Not1Fun/mini-gantry/mechanical/v3/drawings/camera_mount.png

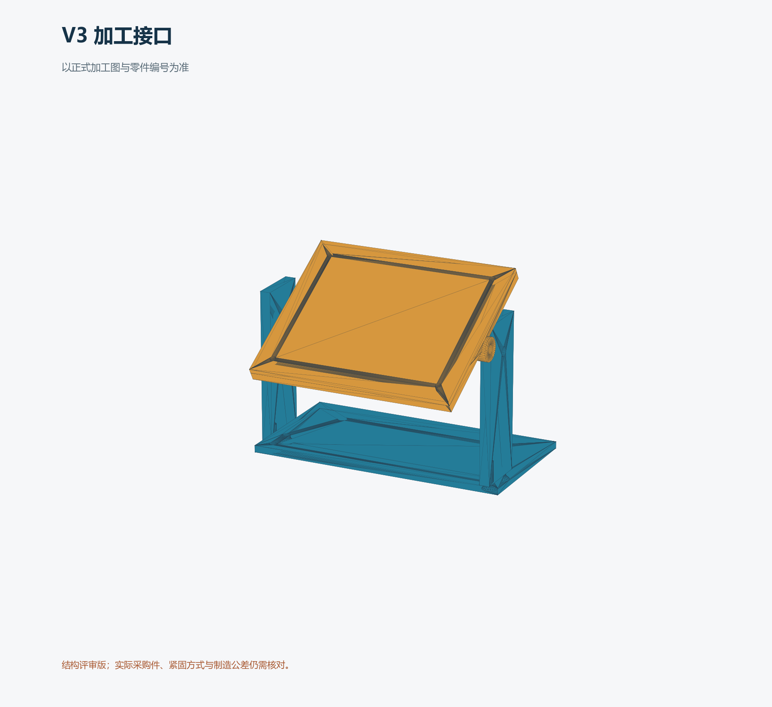
mechanical/v3/drawings/camera_mount.png
