Not1Fun/mini-gantry/mechanical/v3/drawings/xy_reduction.png

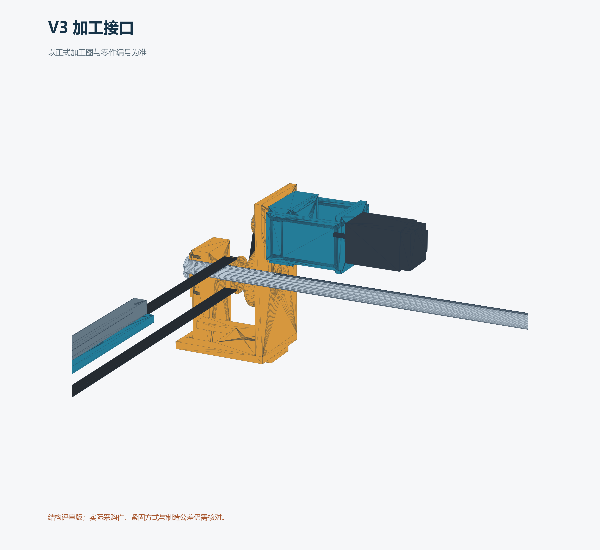
mechanical/v3/drawings/xy_reduction.png
