Not1Fun/mini-gantry/mechanical/v3/drawings/z_drive_stack.png

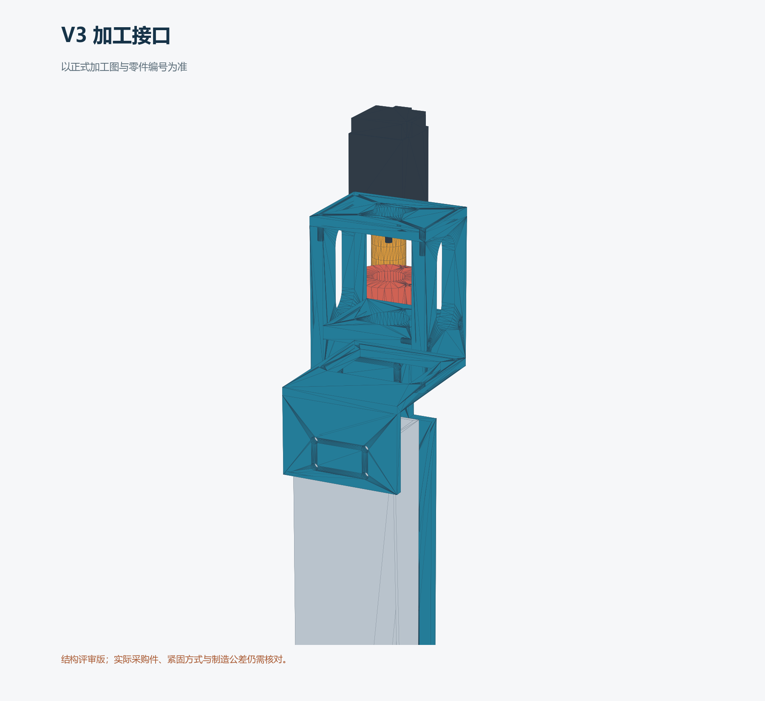
mechanical/v3/drawings/z_drive_stack.png
