Not1Fun/mini-gantry/mechanical/v3/cad/camera_adapter_blank.stl

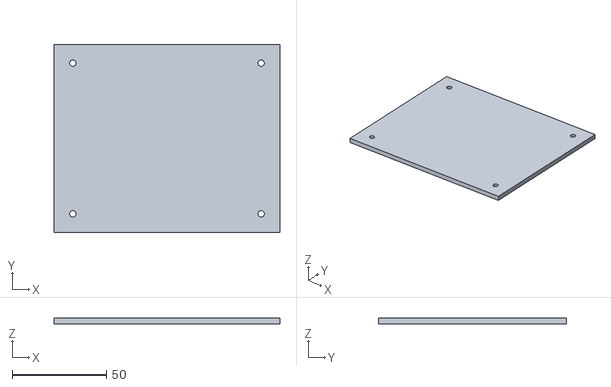
[picture p4: CAD file, 2026-10-16]
mechanical/v3/cad/camera_adapter_blank.stl
120.0 x 100.0 x 3.00
