Not1Fun/mini-gantry/mechanical/v3/cad/dxf/MG3-020.dxf

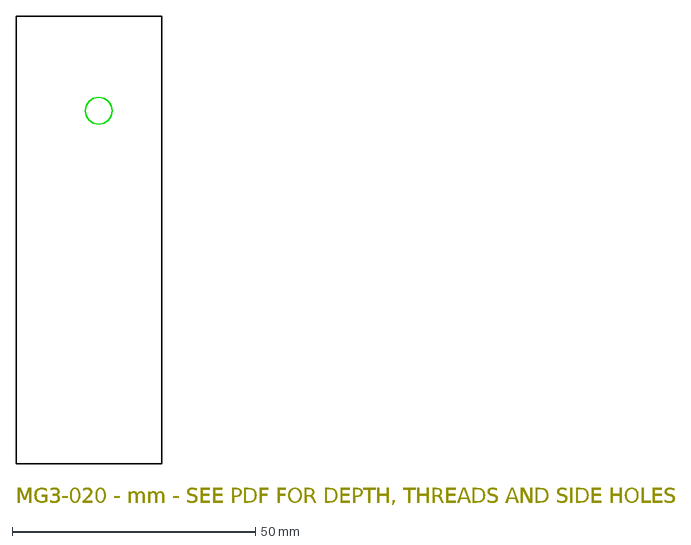
[picture p5: CAD file, 2026-10-16]
mechanical/v3/cad/dxf/MG3-020.dxf
MG3-020 - mm - SEE PDF FOR DEPTH, THREADS AND SIDE HOLES
