Not1Fun/mini-gantry/mechanical/v3/SolidWorksV3/v3_Z_target_0.SLDPRT

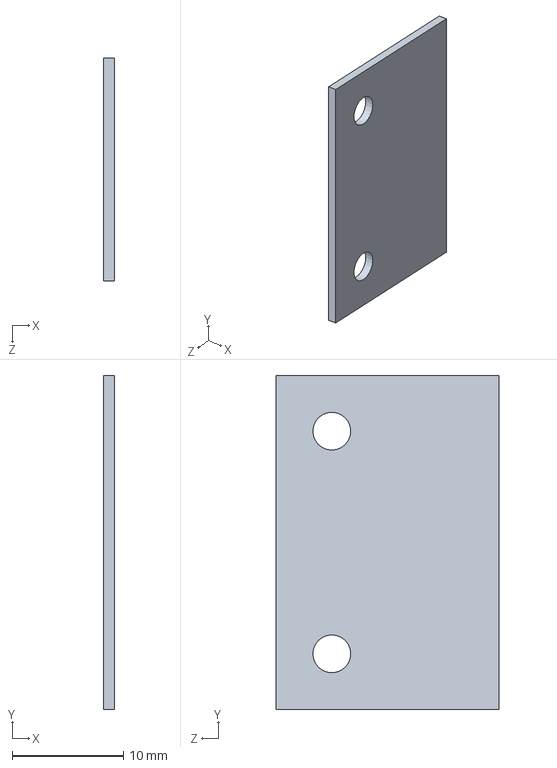
[picture p6: CAD file, 2026-10-16]
mechanical/v3/SolidWorksV3/v3_Z_target_0.SLDPRT
1.00 x 30.0 x 20.0 mm
