Not1Fun/mini-gantry/mechanical/v3/cad/dxf/MG3-053.dxf

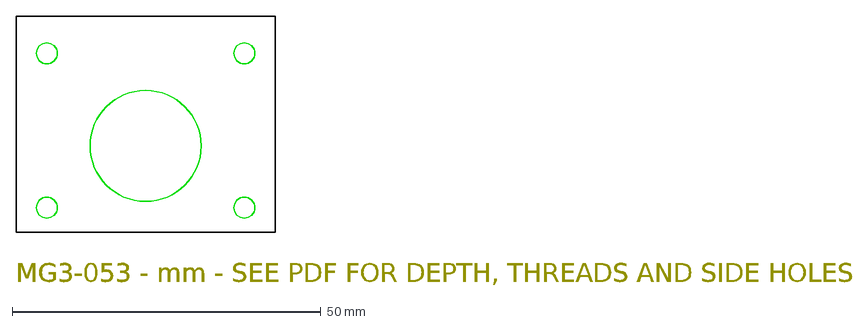
[picture p7: CAD file, 2026-10-16]
mechanical/v3/cad/dxf/MG3-053.dxf
MG3-053 - mm - SEE PDF FOR DEPTH, THREADS AND SIDE HOLES
