Not1Fun/mini-gantry/mechanical/v3/cad/parts/MG3-097_y_tension_0_spacer_1.step

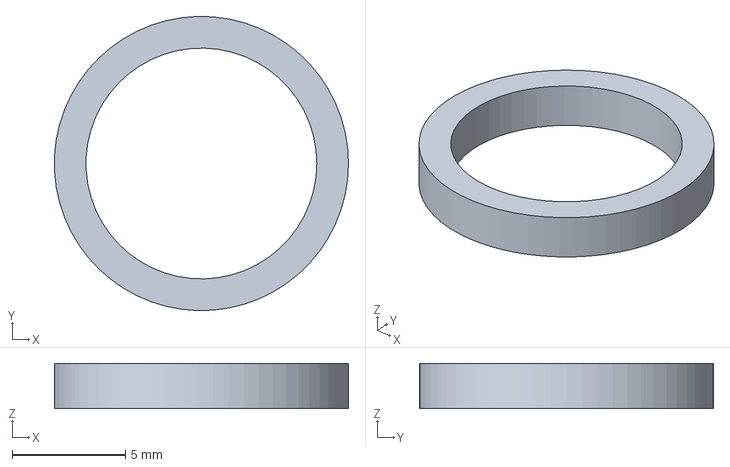
[picture p8: CAD file, 2026-10-16]
mechanical/v3/cad/parts/MG3-097_y_tension_0_spacer_1.step
13.0 x 13.0 x 2.00 mm
