Not1Fun/mini-gantry/mechanical/v3/SolidWorksV3/v3_y_tension_0_fork.SLDPRT

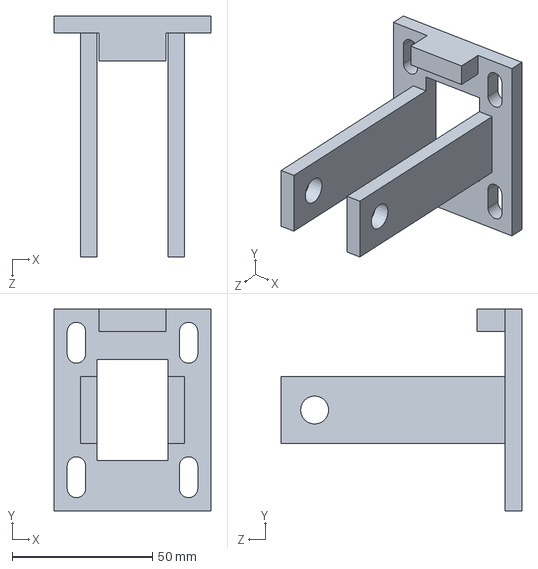
[picture p9: CAD file, 2026-10-16]
mechanical/v3/SolidWorksV3/v3_y_tension_0_fork.SLDPRT
56.0 x 72.0 x 86.0 mm
