Not1Fun/mini-gantry/mechanical/v3/cad/dxf/MG3-064.dxf

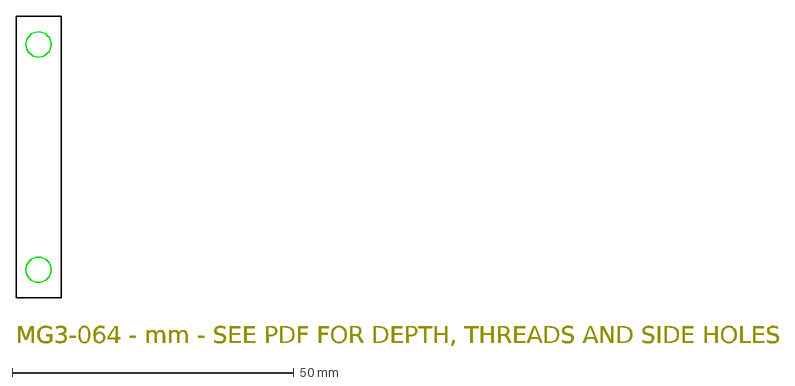
[picture p10: CAD file, 2026-10-16]
mechanical/v3/cad/dxf/MG3-064.dxf
MG3-064 - mm - SEE PDF FOR DEPTH, THREADS AND SIDE HOLES
