Not1Fun/mini-gantry/mechanical/v3/cad/parts/MG3-079_y_rail_base_0.step

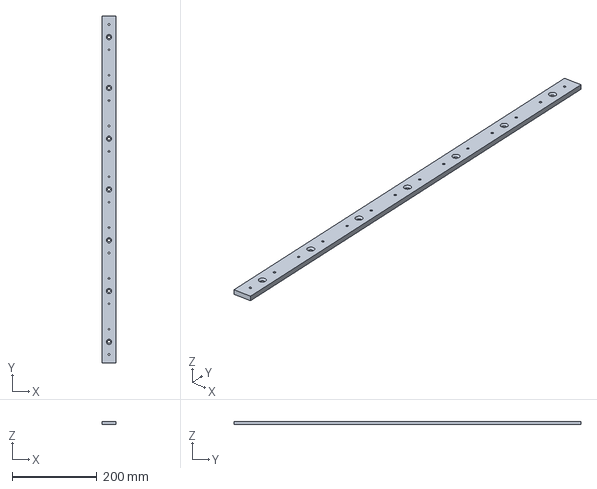
[picture p11: CAD file, 2026-10-16]
mechanical/v3/cad/parts/MG3-079_y_rail_base_0.step
32.0 x 820.0 x 8.00 mm
