Not1Fun/mini-gantry/mechanical/v3/SolidWorksV3/v3_y_pulley_1_1.SLDPRT

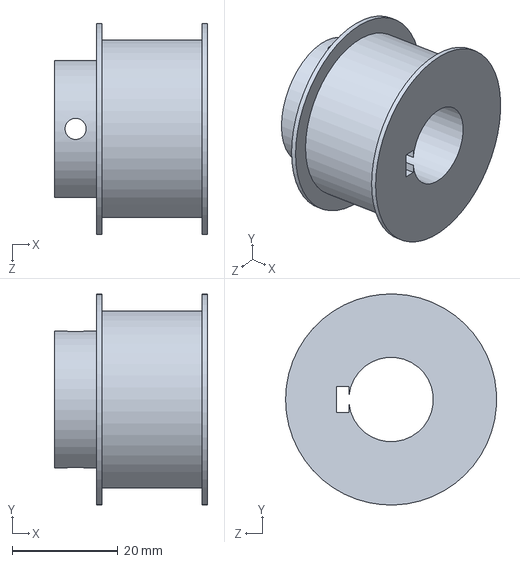
[picture p12: CAD file, 2026-10-16]
mechanical/v3/SolidWorksV3/v3_y_pulley_1_1.SLDPRT
29.0 x 40.0 x 40.0 mm
