Not1Fun/mini-gantry/mechanical/v3/cad/parts/MG3-058_x_output_spacer_2.step

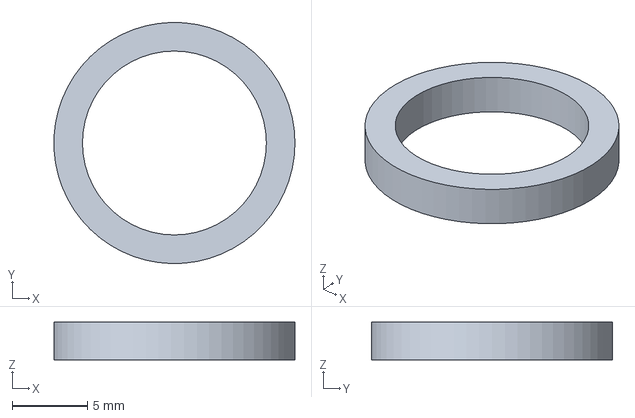
[picture p13: CAD file, 2026-10-16]
mechanical/v3/cad/parts/MG3-058_x_output_spacer_2.step
16.0 x 16.0 x 2.50 mm
