Not1Fun/mini-gantry/mechanical/v3/SolidWorksV3/v3_bridge_riser_1.SLDPRT

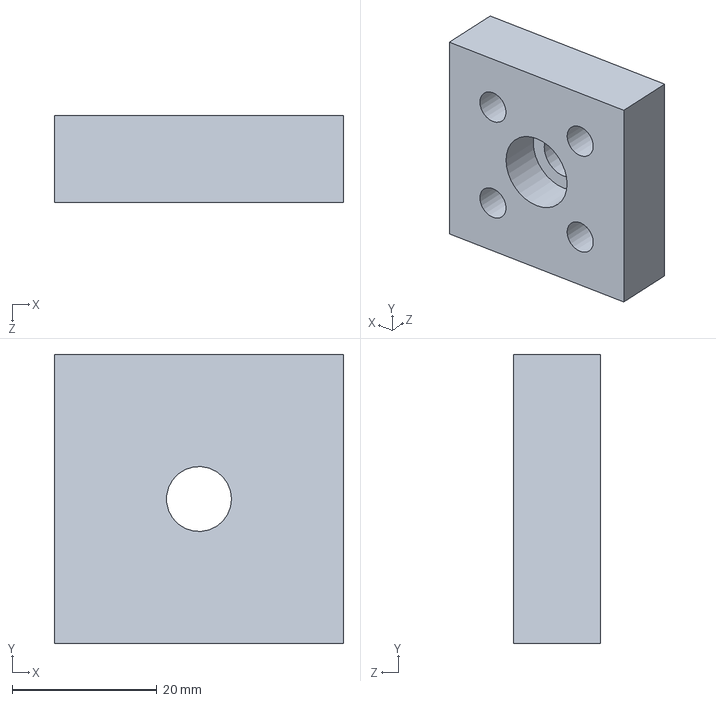
[picture p14: CAD file, 2026-10-16]
mechanical/v3/SolidWorksV3/v3_bridge_riser_1.SLDPRT
40.0 x 40.0 x 12.0 mm
