Not1Fun/mini-gantry/mechanical/v3/cad/parts/MG3-067_x_tension_0_fork.step

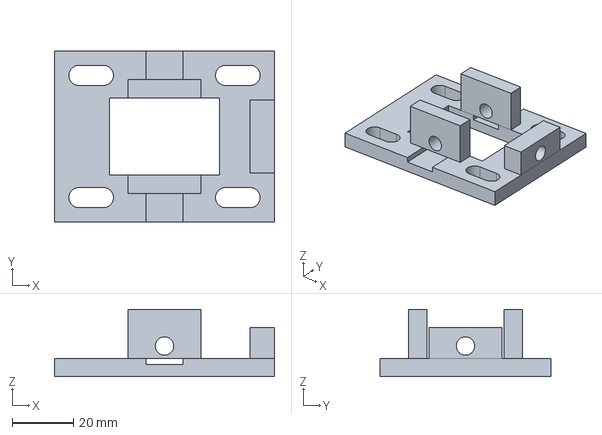
[picture p15: CAD file, 2026-10-16]
mechanical/v3/cad/parts/MG3-067_x_tension_0_fork.step
72.0 x 56.0 x 22.0 mm
