Not1Fun/mini-gantry/mechanical/v3/cad/dxf/MG3-094.dxf

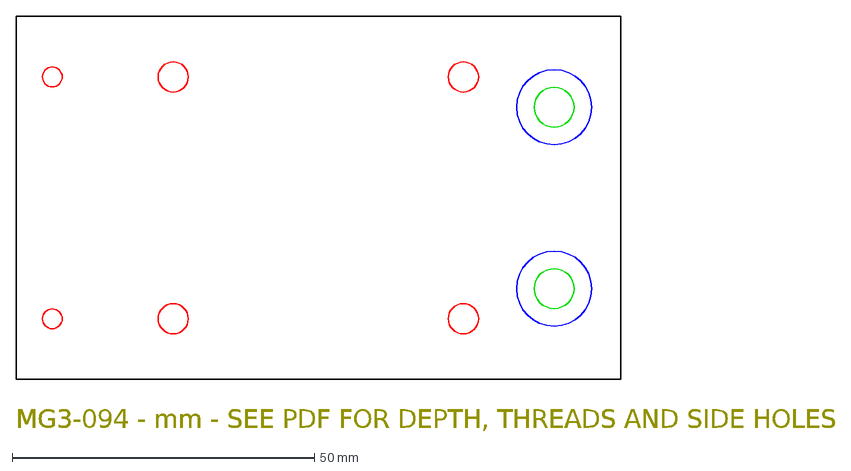
[picture p16: CAD file, 2026-10-16]
mechanical/v3/cad/dxf/MG3-094.dxf
MG3-094 - mm - SEE PDF FOR DEPTH, THREADS AND SIDE HOLES
