Not1Fun/mini-gantry/mechanical/v3/cad/parts/MG3-071_y_clamp_0_-1_cap.step

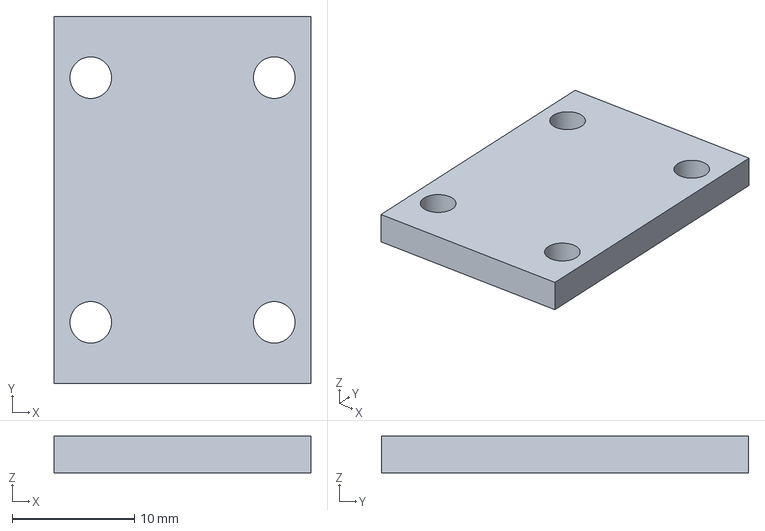
[picture p17: CAD file, 2026-10-16]
mechanical/v3/cad/parts/MG3-071_y_clamp_0_-1_cap.step
21.0 x 30.0 x 3.00 mm
