Not1Fun/mini-gantry/mechanical/v3/SolidWorksV3/v3_z_motor_standoff_0.SLDPRT

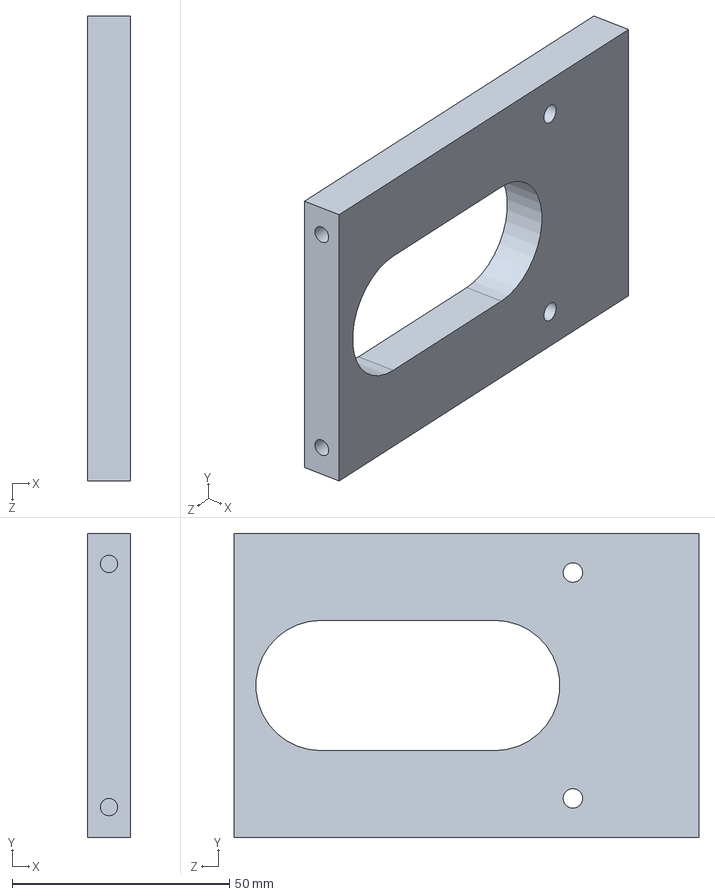
[picture p18: CAD file, 2026-10-16]
mechanical/v3/SolidWorksV3/v3_z_motor_standoff_0.SLDPRT
10.0 x 70.0 x 107.0 mm
