Not1Fun/mini-gantry/mechanical/v3/cad/parts/MG3-084_y_rear_spacer_1_0.step

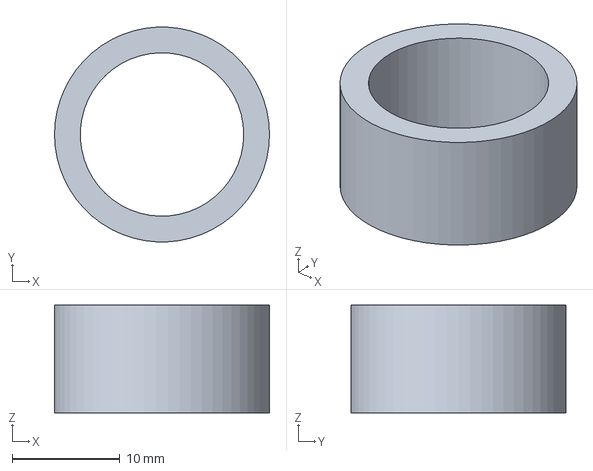
[picture p19: CAD file, 2026-10-16]
mechanical/v3/cad/parts/MG3-084_y_rear_spacer_1_0.step
20.0 x 20.0 x 10.0 mm
