Not1Fun/mini-gantry/mechanical/v3/SolidWorksV3/v3_camera_pivot_spacer_0.SLDPRT

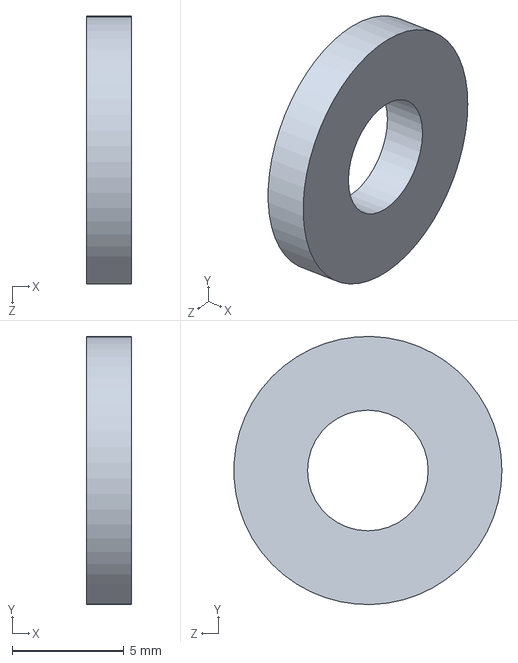
[picture p20: CAD file, 2026-10-16]
mechanical/v3/SolidWorksV3/v3_camera_pivot_spacer_0.SLDPRT
2.00 x 12.0 x 12.0 mm
