Not1Fun/mini-gantry/mechanical/v3/cad/dxf/MG3-106.dxf

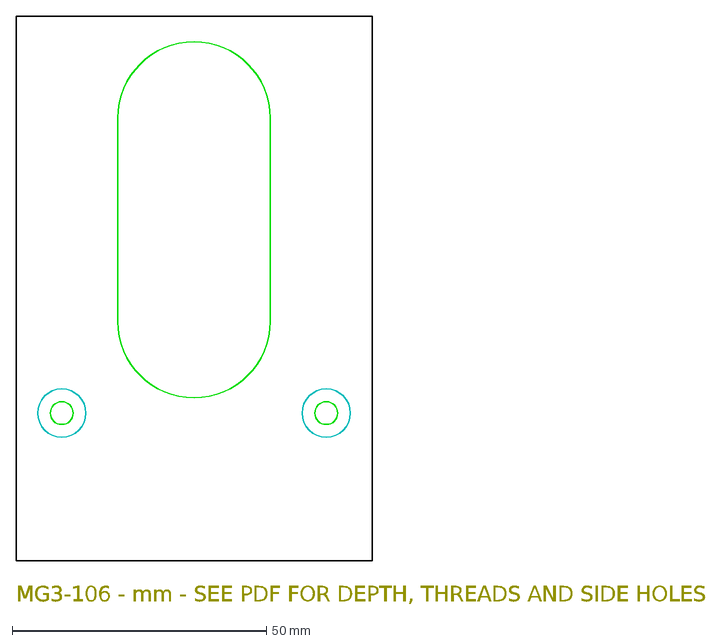
[picture p21: CAD file, 2026-10-16]
mechanical/v3/cad/dxf/MG3-106.dxf
MG3-106 - mm - SEE PDF FOR DEPTH, THREADS AND SIDE HOLES
