Not1Fun/mini-gantry/mechanical/v3/cad/parts/MG3-029_gripper_adapter.step

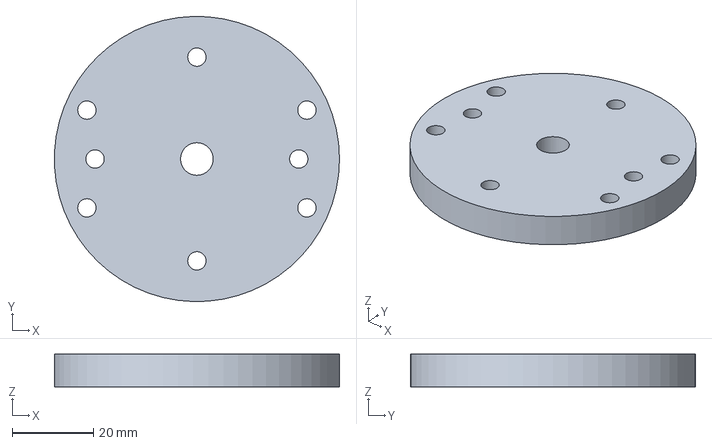
[picture p22: CAD file, 2026-10-16]
mechanical/v3/cad/parts/MG3-029_gripper_adapter.step
70.0 x 70.0 x 8.00 mm
