Not1Fun/mini-gantry/mechanical/v3/SolidWorksV3/v3_y_rear_spacer_0_1.SLDPRT

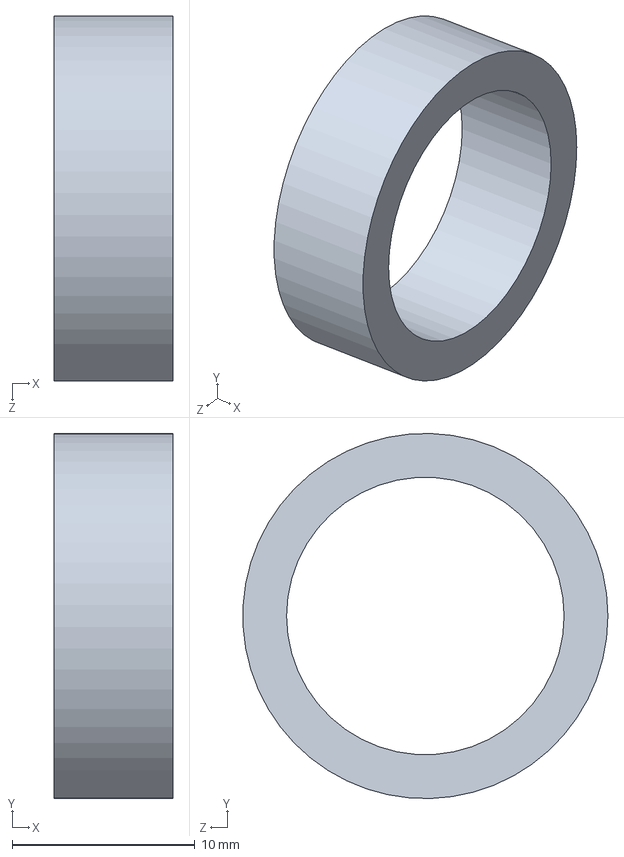
[picture p23: CAD file, 2026-10-16]
mechanical/v3/SolidWorksV3/v3_y_rear_spacer_0_1.SLDPRT
6.50 x 20.0 x 20.0 mm
