Not1Fun/mini-gantry/mechanical/v3/cad/dxf/MG3-016.dxf

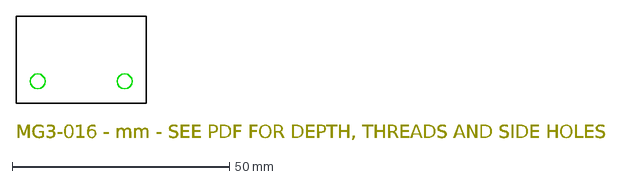
[picture p24: CAD file, 2026-10-16]
mechanical/v3/cad/dxf/MG3-016.dxf
MG3-016 - mm - SEE PDF FOR DEPTH, THREADS AND SIDE HOLES
