Not1Fun/mini-gantry/mechanical/v3/cad/parts/MG3-062_x_reduction_driven_pulley.step

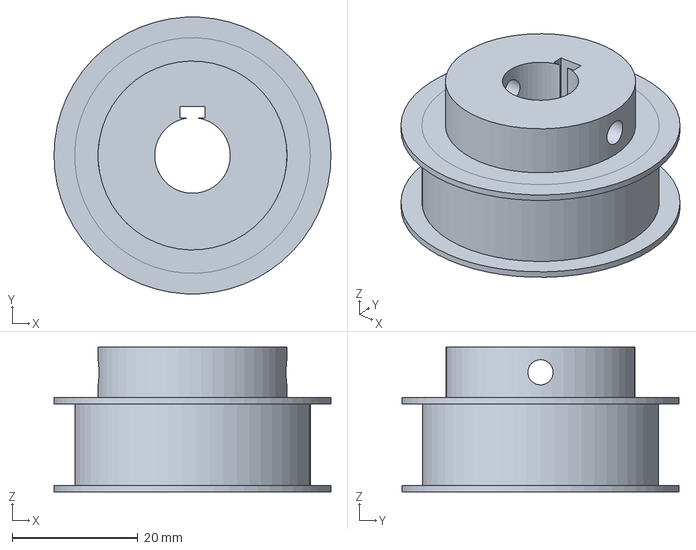
[picture p25: CAD file, 2026-10-16]
mechanical/v3/cad/parts/MG3-062_x_reduction_driven_pulley.step
44.0 x 43.9 x 23.0 mm
