Not1Fun/mini-gantry/mechanical/v3/SolidWorksV3/v3_rear_brace_0.SLDPRT

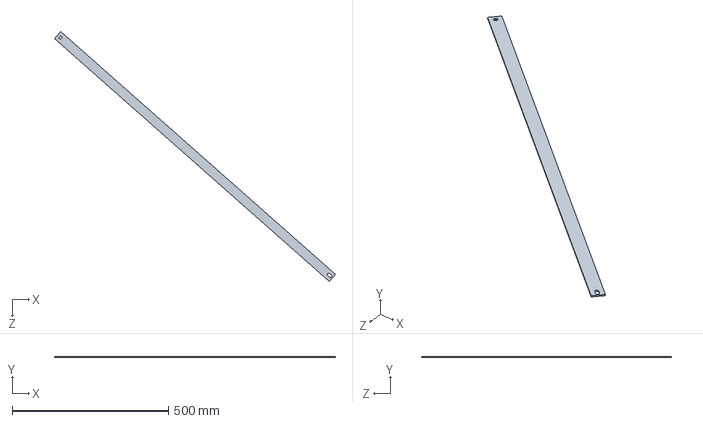
[picture p26: CAD file, 2026-10-16]
mechanical/v3/SolidWorksV3/v3_rear_brace_0.SLDPRT
897.8 x 3.00 x 798.4 mm
