Not1Fun/mini-gantry/mechanical/v3/cad/dxf/MG3-070.dxf

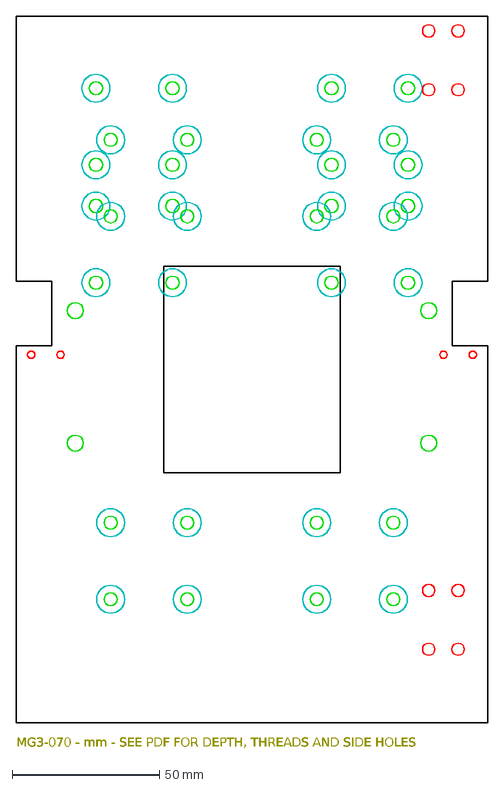
[picture p27: CAD file, 2026-10-16]
mechanical/v3/cad/dxf/MG3-070.dxf
MG3-070 - mm - SEE PDF FOR DEPTH, THREADS AND SIDE HOLES
