Not1Fun/mini-gantry/mechanical/v3/cad/parts/MG3-051_x_motor_bracket.step

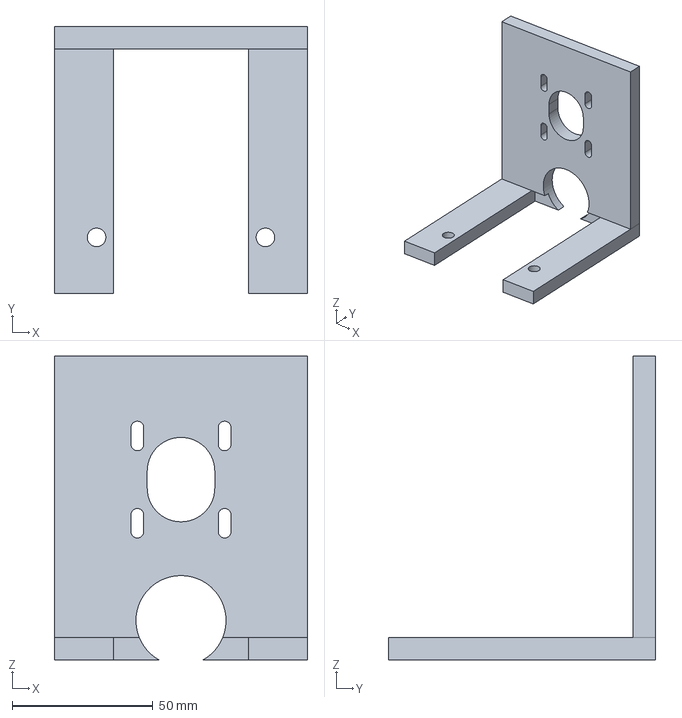
[picture p28: CAD file, 2026-10-16]
mechanical/v3/cad/parts/MG3-051_x_motor_bracket.step
90.0 x 95.0 x 108.0 mm
