Not1Fun/mini-gantry/mechanical/v3/SolidWorksV3/v3_Y_target_1.SLDPRT

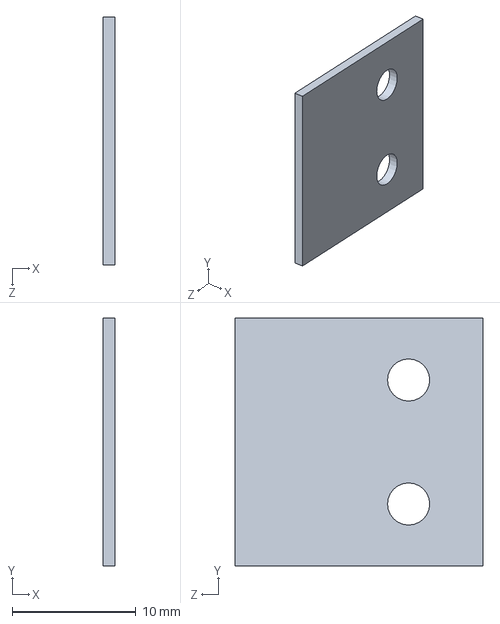
[picture p29: CAD file, 2026-10-16]
mechanical/v3/SolidWorksV3/v3_Y_target_1.SLDPRT
1.00 x 20.0 x 20.0 mm
