Not1Fun/mini-gantry/mechanical/v3/cad/dxf/MG3-098.dxf

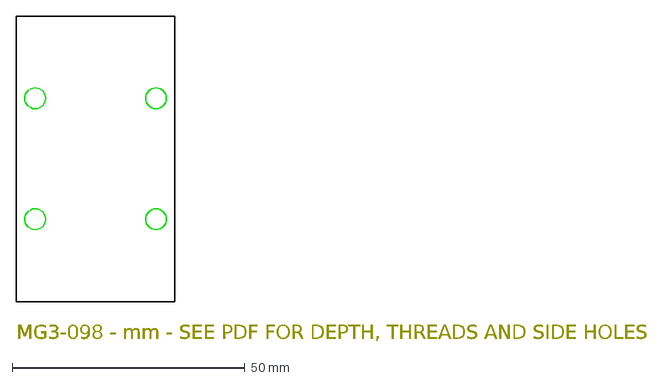
[picture p30: CAD file, 2026-10-16]
mechanical/v3/cad/dxf/MG3-098.dxf
MG3-098 - mm - SEE PDF FOR DEPTH, THREADS AND SIDE HOLES
