Not1Fun/mini-gantry/mechanical/v3/SolidWorksV3/v3_y_end_plate_1.SLDPRT

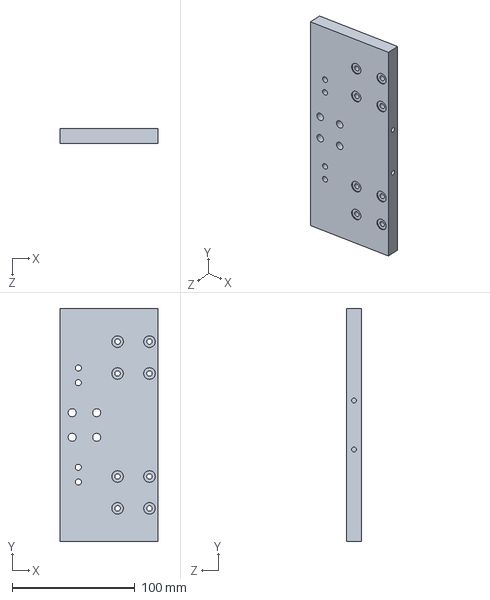
[picture p31: CAD file, 2026-10-16]
mechanical/v3/SolidWorksV3/v3_y_end_plate_1.SLDPRT
80.0 x 190.0 x 12.0 mm
