Not1Fun/mini-gantry/mechanical/v3/cad/dxf/MG3-050.dxf

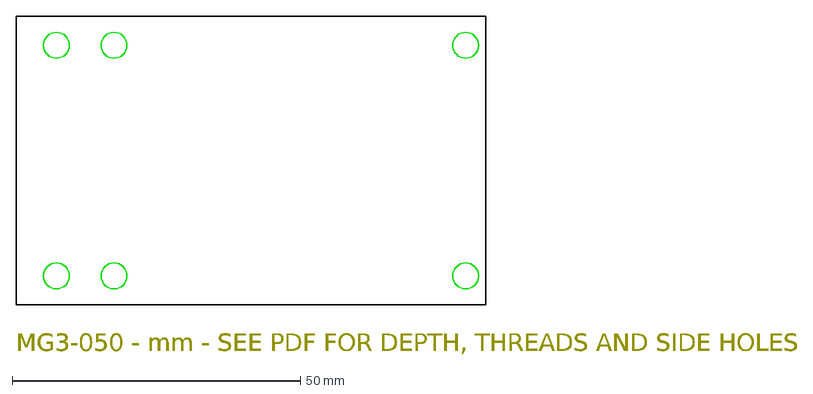
[picture p32: CAD file, 2026-10-16]
mechanical/v3/cad/dxf/MG3-050.dxf
MG3-050 - mm - SEE PDF FOR DEPTH, THREADS AND SIDE HOLES
