Not1Fun/mini-gantry/mechanical/v3/cad/parts/MG3-065_x_tension_0_axle.step

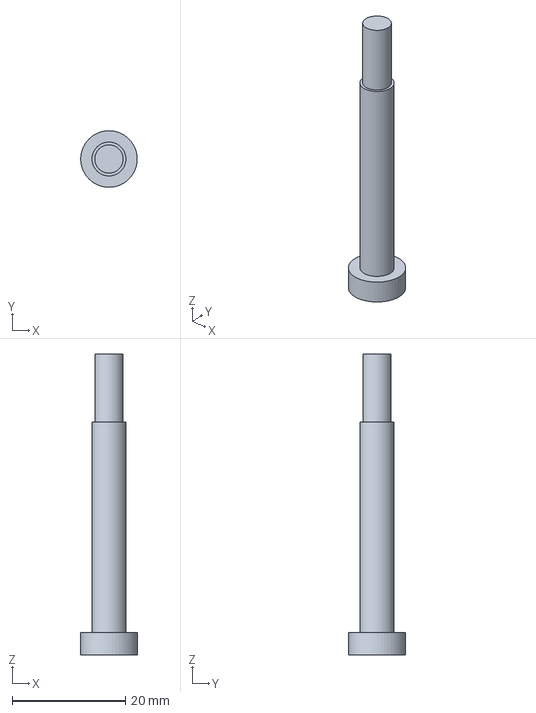
[picture p33: CAD file, 2026-10-16]
mechanical/v3/cad/parts/MG3-065_x_tension_0_axle.step
9.99 x 10.00 x 53.2 mm
