Not1Fun/mini-gantry/mechanical/v3/cad/dxf/MG3-004.dxf

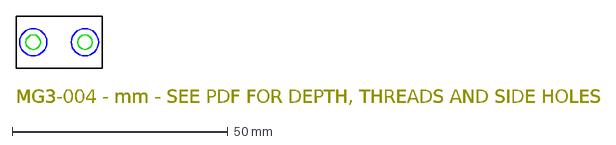
[picture p34: CAD file, 2026-10-16]
mechanical/v3/cad/dxf/MG3-004.dxf
MG3-004 - mm - SEE PDF FOR DEPTH, THREADS AND SIDE HOLES
