Not1Fun/mini-gantry/mechanical/v3/cad/parts/MG3-048_x_input_rear_cover.step

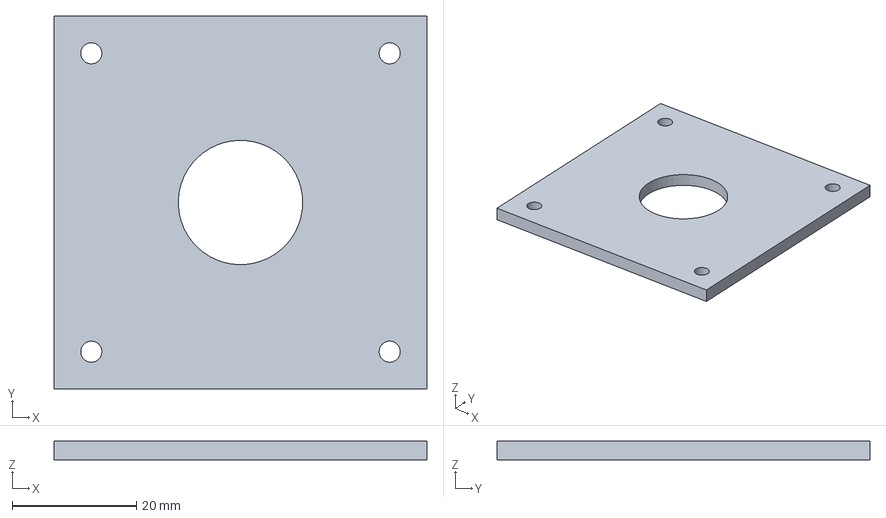
[picture p35: CAD file, 2026-10-16]
mechanical/v3/cad/parts/MG3-048_x_input_rear_cover.step
60.0 x 60.0 x 3.00 mm
