Not1Fun/mini-gantry/mechanical/v3/SolidWorksV3/v3_side_brace_0_1_spacer_1.SLDPRT

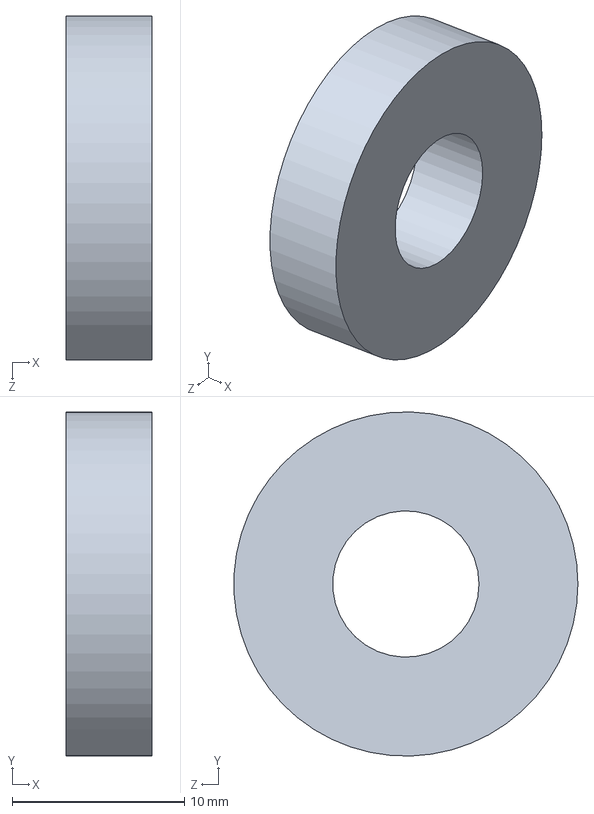
[picture p36: CAD file, 2026-10-16]
mechanical/v3/SolidWorksV3/v3_side_brace_0_1_spacer_1.SLDPRT
5.00 x 20.0 x 20.0 mm
