Not1Fun/mini-gantry/mechanical/v3/cad/dxf/MG3-061.dxf

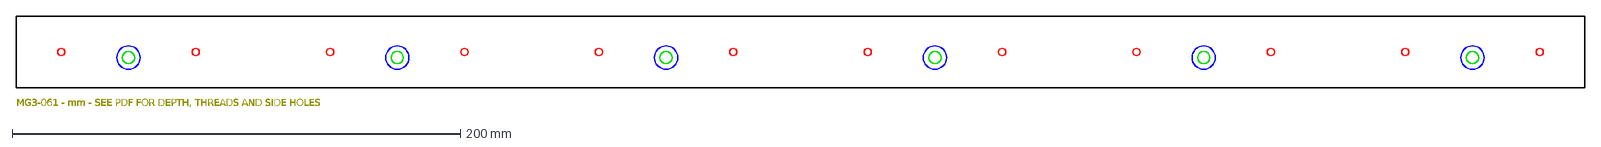
[picture p37: CAD file, 2026-10-16]
mechanical/v3/cad/dxf/MG3-061.dxf
MG3-061 - mm - SEE PDF FOR DEPTH, THREADS AND SIDE HOLES
