Not1Fun/mini-gantry/mechanical/v3/cad/parts/MG3-050_x_input_side_0.step

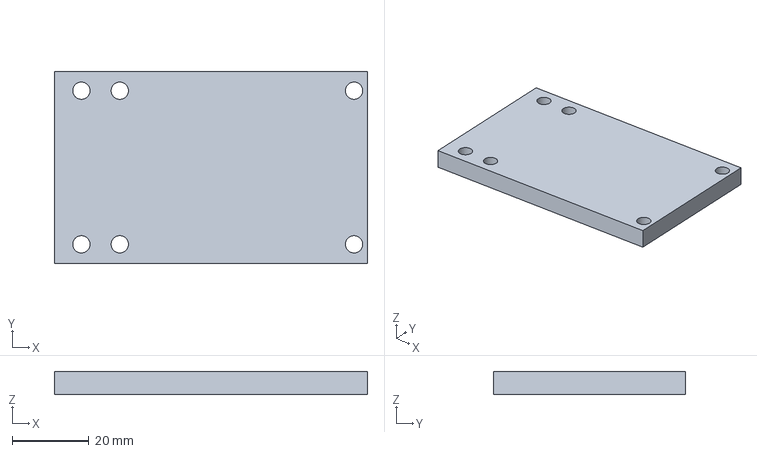
[picture p38: CAD file, 2026-10-16]
mechanical/v3/cad/parts/MG3-050_x_input_side_0.step
81.5 x 50.0 x 6.00 mm
