Not1Fun/mini-gantry/mechanical/v3/SolidWorksV3/v3_side_brace_0_0_spacer_0.SLDPRT

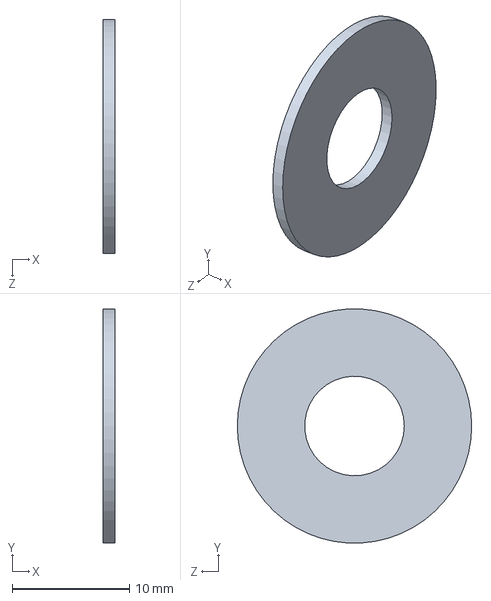
[picture p39: CAD file, 2026-10-16]
mechanical/v3/SolidWorksV3/v3_side_brace_0_0_spacer_0.SLDPRT
1.00 x 20.0 x 20.0 mm
