Not1Fun/mini-gantry/mechanical/v3/cad/dxf/MG3-044.dxf

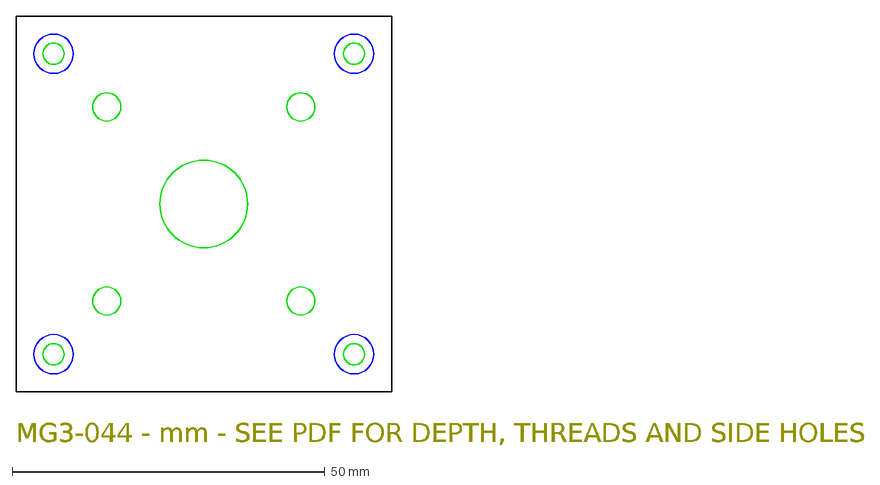
[picture p40: CAD file, 2026-10-16]
mechanical/v3/cad/dxf/MG3-044.dxf
MG3-044 - mm - SEE PDF FOR DEPTH, THREADS AND SIDE HOLES
