Not1Fun/mini-gantry/mechanical/v3/cad/parts/MG3-027_fixed_head_top.step

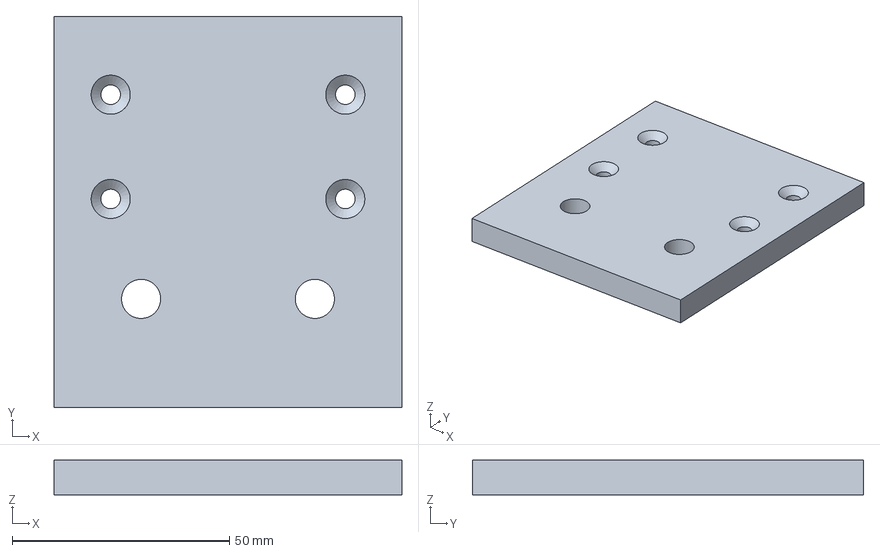
[picture p41: CAD file, 2026-10-16]
mechanical/v3/cad/parts/MG3-027_fixed_head_top.step
80.0 x 90.0 x 8.00 mm
