Not1Fun/mini-gantry/mechanical/v3/SolidWorksV3/v3_controller_tray.SLDPRT

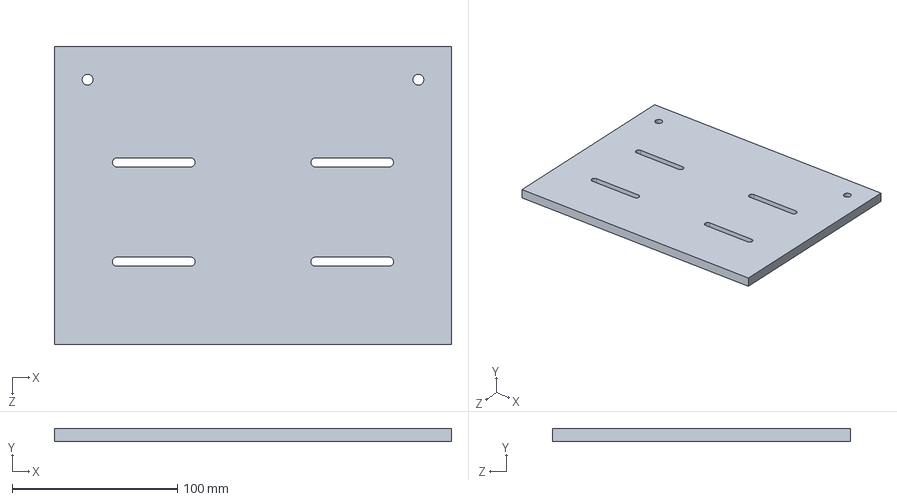
[picture p42: CAD file, 2026-10-16]
mechanical/v3/SolidWorksV3/v3_controller_tray.SLDPRT
240.0 x 8.00 x 180.0 mm
