Not1Fun/mini-gantry/mechanical/v3/cad/dxf/MG3-074.dxf

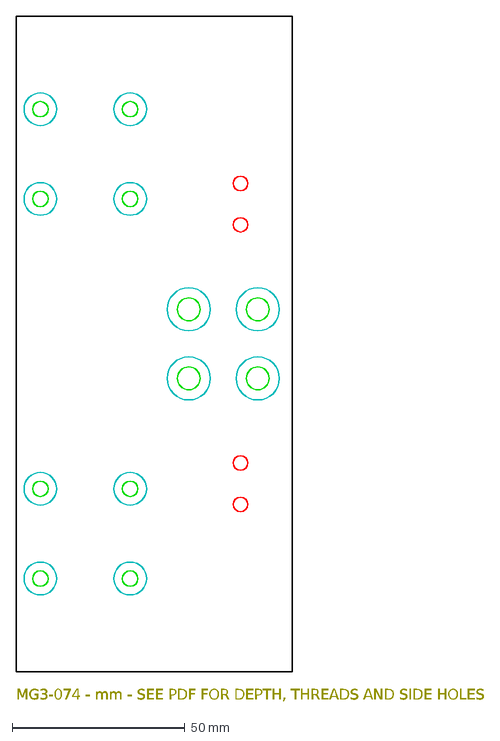
[picture p43: CAD file, 2026-10-16]
mechanical/v3/cad/dxf/MG3-074.dxf
MG3-074 - mm - SEE PDF FOR DEPTH, THREADS AND SIDE HOLES
