Not1Fun/mini-gantry/mechanical/v3/cad/parts/MG3-098_z_block_spacer_0_0.step

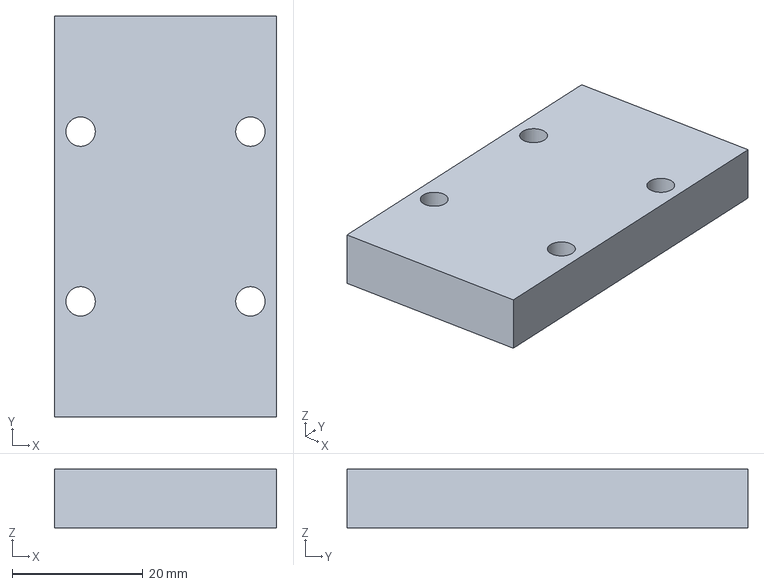
[picture p44: CAD file, 2026-10-16]
mechanical/v3/cad/parts/MG3-098_z_block_spacer_0_0.step
34.0 x 61.4 x 9.00 mm
