Not1Fun/mini-gantry/mechanical/v3/SolidWorksV3/v3_frame_corner_front_0_0.SLDPRT

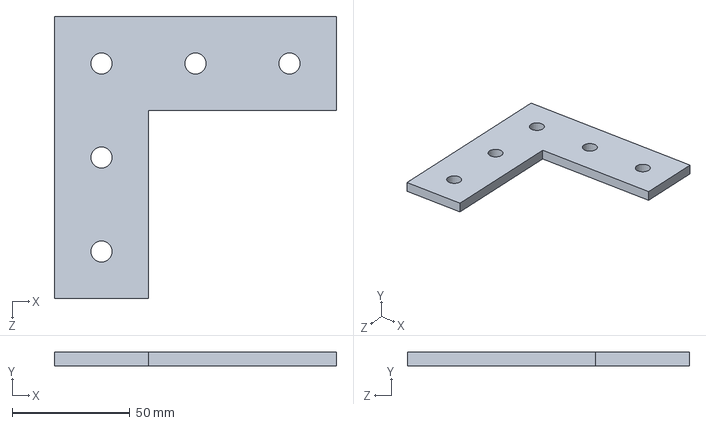
[picture p45: CAD file, 2026-10-16]
mechanical/v3/SolidWorksV3/v3_frame_corner_front_0_0.SLDPRT
120.0 x 6.00 x 120.0 mm
