Not1Fun/mini-gantry/mechanical/v3/cad/dxf/MG3-018.dxf

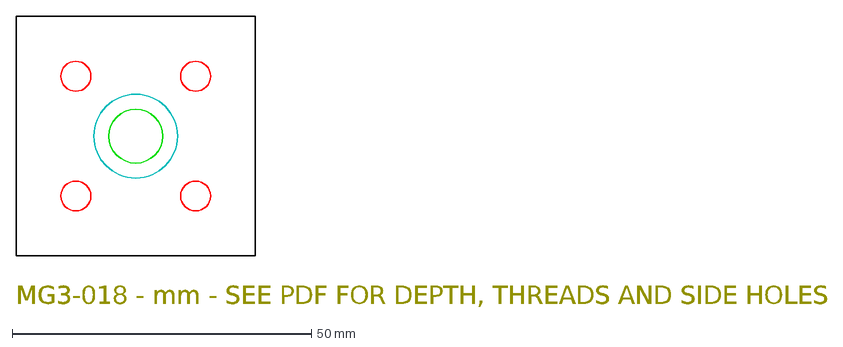
[picture p46: CAD file, 2026-10-16]
mechanical/v3/cad/dxf/MG3-018.dxf
MG3-018 - mm - SEE PDF FOR DEPTH, THREADS AND SIDE HOLES
