Not1Fun/mini-gantry/mechanical/v3/cad/parts/MG3-099_z_brake_carrier.step

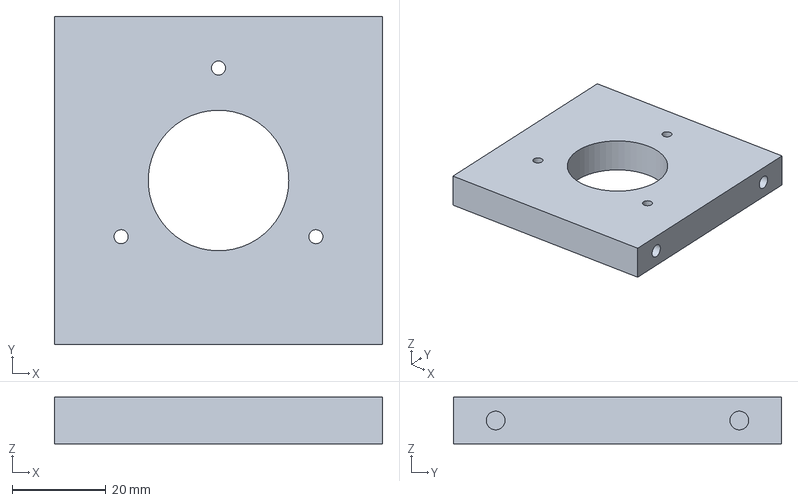
[picture p47: CAD file, 2026-10-16]
mechanical/v3/cad/parts/MG3-099_z_brake_carrier.step
70.0 x 70.0 x 10.0 mm
