Not1Fun/mini-gantry/mechanical/v3/SolidWorksV3/v3_X_bumper_0.SLDPRT

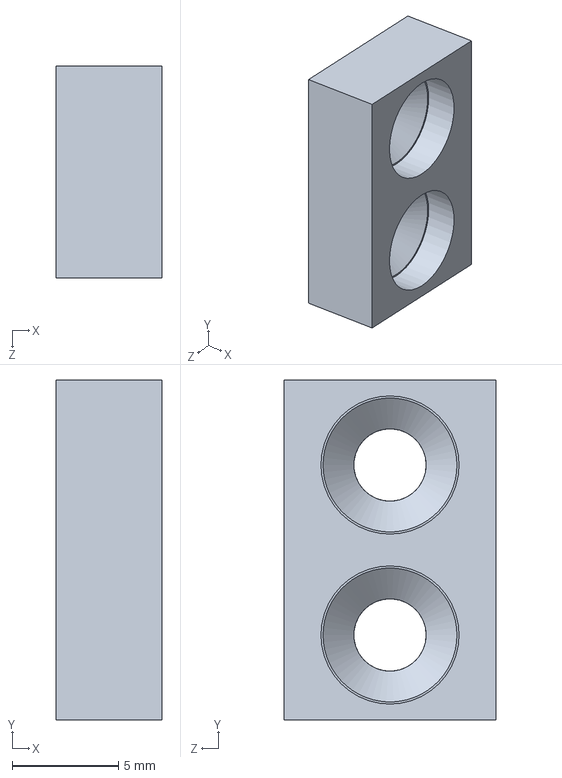
[picture p48: CAD file, 2026-10-16]
mechanical/v3/SolidWorksV3/v3_X_bumper_0.SLDPRT
5.00 x 16.0 x 10.0 mm
