Not1Fun/mini-gantry/mechanical/v3/cad/dxf/MG3-019.dxf

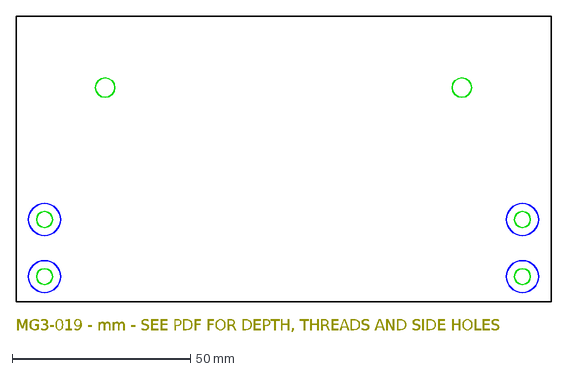
[picture p49: CAD file, 2026-10-16]
mechanical/v3/cad/dxf/MG3-019.dxf
MG3-019 - mm - SEE PDF FOR DEPTH, THREADS AND SIDE HOLES
