Not1Fun/mini-gantry/mechanical/v3/cad/parts/MG3-068_x_tension_0_spacer_0.step

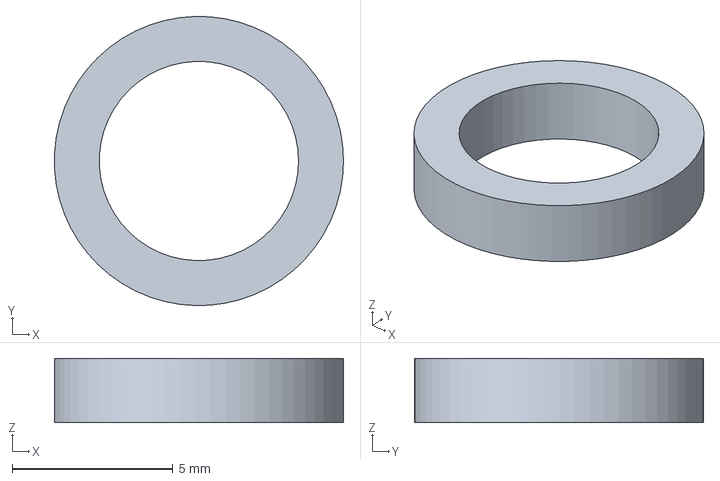
[picture p50: CAD file, 2026-10-16]
mechanical/v3/cad/parts/MG3-068_x_tension_0_spacer_0.step
8.99 x 9.00 x 2.00 mm
