Not1Fun/mini-gantry/mechanical/v3/cad/dxf/MG3-073.dxf

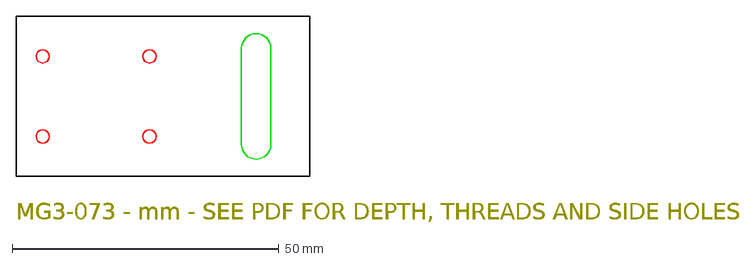
[picture p51: CAD file, 2026-10-16]
mechanical/v3/cad/dxf/MG3-073.dxf
MG3-073 - mm - SEE PDF FOR DEPTH, THREADS AND SIDE HOLES
