Not1Fun/mini-gantry/mechanical/v3/cad/parts/MG3-012_Z_stop_0.step

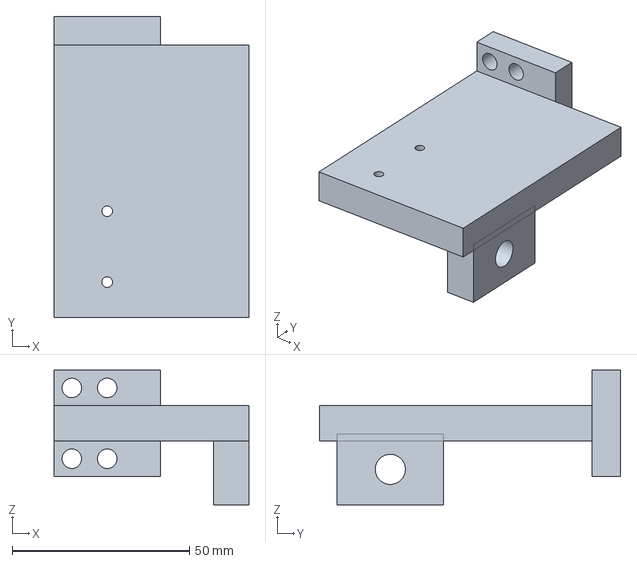
[picture p52: CAD file, 2026-10-16]
mechanical/v3/cad/parts/MG3-012_Z_stop_0.step
55.0 x 85.0 x 38.0 mm
