Not1Fun/mini-gantry/mechanical/v3/SolidWorksV3/v3_y_tension_0_axle.SLDPRT

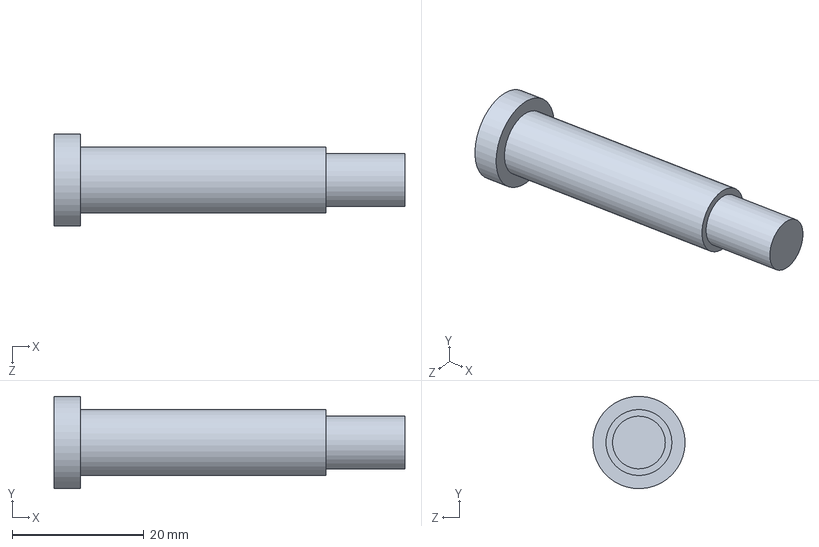
[picture p53: CAD file, 2026-10-16]
mechanical/v3/SolidWorksV3/v3_y_tension_0_axle.SLDPRT
53.2 x 14.0 x 14.0 mm
