Not1Fun/mini-gantry/mechanical/v3/cad/dxf/MG3-100.dxf

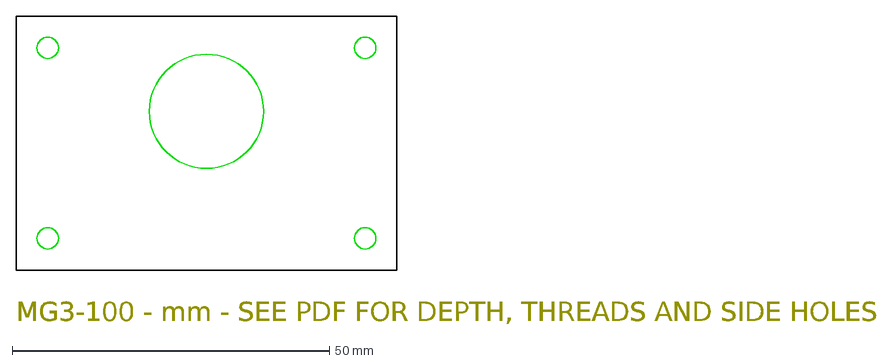
[picture p54: CAD file, 2026-10-16]
mechanical/v3/cad/dxf/MG3-100.dxf
MG3-100 - mm - SEE PDF FOR DEPTH, THREADS AND SIDE HOLES
