Not1Fun/mini-gantry/mechanical/v3/SolidWorksV3/v3_x_input_end_retainer.SLDPRT

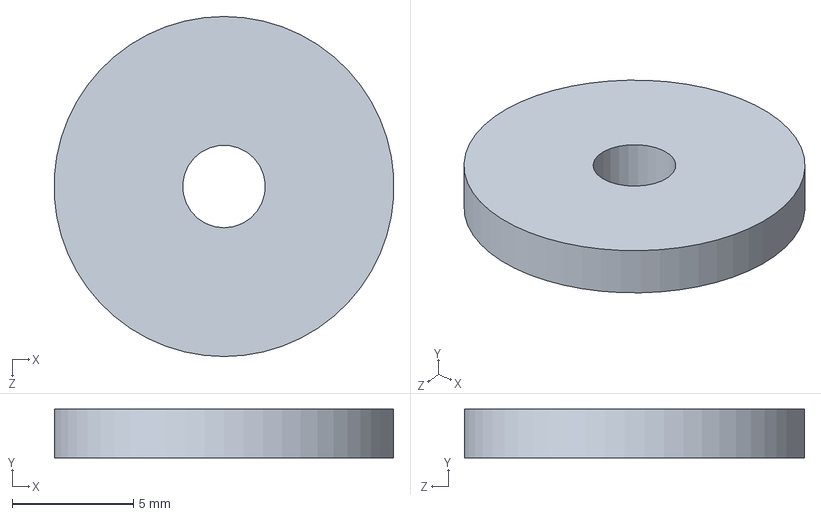
[picture p55: CAD file, 2026-10-16]
mechanical/v3/SolidWorksV3/v3_x_input_end_retainer.SLDPRT
14.0 x 2.00 x 14.0 mm
