Not1Fun/mini-gantry/mechanical/v3/cad/dxf/MG3-026.dxf

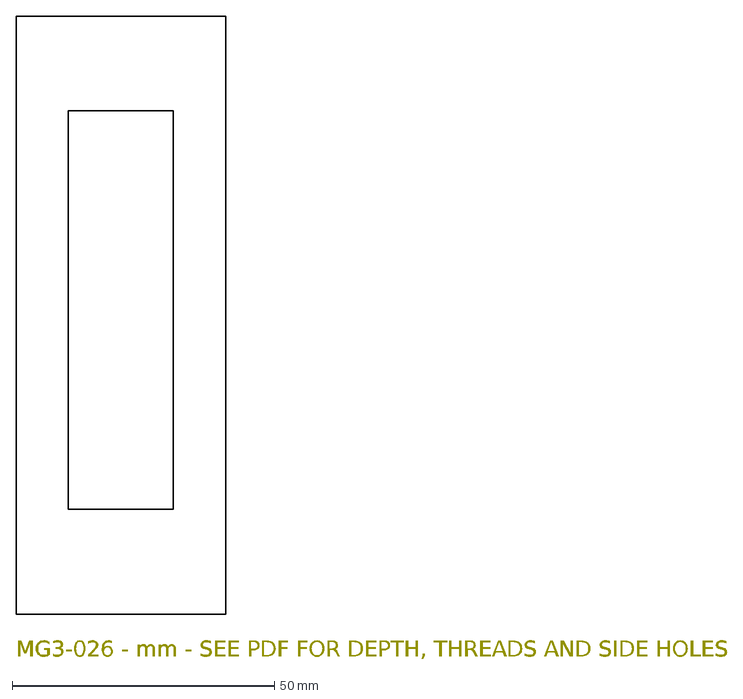
[picture p56: CAD file, 2026-10-16]
mechanical/v3/cad/dxf/MG3-026.dxf
MG3-026 - mm - SEE PDF FOR DEPTH, THREADS AND SIDE HOLES
