Not1Fun/mini-gantry/mechanical/v3/cad/parts/MG3-046_x_input_inner_spacer.step

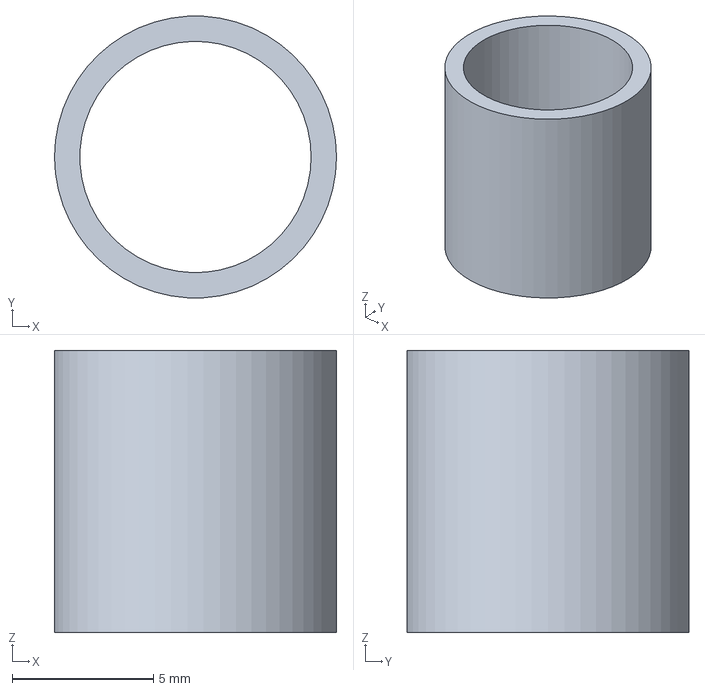
[picture p57: CAD file, 2026-10-16]
mechanical/v3/cad/parts/MG3-046_x_input_inner_spacer.step
10.0 x 9.98 x 10.0 mm
