Not1Fun/mini-gantry/mechanical/v3/cad/dxf/MG3-024.dxf

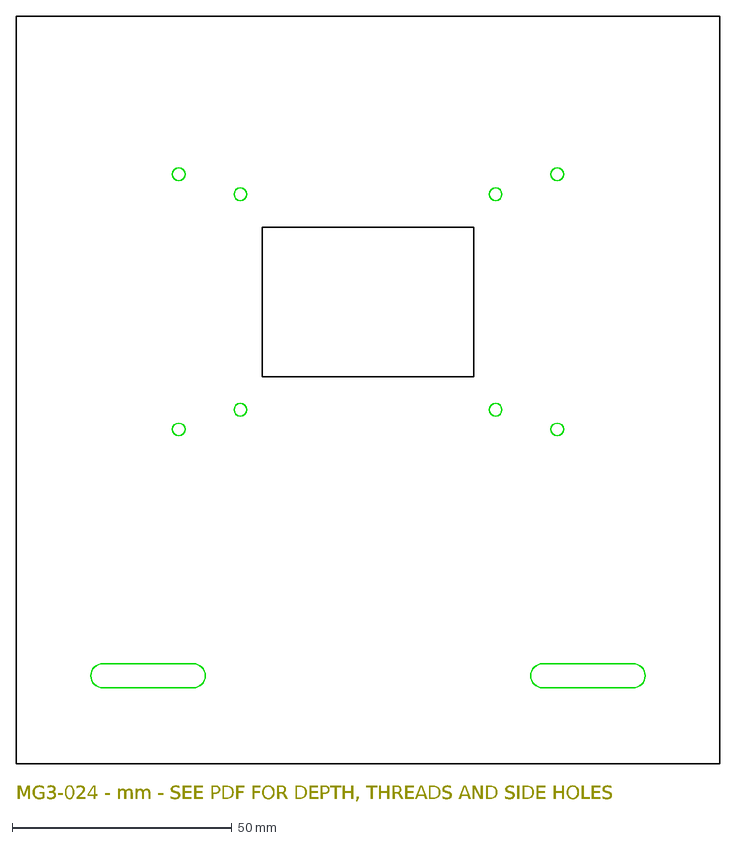
[picture p58: CAD file, 2026-10-16]
mechanical/v3/cad/dxf/MG3-024.dxf
MG3-024 - mm - SEE PDF FOR DEPTH, THREADS AND SIDE HOLES
