Not1Fun/mini-gantry/mechanical/v3/cad/dxf/MG3-009.dxf

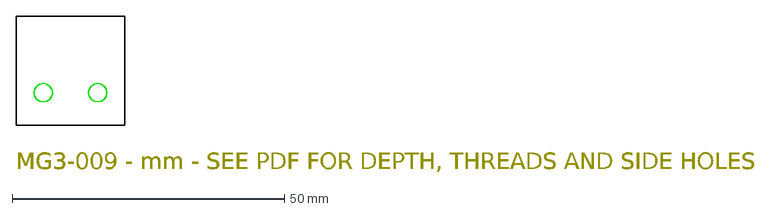
[picture p59: CAD file, 2026-10-16]
mechanical/v3/cad/dxf/MG3-009.dxf
MG3-009 - mm - SEE PDF FOR DEPTH, THREADS AND SIDE HOLES
