Not1Fun/mini-gantry/mechanical/v3/SolidWorksV3/v3_Y_bumper_0_0.SLDPRT

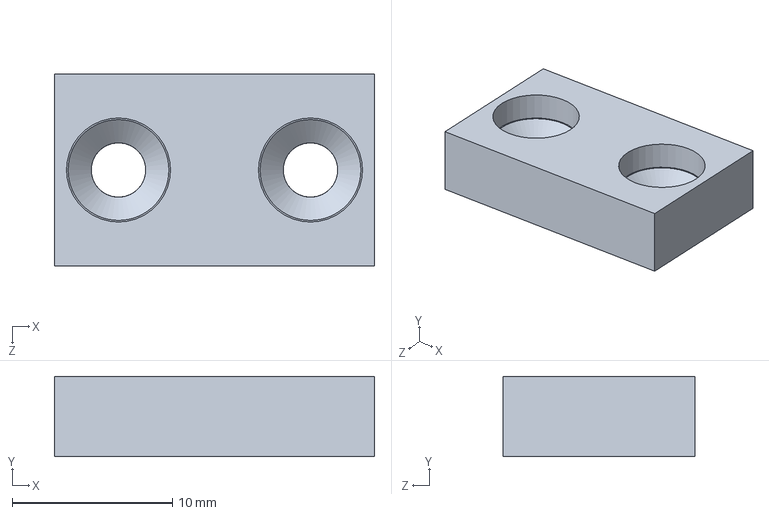
[picture p60: CAD file, 2026-10-16]
mechanical/v3/SolidWorksV3/v3_Y_bumper_0_0.SLDPRT
20.0 x 5.00 x 12.0 mm
