Not1Fun/mini-gantry/mechanical/v3/cad/dxf/MG3-005.dxf

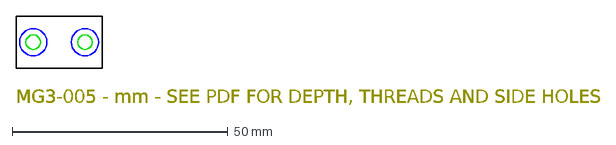
[picture p61: CAD file, 2026-10-16]
mechanical/v3/cad/dxf/MG3-005.dxf
MG3-005 - mm - SEE PDF FOR DEPTH, THREADS AND SIDE HOLES
