Not1Fun/mini-gantry/mechanical/v3/SolidWorksV3/v3_X_stop_1.SLDPRT

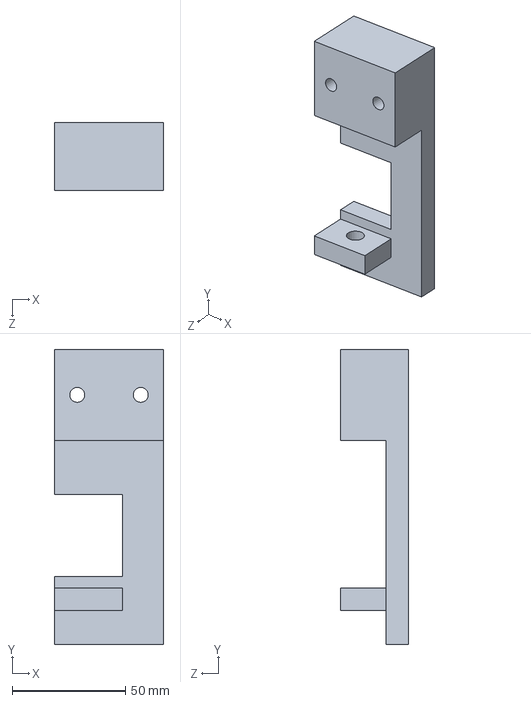
[picture p62: CAD file, 2026-10-16]
mechanical/v3/SolidWorksV3/v3_X_stop_1.SLDPRT
48.0 x 130.0 x 30.0 mm
