Not1Fun/mini-gantry/mechanical/v3/cad/dxf/MG3-075.dxf

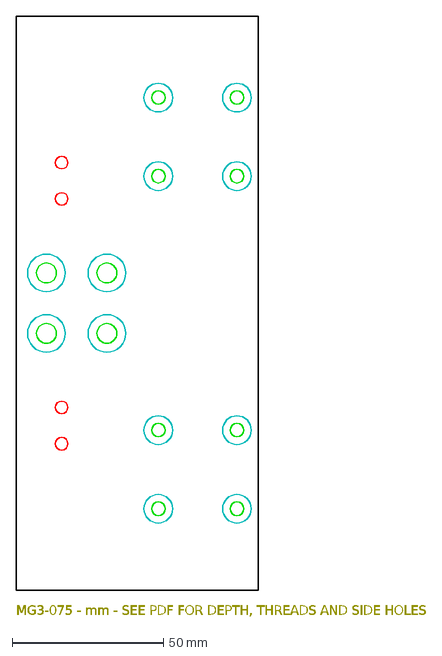
[picture p63: CAD file, 2026-10-16]
mechanical/v3/cad/dxf/MG3-075.dxf
MG3-075 - mm - SEE PDF FOR DEPTH, THREADS AND SIDE HOLES
