Not1Fun/mini-gantry/mechanical/v3/cad/parts/MG3-044_x_input_front_cover.step

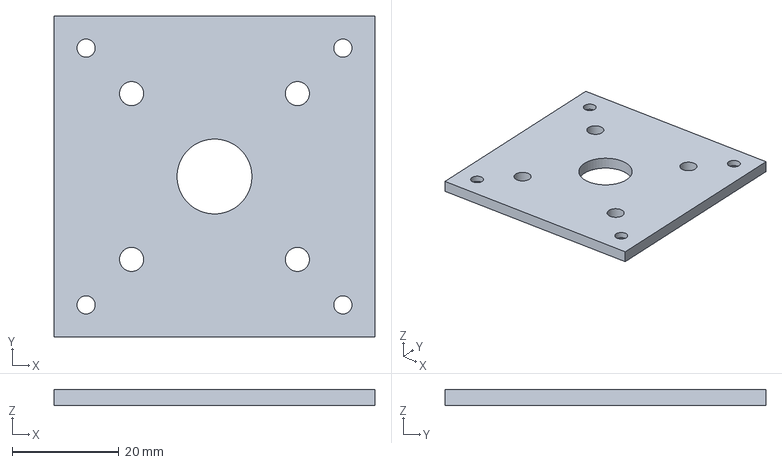
[picture p64: CAD file, 2026-10-16]
mechanical/v3/cad/parts/MG3-044_x_input_front_cover.step
60.0 x 60.0 x 3.00 mm
