Not1Fun/mini-gantry/mechanical/v3/SolidWorksV3/v3_z_float_cover.SLDPRT

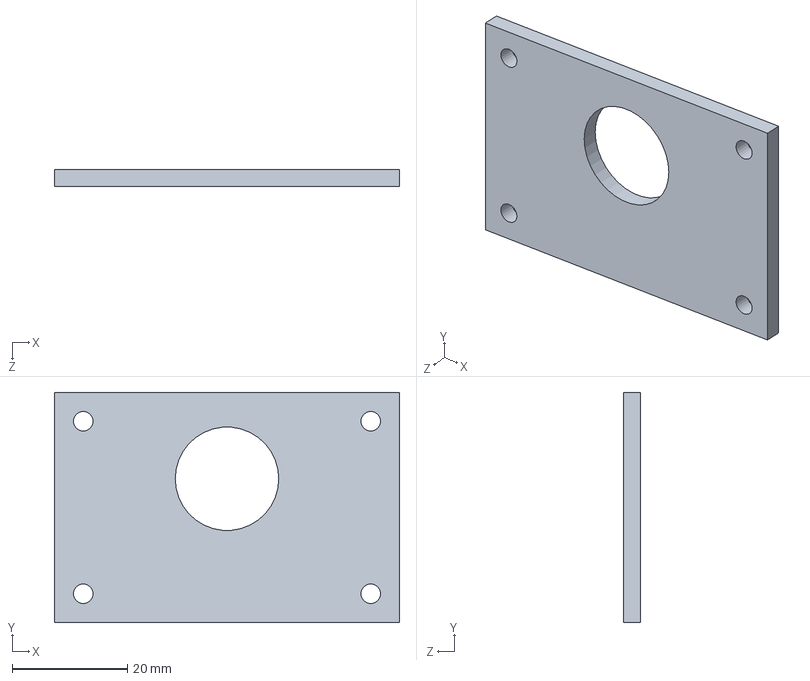
[picture p65: CAD file, 2026-10-16]
mechanical/v3/SolidWorksV3/v3_z_float_cover.SLDPRT
60.0 x 40.0 x 3.00 mm
