Not1Fun/mini-gantry/mechanical/v3/cad/dxf/MG3-010.dxf

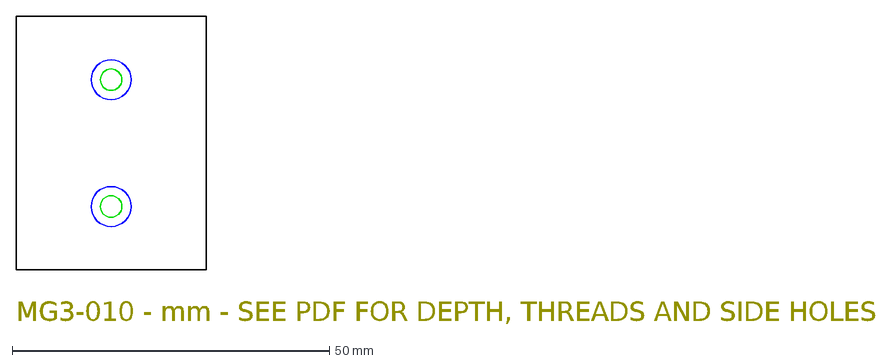
[picture p66: CAD file, 2026-10-16]
mechanical/v3/cad/dxf/MG3-010.dxf
MG3-010 - mm - SEE PDF FOR DEPTH, THREADS AND SIDE HOLES
