Not1Fun/mini-gantry/mechanical/v3/cad/parts/MG3-052_x_output_cover_0.step

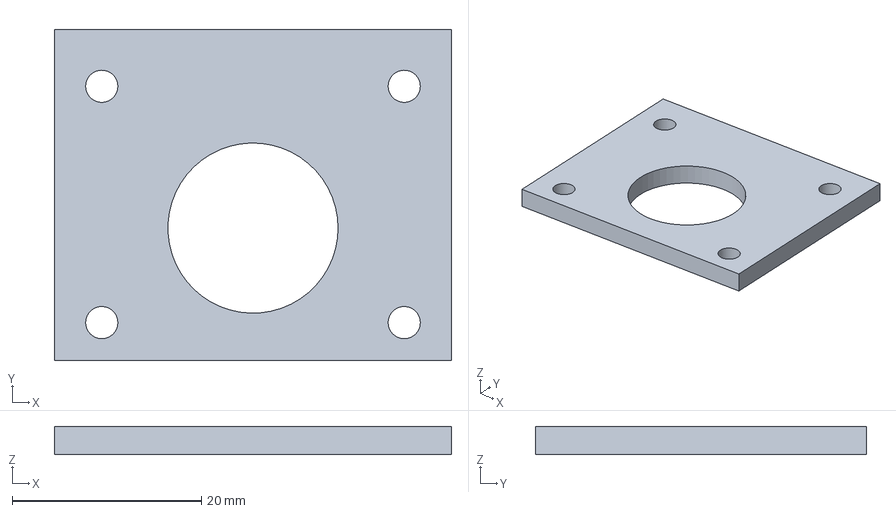
[picture p67: CAD file, 2026-10-16]
mechanical/v3/cad/parts/MG3-052_x_output_cover_0.step
42.0 x 35.0 x 3.00 mm
