Not1Fun/mini-gantry/mechanical/v3/SolidWorksV3/v3_camera_removable_panel.SLDPRT

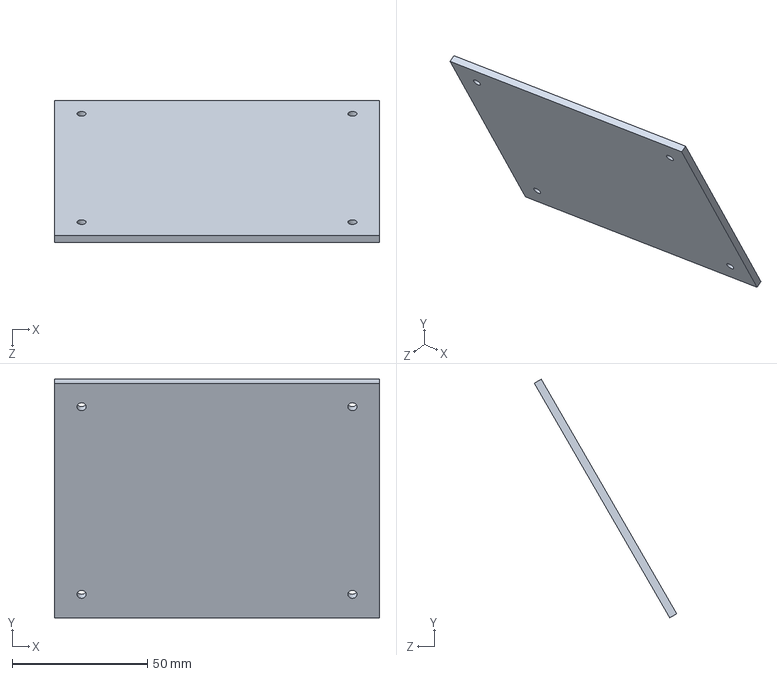
[picture p68: CAD file, 2026-10-16]
mechanical/v3/SolidWorksV3/v3_camera_removable_panel.SLDPRT
120.0 x 88.1 x 52.6 mm
