Not1Fun/mini-gantry/mechanical/v3/cad/dxf/MG3-041.dxf

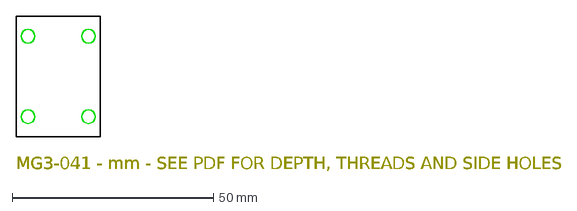
[picture p69: CAD file, 2026-10-16]
mechanical/v3/cad/dxf/MG3-041.dxf
MG3-041 - mm - SEE PDF FOR DEPTH, THREADS AND SIDE HOLES
