Not1Fun/mini-gantry/mechanical/v3/cad/parts/MG3-091_y_sync_shaft.step

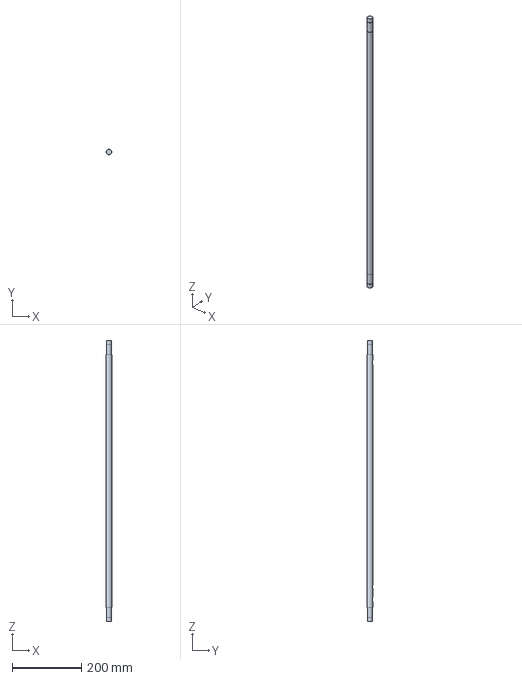
[picture p70: CAD file, 2026-10-16]
mechanical/v3/cad/parts/MG3-091_y_sync_shaft.step
16.0 x 16.0 x 812.0 mm
