Not1Fun/mini-gantry/mechanical/v3/SolidWorksV3/v3_compute_combo_plate.SLDPRT

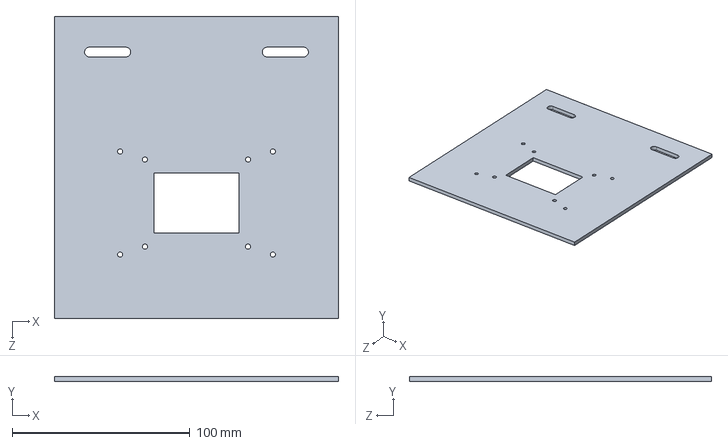
[picture p71: CAD file, 2026-10-16]
mechanical/v3/SolidWorksV3/v3_compute_combo_plate.SLDPRT
160.0 x 3.00 x 170.0 mm
