Not1Fun/mini-gantry/mechanical/v3/cad/dxf/MG3-072.dxf

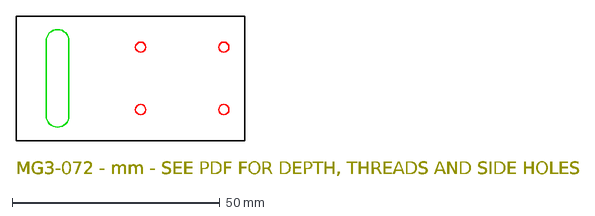
[picture p72: CAD file, 2026-10-16]
mechanical/v3/cad/dxf/MG3-072.dxf
MG3-072 - mm - SEE PDF FOR DEPTH, THREADS AND SIDE HOLES
