Not1Fun/mini-gantry/mechanical/v3/cad/parts/MG3-040_x_belt_bridge.step

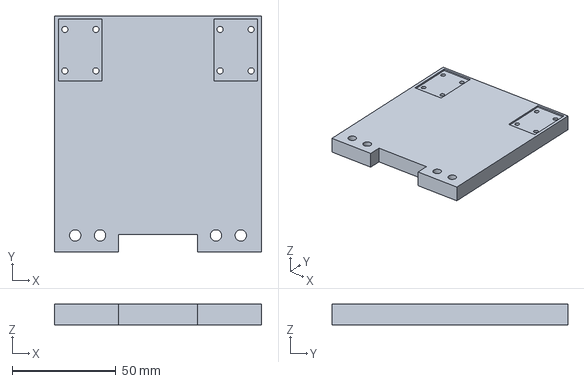
[picture p73: CAD file, 2026-10-16]
mechanical/v3/cad/parts/MG3-040_x_belt_bridge.step
100.0 x 114.0 x 10.0 mm
