Not1Fun/mini-gantry/mechanical/v3/SolidWorksV3/v3_y_reduction_input_pulley.SLDPRT

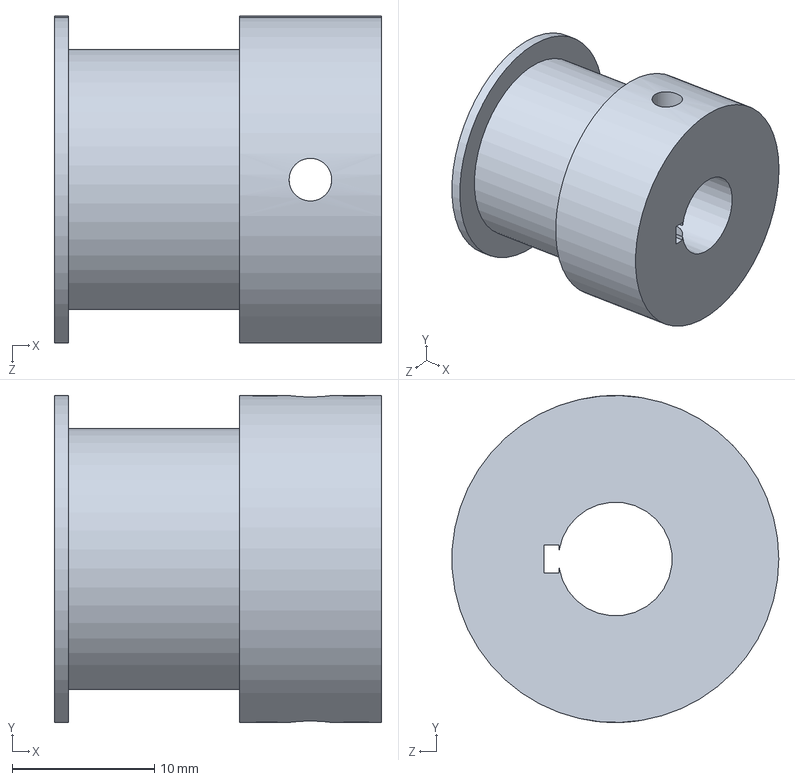
[picture p74: CAD file, 2026-10-16]
mechanical/v3/SolidWorksV3/v3_y_reduction_input_pulley.SLDPRT
23.0 x 23.0 x 23.0 mm
