Not1Fun/mini-gantry/mechanical/v3/cad/dxf/MG3-015.dxf

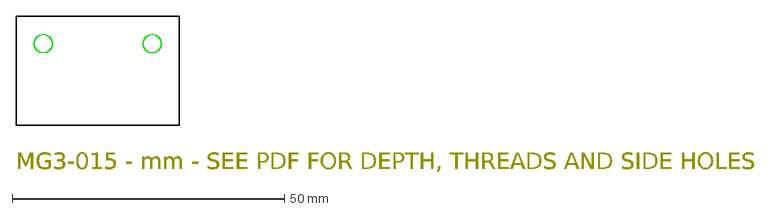
[picture p75: CAD file, 2026-10-16]
mechanical/v3/cad/dxf/MG3-015.dxf
MG3-015 - mm - SEE PDF FOR DEPTH, THREADS AND SIDE HOLES
