Not1Fun/mini-gantry/mechanical/v3/SolidWorksV3/v3_x_input_motor_plate.SLDPRT

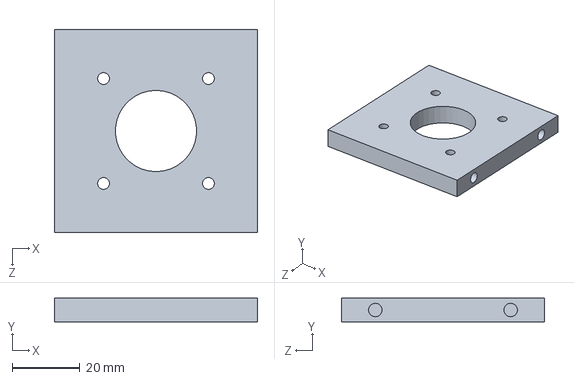
[picture p76: CAD file, 2026-10-16]
mechanical/v3/SolidWorksV3/v3_x_input_motor_plate.SLDPRT
60.0 x 7.00 x 60.0 mm
