Not1Fun/mini-gantry/mechanical/v3/cad/dxf/MG3-029.dxf

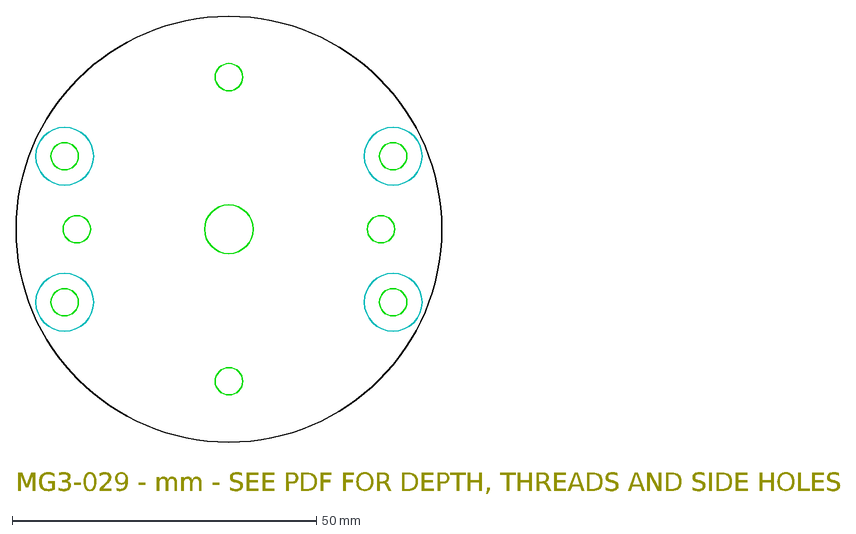
[picture p77: CAD file, 2026-10-16]
mechanical/v3/cad/dxf/MG3-029.dxf
MG3-029 - mm - SEE PDF FOR DEPTH, THREADS AND SIDE HOLES
