Not1Fun/mini-gantry/mechanical/v3/SolidWorksV3/v3_y_rear_cover_0.SLDPRT

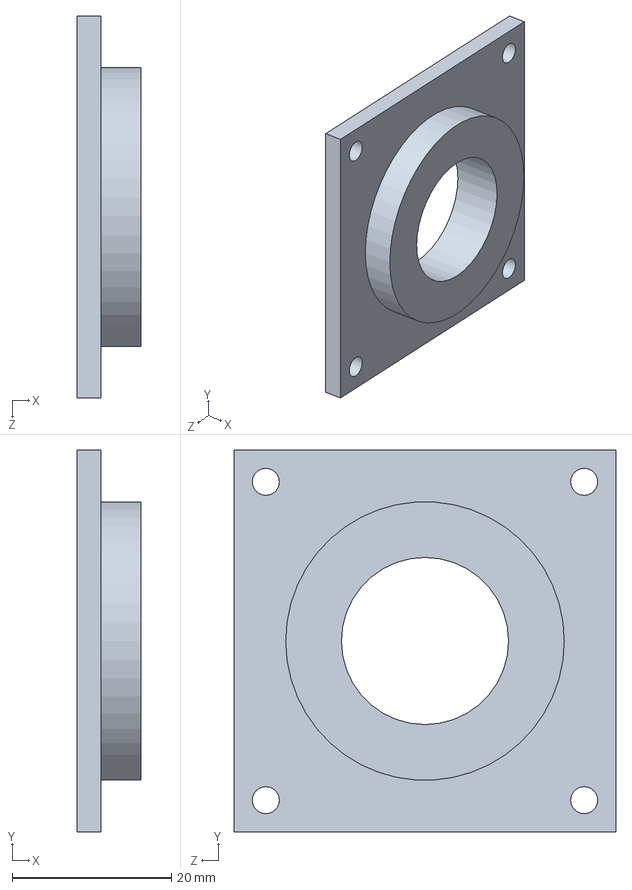
[picture p78: CAD file, 2026-10-16]
mechanical/v3/SolidWorksV3/v3_y_rear_cover_0.SLDPRT
8.00 x 48.0 x 48.0 mm
