Not1Fun/mini-gantry/mechanical/v3/cad/dxf/MG3-104.dxf

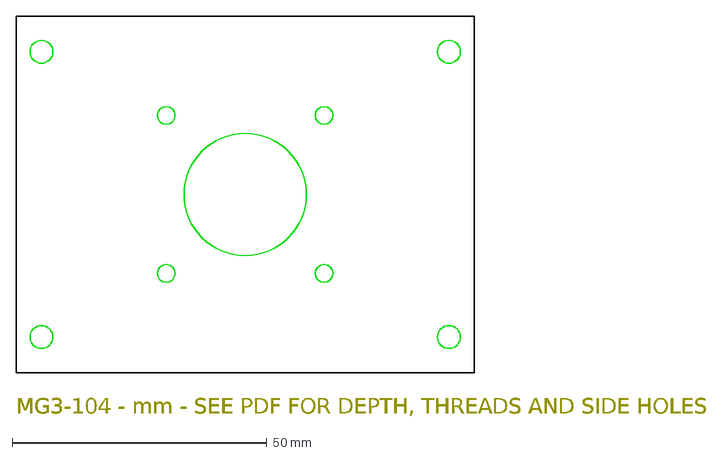
[picture p79: CAD file, 2026-10-16]
mechanical/v3/cad/dxf/MG3-104.dxf
MG3-104 - mm - SEE PDF FOR DEPTH, THREADS AND SIDE HOLES
