Not1Fun/mini-gantry/mechanical/v3/cad/parts/MG3-020_camera_pivot_ear_0.step

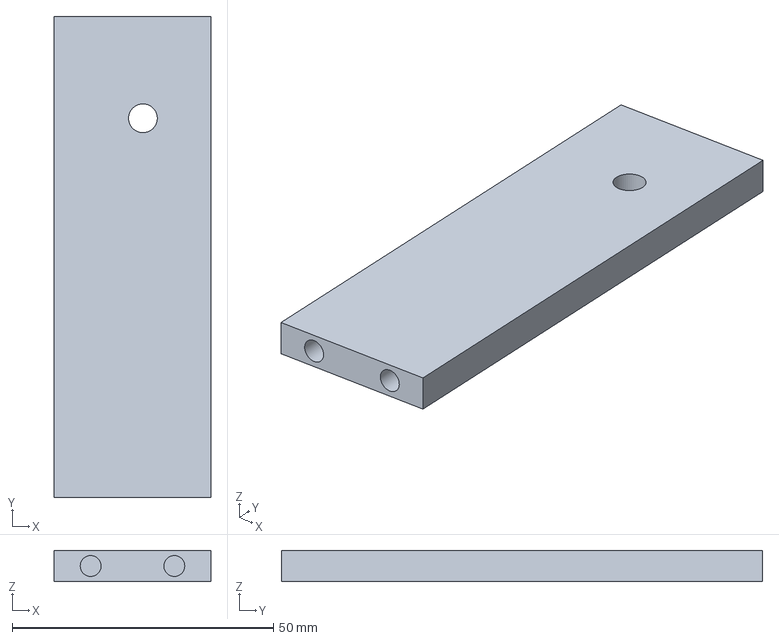
[picture p80: CAD file, 2026-10-16]
mechanical/v3/cad/parts/MG3-020_camera_pivot_ear_0.step
30.0 x 92.0 x 6.00 mm
