Not1Fun/mini-gantry/mechanical/v3/cad/dxf/MG3-003.dxf

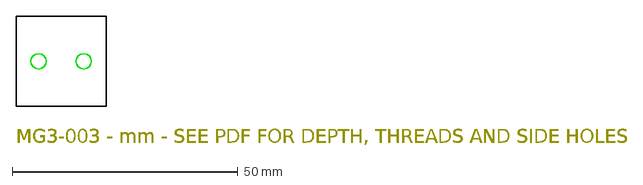
[picture p81: CAD file, 2026-10-16]
mechanical/v3/cad/dxf/MG3-003.dxf
MG3-003 - mm - SEE PDF FOR DEPTH, THREADS AND SIDE HOLES
