Not1Fun/mini-gantry/mechanical/v3/SolidWorksV3/v3_Z_striker_0.SLDPRT

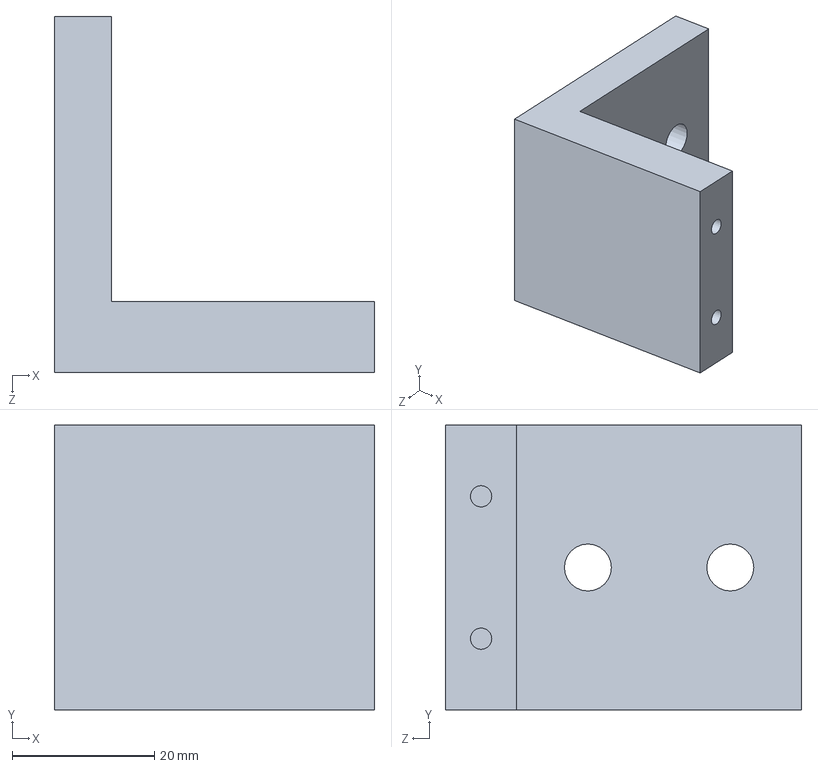
[picture p82: CAD file, 2026-10-16]
mechanical/v3/SolidWorksV3/v3_Z_striker_0.SLDPRT
45.0 x 40.0 x 50.0 mm
