Not1Fun/mini-gantry/mechanical/v3/cad/dxf/MG3-045.dxf

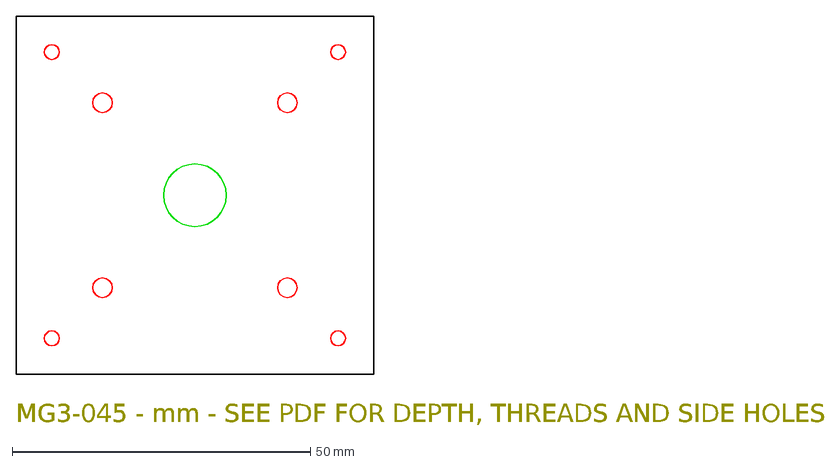
[picture p83: CAD file, 2026-10-16]
mechanical/v3/cad/dxf/MG3-045.dxf
MG3-045 - mm - SEE PDF FOR DEPTH, THREADS AND SIDE HOLES
