Not1Fun/mini-gantry/mechanical/v3/cad/parts/MG3-026_fixed_head_side_0.step

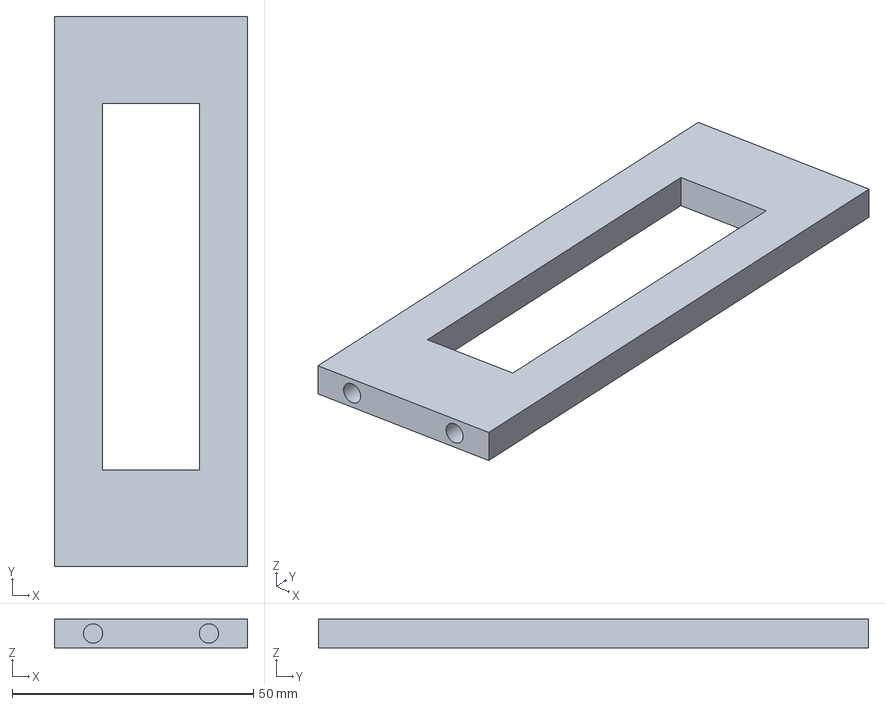
[picture p84: CAD file, 2026-10-16]
mechanical/v3/cad/parts/MG3-026_fixed_head_side_0.step
40.0 x 114.0 x 6.00 mm
