Not1Fun/mini-gantry/mechanical/v3/SolidWorksV3/v3_y_tension_0_base.SLDPRT

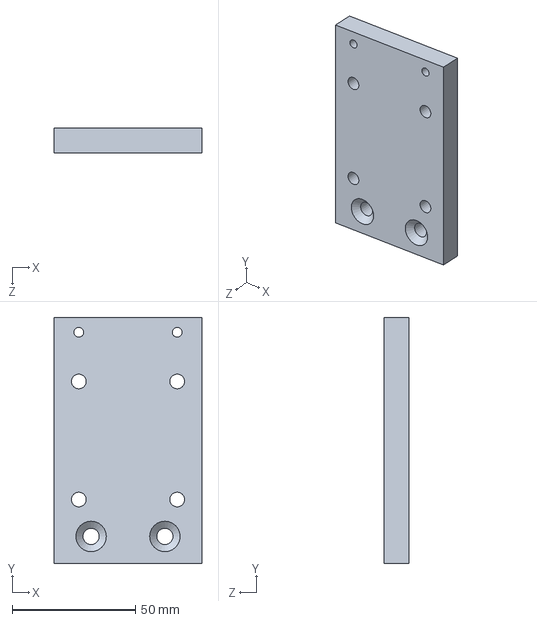
[picture p85: CAD file, 2026-10-16]
mechanical/v3/SolidWorksV3/v3_y_tension_0_base.SLDPRT
60.0 x 100.0 x 10.0 mm
