Not1Fun/mini-gantry/mechanical/v3/cad/dxf/MG3-017.dxf

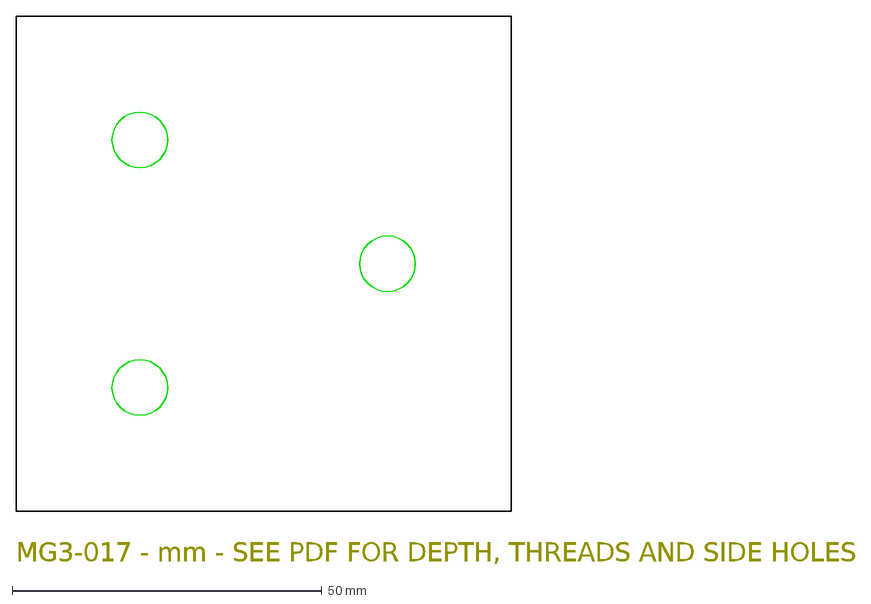
[picture p86: CAD file, 2026-10-16]
mechanical/v3/cad/dxf/MG3-017.dxf
MG3-017 - mm - SEE PDF FOR DEPTH, THREADS AND SIDE HOLES
