Not1Fun/mini-gantry/mechanical/v3/SolidWorksV3/v3_Y_sensor_mount_1.SLDPRT

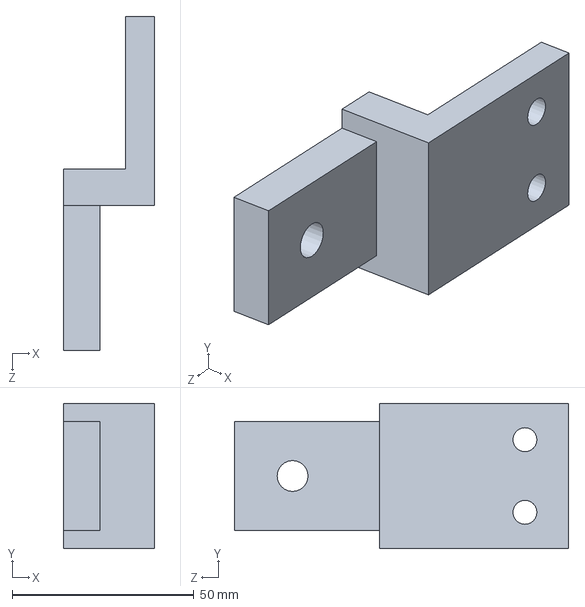
[picture p87: CAD file, 2026-10-16]
mechanical/v3/SolidWorksV3/v3_Y_sensor_mount_1.SLDPRT
25.0 x 40.0 x 92.0 mm
