Not1Fun/mini-gantry/mechanical/v3/cad/dxf/MG3-028.dxf

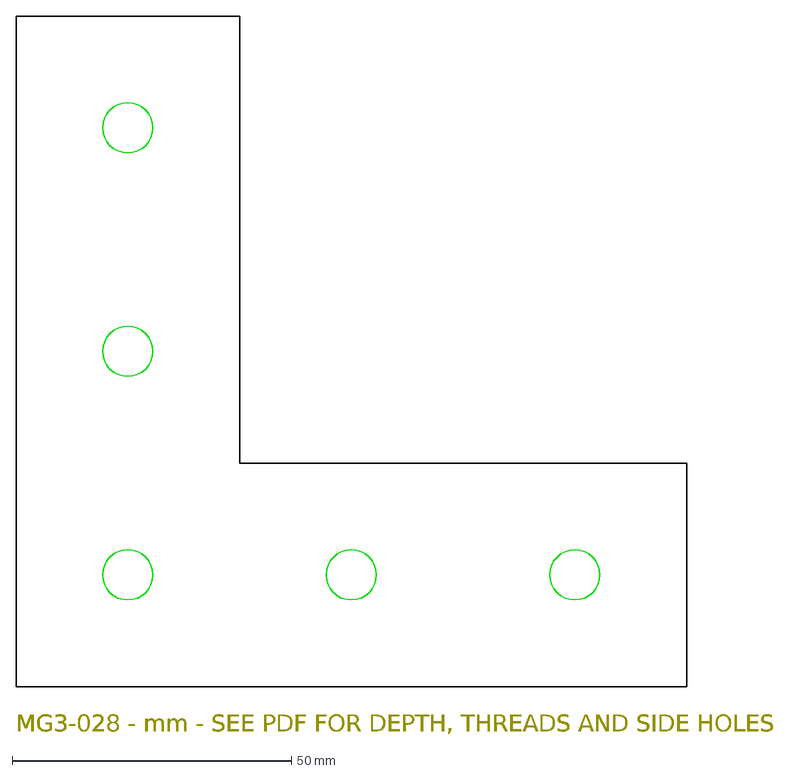
[picture p88: CAD file, 2026-10-16]
mechanical/v3/cad/dxf/MG3-028.dxf
MG3-028 - mm - SEE PDF FOR DEPTH, THREADS AND SIDE HOLES
