Not1Fun/mini-gantry/mechanical/v3/cad/dxf/MG3-047.dxf

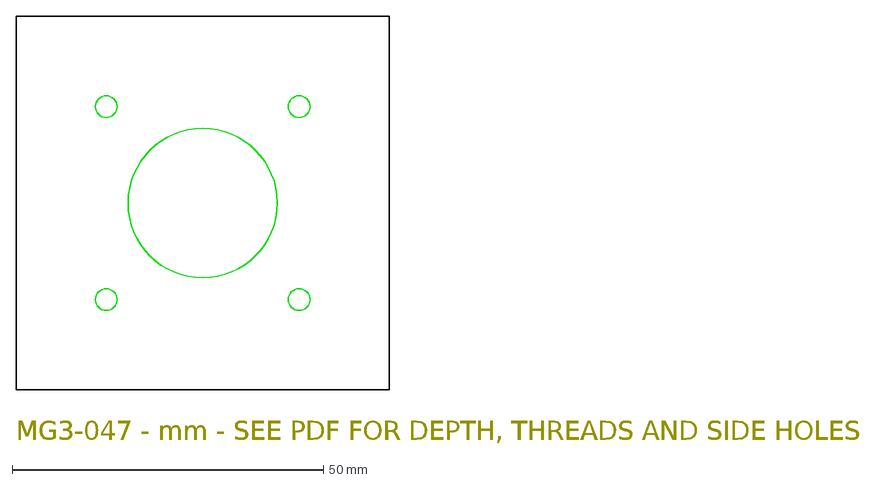
[picture p89: CAD file, 2026-10-16]
mechanical/v3/cad/dxf/MG3-047.dxf
MG3-047 - mm - SEE PDF FOR DEPTH, THREADS AND SIDE HOLES
