Not1Fun/mini-gantry/mechanical/v3/cad/parts/MG3-076_y_motor_bracket.step

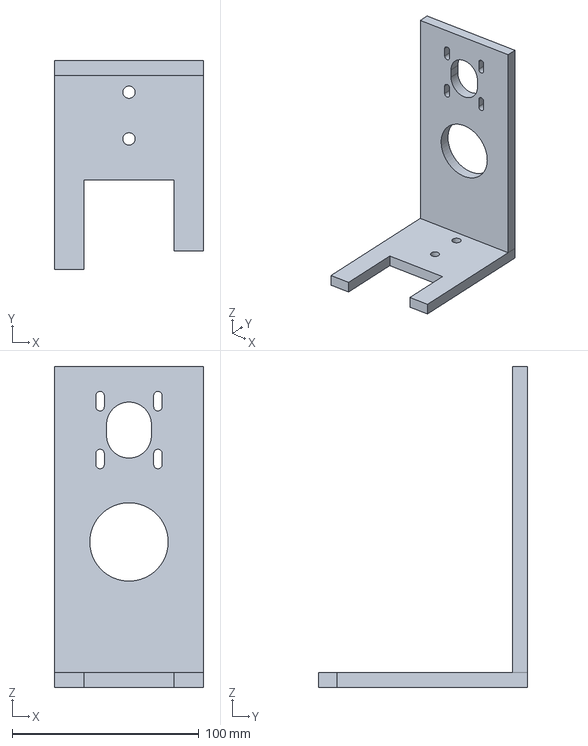
[picture p90: CAD file, 2026-10-16]
mechanical/v3/cad/parts/MG3-076_y_motor_bracket.step
80.0 x 112.0 x 172.0 mm
