Not1Fun/mini-gantry/mechanical/v3/cad/dxf/MG3-001.dxf

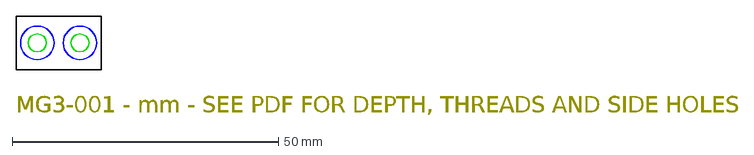
[picture p91: CAD file, 2026-10-16]
mechanical/v3/cad/dxf/MG3-001.dxf
MG3-001 - mm - SEE PDF FOR DEPTH, THREADS AND SIDE HOLES
