Not1Fun/mini-gantry/mechanical/v3/cad/dxf/MG3-099.dxf

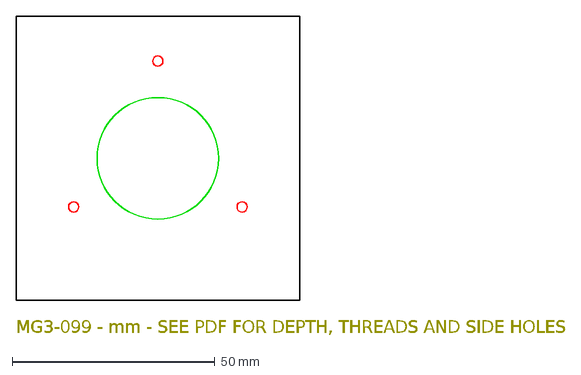
[picture p92: CAD file, 2026-10-16]
mechanical/v3/cad/dxf/MG3-099.dxf
MG3-099 - mm - SEE PDF FOR DEPTH, THREADS AND SIDE HOLES
