Not1Fun/mini-gantry/mechanical/v3/cad/parts/MG3-013_Z_stop_1.step

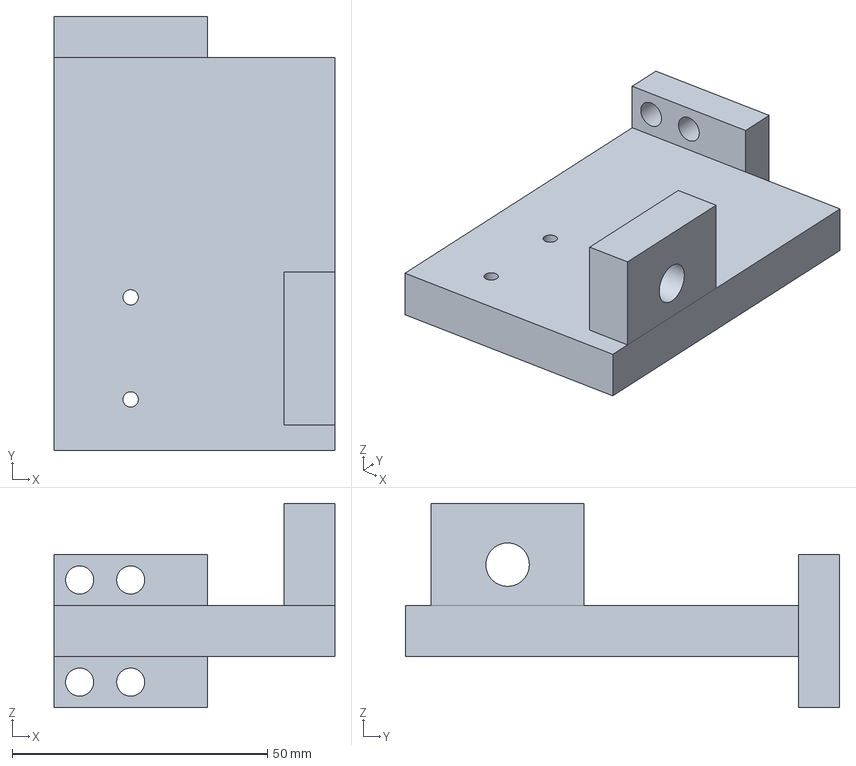
[picture p93: CAD file, 2026-10-16]
mechanical/v3/cad/parts/MG3-013_Z_stop_1.step
55.0 x 85.0 x 40.0 mm
