Not1Fun/mini-gantry/mechanical/v3/cad/dxf/MG3-092.dxf

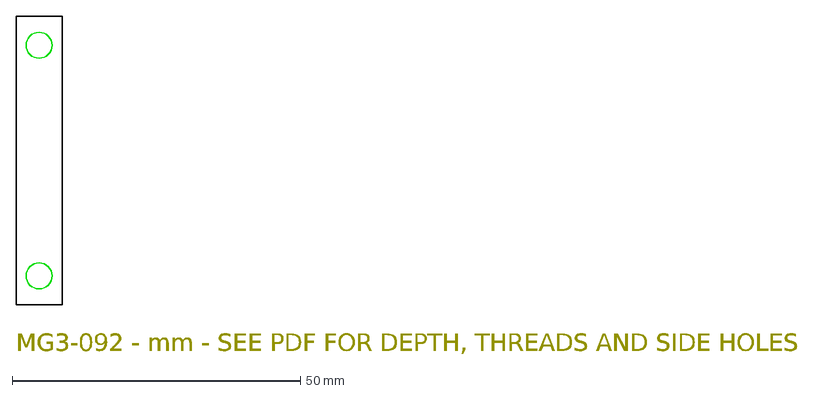
[picture p94: CAD file, 2026-10-16]
mechanical/v3/cad/dxf/MG3-092.dxf
MG3-092 - mm - SEE PDF FOR DEPTH, THREADS AND SIDE HOLES
