Not1Fun/mini-gantry/mechanical/v3/cad/parts/MG3-073_y_clamp_1_-1_carrier.step

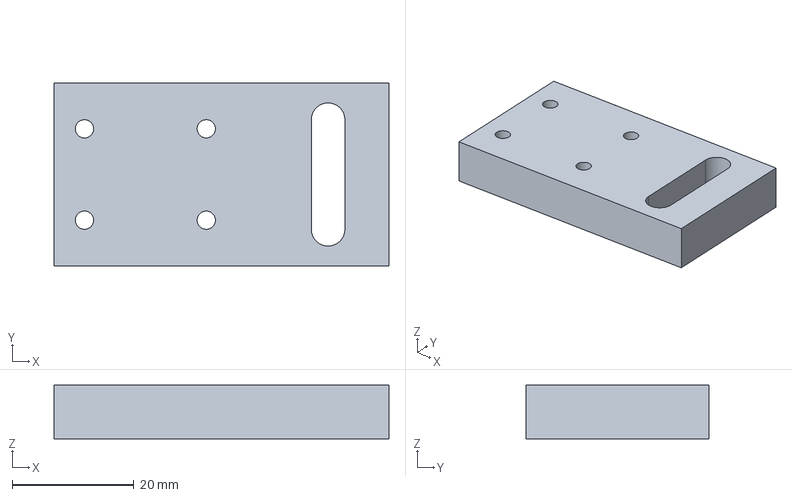
[picture p95: CAD file, 2026-10-16]
mechanical/v3/cad/parts/MG3-073_y_clamp_1_-1_carrier.step
55.0 x 30.0 x 8.81 mm
