Not1Fun/mini-gantry/mechanical/v3/SolidWorksV3/v3_side_brace_1_0.SLDPRT

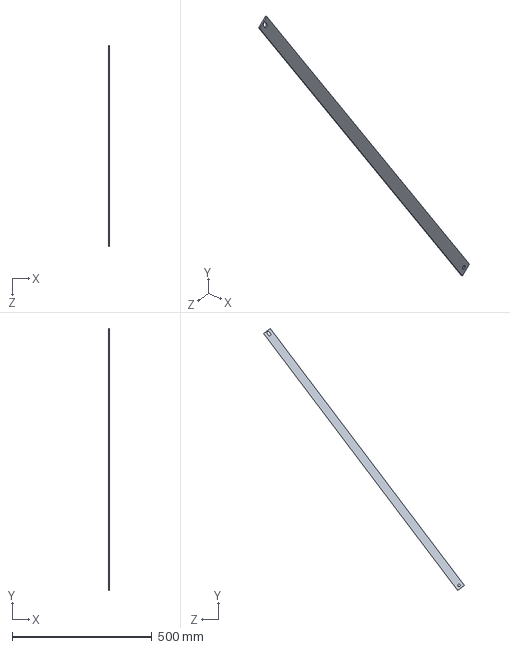
[picture p96: CAD file, 2026-10-16]
mechanical/v3/SolidWorksV3/v3_side_brace_1_0.SLDPRT
3.00 x 937.2 x 718.4 mm
