Not1Fun/mini-gantry/mechanical/v3/cad/dxf/MG3-027.dxf

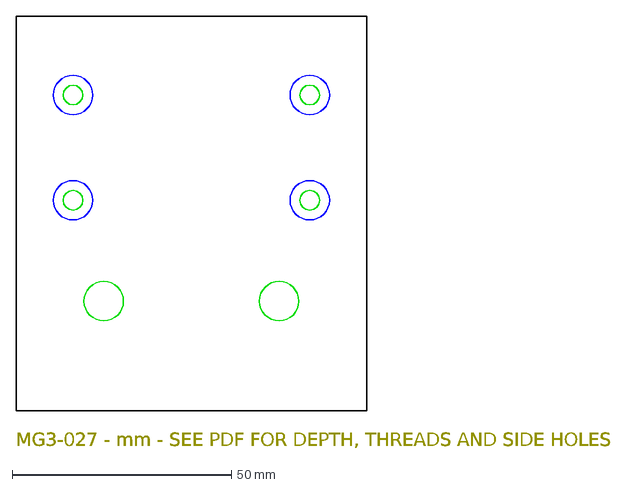
[picture p97: CAD file, 2026-10-16]
mechanical/v3/cad/dxf/MG3-027.dxf
MG3-027 - mm - SEE PDF FOR DEPTH, THREADS AND SIDE HOLES
