Not1Fun/mini-gantry/mechanical/v3/cad/parts/MG3-036_side_brace_0_1.step

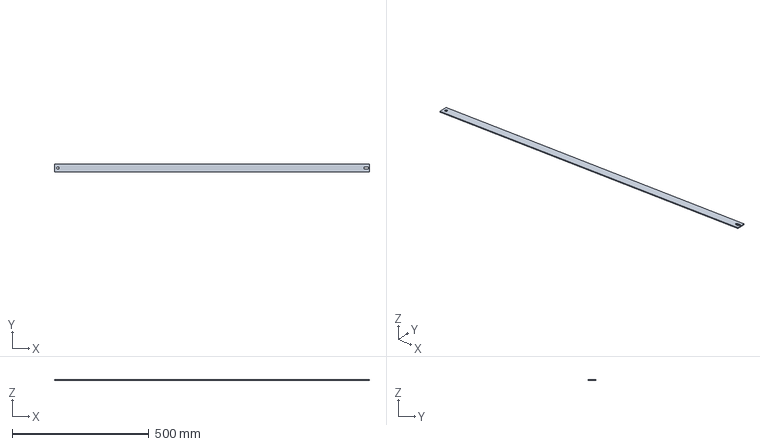
[picture p98: CAD file, 2026-10-16]
mechanical/v3/cad/parts/MG3-036_side_brace_0_1.step
1152.0 x 30.0 x 3.00 mm
