Not1Fun/mini-gantry/mechanical/v3/cad/dxf/MG3-040.dxf

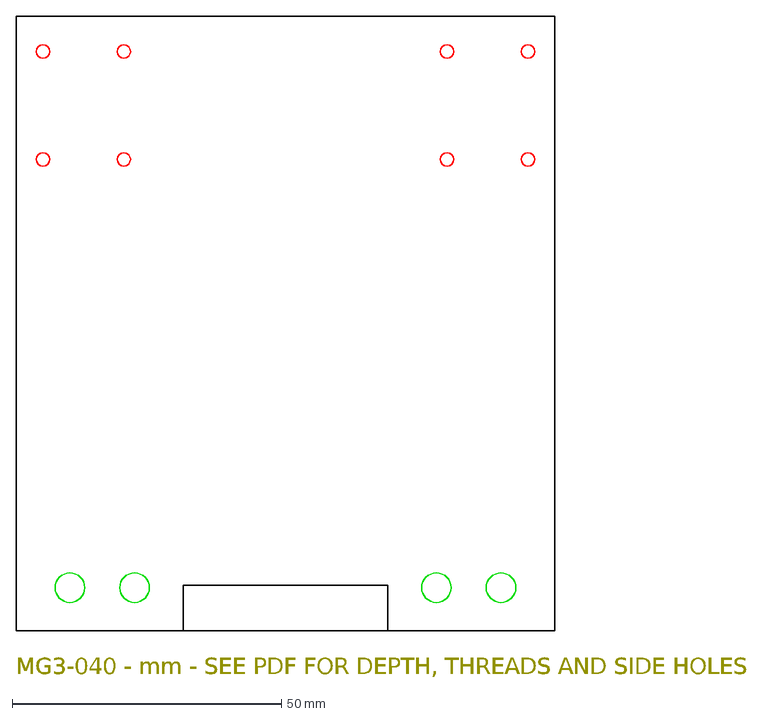
[picture p99: CAD file, 2026-10-16]
mechanical/v3/cad/dxf/MG3-040.dxf
MG3-040 - mm - SEE PDF FOR DEPTH, THREADS AND SIDE HOLES
