Not1Fun/mini-gantry/mechanical/v3/cad/parts/MG3-033_rear_brace_1_spacer_0.step

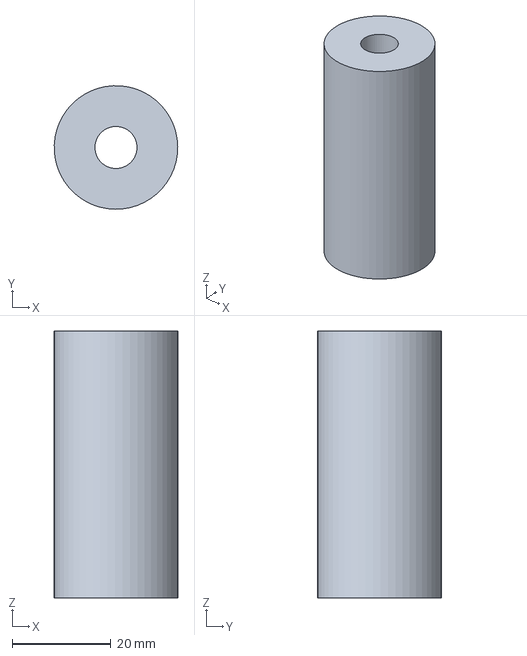
[picture p100: CAD file, 2026-10-16]
mechanical/v3/cad/parts/MG3-033_rear_brace_1_spacer_0.step
25.0 x 25.0 x 54.0 mm
