Not1Fun/mini-gantry/mechanical/v3/SolidWorksV3/v3_module_fixed.SLDPRT

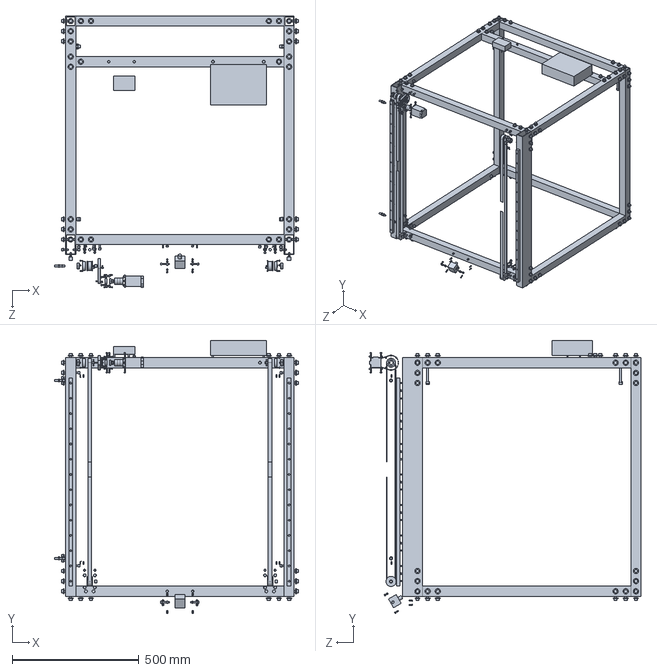
[picture p101: CAD file, 2026-10-16]
mechanical/v3/SolidWorksV3/v3_module_fixed.SLDPRT
961.0 x 1075.8 x 1070.9 mm
