Not1Fun/mini-gantry/mechanical/v3/cad/dxf/MG3-022.dxf

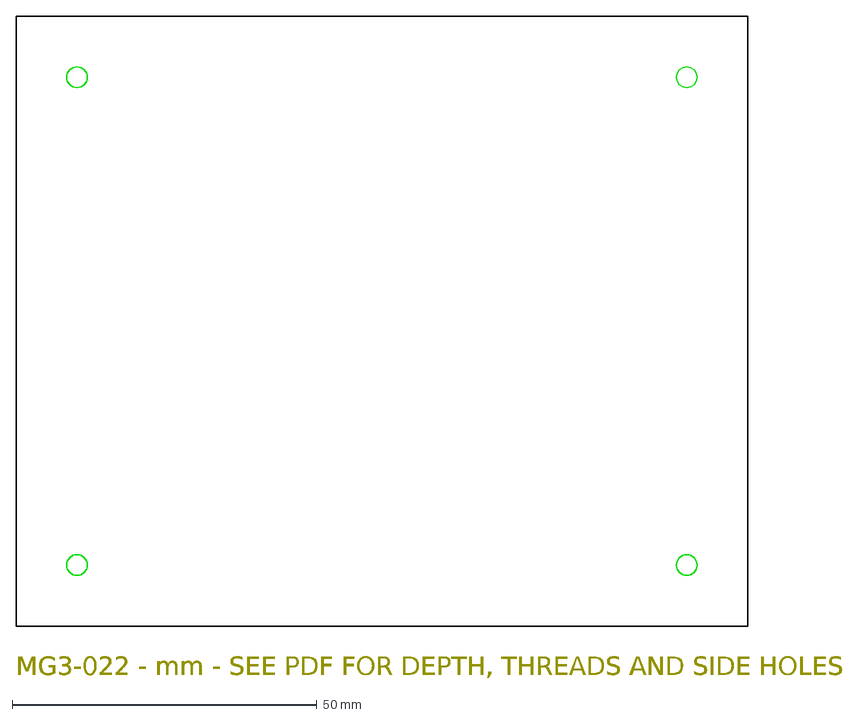
[picture p102: CAD file, 2026-10-16]
mechanical/v3/cad/dxf/MG3-022.dxf
MG3-022 - mm - SEE PDF FOR DEPTH, THREADS AND SIDE HOLES
