Not1Fun/mini-gantry/mechanical/v3/cad/parts/MG3-101_z_float_housing.step

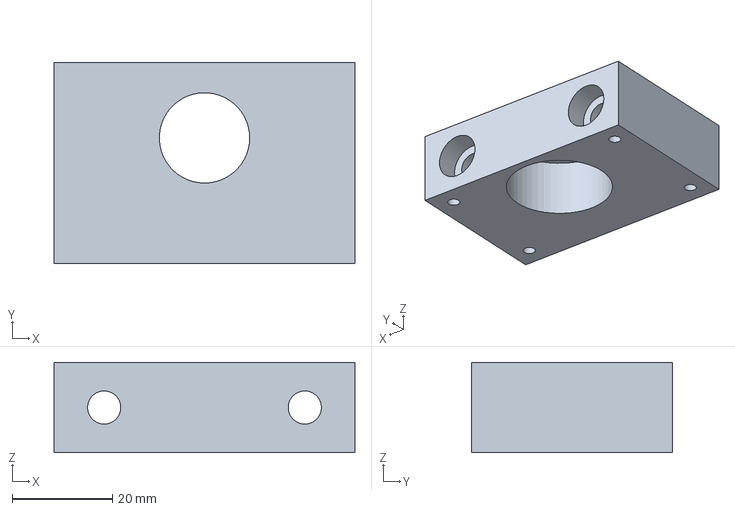
[picture p103: CAD file, 2026-10-16]
mechanical/v3/cad/parts/MG3-101_z_float_housing.step
60.0 x 40.0 x 18.0 mm
