Not1Fun/mini-gantry/mechanical/v3/cad/dxf/MG3-011.dxf

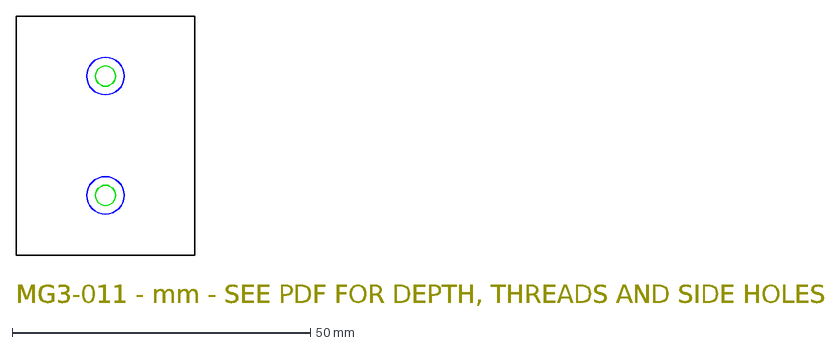
[picture p104: CAD file, 2026-10-16]
mechanical/v3/cad/dxf/MG3-011.dxf
MG3-011 - mm - SEE PDF FOR DEPTH, THREADS AND SIDE HOLES
