Not1Fun/mini-gantry/mechanical/v3/cad/dxf/MG3-071.dxf

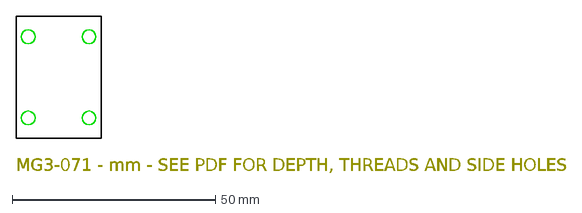
[picture p105: CAD file, 2026-10-16]
mechanical/v3/cad/dxf/MG3-071.dxf
MG3-071 - mm - SEE PDF FOR DEPTH, THREADS AND SIDE HOLES
