Not1Fun/mini-gantry/mechanical/v3/SolidWorksV3/v3_Z_bumper_0.SLDPRT

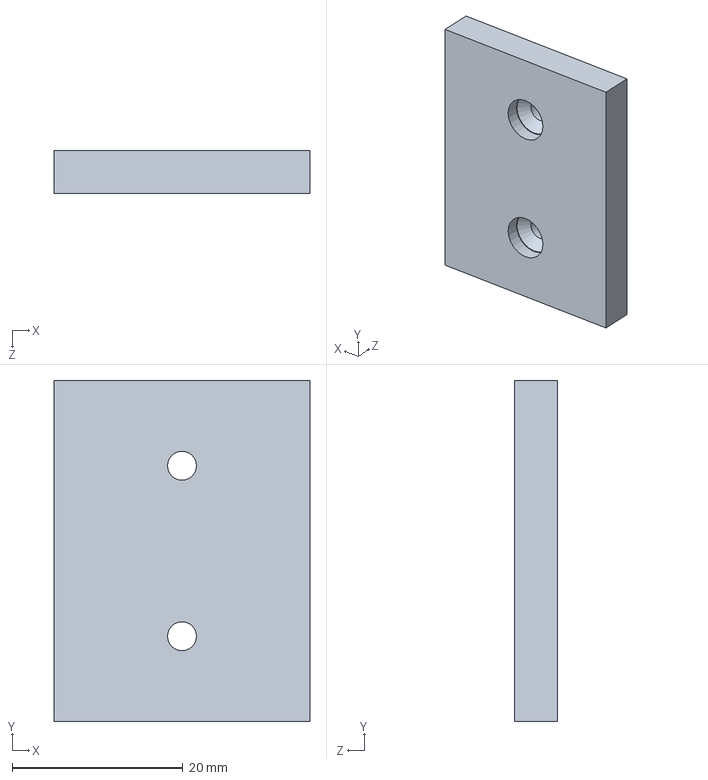
[picture p106: CAD file, 2026-10-16]
mechanical/v3/SolidWorksV3/v3_Z_bumper_0.SLDPRT
30.0 x 40.0 x 5.00 mm
