Not1Fun/mini-gantry/mechanical/v3/cad/dxf/MG3-052.dxf

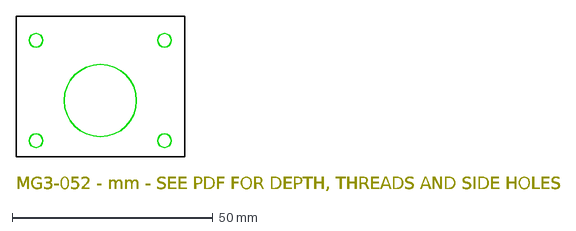
[picture p107: CAD file, 2026-10-16]
mechanical/v3/cad/dxf/MG3-052.dxf
MG3-052 - mm - SEE PDF FOR DEPTH, THREADS AND SIDE HOLES
