Not1Fun/mini-gantry/mechanical/v3/cad/parts/MG3-049_x_input_shaft.step

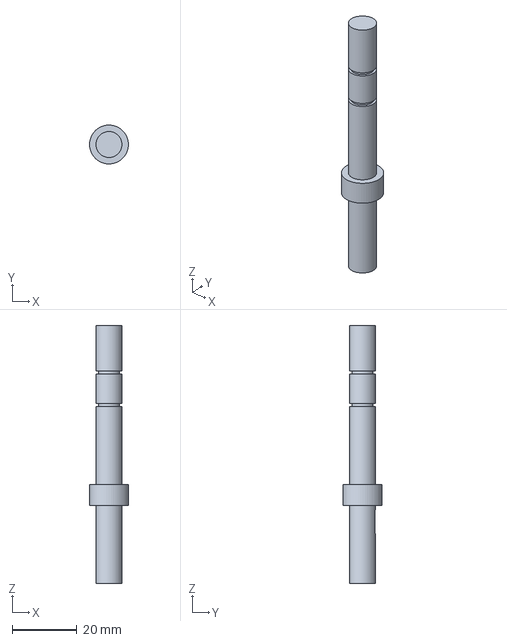
[picture p108: CAD file, 2026-10-16]
mechanical/v3/cad/parts/MG3-049_x_input_shaft.step
12.0 x 12.0 x 79.5 mm
