Not1Fun/mini-gantry/mechanical/v3/cad/dxf/MG3-105.dxf

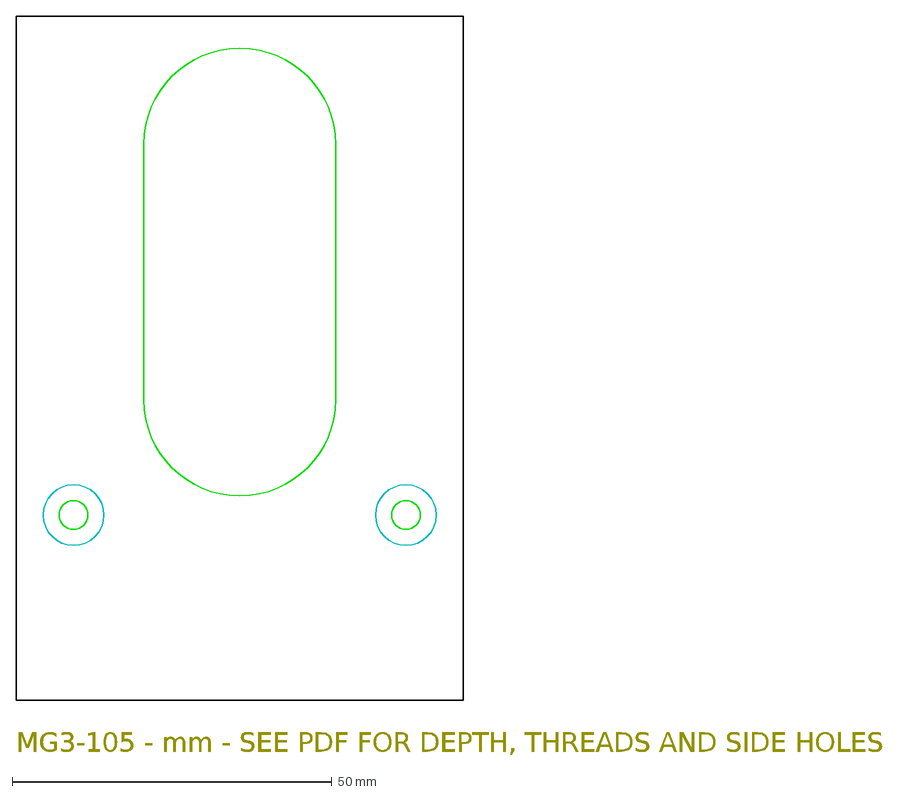
[picture p109: CAD file, 2026-10-16]
mechanical/v3/cad/dxf/MG3-105.dxf
MG3-105 - mm - SEE PDF FOR DEPTH, THREADS AND SIDE HOLES
