Not1Fun/mini-gantry/mechanical/v3/cad/parts/MG3-057_x_output_spacer_1.step

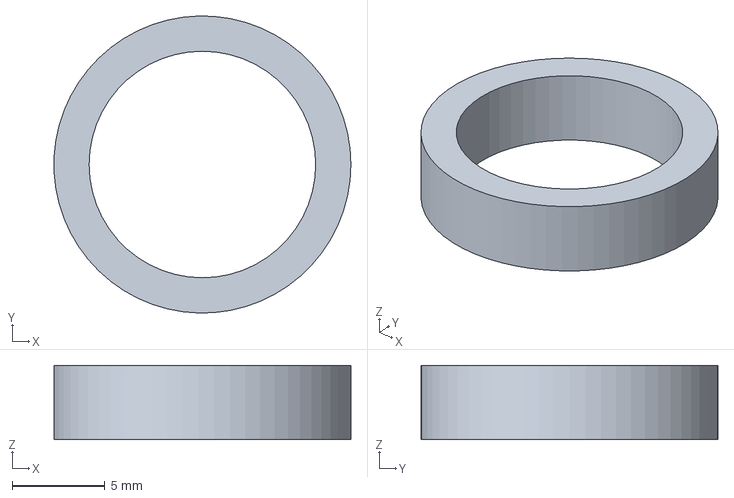
[picture p110: CAD file, 2026-10-16]
mechanical/v3/cad/parts/MG3-057_x_output_spacer_1.step
16.0 x 16.0 x 4.00 mm
