Not1Fun/mini-gantry/mechanical/v3/cad/dxf/MG3-101.dxf

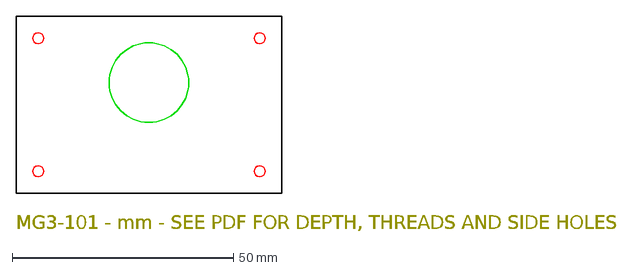
[picture p111: CAD file, 2026-10-16]
mechanical/v3/cad/dxf/MG3-101.dxf
MG3-101 - mm - SEE PDF FOR DEPTH, THREADS AND SIDE HOLES
