Not1Fun/mini-gantry/mechanical/v3/cad/dxf/MG3-025.dxf

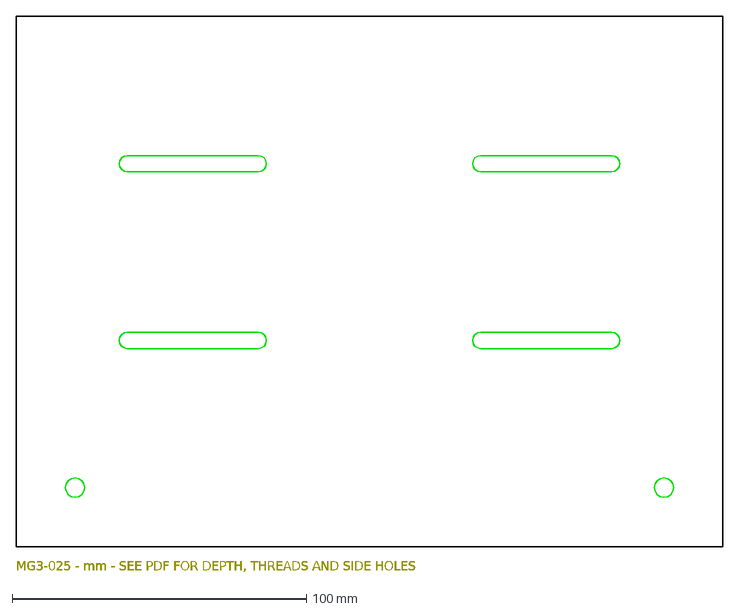
[picture p112: CAD file, 2026-10-16]
mechanical/v3/cad/dxf/MG3-025.dxf
MG3-025 - mm - SEE PDF FOR DEPTH, THREADS AND SIDE HOLES
