Not1Fun/mini-gantry/mechanical/v3/SolidWorksV3/mini_gantry_v3.SLDASM

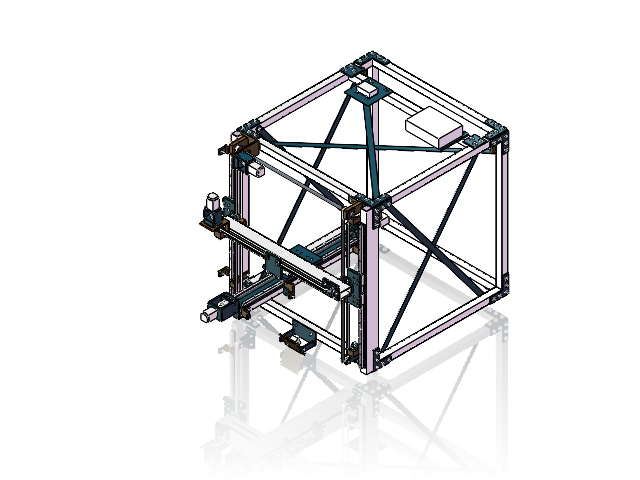
[picture p113: CAD file, 2026-10-16]
mechanical/v3/SolidWorksV3/mini_gantry_v3.SLDASM
v3_y_rail_base_0
v3_y_rail_base_1
v3_x_rail_base_0
v3_x_rail_base_1
v3_z_rail_backplate
v3_y_end_plate_0
v3_bridge_riser_0
v3_y_end_plate_1
v3_bridge_riser_1
v3_x_z_carrier
v3_z_block_spacer_0_0
v3_z_block_spacer_0_1
v3_z_block_spacer_1_0
v3_z_block_spacer_1_1
v3_z_nut_cradle
v3_fixed_head_top
v3_fixed_head_side_0
v3_fixed_head_side_1
v3_gripper_adapter
v3_z_motor_mount
v3_z_motor_standoff_0
v3_z_motor_standoff_1
v3_z_brake_carrier
v3_z_motor_lower_saddle
v3_z_screw_1605
v3_x_input_housing
v3_x_input_front_cover
v3_x_input_rear_cover
v3_x_input_inner_spacer
v3_x_input_shaft
v3_x_input_end_spacer
v3_x_input_end_retainer
v3_x_input_motor_plate
v3_x_input_side_0
v3_x_input_side_1
v3_y_input_housing
v3_y_input_front_cover
v3_y_input_rear_cover
v3_y_input_inner_spacer
v3_y_input_shaft
v3_y_input_end_spacer
v3_y_input_end_retainer
v3_y_input_motor_plate
v3_y_input_side_0
v3_y_input_side_1
v3_z_float_housing
v3_z_float_cover
v3_z_float_outer_spacer
v3_x_reduction_input_pulley
v3_x_reduction_driven_pulley
v3_y_reduction_input_pulley
v3_y_reduction_driven_pulley
v3_x_pulley_0
v3_y_pulley_0_1
v3_y_pulley_1_1
v3_x_output_housing
v3_x_output_cover_0
v3_x_output_cover_1
v3_x_output_shaft
v3_x_output_spacer_0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
