Not1Fun/mini-gantry/(list of files, cad)

Other CAD files:
mechanical/v3/cad/dxf/MG3-079.dxf
mechanical/v3/cad/dxf/MG3-030.dxf
mechanical/v3/SolidWorksV3/v3_Z_target_1.SLDPRT
mechanical/v3/cad/dxf/MG3-032.dxf
mechanical/v3/cad/parts/MG3-105_z_motor_standoff_0.step
mechanical/v3/SolidWorksV3/v3_x_tension_0_axle.SLDPRT
mechanical/v3/SolidWorksV3/v3_z_block_spacer_1_0.SLDPRT
mechanical/v3/cad/parts/MG3-041_x_clamp_0_-1_cap.step
mechanical/v3/SolidWorksV3/v3_y_input_rear_cover.SLDPRT
mechanical/v3/cad/parts/MG3-082_y_rear_spacer_0_0.step
mechanical/v3/cad/parts/MG3-095_y_tension_0_fork.step
mechanical/v3/cad/dxf/MG3-036.dxf
mechanical/v3/cad/parts/MG3-028_frame_corner_front_0_0.step
mechanical/v3/SolidWorksV3/v3_x_clamp_0_-1_cap.SLDPRT
mechanical/v3/cad/parts/MG3-037_side_brace_0_1_spacer_0.step
mechanical/v3/cad/parts/MG3-024_compute_combo_plate.step
mechanical/v3/SolidWorksV3/v3_side_brace_0_1_spacer_0.SLDPRT
mechanical/v3/cad/parts/MG3-015_Z_target_0.step
mechanical/v3/SolidWorksV3/v3_side_brace_1_0_spacer_1.SLDPRT
mechanical/v3/cad/dxf/MG3-034.dxf
mechanical/v3/cad/parts/MG3-018_bridge_riser_0.step
mechanical/v3/cad/parts/MG3-005_Y_bumper_0_1.step
mechanical/v3/SolidWorksV3/v3_side_brace_1_1_spacer_0.SLDPRT
mechanical/v3/SolidWorksV3/v3_camera_pivot_ear_1.SLDPRT
mechanical/v3/cad/parts/MG3-100_z_float_cover.step
mechanical/v3/SolidWorksV3/v3_y_input_side_0.SLDPRT
mechanical/v3/SolidWorksV3/v3_y_clamp_1_-1_cap.SLDPRT
mechanical/v3/SolidWorksV3/v3_camera_pivot_spacer_1.SLDPRT
mechanical/v3/cad/parts/MG3-035_side_brace_0_0_spacer_0.step
mechanical/v3/SolidWorksV3/v3_y_clamp_0_-1_cap.SLDPRT
mechanical/v3/cad/dxf/MG3-108.dxf
mechanical/v3/cad/parts/MG3-074_y_end_plate_0.step
mechanical/v3/SolidWorksV3/v3_frame_corner_rear_0_1.SLDPRT
mechanical/v3/cad/parts/MG3-085_y_rear_spacer_1_1.step
mechanical/v3/SolidWorksV3/v3_rear_brace_1_spacer_1.SLDPRT
mechanical/v3/SolidWorksV3/v3_x_output_cover_1.SLDPRT
mechanical/v3/cad/parts/MG3-021_camera_pivot_spacer_0.step
mechanical/v3/SolidWorksV3/v3_x_output_cover_0.SLDPRT
mechanical/v3/cad/parts/MG3-002_X_stop_0.step
mechanical/v3/SolidWorksV3/v3_Z_stop_0.SLDPRT
mechanical/v1/cad/custom_parts/bridge_riser_0.step
mechanical/v1/cad/custom_parts/bridge_riser_1.step
mechanical/v1/cad/custom_parts/controller_tray.step
mechanical/v1/cad/custom_parts/gripper_adapter.dxf
mechanical/v1/cad/custom_parts/gripper_adapter.step
mechanical/v1/cad/custom_parts/wrist_bearing_housing.step
mechanical/v1/cad/custom_parts/wrist_lower_plate.step
mechanical/v1/cad/custom_parts/wrist_side_0.step
mechanical/v1/cad/custom_parts/wrist_side_1.step
mechanical/v1/cad/custom_parts/wrist_top_plate.step
mechanical/v1/cad/custom_parts/x_z_carrier.step
mechanical/v1/cad/custom_parts/y_end_plate_0.step
mechanical/v1/cad/custom_parts/y_end_plate_1.step
mechanical/v1/cad/custom_parts/z_block_spacer_0_0.step
mechanical/v1/cad/custom_parts/z_block_spacer_0_1.step
mechanical/v1/cad/custom_parts/z_block_spacer_1_0.step
mechanical/v1/cad/custom_parts/z_block_spacer_1_1.step
mechanical/v1/cad/custom_parts/z_motor_mount.dxf
mechanical/v1/cad/custom_parts/z_motor_mount.step
mechanical/v1/cad/custom_parts/z_motor_standoff_0.step
mechanical/v1/cad/custom_parts/z_motor_standoff_1.step
mechanical/v1/cad/custom_parts/z_nut_rear_flange.step
mechanical/v1/cad/mini_gantry_v1.step
mechanical/v1/cad/mini_gantry_v1.stl
mechanical/v2/SolidWorks/camera_removable_panel.SLDPRT
mechanical/v2/SolidWorks/compute_combo_plate.SLDPRT
mechanical/v2/SolidWorks/gripper_adapter.SLDPRT
mechanical/v2/SolidWorks/mini_gantry_v2.SLDASM
mechanical/v2/SolidWorks/module_XY.SLDPRT
mechanical/v2/SolidWorks/module_XYZ.SLDPRT
mechanical/v2/SolidWorks/module_Y.SLDPRT
mechanical/v2/SolidWorks/module_fixed.SLDPRT
mechanical/v2/SolidWorks/z_motor_mount.SLDPRT
mechanical/v2/SolidWorksV21/mini_gantry_v2_1.SLDASM
mechanical/v2/SolidWorksV21/v21_camera_removable_panel.SLDPRT
mechanical/v2/SolidWorksV21/v21_compute_combo_plate.SLDPRT
mechanical/v2/SolidWorksV21/v21_gripper_adapter.SLDPRT
mechanical/v2/SolidWorksV21/v21_module_XY.SLDPRT
mechanical/v2/SolidWorksV21/v21_module_XYZ.SLDPRT
mechanical/v2/SolidWorksV21/v21_module_Y.SLDPRT
mechanical/v2/SolidWorksV21/v21_module_fixed.SLDPRT
mechanical/v2/SolidWorksV21/v21_x_motor_bracket.SLDPRT
mechanical/v2/SolidWorksV21/v21_y_motor_bracket.SLDPRT
mechanical/v2/SolidWorksV21/v21_z_motor_lower_saddle.SLDPRT
mechanical/v2/SolidWorksV21/v21_z_motor_mount.SLDPRT
mechanical/v2/SolidWorksV21/v21_z_motor_standoff_0.SLDPRT
mechanical/v2/SolidWorksV21/v21_z_motor_standoff_1.SLDPRT
mechanical/v2/SolidWorksV22/mini_gantry_v2_2.SLDASM
mechanical/v2/SolidWorksV22/v22_camera_removable_panel.SLDPRT
mechanical/v2/SolidWorksV22/v22_compute_combo_plate.SLDPRT
mechanical/v2/SolidWorksV22/v22_gripper_adapter.SLDPRT
mechanical/v2/SolidWorksV22/v22_module_XY.SLDPRT
mechanical/v2/SolidWorksV22/v22_module_XYZ.SLDPRT
mechanical/v2/SolidWorksV22/v22_module_Y.SLDPRT
mechanical/v2/SolidWorksV22/v22_module_fixed.SLDPRT
mechanical/v2/SolidWorksV22/v22_x_motor_bracket.SLDPRT
mechanical/v2/SolidWorksV22/v22_y_motor_bracket.SLDPRT
mechanical/v2/SolidWorksV22/v22_z_brake_reserve.SLDPRT
mechanical/v2/SolidWorksV22/v22_z_coupling_center_ENVELOPE.SLDPRT
mechanical/v2/SolidWorksV22/v22_z_coupling_motor_hub.SLDPRT
mechanical/v2/SolidWorksV22/v22_z_coupling_screw_hub.SLDPRT
mechanical/v2/SolidWorksV22/v22_z_motor_lower_saddle.SLDPRT
mechanical/v2/SolidWorksV22/v22_z_motor_mount.SLDPRT
mechanical/v2/SolidWorksV22/v22_z_motor_standoff_0.SLDPRT
mechanical/v2/SolidWorksV22/v22_z_motor_standoff_1.SLDPRT
mechanical/v2/SolidWorksV22/v22_z_screw_1605.SLDPRT
mechanical/v2/SolidWorksV22/v22_z_screw_locknut.SLDPRT
mechanical/v2/SolidWorksV22/v22_z_screw_support_0.SLDPRT
mechanical/v2/SolidWorksV22/v22_z_screw_support_1.SLDPRT
mechanical/v2/SolidWorksV23/mini_gantry_v2_3.SLDASM
mechanical/v2/SolidWorksV23/v23_camera_removable_panel.SLDPRT
mechanical/v2/SolidWorksV23/v23_compute_combo_plate.SLDPRT
mechanical/v2/SolidWorksV23/v23_gripper_adapter.SLDPRT
mechanical/v2/SolidWorksV23/v23_module_XY.SLDPRT
mechanical/v2/SolidWorksV23/v23_module_XYZ.SLDPRT
mechanical/v2/SolidWorksV23/v23_module_Y.SLDPRT
mechanical/v2/SolidWorksV23/v23_module_fixed.SLDPRT
mechanical/v2/SolidWorksV23/v23_x_main_pulley_set_screw.SLDPRT
mechanical/v2/SolidWorksV23/v23_x_motor_bracket.SLDPRT
mechanical/v2/SolidWorksV23/v23_x_output_bearing_0.SLDPRT
mechanical/v2/SolidWorksV23/v23_x_output_bearing_1.SLDPRT
mechanical/v2/SolidWorksV23/v23_x_output_collar_0.SLDPRT
mechanical/v2/SolidWorksV23/v23_x_output_collar_1.SLDPRT
mechanical/v2/SolidWorksV23/v23_x_output_cover_0.SLDPRT
mechanical/v2/SolidWorksV23/v23_x_output_cover_1.SLDPRT
mechanical/v2/SolidWorksV23/v23_x_output_spacer_0.SLDPRT
mechanical/v2/SolidWorksV23/v23_x_output_spacer_1.SLDPRT
mechanical/v2/SolidWorksV23/v23_x_output_spacer_2.SLDPRT
mechanical/v2/SolidWorksV23/v23_x_output_spacer_3.SLDPRT
mechanical/v2/SolidWorksV23/v23_x_output_spacer_4.SLDPRT
mechanical/v2/SolidWorksV23/v23_x_pulley_axle_0.SLDPRT
mechanical/v2/SolidWorksV23/v23_x_pulley_mount_0.SLDPRT
mechanical/v2/SolidWorksV23/v23_x_reduction_belt.SLDPRT
mechanical/v2/SolidWorksV23/v23_x_reduction_driven_pulley.SLDPRT
mechanical/v2/SolidWorksV23/v23_x_reduction_driven_set_screw.SLDPRT
mechanical/v2/SolidWorksV23/v23_x_reduction_input_pulley.SLDPRT
mechanical/v2/SolidWorksV23/v23_x_reduction_input_set_screw.SLDPRT
mechanical/v2/SolidWorksV23/v23_y_main_pulley_set_screw_0.SLDPRT
mechanical/v2/SolidWorksV23/v23_y_main_pulley_set_screw_1.SLDPRT
mechanical/v2/SolidWorksV23/v23_y_motor_bracket.SLDPRT
mechanical/v2/SolidWorksV23/v23_y_rear_bearing_0.SLDPRT
mechanical/v2/SolidWorksV23/v23_y_rear_bearing_1.SLDPRT
mechanical/v2/SolidWorksV23/v23_y_rear_collar_0.SLDPRT
mechanical/v2/SolidWorksV23/v23_y_rear_collar_1.SLDPRT
mechanical/v2/SolidWorksV23/v23_y_rear_cover_0.SLDPRT
mechanical/v2/SolidWorksV23/v23_y_rear_cover_1.SLDPRT
mechanical/v2/SolidWorksV23/v23_y_rear_spacer_0_0.SLDPRT
mechanical/v2/SolidWorksV23/v23_y_rear_spacer_0_1.SLDPRT
mechanical/v2/SolidWorksV23/v23_y_rear_spacer_1_0.SLDPRT
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
