Not1Fun/mini-gantry/mechanical/v3/drawings/manufacturing.pdf

# MG3-001 X_bumper_0

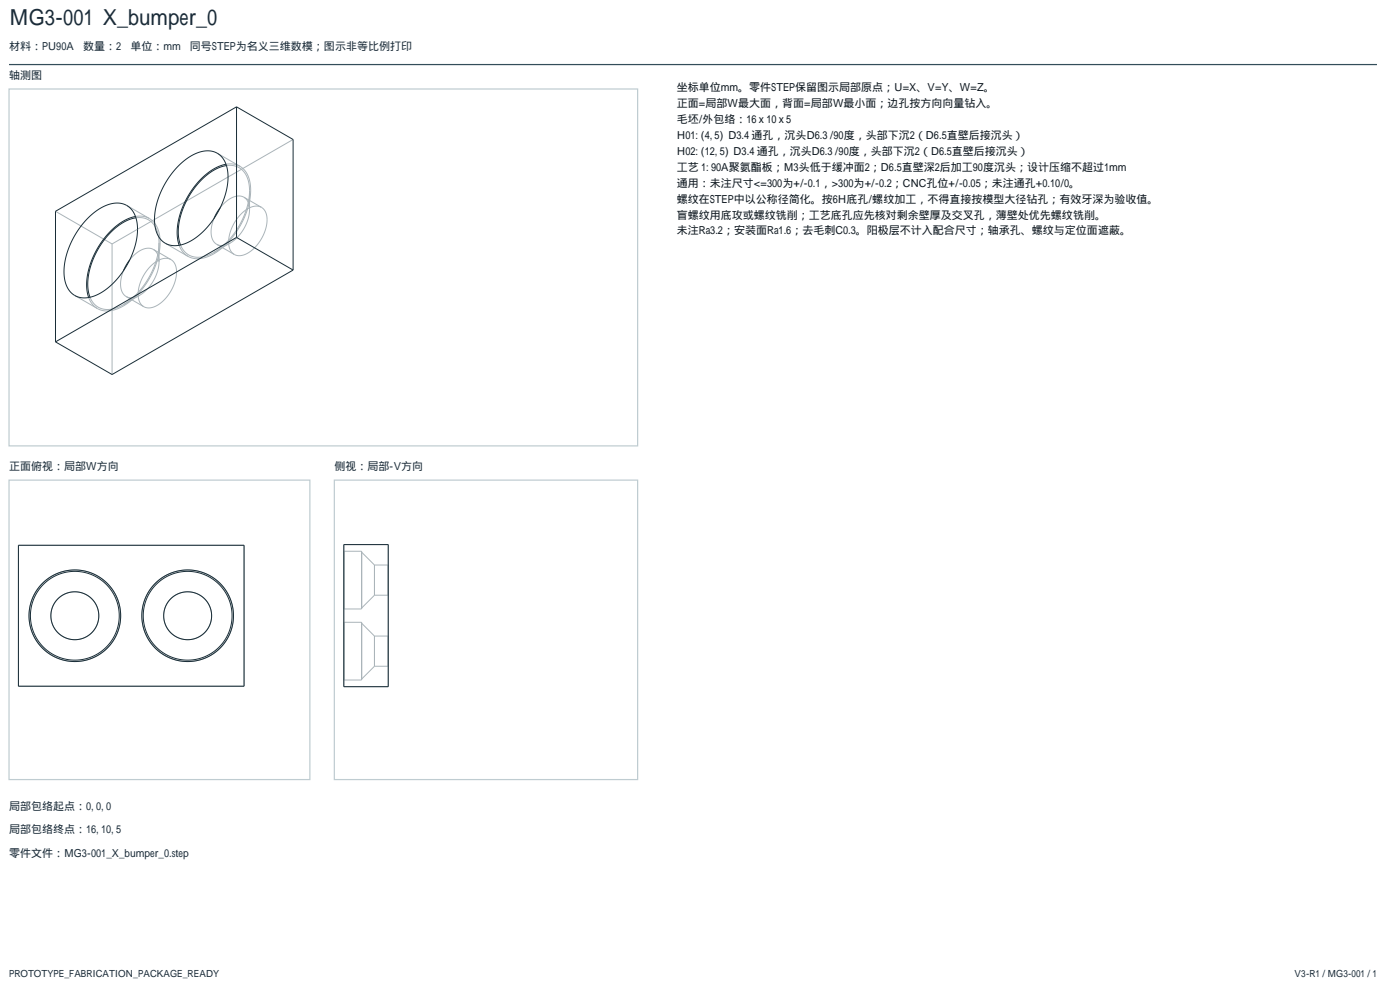
[picture p114: page 1]
PROTOTYPE_FABRICATION_PACKAGE_READY; 轴测图; 正面俯视：局部W方向; 侧视：局部-V方向; 局部包络起点：0, 0, 0; 局部包络终点：16, 10, 5; 零件文件：MG3-001_X_bumper_0.step

材料：PU90A 数量：2 单位：mm 同号STEP为名义三维数模；图示非等比例打印

坐标单位mm。零件STEP保留图示局部原点；U=X、V=Y、W=Z。
正面=局部W最大面，背面=局部W最小面；边孔按方向向量钻入。
毛坯/外包络：16 x 10 x 5
H01: (4, 5) D3.4 通孔，沉头D6.3 /90度，头部下沉2（D6.5直壁后接沉头）
H02: (12, 5) D3.4 通孔，沉头D6.3 /90度，头部下沉2（D6.5直壁后接沉头）
工艺 1: 90A聚氨酯板；M3头低于缓冲面2；D6.5直壁深2后加工90度沉头；设计压缩不超过1mm
通用：未注尺寸<=300为+/-0.1，>300为+/-0.2；CNC孔位+/-0.05；未注通孔+0.10/0。
螺纹在STEP中以公称径简化。按6H底孔/螺纹加工，不得直接按模型大径钻孔；有效牙深为验收值。
盲螺纹用底攻或螺纹铣削；工艺底孔应先核对剩余壁厚及交叉孔，薄壁处优先螺纹铣削。
未注Ra3.2；安装面Ra1.6；去毛刺C0.3。阳极层不计入配合尺寸；轴承孔、螺纹与定位面遮蔽。

# MG3-002 X_stop_0

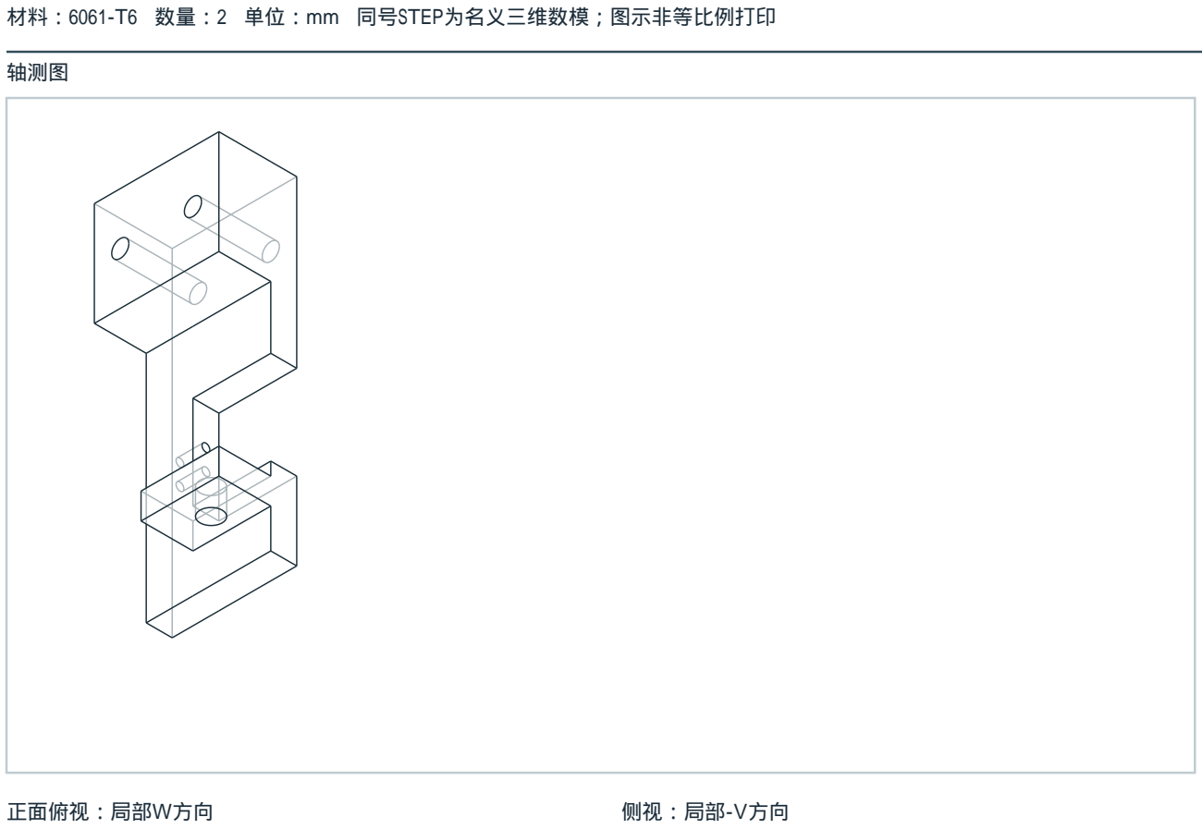
[picture p115: figure]
材料：6061-T6 数量：2 单位：mm 同号STEP为名义三维数模；图示非等比例打印; 轴测图; 正面俯视：局部W方向; 侧视：局部-V方向
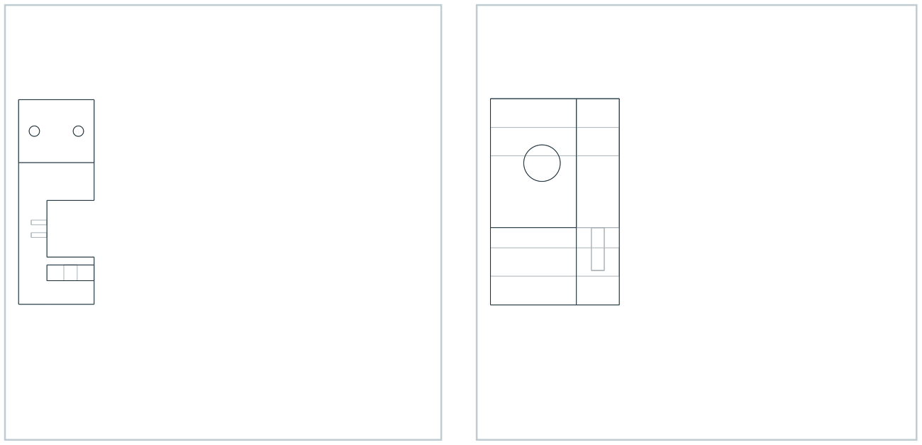
[picture p116: figure]

局部包络起点：0, 0, 0

局部包络终点：48, 130, 30

零件文件：MG3-002_X_stop_0.step

坐标单位mm。零件STEP保留图示局部原点；U=X、V=Y、W=Z。 正面=局部W最大面，背面=局部W最小面；边孔按方向向量钻入。 毛坯并体[x,y,z,dx,dy,dz]: [[0,0,0,18,130,10],[18,66,0,30,64,10],[0,90,10,48,40,20],[18,0,0,30,30,10],[18,15,10,30,10,20]] 加工特征 1: {"point":[10,110,0],"direction":[0,0,1],"diameter":6.6,"depth":30}
加工特征 2: {"point":[38,110,0],"direction":[0,0,1],"diameter":6.6,"depth":30}
加工特征 3: {"point":[33,15,18],"direction":[0,1,0],"diameter":8.5,"depth":10,"note":"M8传感器孔；触发位置装配标定"} 加工特征 4: {"point":[18,44,5],"direction":[-1,0,0],"diameter":3,"depth":10,"thread":"M3"}
加工特征 5: {"point":[18,52,5],"direction":[-1,0,0],"diameter":3,"depth":10,"thread":"M3"}
工艺 1: 左金属止挡面X100，右X800；配5mm聚氨酯垫，首次接触TCP185/715，金属极限180/720
工艺 2: 正常工作TCP200~700；限位名义195/705；首次上电标定实际触发位置，保证到软垫至少8mm制动距离 工艺 3: 3D STEP给定未标注轮廓；孔位+/-0.05，垂直度0.05/100；内角允许R2，接触/安装面Ra1.6 通用：未注尺寸<=300为+/-0.1，>300为+/-0.2；CNC孔位+/-0.05；未注通孔+0.10/0。 螺纹在STEP中以公称径简化。按6H底孔/螺纹加工，不得直接按模型大径钻孔；有效牙深为验收值。 盲螺纹用底攻或螺纹铣削；工艺底孔应先核对剩余壁厚及交叉孔，薄壁处优先螺纹铣削。 未注Ra3.2；安装面Ra1.6；去毛刺C0.3。阳极层不计入配合尺寸；轴承孔、螺纹与定位面遮蔽。

# MG3-003 X_target_0

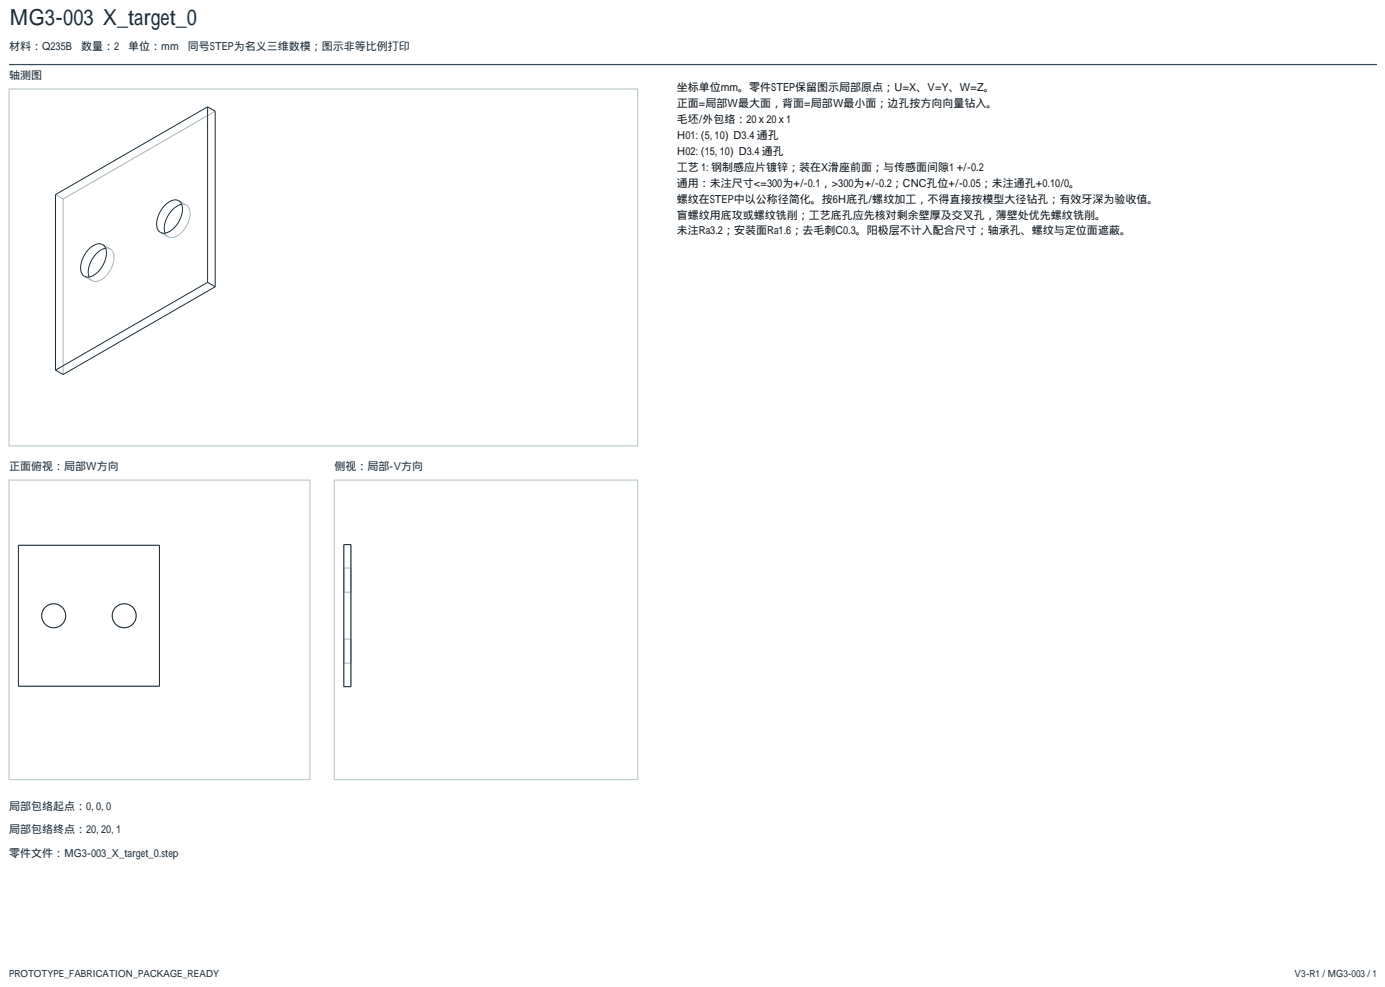
[picture p117: page 3]
轴测图; 正面俯视：局部W方向; 侧视：局部-V方向; 局部包络起点：0, 0, 0; 局部包络终点：20, 20, 1; 零件文件：MG3-003_X_target_0.step

材料：Q235B 数量：2 单位：mm 同号STEP为名义三维数模；图示非等比例打印

坐标单位mm。零件STEP保留图示局部原点；U=X、V=Y、W=Z。
正面=局部W最大面，背面=局部W最小面；边孔按方向向量钻入。
毛坯/外包络：20 x 20 x 1
工艺 1: 钢制感应片镀锌；装在X滑座前面；与传感面间隙1 +/-0.2
通用：未注尺寸<=300为+/-0.1，>300为+/-0.2；CNC孔位+/-0.05；未注通孔+0.10/0。
螺纹在STEP中以公称径简化。按6H底孔/螺纹加工，不得直接按模型大径钻孔；有效牙深为验收值。
盲螺纹用底攻或螺纹铣削；工艺底孔应先核对剩余壁厚及交叉孔，薄壁处优先螺纹铣削。
未注Ra3.2；安装面Ra1.6；去毛刺C0.3。阳极层不计入配合尺寸；轴承孔、螺纹与定位面遮蔽。

# MG3-004 Y_bumper_0_0

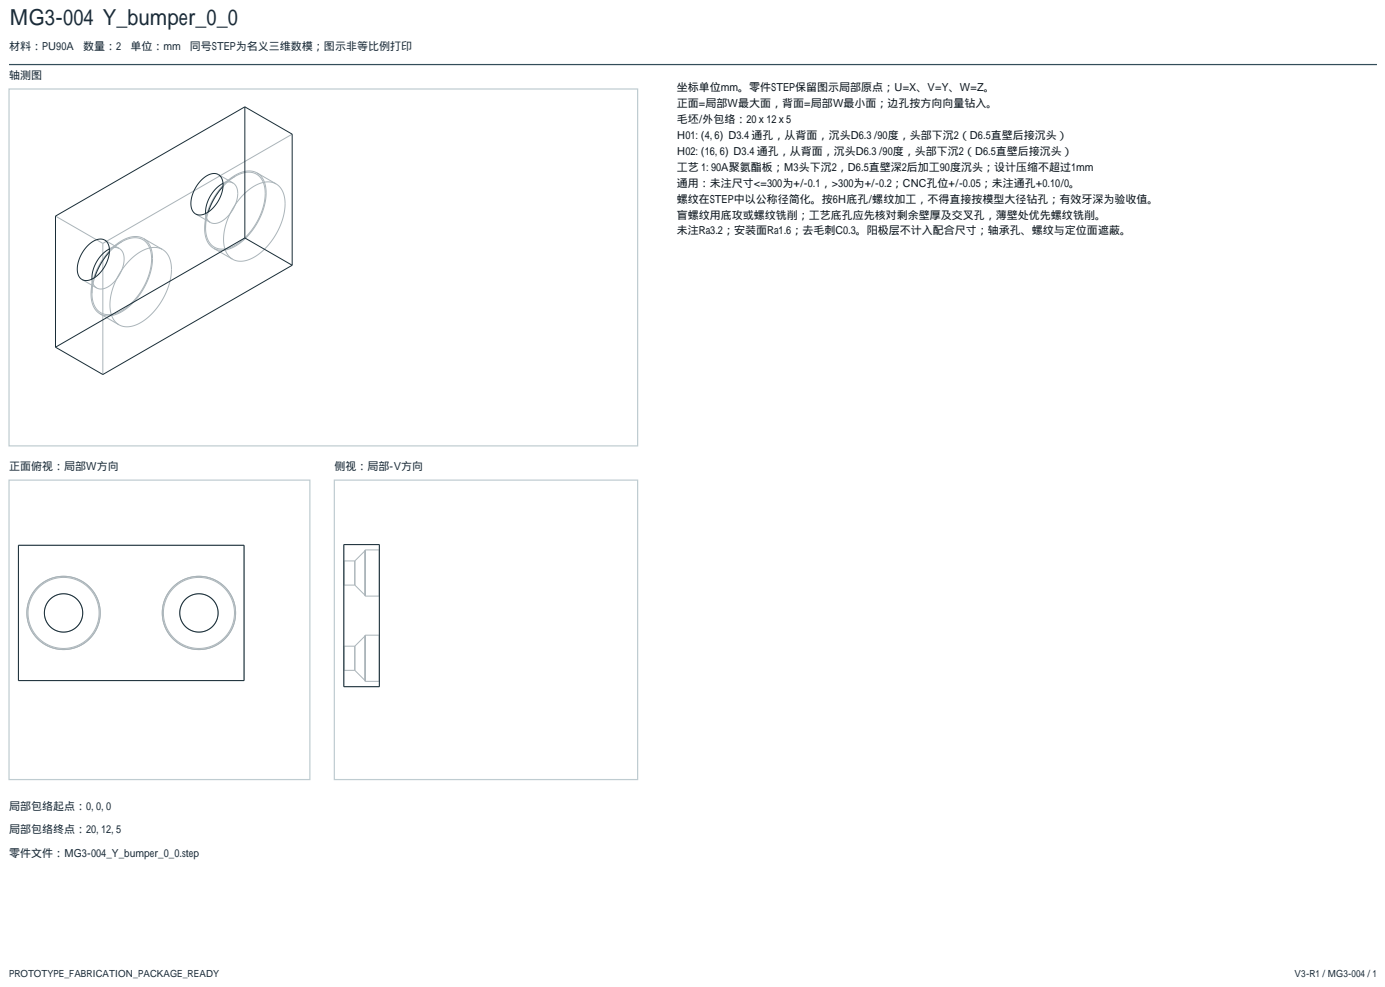
[picture p118: page 4]
轴测图; 正面俯视：局部W方向; 侧视：局部-V方向; 局部包络起点：0, 0, 0; 局部包络终点：20, 12, 5; 零件文件：MG3-004_Y_bumper_0_0.step

材料：PU90A 数量：2 单位：mm 同号STEP为名义三维数模；图示非等比例打印

坐标单位mm。零件STEP保留图示局部原点；U=X、V=Y、W=Z。
正面=局部W最大面，背面=局部W最小面；边孔按方向向量钻入。
毛坯/外包络：20 x 12 x 5
H01: (4, 6) D3.4 通孔，从背面，沉头D6.3 /90度，头部下沉2（D6.5直壁后接沉头）
H02: (16, 6) D3.4 通孔，从背面，沉头D6.3 /90度，头部下沉2（D6.5直壁后接沉头）
工艺 1: 90A聚氨酯板；M3头下沉2，D6.5直壁深2后加工90度沉头；设计压缩不超过1mm
通用：未注尺寸<=300为+/-0.1，>300为+/-0.2；CNC孔位+/-0.05；未注通孔+0.10/0。
螺纹在STEP中以公称径简化。按6H底孔/螺纹加工，不得直接按模型大径钻孔；有效牙深为验收值。
盲螺纹用底攻或螺纹铣削；工艺底孔应先核对剩余壁厚及交叉孔，薄壁处优先螺纹铣削。
未注Ra3.2；安装面Ra1.6；去毛刺C0.3。阳极层不计入配合尺寸；轴承孔、螺纹与定位面遮蔽。

# MG3-005 Y_bumper_0_1

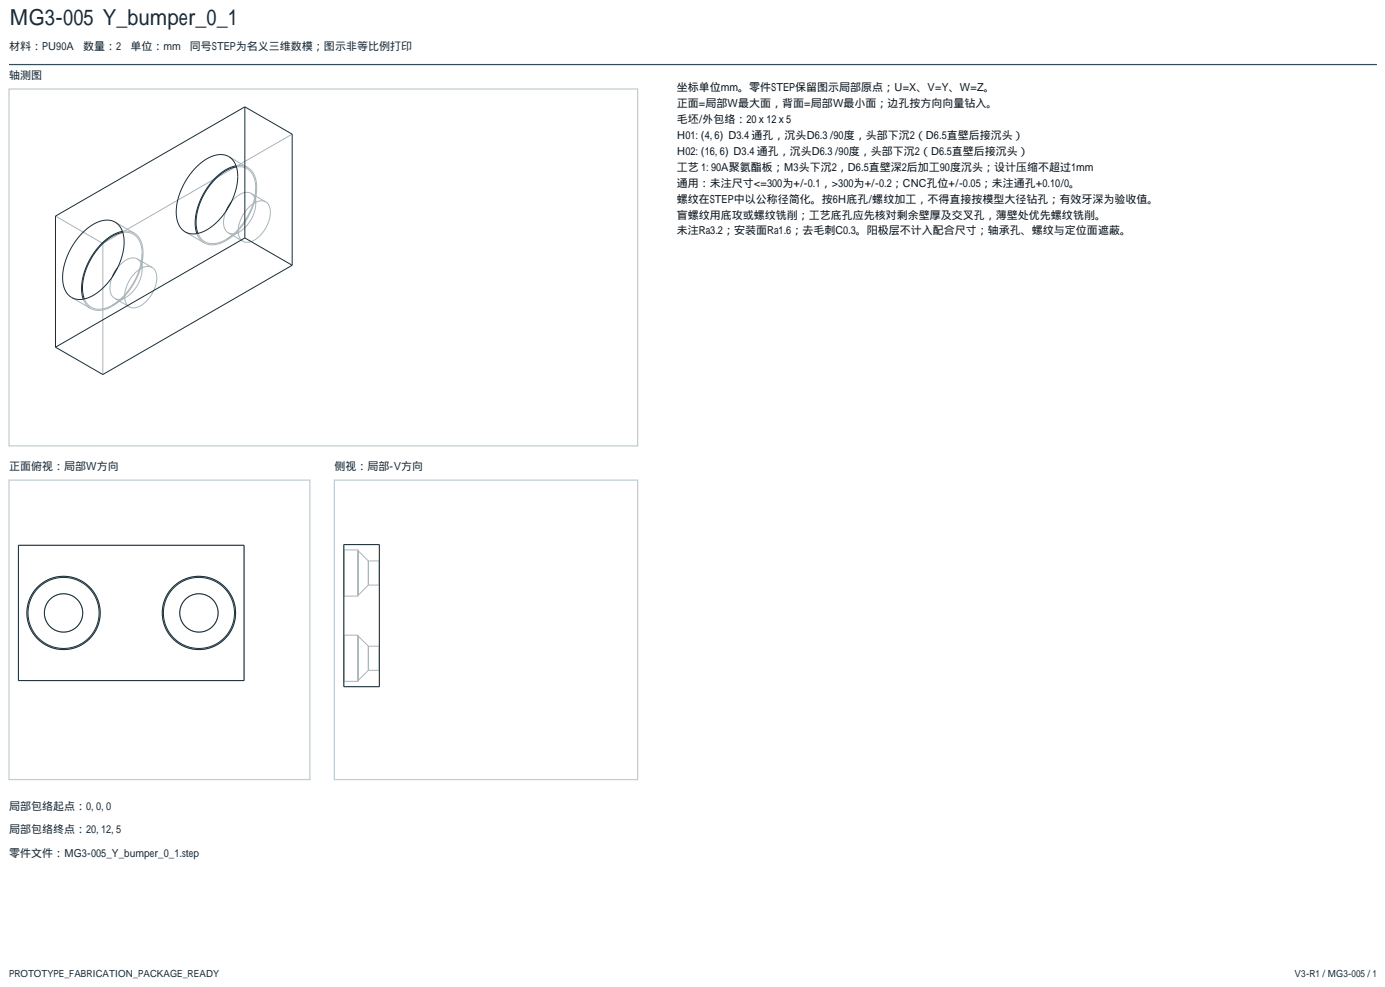
[picture p119: page 5]
轴测图; 正面俯视：局部W方向; 侧视：局部-V方向; 局部包络起点：0, 0, 0; 局部包络终点：20, 12, 5; 零件文件：MG3-005_Y_bumper_0_1.step

材料：PU90A 数量：2 单位：mm 同号STEP为名义三维数模；图示非等比例打印

坐标单位mm。零件STEP保留图示局部原点；U=X、V=Y、W=Z。
正面=局部W最大面，背面=局部W最小面；边孔按方向向量钻入。
毛坯/外包络：20 x 12 x 5
H01: (4, 6) D3.4 通孔，沉头D6.3 /90度，头部下沉2（D6.5直壁后接沉头）
H02: (16, 6) D3.4 通孔，沉头D6.3 /90度，头部下沉2（D6.5直壁后接沉头）
工艺 1: 90A聚氨酯板；M3头下沉2，D6.5直壁深2后加工90度沉头；设计压缩不超过1mm
通用：未注尺寸<=300为+/-0.1，>300为+/-0.2；CNC孔位+/-0.05；未注通孔+0.10/0。
螺纹在STEP中以公称径简化。按6H底孔/螺纹加工，不得直接按模型大径钻孔；有效牙深为验收值。
盲螺纹用底攻或螺纹铣削；工艺底孔应先核对剩余壁厚及交叉孔，薄壁处优先螺纹铣削。
未注Ra3.2；安装面Ra1.6；去毛刺C0.3。阳极层不计入配合尺寸；轴承孔、螺纹与定位面遮蔽。

# MG3-006 Y_sensor_mount_0

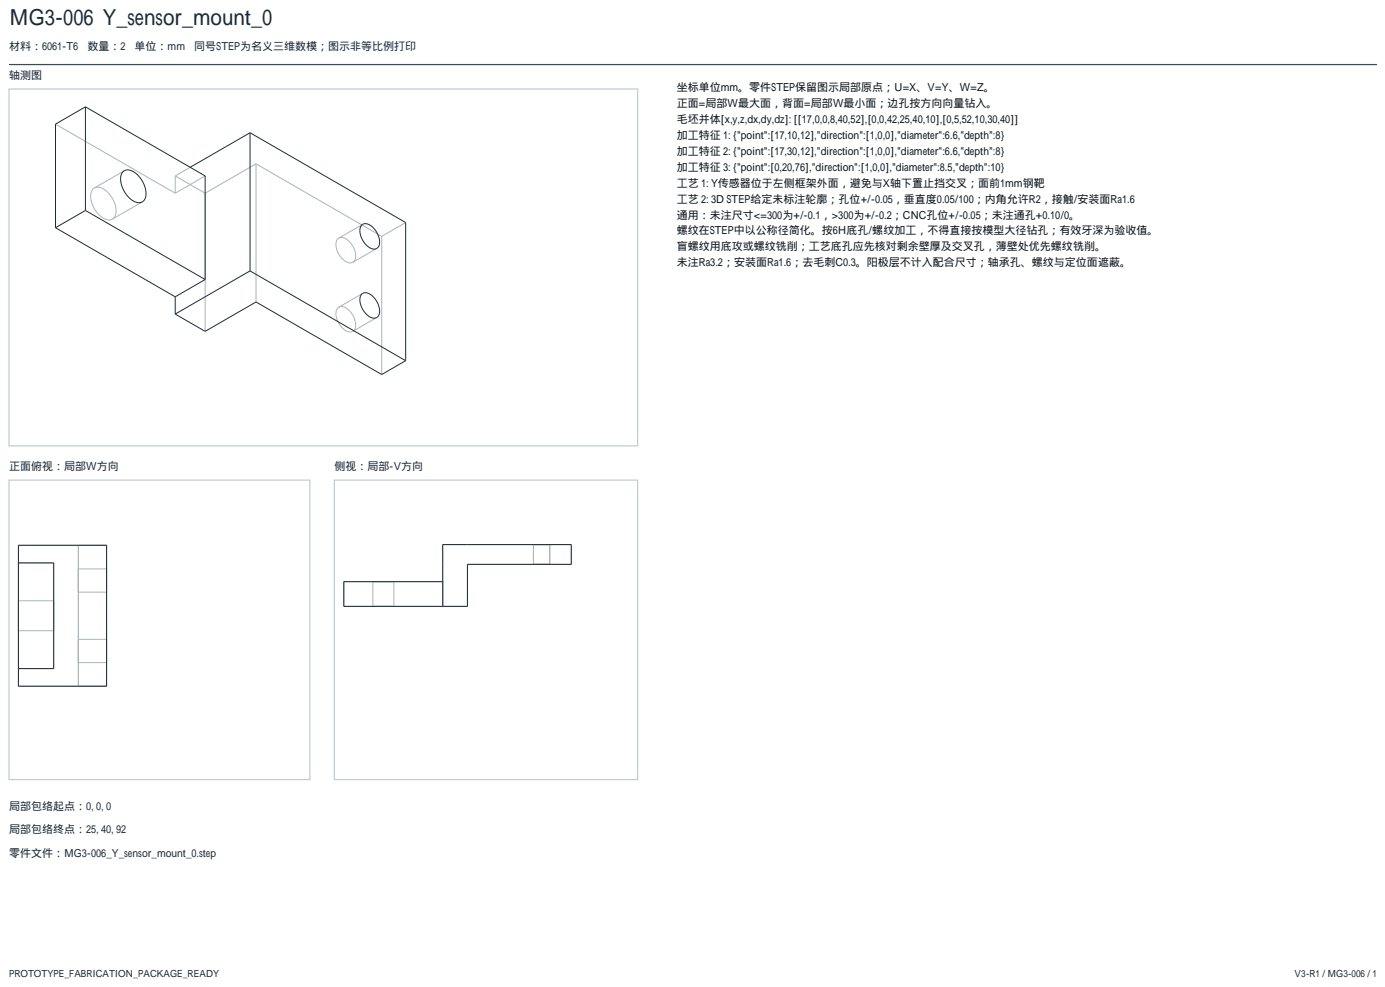
[picture p120: page 6]
轴测图; 正面俯视：局部W方向; 侧视：局部-V方向; 局部包络起点：0, 0, 0; 局部包络终点：25, 40, 92; 零件文件：MG3-006_Y_sensor_mount_0.step

材料：6061-T6 数量：2 单位：mm 同号STEP为名义三维数模；图示非等比例打印

坐标单位mm。零件STEP保留图示局部原点；U=X、V=Y、W=Z。
正面=局部W最大面，背面=局部W最小面；边孔按方向向量钻入。
毛坯并体[x,y,z,dx,dy,dz]: [[17,0,0,8,40,52],[0,0,42,25,40,10],[0,5,52,10,30,40]]
加工特征 1: {"point":[17,10,12],"direction":[1,0,0],"diameter":6.6,"depth":8}
加工特征 2: {"point":[17,30,12],"direction":[1,0,0],"diameter":6.6,"depth":8}
加工特征 3: {"point":[0,20,76],"direction":[1,0,0],"diameter":8.5,"depth":10}
工艺 1: Y传感器位于左侧框架外面，避免与X轴下置止挡交叉；面前1mm钢靶
工艺 2: 3D STEP给定未标注轮廓；孔位+/-0.05，垂直度0.05/100；内角允许R2，接触/安装面Ra1.6
通用：未注尺寸<=300为+/-0.1，>300为+/-0.2；CNC孔位+/-0.05；未注通孔+0.10/0。
螺纹在STEP中以公称径简化。按6H底孔/螺纹加工，不得直接按模型大径钻孔；有效牙深为验收值。
盲螺纹用底攻或螺纹铣削；工艺底孔应先核对剩余壁厚及交叉孔，薄壁处优先螺纹铣削。
未注Ra3.2；安装面Ra1.6；去毛刺C0.3。阳极层不计入配合尺寸；轴承孔、螺纹与定位面遮蔽。

# MG3-007 Y_stop_0_0

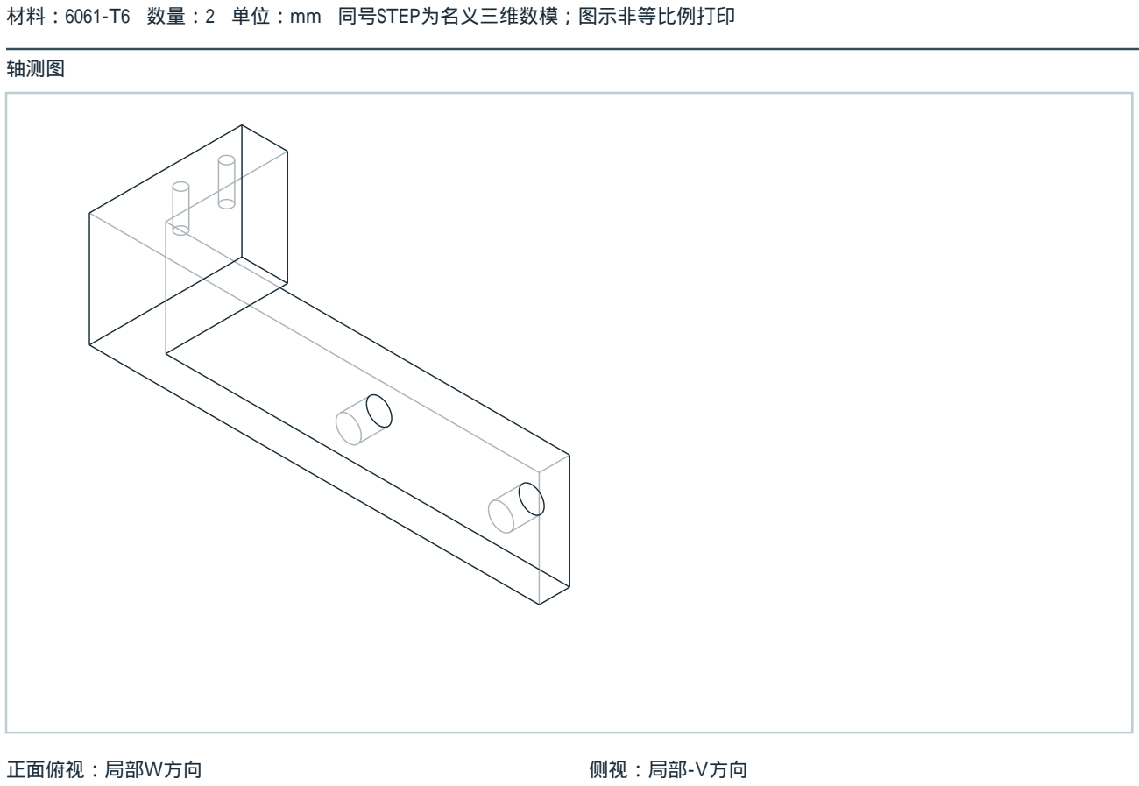
[picture p121: figure]
材料：6061-T6 数量：2 单位：mm 同号STEP为名义三维数模；图示非等比例打印; 轴测图; 正面俯视：局部W方向; 侧视：局部-V方向

局部包络起点：0, 0, 0

局部包络终点：40, 30, 118

零件文件：MG3-007_Y_stop_0_0.step

坐标单位mm。零件STEP保留图示局部原点；U=X、V=Y、W=Z。 正面=局部W最大面，背面=局部W最小面；边孔按方向向量钻入。 毛坯并体[x,y,z,dx,dy,dz]: [[0,0,0,8,30,118],[8,0,106,32,30,12]]
加工特征 1: {"point":[0,15,10],"direction":[1,0,0],"diameter":6.6,"depth":8}
加工特征 2: {"point":[0,15,50],"direction":[1,0,0],"diameter":6.6,"depth":8}
加工特征 3: {"point":[18,30,112],"direction":[0,-1,0],"diameter":3,"depth":10,"thread":"M3"}
加工特征 4: {"point":[30,30,112],"direction":[0,-1,0],"diameter":3,"depth":10,"thread":"M3"}
工艺 1: 金属面Y135/865，TCP极限130/670；5mm垫首次接触135/665
工艺 2: 正常工作150~650；名义限位145/655；Y轴两侧止挡必须调至同时接触，误差不大于0.2
工艺 3: 3D STEP给定未标注轮廓；孔位+/-0.05，垂直度0.05/100；内角允许R2，接触/安装面Ra1.6 通用：未注尺寸<=300为+/-0.1，>300为+/-0.2；CNC孔位+/-0.05；未注通孔+0.10/0。 螺纹在STEP中以公称径简化。按6H底孔/螺纹加工，不得直接按模型大径钻孔；有效牙深为验收值。 盲螺纹用底攻或螺纹铣削；工艺底孔应先核对剩余壁厚及交叉孔，薄壁处优先螺纹铣削。 未注Ra3.2；安装面Ra1.6；去毛刺C0.3。阳极层不计入配合尺寸；轴承孔、螺纹与定位面遮蔽。

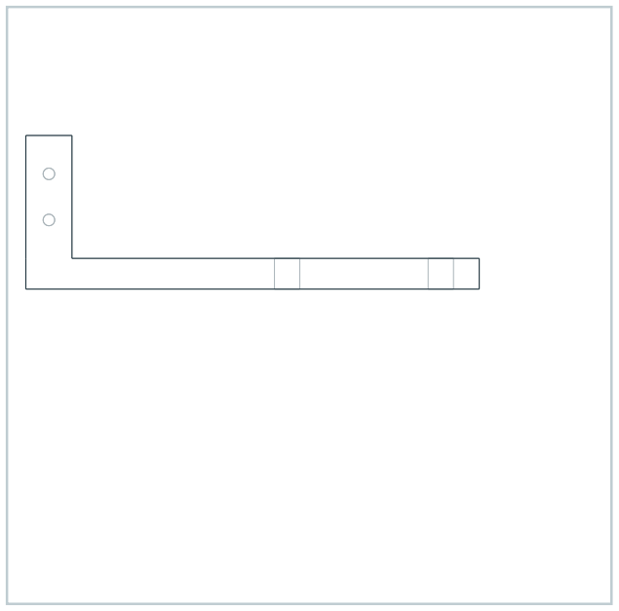
[picture p122: figure]

# MG3-008 Y_stop_0_1

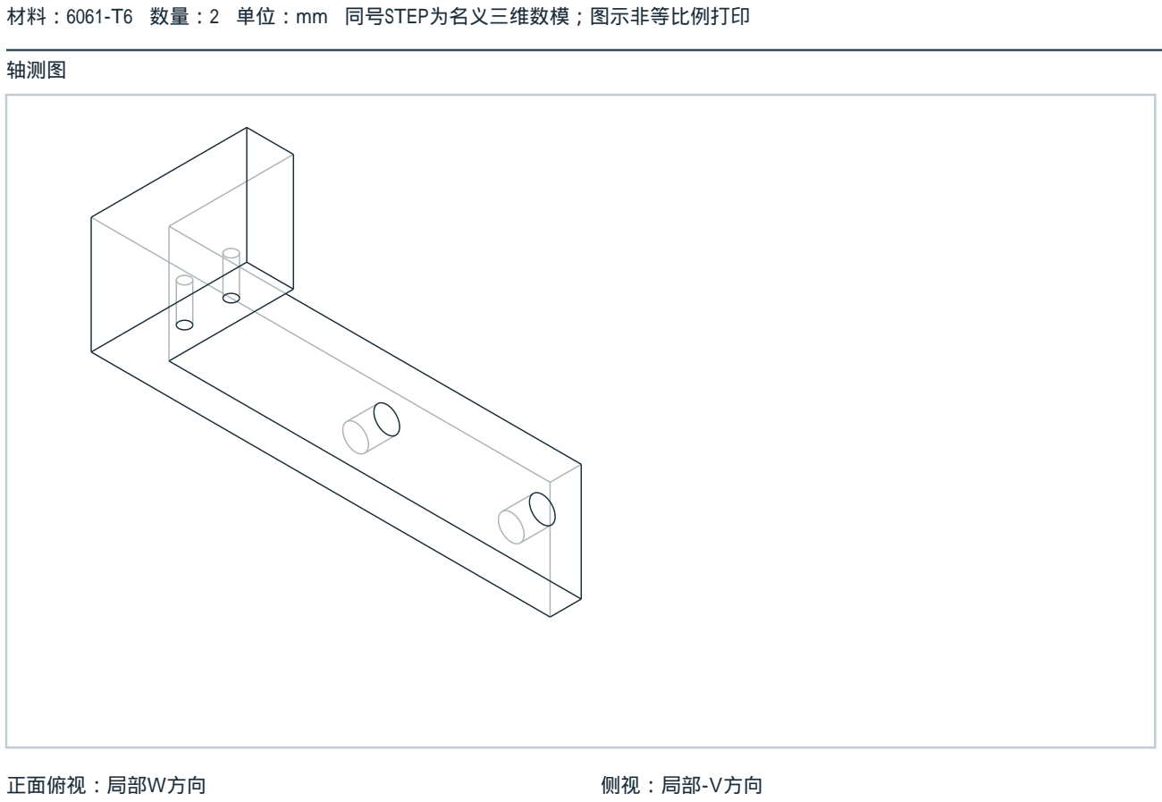
[picture p123: figure]
材料：6061-T6 数量：2 单位：mm 同号STEP为名义三维数模；图示非等比例打印; 轴测图; 正面俯视：局部W方向; 侧视：局部-V方向

局部包络起点：0, 0, 0

局部包络终点：40, 30, 118

零件文件：MG3-008_Y_stop_0_1.step

坐标单位mm。零件STEP保留图示局部原点；U=X、V=Y、W=Z。 正面=局部W最大面，背面=局部W最小面；边孔按方向向量钻入。 毛坯并体[x,y,z,dx,dy,dz]: [[0,0,0,8,30,118],[8,0,106,32,30,12]]
加工特征 1: {"point":[0,15,10],"direction":[1,0,0],"diameter":6.6,"depth":8}
加工特征 2: {"point":[0,15,50],"direction":[1,0,0],"diameter":6.6,"depth":8}
加工特征 3: {"point":[18,0,112],"direction":[0,1,0],"diameter":3,"depth":10,"thread":"M3"}
加工特征 4: {"point":[30,0,112],"direction":[0,1,0],"diameter":3,"depth":10,"thread":"M3"}
工艺 1: 金属面Y135/865，TCP极限130/670；5mm垫首次接触135/665
工艺 2: 正常工作150~650；名义限位145/655；Y轴两侧止挡必须调至同时接触，误差不大于0.2
工艺 3: 3D STEP给定未标注轮廓；孔位+/-0.05，垂直度0.05/100；内角允许R2，接触/安装面Ra1.6 通用：未注尺寸<=300为+/-0.1，>300为+/-0.2；CNC孔位+/-0.05；未注通孔+0.10/0。 螺纹在STEP中以公称径简化。按6H底孔/螺纹加工，不得直接按模型大径钻孔；有效牙深为验收值。 盲螺纹用底攻或螺纹铣削；工艺底孔应先核对剩余壁厚及交叉孔，薄壁处优先螺纹铣削。 未注Ra3.2；安装面Ra1.6；去毛刺C0.3。阳极层不计入配合尺寸；轴承孔、螺纹与定位面遮蔽。

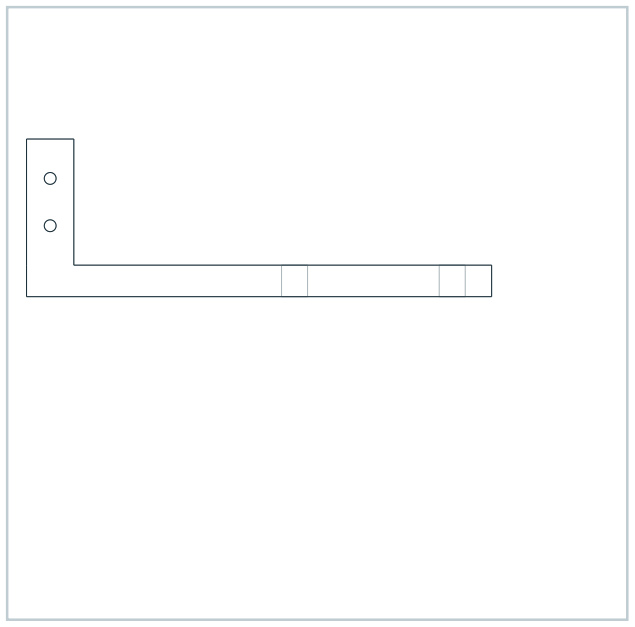
[picture p124: figure]

# MG3-009 Y_target_0

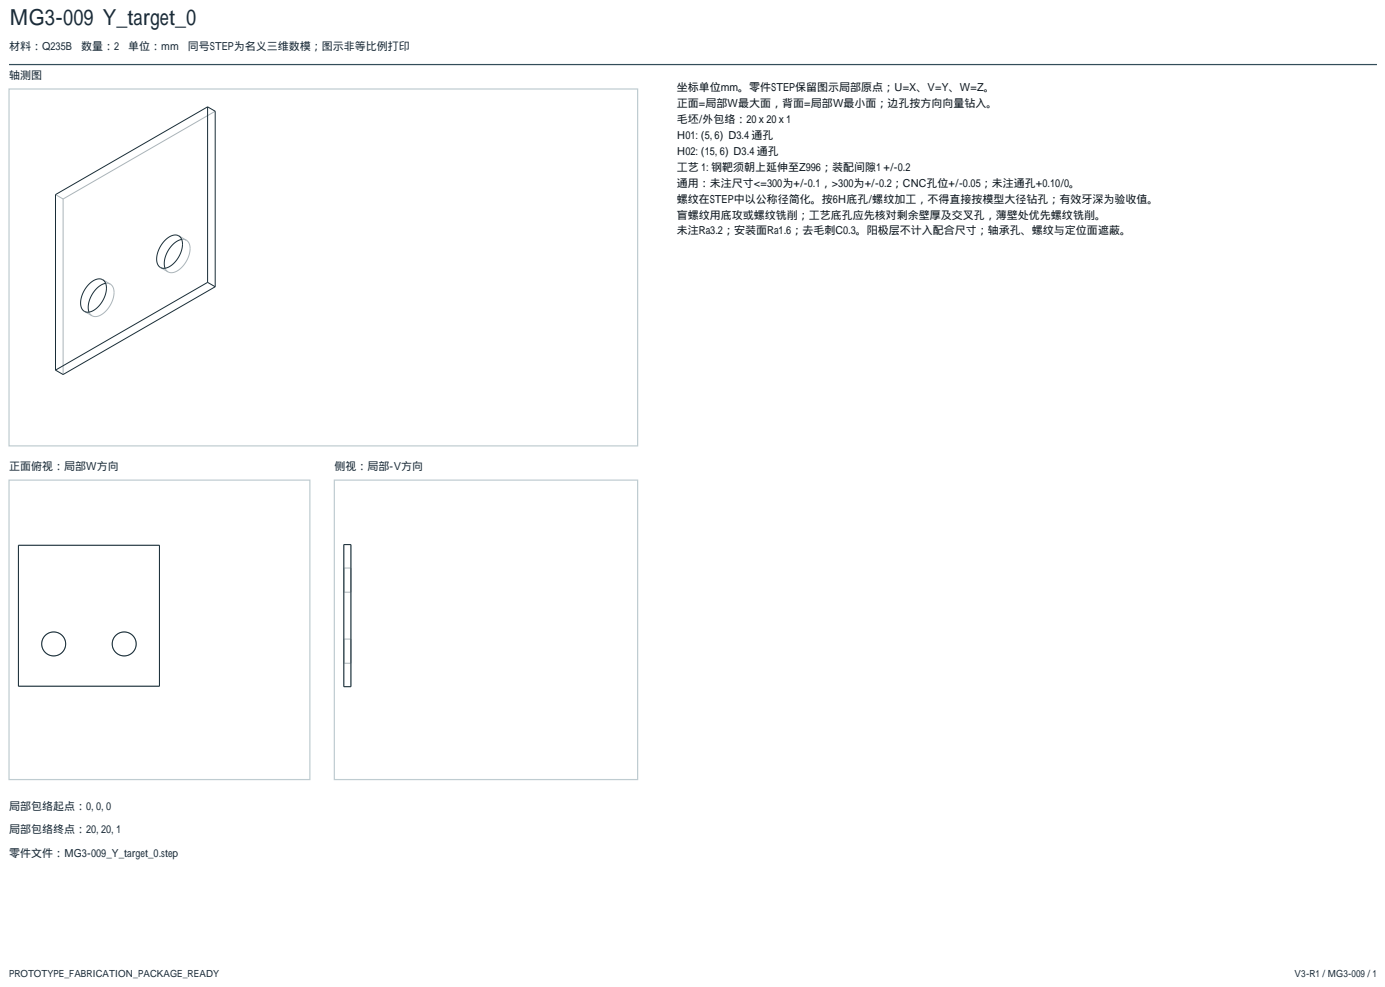
[picture p125: page 9]
轴测图; 正面俯视：局部W方向; 侧视：局部-V方向; 局部包络起点：0, 0, 0; 局部包络终点：20, 20, 1; 零件文件：MG3-009_Y_target_0.step

材料：Q235B 数量：2 单位：mm 同号STEP为名义三维数模；图示非等比例打印

坐标单位mm。零件STEP保留图示局部原点；U=X、V=Y、W=Z。
正面=局部W最大面，背面=局部W最小面；边孔按方向向量钻入。
毛坯/外包络：20 x 20 x 1
工艺 1: 钢靶须朝上延伸至Z996；装配间隙1 +/-0.2
通用：未注尺寸<=300为+/-0.1，>300为+/-0.2；CNC孔位+/-0.05；未注通孔+0.10/0。
螺纹在STEP中以公称径简化。按6H底孔/螺纹加工，不得直接按模型大径钻孔；有效牙深为验收值。
盲螺纹用底攻或螺纹铣削；工艺底孔应先核对剩余壁厚及交叉孔，薄壁处优先螺纹铣削。
未注Ra3.2；安装面Ra1.6；去毛刺C0.3。阳极层不计入配合尺寸；轴承孔、螺纹与定位面遮蔽。

# MG3-010 Z_bumper_0

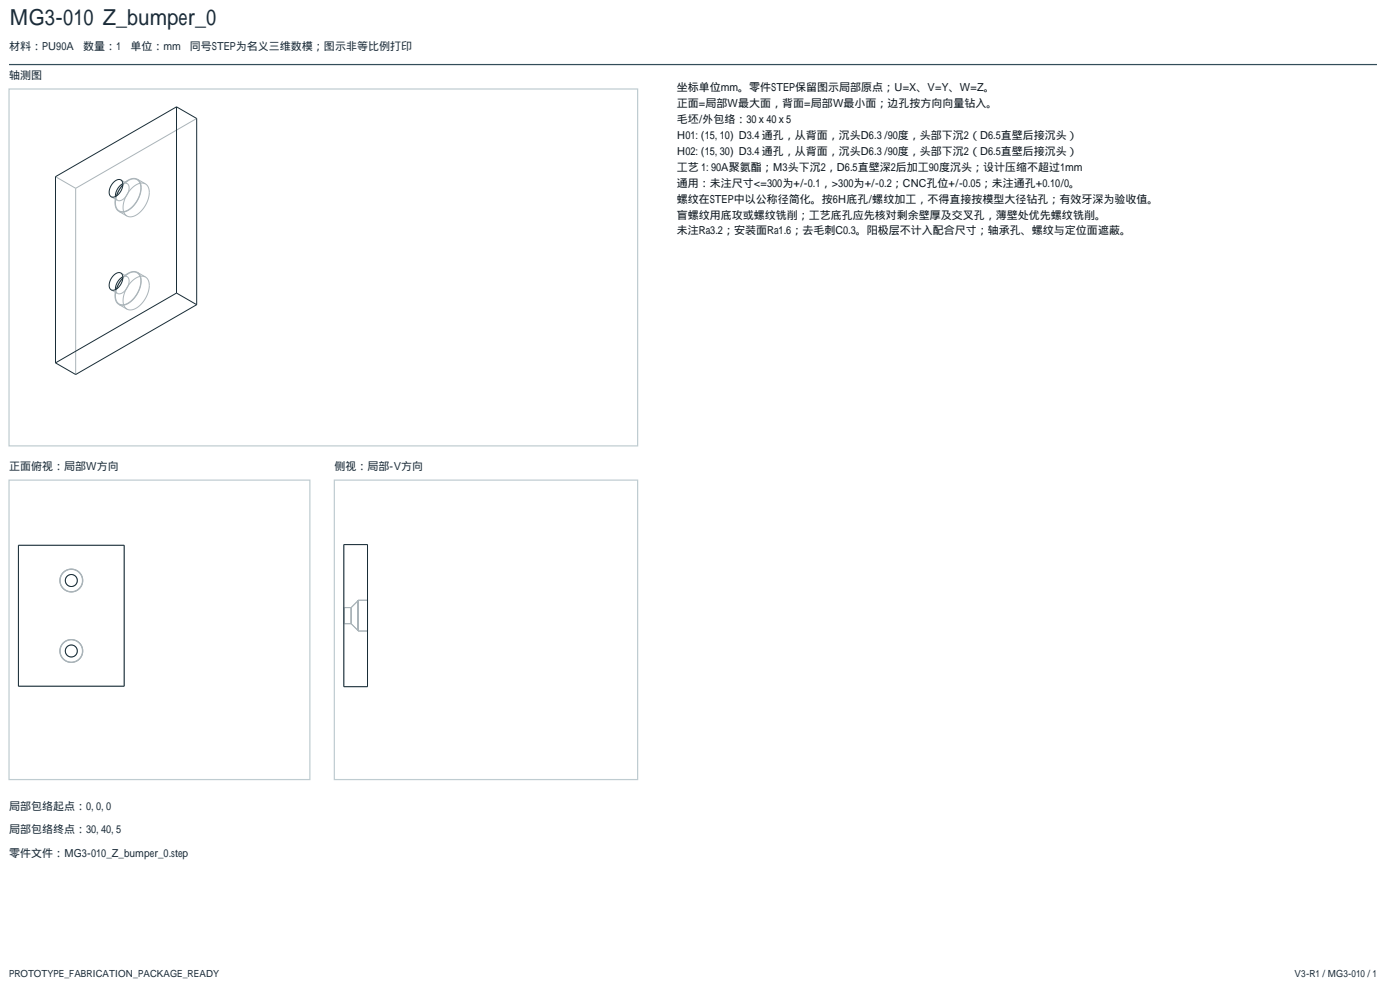
[picture p126: page 10]
轴测图; 正面俯视：局部W方向; 侧视：局部-V方向; 局部包络起点：0, 0, 0; 局部包络终点：30, 40, 5; 零件文件：MG3-010_Z_bumper_0.step

材料：PU90A 数量：1 单位：mm 同号STEP为名义三维数模；图示非等比例打印

坐标单位mm。零件STEP保留图示局部原点；U=X、V=Y、W=Z。
正面=局部W最大面，背面=局部W最小面；边孔按方向向量钻入。
毛坯/外包络：30 x 40 x 5
H01: (15, 10) D3.4 通孔，从背面，沉头D6.3 /90度，头部下沉2（D6.5直壁后接沉头）
H02: (15, 30) D3.4 通孔，从背面，沉头D6.3 /90度，头部下沉2（D6.5直壁后接沉头）
工艺 1: 90A聚氨酯；M3头下沉2，D6.5直壁深2后加工90度沉头；设计压缩不超过1mm
通用：未注尺寸<=300为+/-0.1，>300为+/-0.2；CNC孔位+/-0.05；未注通孔+0.10/0。
螺纹在STEP中以公称径简化。按6H底孔/螺纹加工，不得直接按模型大径钻孔；有效牙深为验收值。
盲螺纹用底攻或螺纹铣削；工艺底孔应先核对剩余壁厚及交叉孔，薄壁处优先螺纹铣削。
未注Ra3.2；安装面Ra1.6；去毛刺C0.3。阳极层不计入配合尺寸；轴承孔、螺纹与定位面遮蔽。

# MG3-011 Z_bumper_1

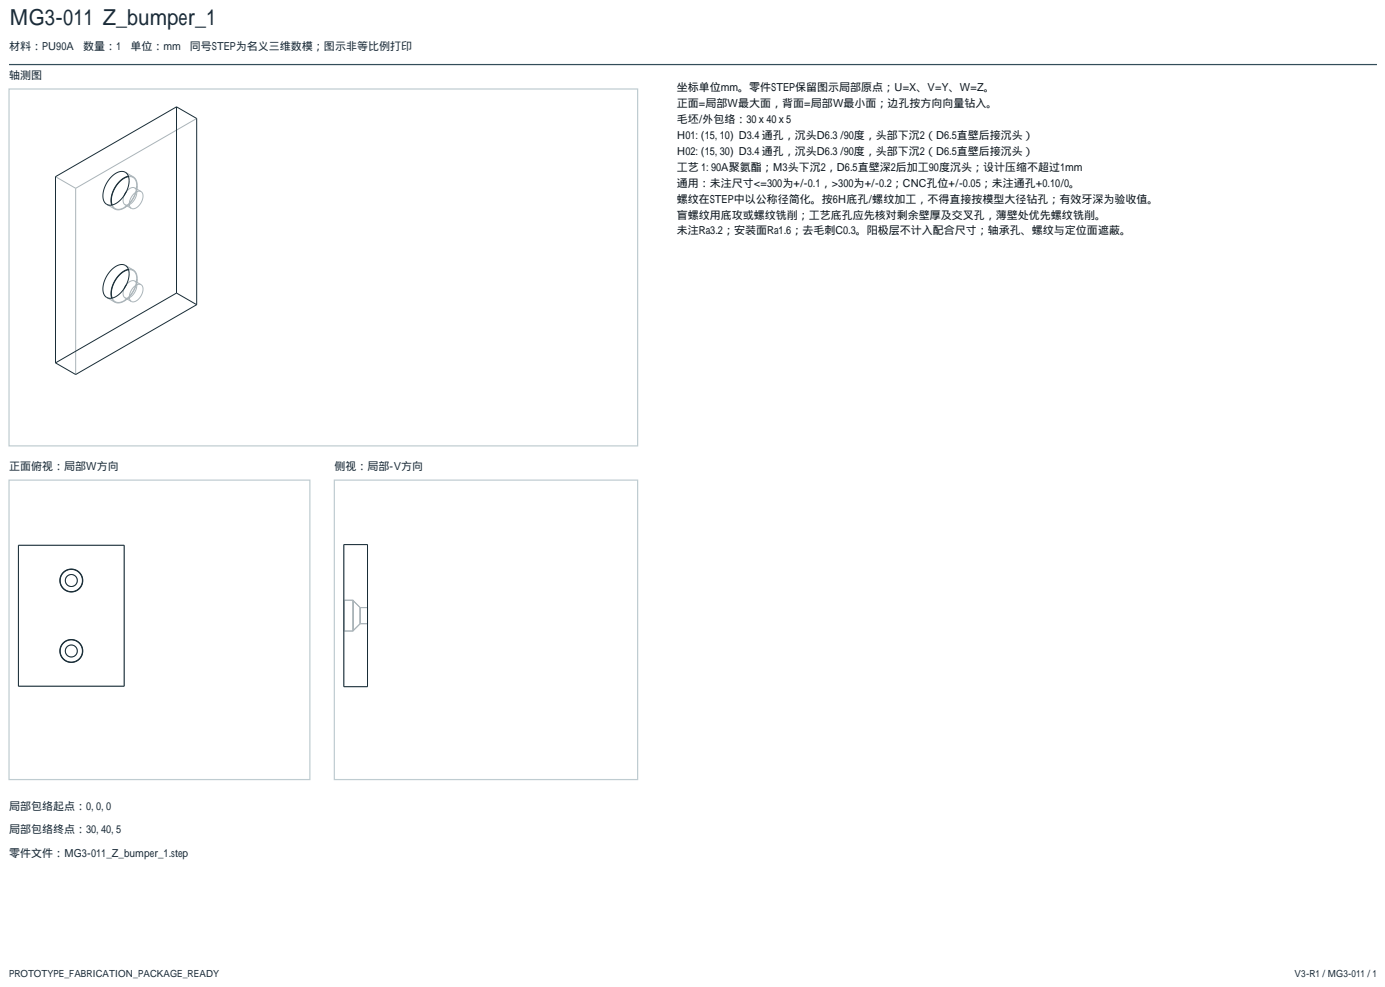
[picture p127: page 11]
轴测图; 正面俯视：局部W方向; 侧视：局部-V方向; 局部包络起点：0, 0, 0; 局部包络终点：30, 40, 5; 零件文件：MG3-011_Z_bumper_1.step

材料：PU90A 数量：1 单位：mm 同号STEP为名义三维数模；图示非等比例打印

坐标单位mm。零件STEP保留图示局部原点；U=X、V=Y、W=Z。
正面=局部W最大面，背面=局部W最小面；边孔按方向向量钻入。
毛坯/外包络：30 x 40 x 5
H01: (15, 10) D3.4 通孔，沉头D6.3 /90度，头部下沉2（D6.5直壁后接沉头）
H02: (15, 30) D3.4 通孔，沉头D6.3 /90度，头部下沉2（D6.5直壁后接沉头）
工艺 1: 90A聚氨酯；M3头下沉2，D6.5直壁深2后加工90度沉头；设计压缩不超过1mm
通用：未注尺寸<=300为+/-0.1，>300为+/-0.2；CNC孔位+/-0.05；未注通孔+0.10/0。
螺纹在STEP中以公称径简化。按6H底孔/螺纹加工，不得直接按模型大径钻孔；有效牙深为验收值。
盲螺纹用底攻或螺纹铣削；工艺底孔应先核对剩余壁厚及交叉孔，薄壁处优先螺纹铣削。
未注Ra3.2；安装面Ra1.6；去毛刺C0.3。阳极层不计入配合尺寸；轴承孔、螺纹与定位面遮蔽。

# MG3-012 Z_stop_0

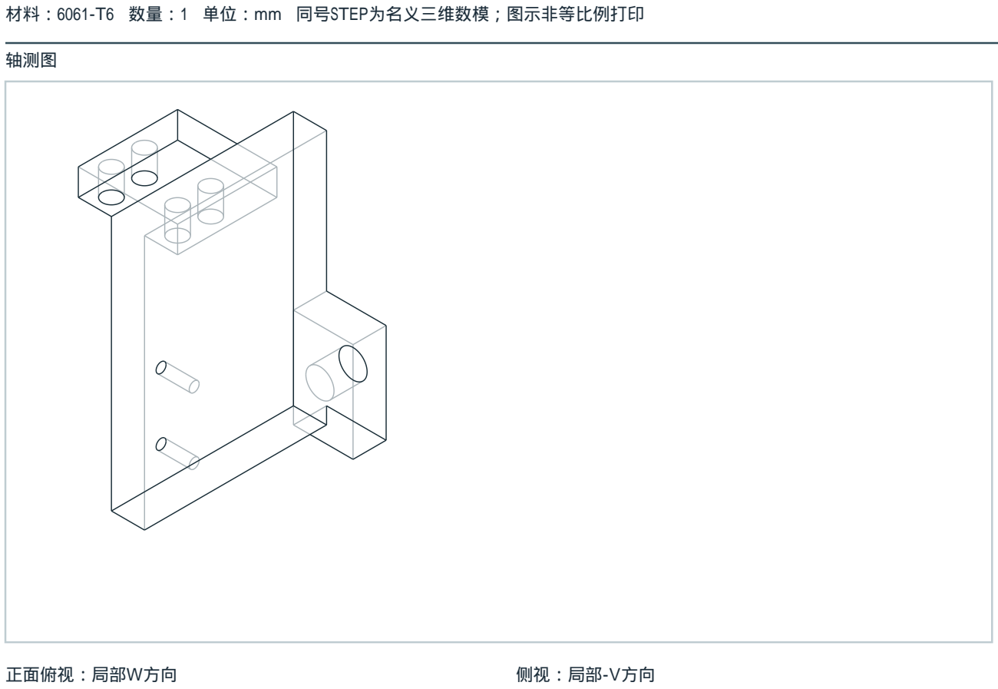
[picture p128: figure]
材料：6061-T6 数量：1 单位：mm 同号STEP为名义三维数模；图示非等比例打印; 轴测图; 正面俯视：局部W方向; 侧视：局部-V方向
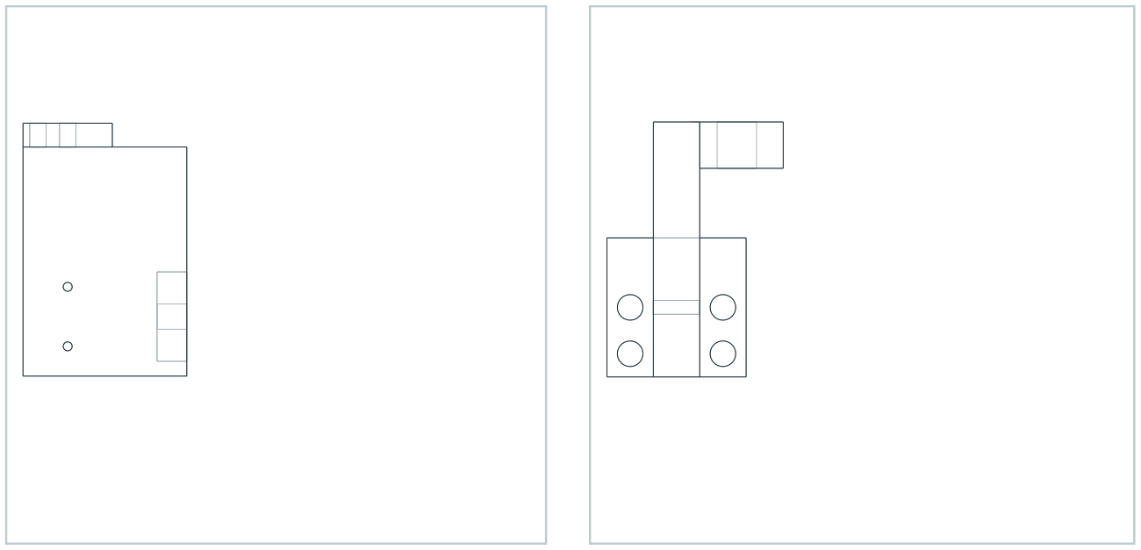
[picture p129: figure]

局部包络起点：0, 0, -8

局部包络终点：55, 85, 30

零件文件：MG3-012_Z_stop_0.step

坐标单位mm。零件STEP保留图示局部原点；U=X、V=Y、W=Z。 正面=局部W最大面，背面=局部W最小面；边孔按方向向量钻入。 毛坯并体[x,y,z,dx,dy,dz]: [[0,77,0,30,8,30],[0,0,10,55,77,10],[45,5,-8,10,30,20]] 加工特征 1: {"point":[5,77,5],"direction":[0,1,0],"diameter":5.5,"depth":8}
加工特征 2: {"point":[5,77,25],"direction":[0,1,0],"diameter":5.5,"depth":8} 加工特征 3: {"point":[15,77,5],"direction":[0,1,0],"diameter":5.5,"depth":8}
加工特征 4: {"point":[15,77,25],"direction":[0,1,0],"diameter":5.5,"depth":8}
加工特征 5: {"point":[45,20,2],"direction":[1,0,0],"diameter":8.5,"depth":10}
加工特征 6: {"point":[15,10,10],"direction":[0,0,1],"diameter":3,"depth":10,"thread":"M3"} 加工特征 7: {"point":[15,30,10],"direction":[0,0,1],"diameter":3,"depth":10,"thread":"M3"}
工艺 1: 金属极限Z110/640，5mm垫首次接触Z115/635；正常工作120~620
工艺 2: Z名义限位118/632；Z调试速度上限20mm/s，急停反应和制动距离实测后设定
工艺 3: 3D STEP给定未标注轮廓；孔位+/-0.05，垂直度0.05/100；内角允许R2，接触/安装面Ra1.6 通用：未注尺寸<=300为+/-0.1，>300为+/-0.2；CNC孔位+/-0.05；未注通孔+0.10/0。 螺纹在STEP中以公称径简化。按6H底孔/螺纹加工，不得直接按模型大径钻孔；有效牙深为验收值。 盲螺纹用底攻或螺纹铣削；工艺底孔应先核对剩余壁厚及交叉孔，薄壁处优先螺纹铣削。 未注Ra3.2；安装面Ra1.6；去毛刺C0.3。阳极层不计入配合尺寸；轴承孔、螺纹与定位面遮蔽。

# MG3-013 Z_stop_1

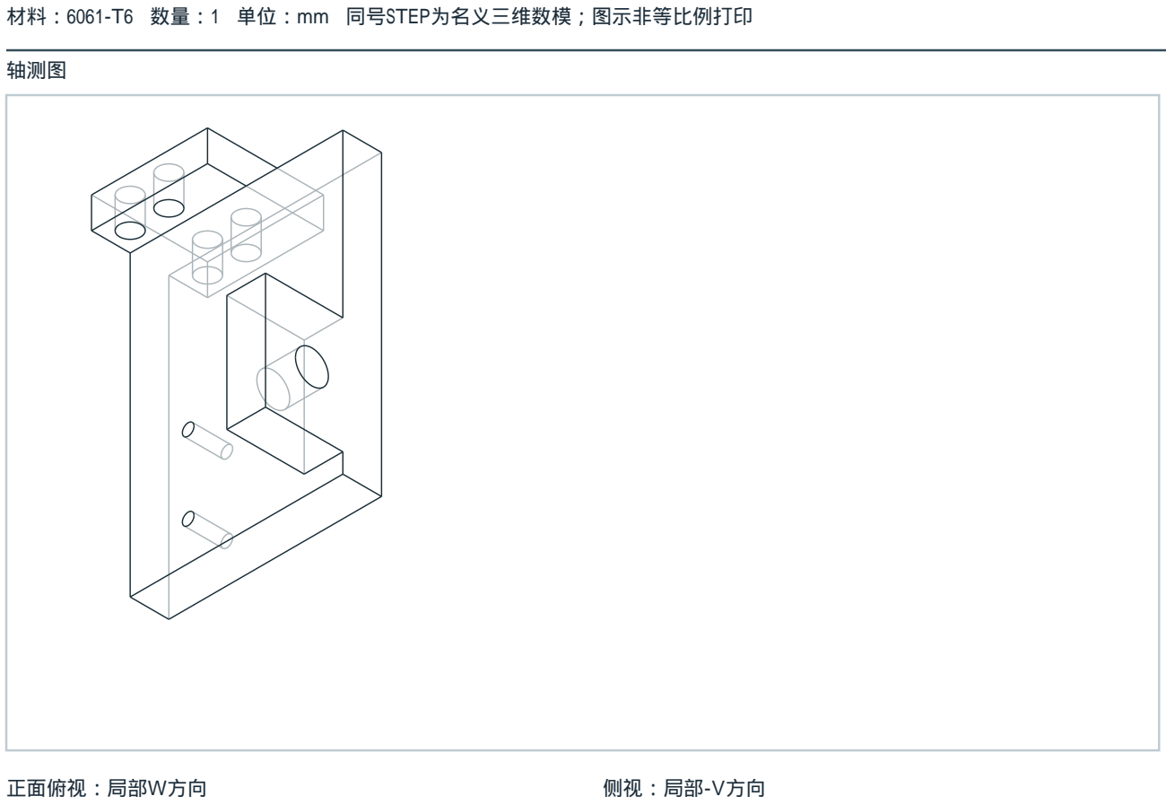
[picture p130: figure]
材料：6061-T6 数量：1 单位：mm 同号STEP为名义三维数模；图示非等比例打印; 轴测图; 正面俯视：局部W方向; 侧视：局部-V方向
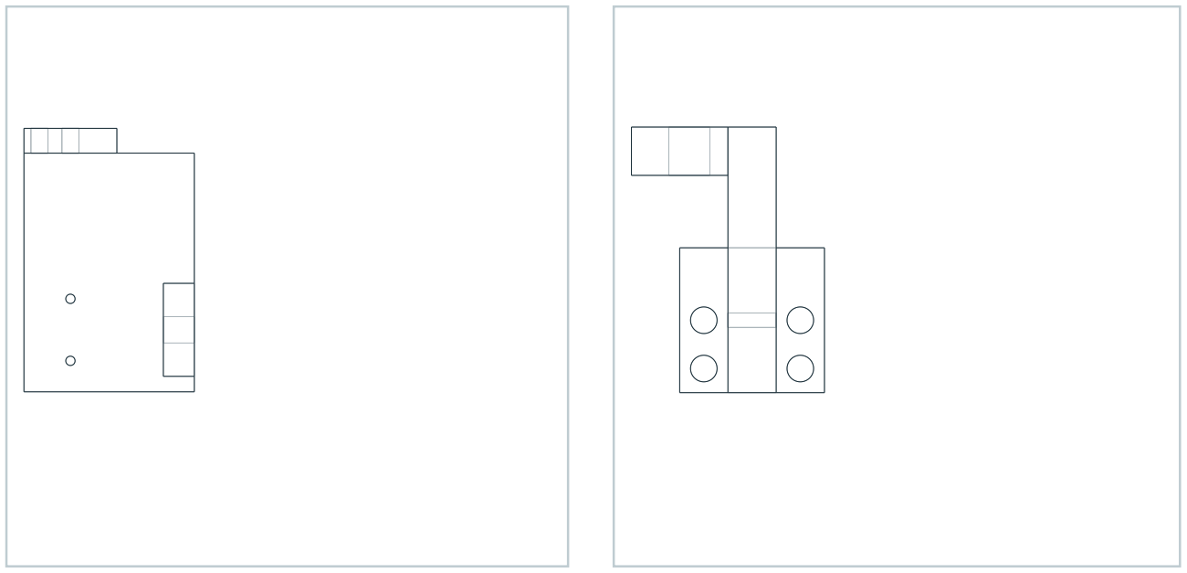
[picture p131: figure]

局部包络起点：0, 0, 0

局部包络终点：55, 85, 40

零件文件：MG3-013_Z_stop_1.step

坐标单位mm。零件STEP保留图示局部原点；U=X、V=Y、W=Z。 正面=局部W最大面，背面=局部W最小面；边孔按方向向量钻入。 毛坯并体[x,y,z,dx,dy,dz]: [[0,77,0,30,8,30],[0,0,10,55,77,10],[45,5,20,10,30,20]] 加工特征 1: {"point":[5,77,5],"direction":[0,1,0],"diameter":5.5,"depth":8}
加工特征 2: {"point":[5,77,25],"direction":[0,1,0],"diameter":5.5,"depth":8} 加工特征 3: {"point":[15,77,5],"direction":[0,1,0],"diameter":5.5,"depth":8}
加工特征 4: {"point":[15,77,25],"direction":[0,1,0],"diameter":5.5,"depth":8}
加工特征 5: {"point":[45,20,28],"direction":[1,0,0],"diameter":8.5,"depth":10}
加工特征 6: {"point":[15,10,10],"direction":[0,0,1],"diameter":3,"depth":10,"thread":"M3"} 加工特征 7: {"point":[15,30,10],"direction":[0,0,1],"diameter":3,"depth":10,"thread":"M3"}
工艺 1: 金属极限Z110/640，5mm垫首次接触Z115/635；正常工作120~620
工艺 2: Z名义限位118/632；Z调试速度上限20mm/s，急停反应和制动距离实测后设定
工艺 3: 3D STEP给定未标注轮廓；孔位+/-0.05，垂直度0.05/100；内角允许R2，接触/安装面Ra1.6 通用：未注尺寸<=300为+/-0.1，>300为+/-0.2；CNC孔位+/-0.05；未注通孔+0.10/0。 螺纹在STEP中以公称径简化。按6H底孔/螺纹加工，不得直接按模型大径钻孔；有效牙深为验收值。 盲螺纹用底攻或螺纹铣削；工艺底孔应先核对剩余壁厚及交叉孔，薄壁处优先螺纹铣削。 未注Ra3.2；安装面Ra1.6；去毛刺C0.3。阳极层不计入配合尺寸；轴承孔、螺纹与定位面遮蔽。

# MG3-014 Z_striker_0

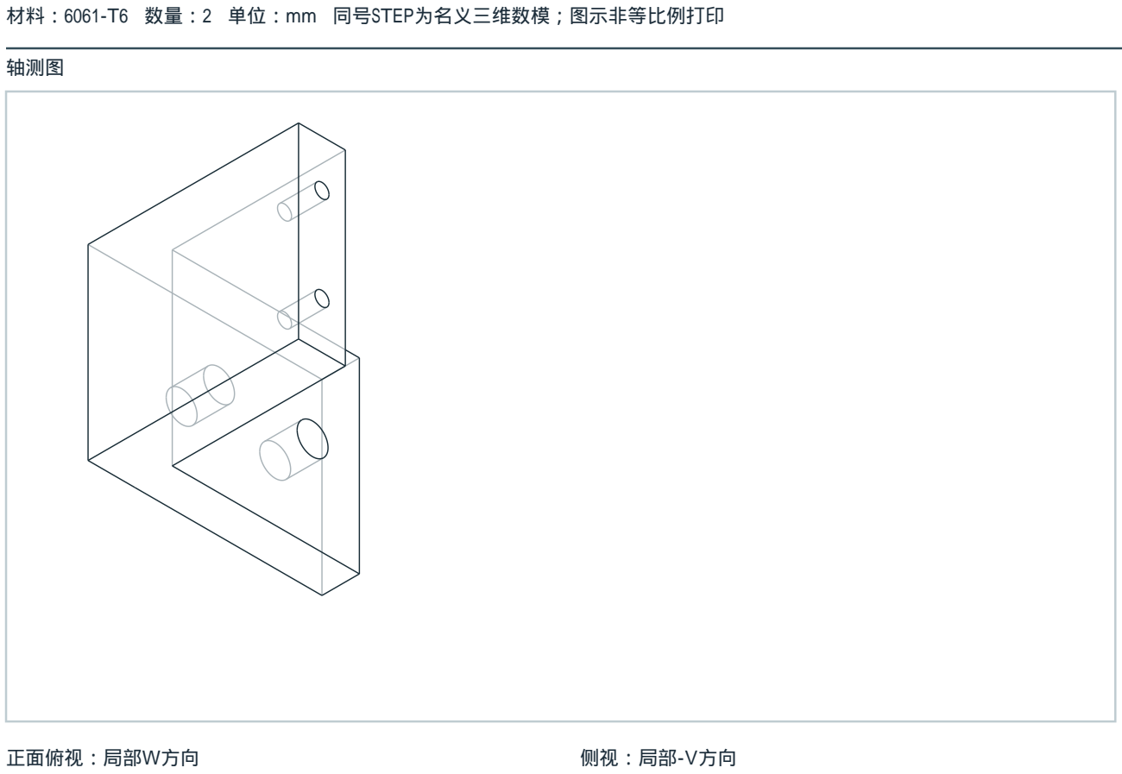
[picture p132: figure]
材料：6061-T6 数量：2 单位：mm 同号STEP为名义三维数模；图示非等比例打印; 轴测图; 正面俯视：局部W方向; 侧视：局部-V方向

局部包络起点：0, 0, 0

局部包络终点：45, 40, 50

零件文件：MG3-014_Z_striker_0.step

坐标单位mm。零件STEP保留图示局部原点；U=X、V=Y、W=Z。 正面=局部W最大面，背面=局部W最小面；边孔按方向向量钻入。 毛坯并体[x,y,z,dx,dy,dz]: [[0,0,0,8,40,40],[0,0,40,45,40,10]]
加工特征 1: {"point":[0,20,10],"direction":[1,0,0],"diameter":6.6,"depth":8}
加工特征 2: {"point":[0,20,30],"direction":[1,0,0],"diameter":6.6,"depth":8}
加工特征 3: {"point":[45,10,45],"direction":[-1,0,0],"diameter":3,"depth":8,"thread":"M3"}
加工特征 4: {"point":[45,30,45],"direction":[-1,0,0],"diameter":3,"depth":8,"thread":"M3"}
工艺 1: 移动触块接滑枕侧槽；上下位置按Z基准从滑枕底端190量取；锁紧后画见证线
工艺 2: 3D STEP给定未标注轮廓；孔位+/-0.05，垂直度0.05/100；内角允许R2，接触/安装面Ra1.6 通用：未注尺寸<=300为+/-0.1，>300为+/-0.2；CNC孔位+/-0.05；未注通孔+0.10/0。 螺纹在STEP中以公称径简化。按6H底孔/螺纹加工，不得直接按模型大径钻孔；有效牙深为验收值。 盲螺纹用底攻或螺纹铣削；工艺底孔应先核对剩余壁厚及交叉孔，薄壁处优先螺纹铣削。 未注Ra3.2；安装面Ra1.6；去毛刺C0.3。阳极层不计入配合尺寸；轴承孔、螺纹与定位面遮蔽。

# MG3-015 Z_target_0

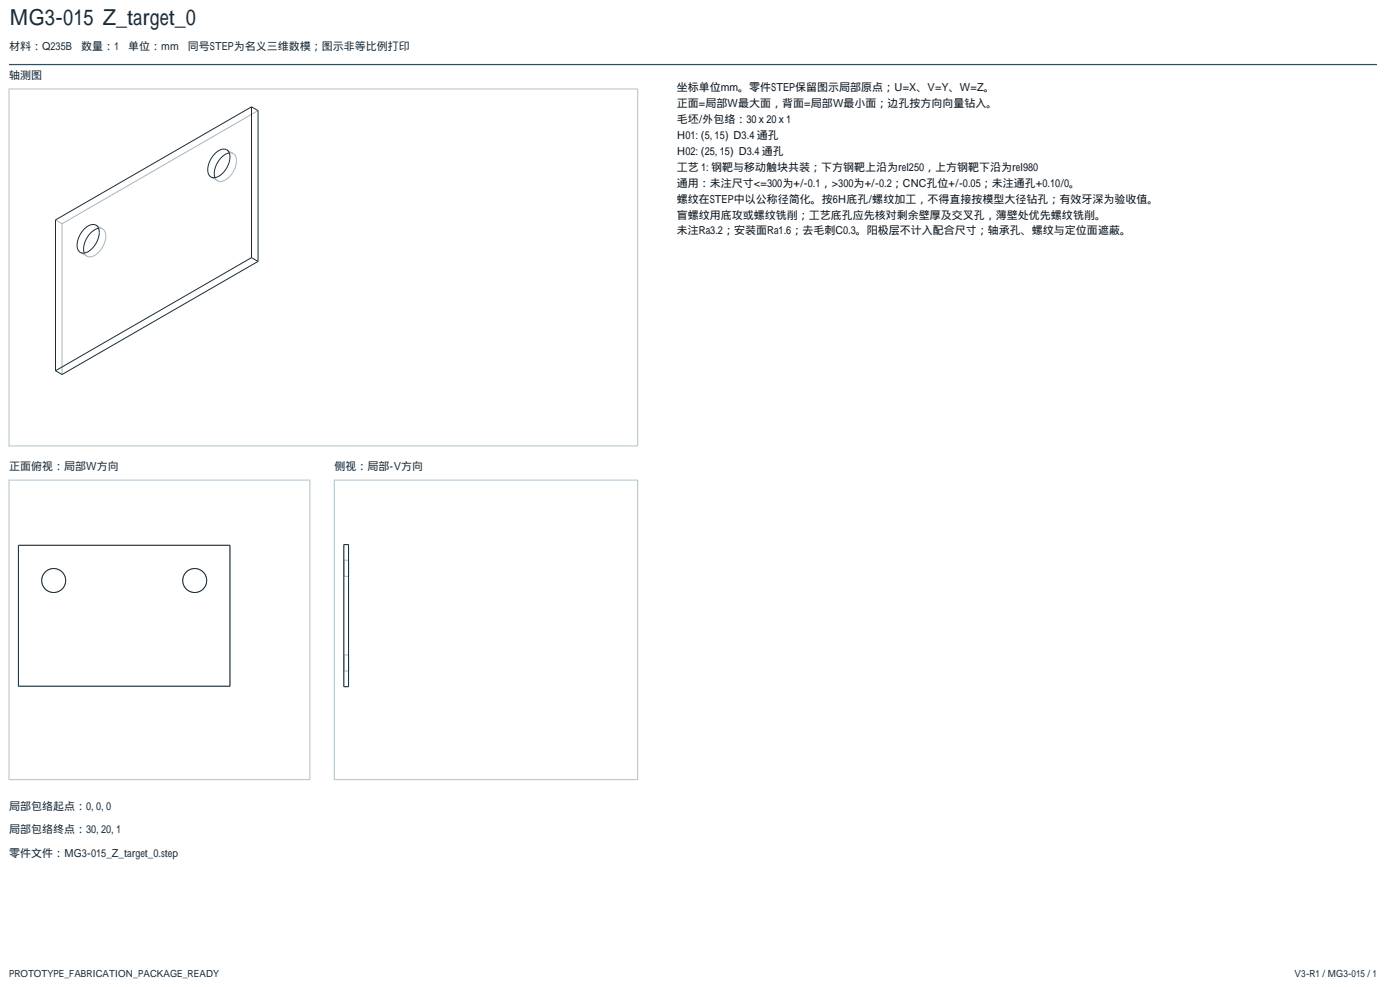
[picture p133: page 15]
轴测图; 正面俯视：局部W方向; 侧视：局部-V方向; 局部包络起点：0, 0, 0; 局部包络终点：30, 20, 1; 零件文件：MG3-015_Z_target_0.step

材料：Q235B 数量：1 单位：mm 同号STEP为名义三维数模；图示非等比例打印

坐标单位mm。零件STEP保留图示局部原点；U=X、V=Y、W=Z。
正面=局部W最大面，背面=局部W最小面；边孔按方向向量钻入。
毛坯/外包络：30 x 20 x 1
工艺 1: 钢靶与移动触块共装；下方钢靶上沿为rel250，上方钢靶下沿为rel980
通用：未注尺寸<=300为+/-0.1，>300为+/-0.2；CNC孔位+/-0.05；未注通孔+0.10/0。
螺纹在STEP中以公称径简化。按6H底孔/螺纹加工，不得直接按模型大径钻孔；有效牙深为验收值。
盲螺纹用底攻或螺纹铣削；工艺底孔应先核对剩余壁厚及交叉孔，薄壁处优先螺纹铣削。
未注Ra3.2；安装面Ra1.6；去毛刺C0.3。阳极层不计入配合尺寸；轴承孔、螺纹与定位面遮蔽。

# MG3-016 Z_target_1

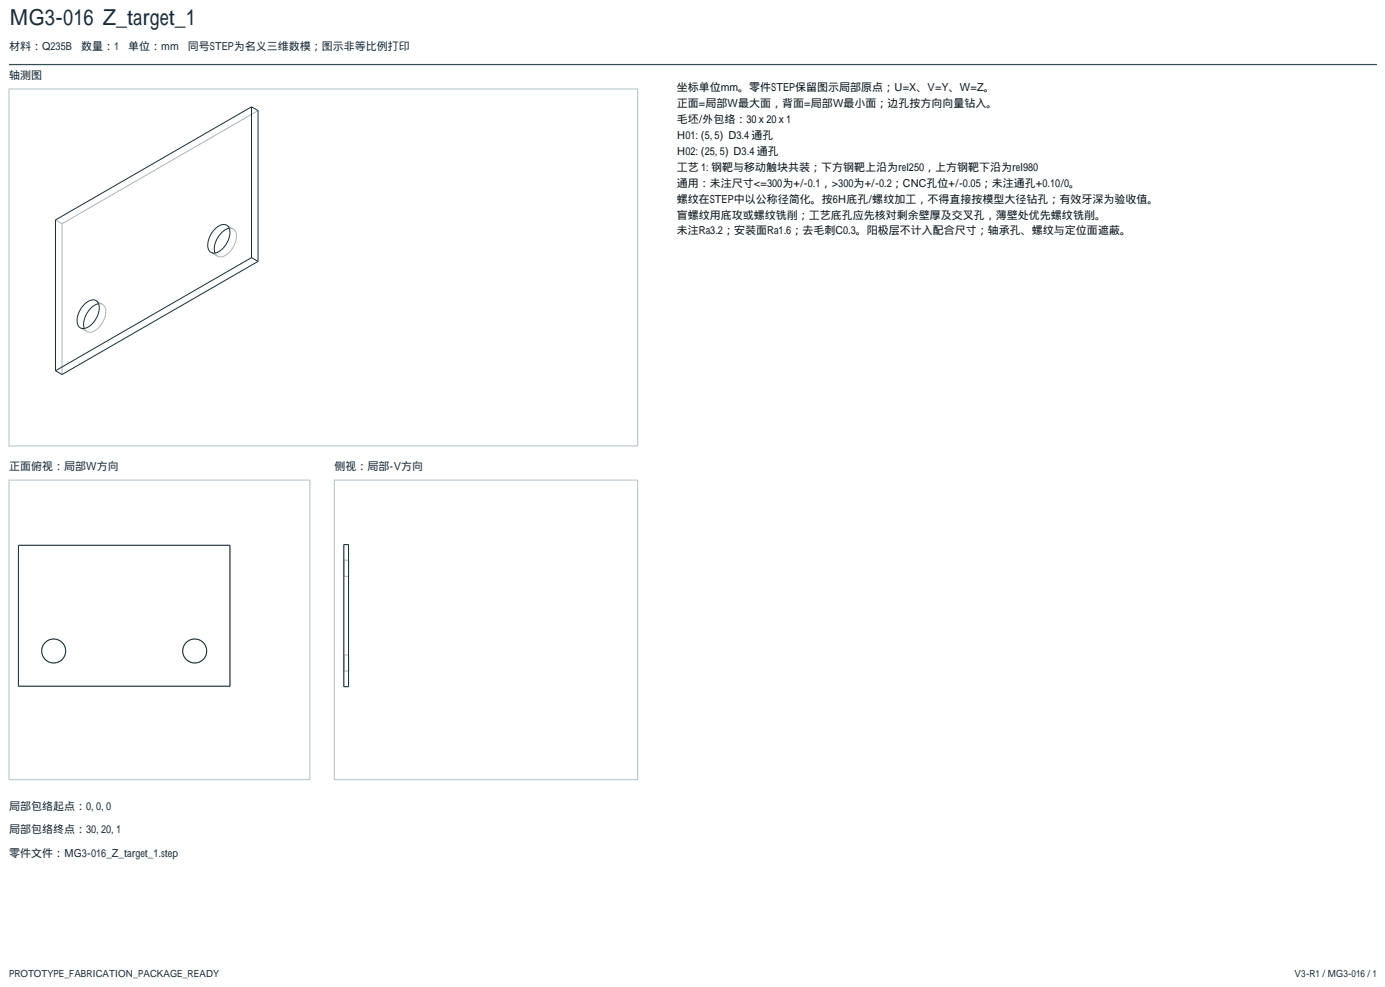
[picture p134: page 16]
轴测图; 正面俯视：局部W方向; 侧视：局部-V方向; 局部包络起点：0, 0, 0; 局部包络终点：30, 20, 1; 零件文件：MG3-016_Z_target_1.step

材料：Q235B 数量：1 单位：mm 同号STEP为名义三维数模；图示非等比例打印

坐标单位mm。零件STEP保留图示局部原点；U=X、V=Y、W=Z。
正面=局部W最大面，背面=局部W最小面；边孔按方向向量钻入。
毛坯/外包络：30 x 20 x 1
工艺 1: 钢靶与移动触块共装；下方钢靶上沿为rel250，上方钢靶下沿为rel980
通用：未注尺寸<=300为+/-0.1，>300为+/-0.2；CNC孔位+/-0.05；未注通孔+0.10/0。
螺纹在STEP中以公称径简化。按6H底孔/螺纹加工，不得直接按模型大径钻孔；有效牙深为验收值。
盲螺纹用底攻或螺纹铣削；工艺底孔应先核对剩余壁厚及交叉孔，薄壁处优先螺纹铣削。
未注Ra3.2；安装面Ra1.6；去毛刺C0.3。阳极层不计入配合尺寸；轴承孔、螺纹与定位面遮蔽。

# MG3-017 accessory_cross_joint_0

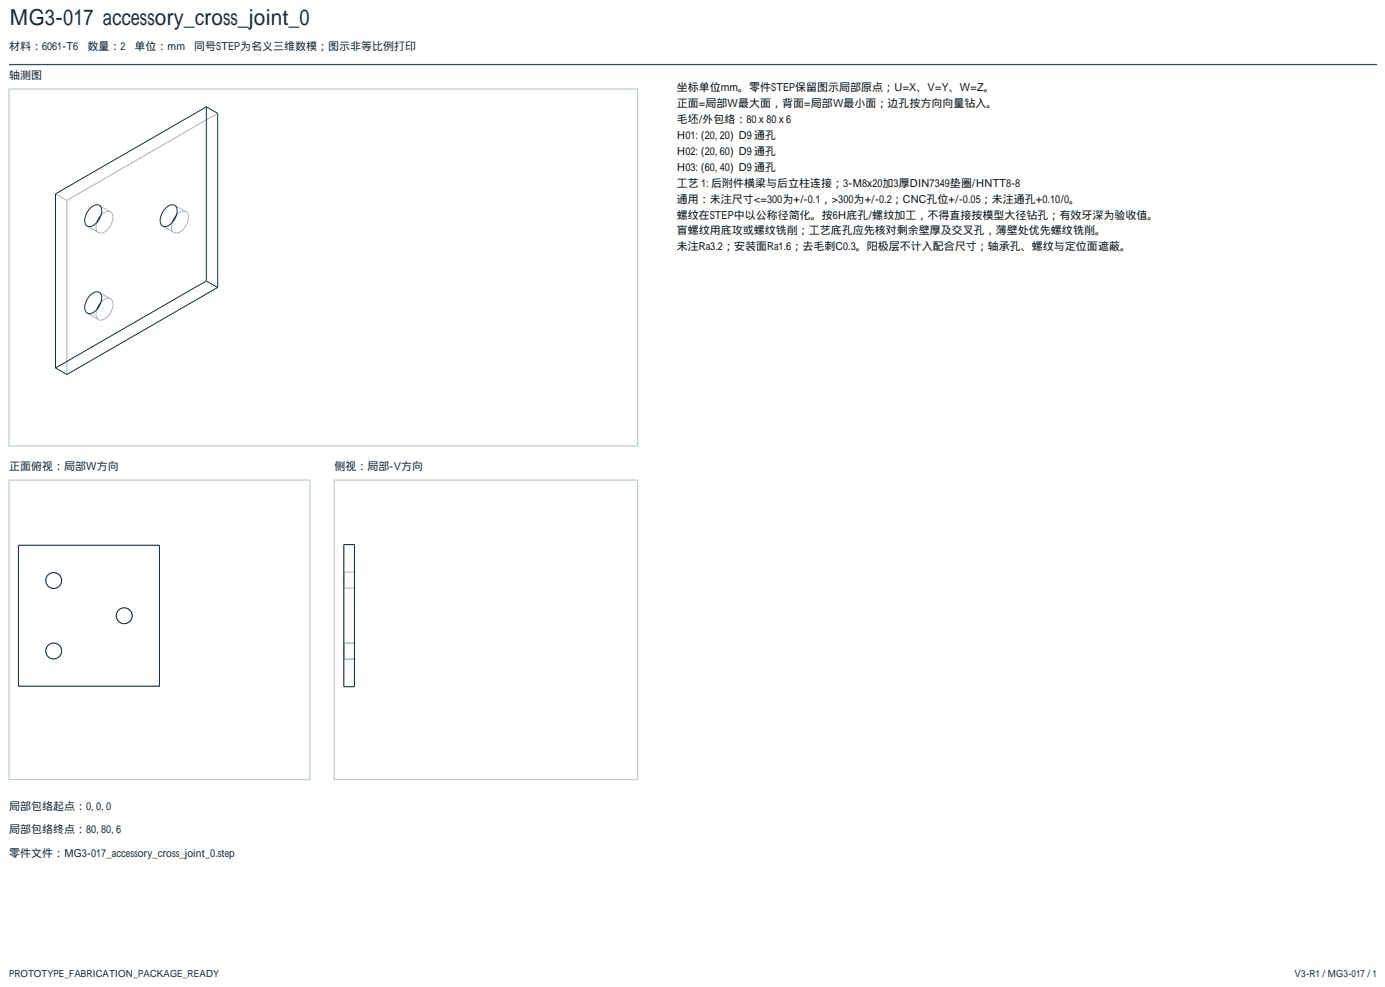
[picture p135: page 17]
轴测图; 正面俯视：局部W方向; 侧视：局部-V方向; 局部包络起点：0, 0, 0; 局部包络终点：80, 80, 6; 零件文件：MG3-017_accessory_cross_joint_0.step

材料：6061-T6 数量：2 单位：mm 同号STEP为名义三维数模；图示非等比例打印

坐标单位mm。零件STEP保留图示局部原点；U=X、V=Y、W=Z。
正面=局部W最大面，背面=局部W最小面；边孔按方向向量钻入。
毛坯/外包络：80 x 80 x 6
工艺 1: 后附件横梁与后立柱连接；3-M8x20加3厚DIN7349垫圈/HNTT8-8
通用：未注尺寸<=300为+/-0.1，>300为+/-0.2；CNC孔位+/-0.05；未注通孔+0.10/0。
螺纹在STEP中以公称径简化。按6H底孔/螺纹加工，不得直接按模型大径钻孔；有效牙深为验收值。
盲螺纹用底攻或螺纹铣削；工艺底孔应先核对剩余壁厚及交叉孔，薄壁处优先螺纹铣削。
未注Ra3.2；安装面Ra1.6；去毛刺C0.3。阳极层不计入配合尺寸；轴承孔、螺纹与定位面遮蔽。

# MG3-018 bridge_riser_0

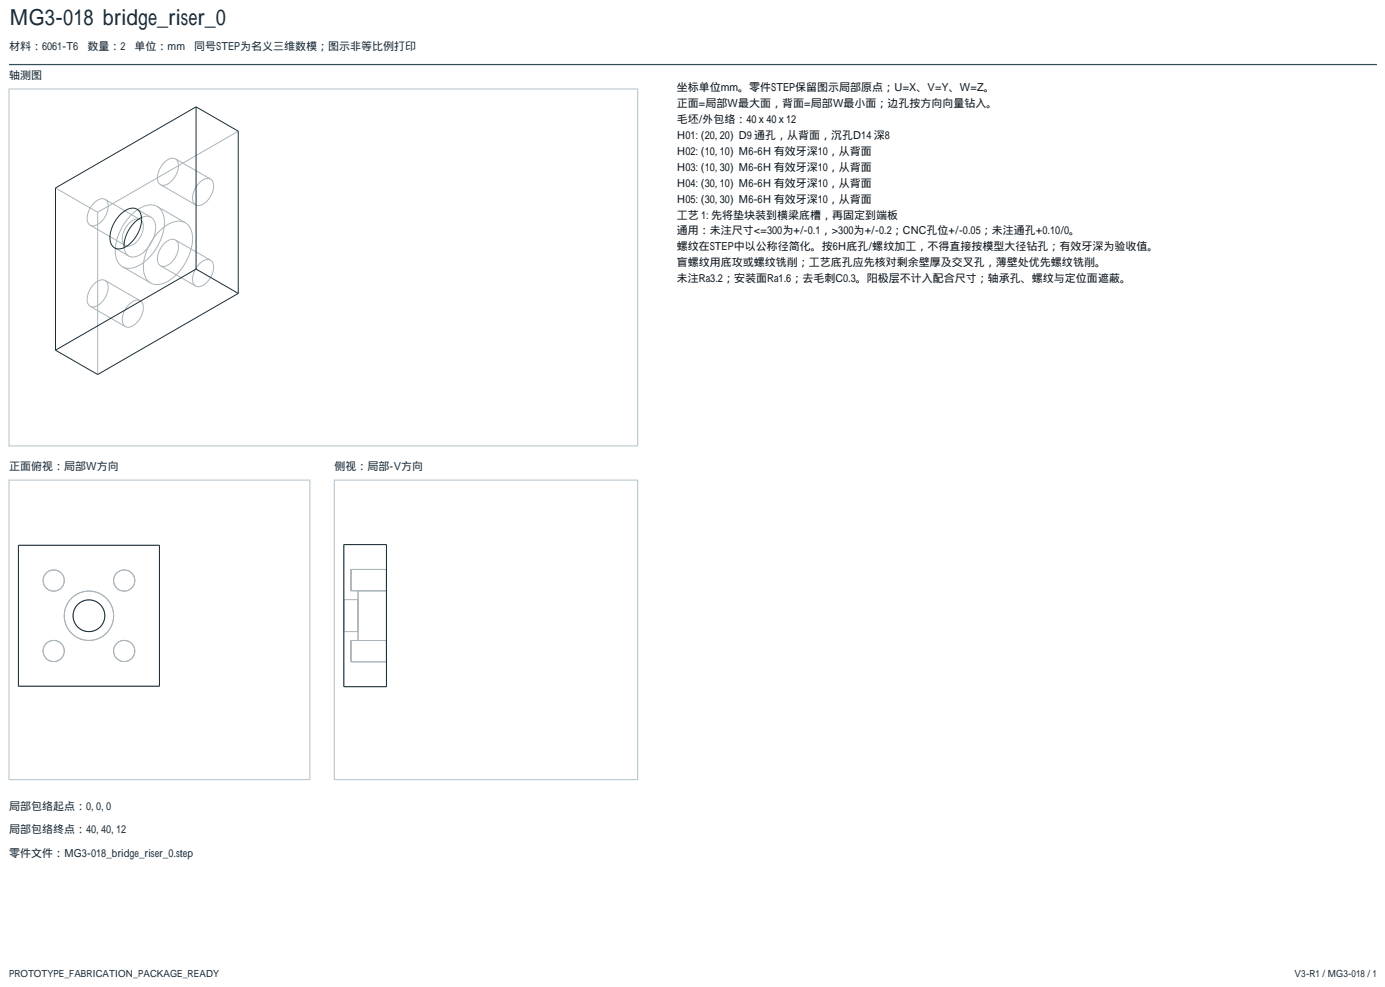
[picture p136: page 18]
轴测图; 正面俯视：局部W方向; 侧视：局部-V方向; 局部包络起点：0, 0, 0; 局部包络终点：40, 40, 12; 零件文件：MG3-018_bridge_riser_0.step

材料：6061-T6 数量：2 单位：mm 同号STEP为名义三维数模；图示非等比例打印

坐标单位mm。零件STEP保留图示局部原点；U=X、V=Y、W=Z。
正面=局部W最大面，背面=局部W最小面；边孔按方向向量钻入。
毛坯/外包络：40 x 40 x 12
H01: (20, 20) D9 通孔，从背面，沉孔D14 深8
H02: (10, 10) M6-6H 有效牙深10，从背面
H03: (10, 30) M6-6H 有效牙深10，从背面
H04: (30, 10) M6-6H 有效牙深10，从背面
H05: (30, 30) M6-6H 有效牙深10，从背面
工艺 1: 先将垫块装到横梁底槽，再固定到端板
通用：未注尺寸<=300为+/-0.1，>300为+/-0.2；CNC孔位+/-0.05；未注通孔+0.10/0。
螺纹在STEP中以公称径简化。按6H底孔/螺纹加工，不得直接按模型大径钻孔；有效牙深为验收值。
盲螺纹用底攻或螺纹铣削；工艺底孔应先核对剩余壁厚及交叉孔，薄壁处优先螺纹铣削。
未注Ra3.2；安装面Ra1.6；去毛刺C0.3。阳极层不计入配合尺寸；轴承孔、螺纹与定位面遮蔽。

# MG3-019 camera_base

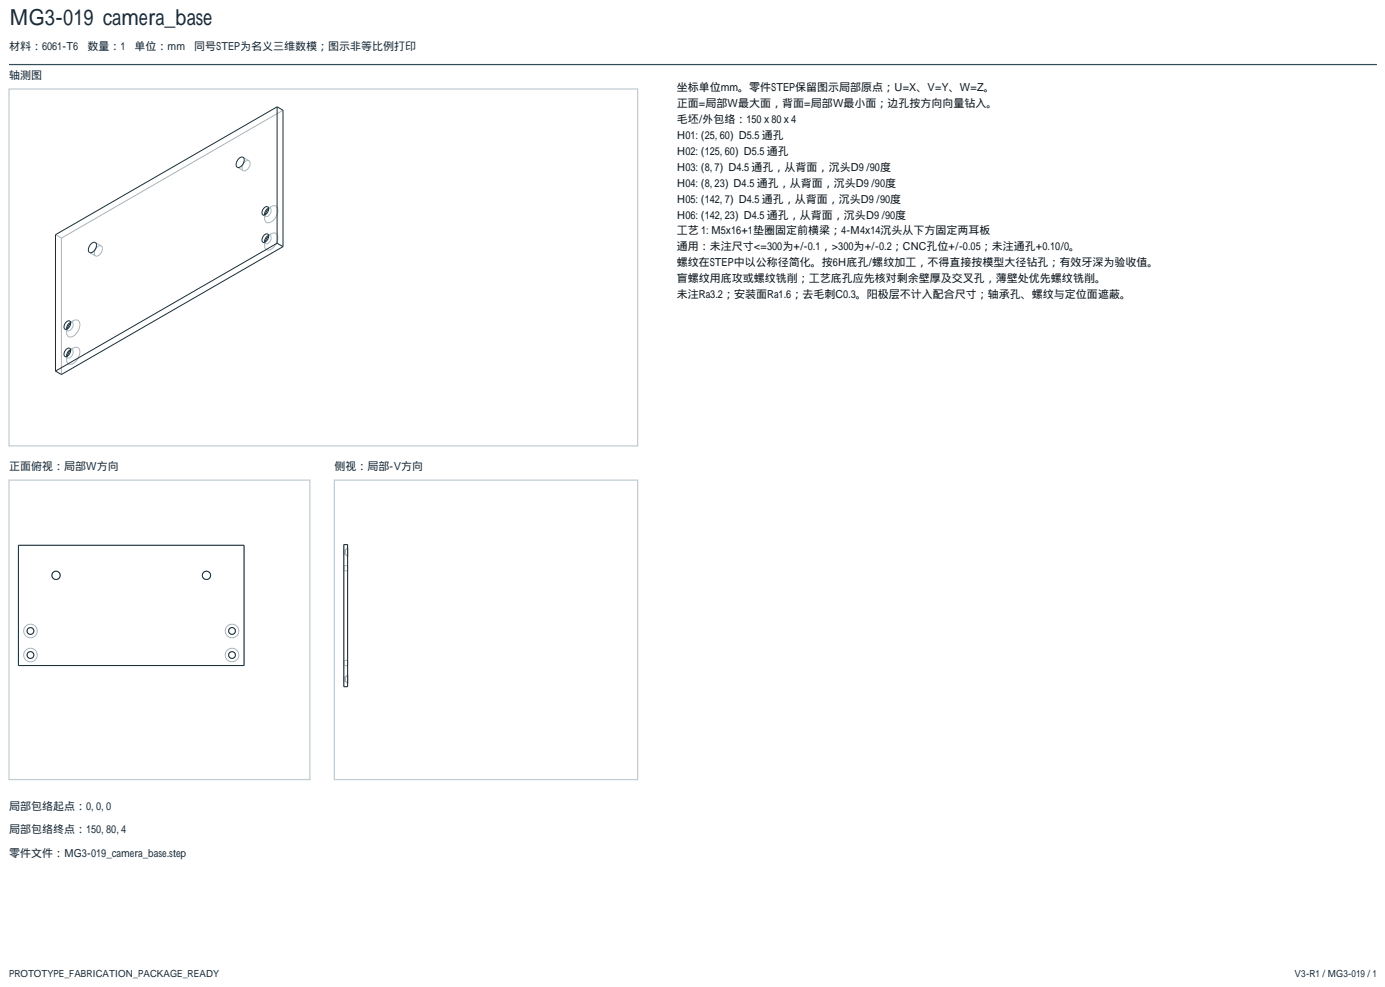
[picture p137: page 19]
轴测图; 正面俯视：局部W方向; 侧视：局部-V方向; 局部包络起点：0, 0, 0; 局部包络终点：150, 80, 4; 零件文件：MG3-019_camera_base.step

材料：6061-T6 数量：1 单位：mm 同号STEP为名义三维数模；图示非等比例打印

坐标单位mm。零件STEP保留图示局部原点；U=X、V=Y、W=Z。
正面=局部W最大面，背面=局部W最小面；边孔按方向向量钻入。
毛坯/外包络：150 x 80 x 4
H03: (8, 7) D4.5 通孔，从背面，沉头D9 /90度
H04: (8, 23) D4.5 通孔，从背面，沉头D9 /90度
H05: (142, 7) D4.5 通孔，从背面，沉头D9 /90度
H06: (142, 23) D4.5 通孔，从背面，沉头D9 /90度
工艺 1: M5x16+1垫圈固定前横梁；4-M4x14沉头从下方固定两耳板
通用：未注尺寸<=300为+/-0.1，>300为+/-0.2；CNC孔位+/-0.05；未注通孔+0.10/0。
螺纹在STEP中以公称径简化。按6H底孔/螺纹加工，不得直接按模型大径钻孔；有效牙深为验收值。
盲螺纹用底攻或螺纹铣削；工艺底孔应先核对剩余壁厚及交叉孔，薄壁处优先螺纹铣削。
未注Ra3.2；安装面Ra1.6；去毛刺C0.3。阳极层不计入配合尺寸；轴承孔、螺纹与定位面遮蔽。

# MG3-020 camera_pivot_ear_0

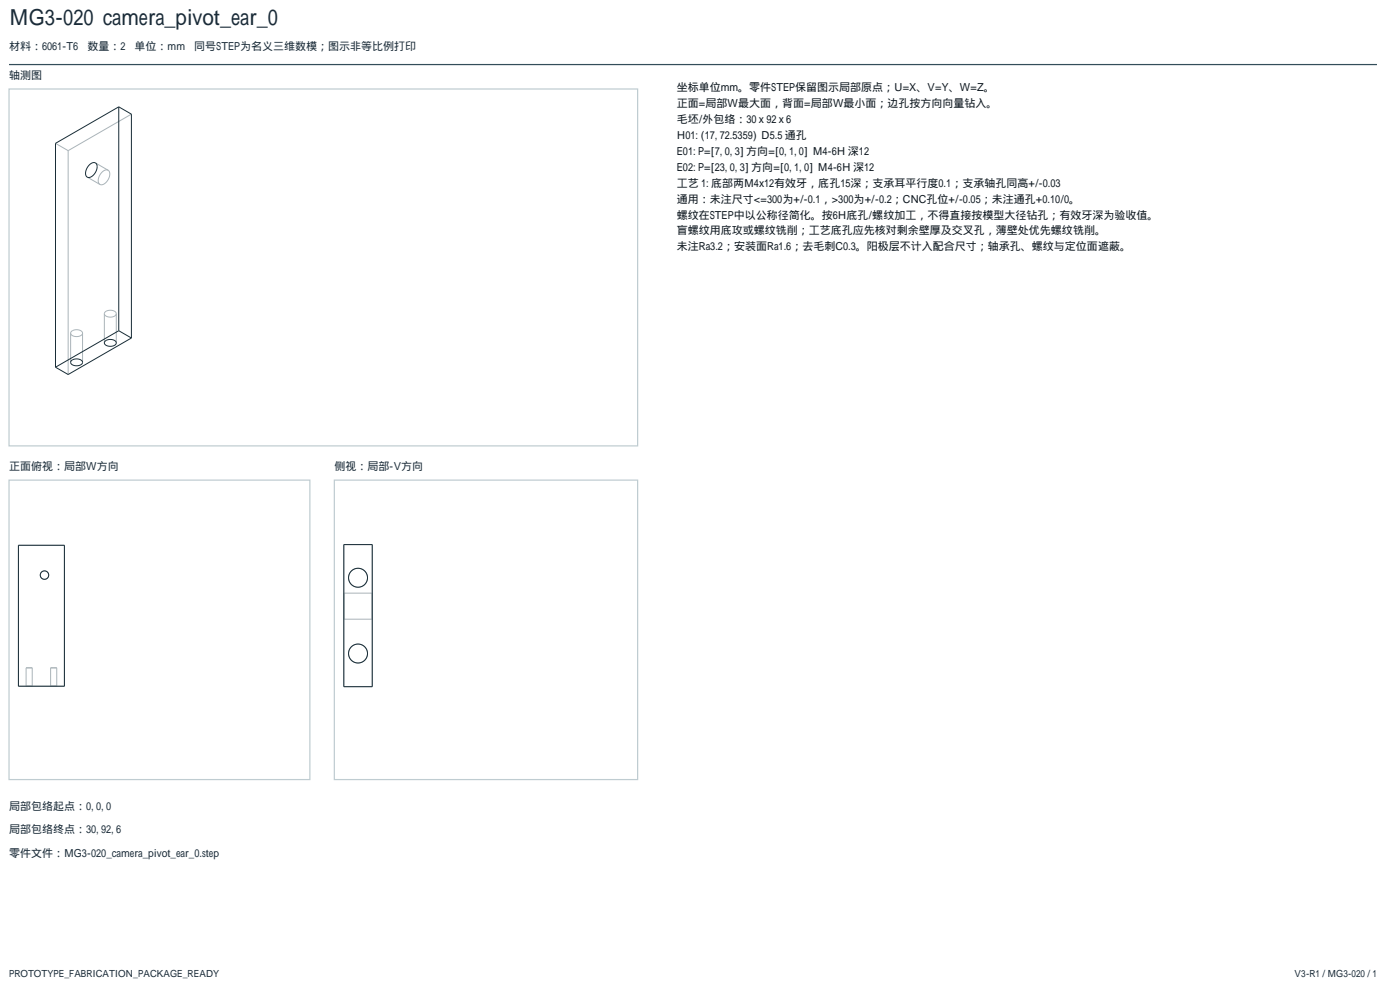
[picture p138: page 20]
轴测图; 正面俯视：局部W方向; 侧视：局部-V方向; 局部包络起点：0, 0, 0; 局部包络终点：30, 92, 6; 零件文件：MG3-020_camera_pivot_ear_0.step

材料：6061-T6 数量：2 单位：mm 同号STEP为名义三维数模；图示非等比例打印

坐标单位mm。零件STEP保留图示局部原点；U=X、V=Y、W=Z。
正面=局部W最大面，背面=局部W最小面；边孔按方向向量钻入。
毛坯/外包络：30 x 92 x 6
工艺 1: 底部两M4x12有效牙，底孔15深；支承耳平行度0.1；支承轴孔同高+/-0.03
通用：未注尺寸<=300为+/-0.1，>300为+/-0.2；CNC孔位+/-0.05；未注通孔+0.10/0。
螺纹在STEP中以公称径简化。按6H底孔/螺纹加工，不得直接按模型大径钻孔；有效牙深为验收值。
盲螺纹用底攻或螺纹铣削；工艺底孔应先核对剩余壁厚及交叉孔，薄壁处优先螺纹铣削。
未注Ra3.2；安装面Ra1.6；去毛刺C0.3。阳极层不计入配合尺寸；轴承孔、螺纹与定位面遮蔽。

# MG3-021 camera_pivot_spacer_0

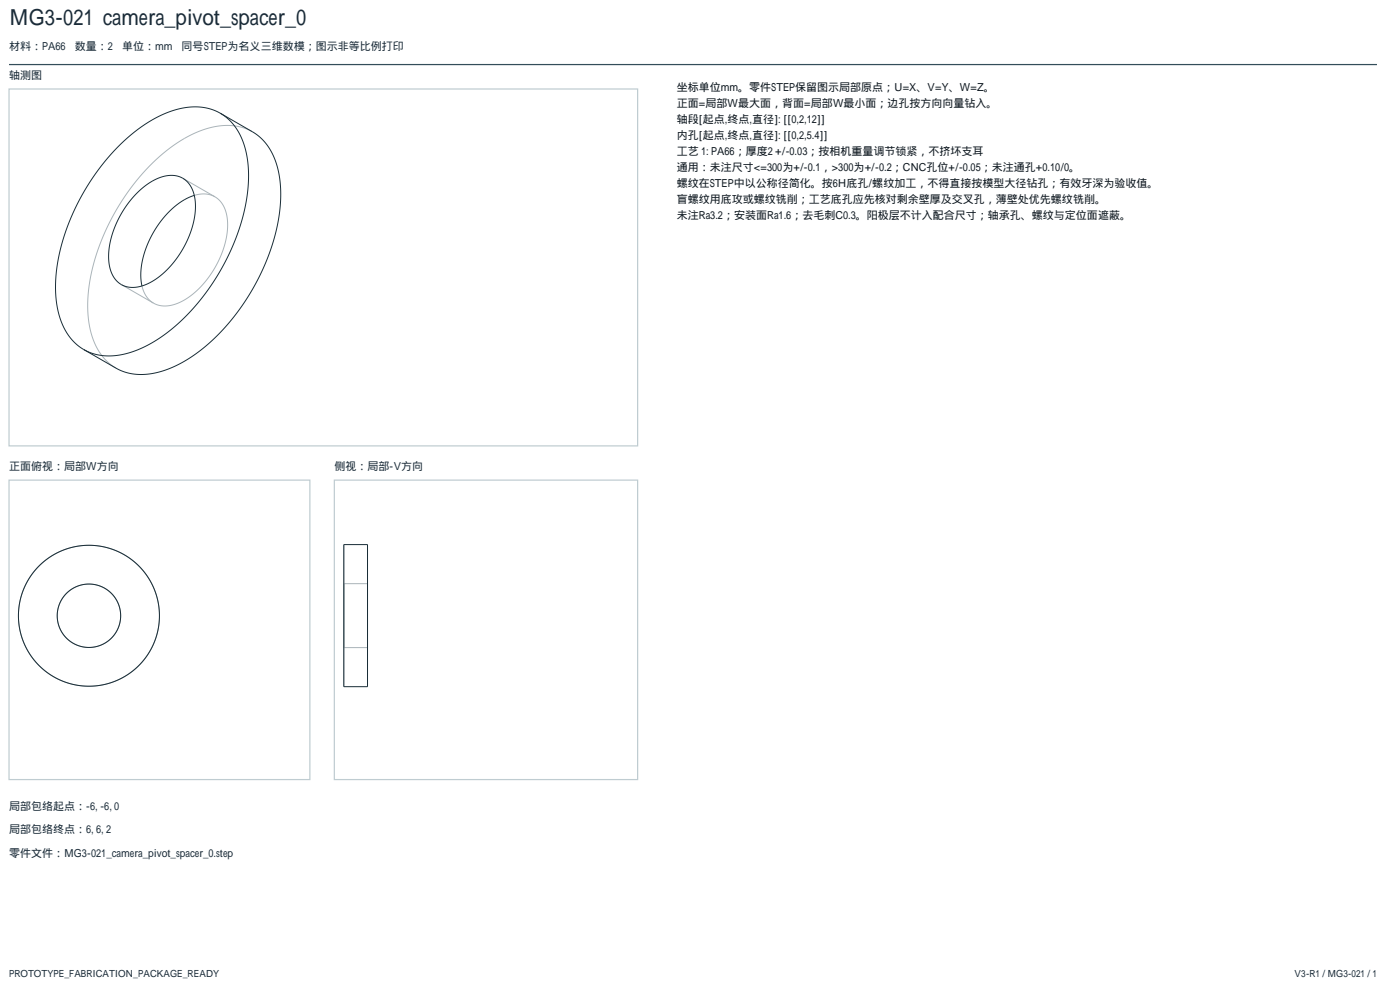
[picture p139: page 21]
轴测图; 正面俯视：局部W方向; 侧视：局部-V方向; 局部包络起点：-6, -6, 0; 局部包络终点：6, 6, 2; 零件文件：MG3-021_camera_pivot_spacer_0.step

材料：PA66 数量：2 单位：mm 同号STEP为名义三维数模；图示非等比例打印

坐标单位mm。零件STEP保留图示局部原点；U=X、V=Y、W=Z。
正面=局部W最大面，背面=局部W最小面；边孔按方向向量钻入。
工艺 1: PA66；厚度2 +/-0.03；按相机重量调节锁紧，不挤坏支耳
通用：未注尺寸<=300为+/-0.1，>300为+/-0.2；CNC孔位+/-0.05；未注通孔+0.10/0。
螺纹在STEP中以公称径简化。按6H底孔/螺纹加工，不得直接按模型大径钻孔；有效牙深为验收值。
盲螺纹用底攻或螺纹铣削；工艺底孔应先核对剩余壁厚及交叉孔，薄壁处优先螺纹铣削。
未注Ra3.2；安装面Ra1.6；去毛刺C0.3。阳极层不计入配合尺寸；轴承孔、螺纹与定位面遮蔽。

# MG3-022 camera_removable_panel

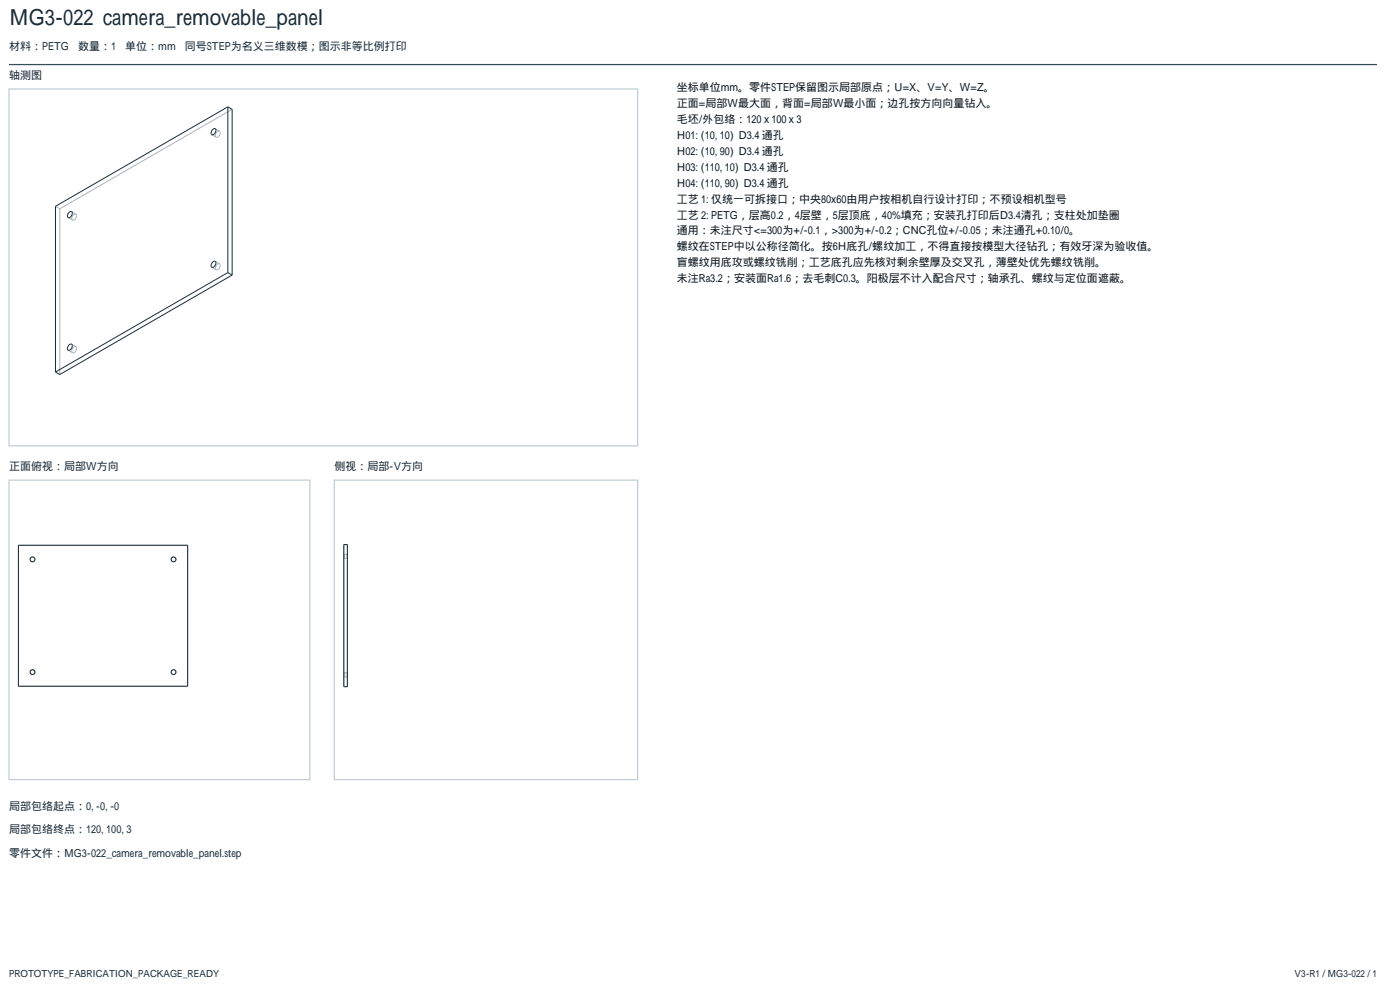
[picture p140: page 22]
轴测图; 正面俯视：局部W方向; 侧视：局部-V方向; 局部包络起点：0, -0, -0; 局部包络终点：120, 100, 3; 零件文件：MG3-022_camera_removable_panel.step

材料：PETG 数量：1 单位：mm 同号STEP为名义三维数模；图示非等比例打印

坐标单位mm。零件STEP保留图示局部原点；U=X、V=Y、W=Z。
正面=局部W最大面，背面=局部W最小面；边孔按方向向量钻入。
毛坯/外包络：120 x 100 x 3
工艺 1: 仅统一可拆接口；中央80x60由用户按相机自行设计打印；不预设相机型号
工艺 2: PETG，层高0.2，4层壁，5层顶底，40%填充；安装孔打印后D3.4清孔；支柱处加垫圈
通用：未注尺寸<=300为+/-0.1，>300为+/-0.2；CNC孔位+/-0.05；未注通孔+0.10/0。
螺纹在STEP中以公称径简化。按6H底孔/螺纹加工，不得直接按模型大径钻孔；有效牙深为验收值。
盲螺纹用底攻或螺纹铣削；工艺底孔应先核对剩余壁厚及交叉孔，薄壁处优先螺纹铣削。
未注Ra3.2；安装面Ra1.6；去毛刺C0.3。阳极层不计入配合尺寸；轴承孔、螺纹与定位面遮蔽。

# MG3-023 camera_tilt_carrier

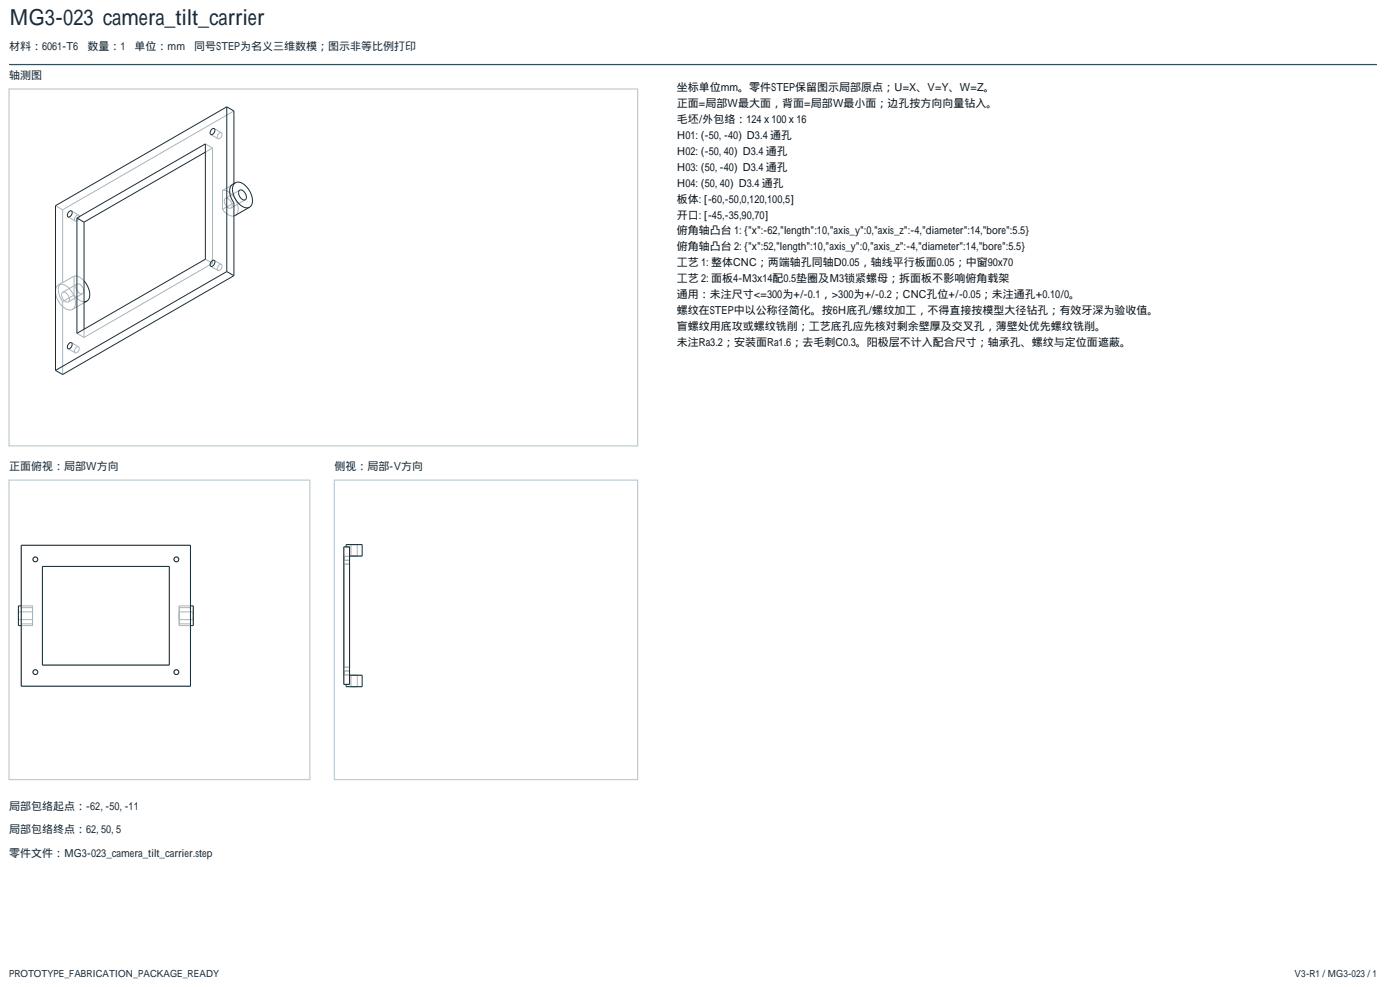
[picture p141: page 23]
轴测图; 正面俯视：局部W方向; 侧视：局部-V方向; 局部包络起点：-62, -50, -11; 局部包络终点：62, 50, 5; 零件文件：MG3-023_camera_tilt_carrier.step

材料：6061-T6 数量：1 单位：mm 同号STEP为名义三维数模；图示非等比例打印

坐标单位mm。零件STEP保留图示局部原点；U=X、V=Y、W=Z。
正面=局部W最大面，背面=局部W最小面；边孔按方向向量钻入。
毛坯/外包络：124 x 100 x 16
俯角轴凸台 1: {"x":-62,"length":10,"axis_y":0,"axis_z":-4,"diameter":14,"bore":5.5}
俯角轴凸台 2: {"x":52,"length":10,"axis_y":0,"axis_z":-4,"diameter":14,"bore":5.5}
工艺 1: 整体CNC；两端轴孔同轴D0.05，轴线平行板面0.05；中窗90x70
工艺 2: 面板4-M3x14配0.5垫圈及M3锁紧螺母；拆面板不影响俯角载架
通用：未注尺寸<=300为+/-0.1，>300为+/-0.2；CNC孔位+/-0.05；未注通孔+0.10/0。
螺纹在STEP中以公称径简化。按6H底孔/螺纹加工，不得直接按模型大径钻孔；有效牙深为验收值。
盲螺纹用底攻或螺纹铣削；工艺底孔应先核对剩余壁厚及交叉孔，薄壁处优先螺纹铣削。
未注Ra3.2；安装面Ra1.6；去毛刺C0.3。阳极层不计入配合尺寸；轴承孔、螺纹与定位面遮蔽。

# MG3-024 compute_combo_plate

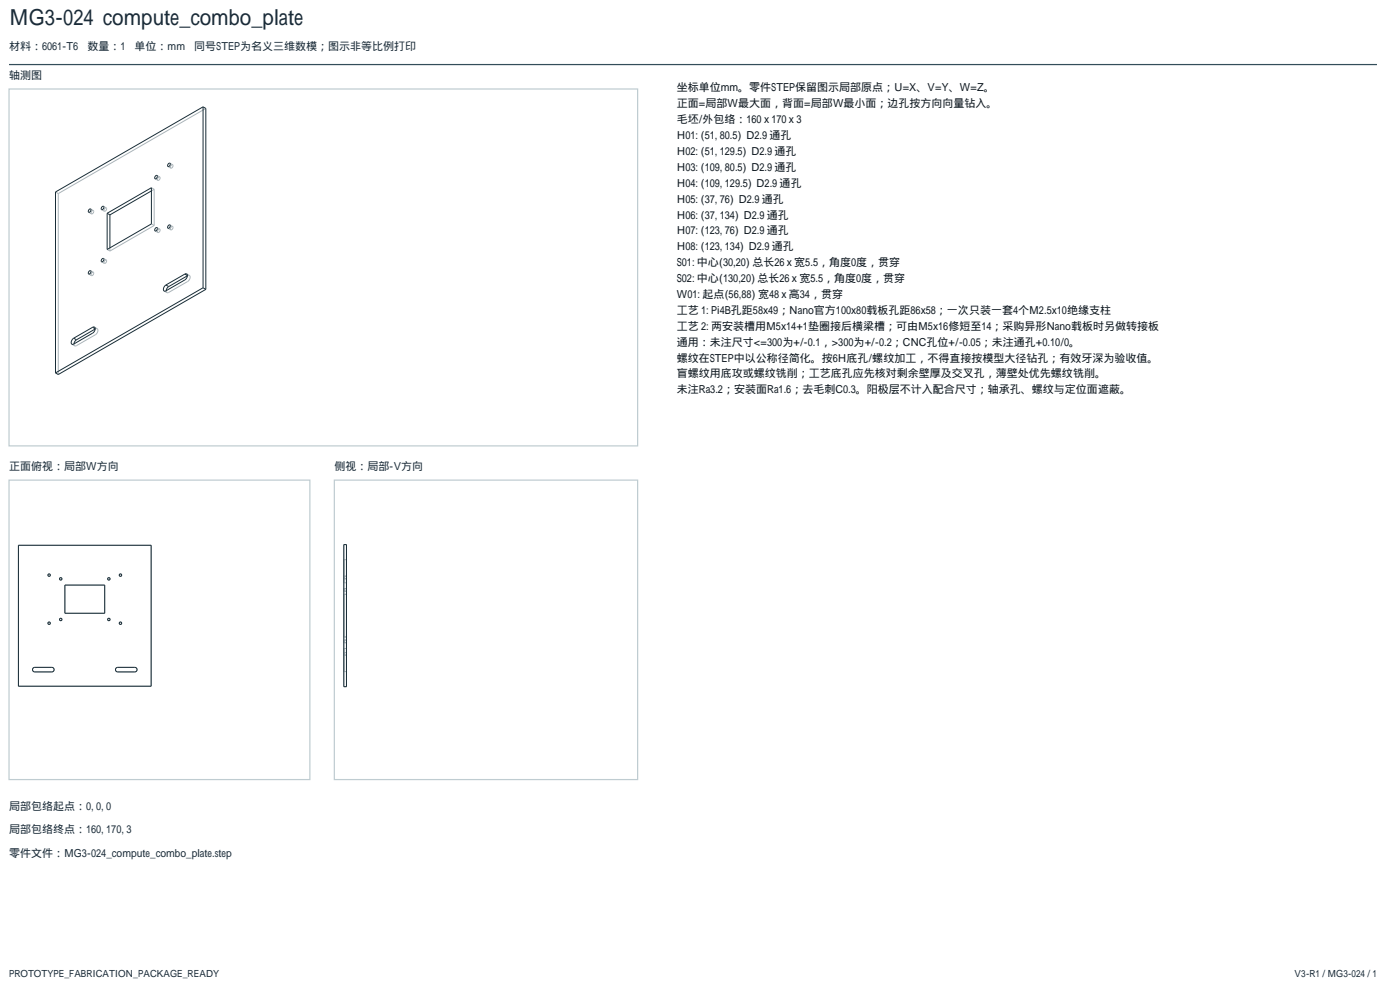
[picture p142: page 24]
轴测图; 正面俯视：局部W方向; 侧视：局部-V方向; 局部包络起点：0, 0, 0; 局部包络终点：160, 170, 3; 零件文件：MG3-024_compute_combo_plate.step

材料：6061-T6 数量：1 单位：mm 同号STEP为名义三维数模；图示非等比例打印

坐标单位mm。零件STEP保留图示局部原点；U=X、V=Y、W=Z。
正面=局部W最大面，背面=局部W最小面；边孔按方向向量钻入。
毛坯/外包络：160 x 170 x 3
工艺 1: Pi4B孔距58x49；Nano官方100x80载板孔距86x58；一次只装一套4个M2.5x10绝缘支柱
工艺 2: 两安装槽用M5x14+1垫圈接后横梁槽；可由M5x16修短至14；采购异形Nano载板时另做转接板
通用：未注尺寸<=300为+/-0.1，>300为+/-0.2；CNC孔位+/-0.05；未注通孔+0.10/0。
螺纹在STEP中以公称径简化。按6H底孔/螺纹加工，不得直接按模型大径钻孔；有效牙深为验收值。
盲螺纹用底攻或螺纹铣削；工艺底孔应先核对剩余壁厚及交叉孔，薄壁处优先螺纹铣削。
未注Ra3.2；安装面Ra1.6；去毛刺C0.3。阳极层不计入配合尺寸；轴承孔、螺纹与定位面遮蔽。

# MG3-025 controller_tray

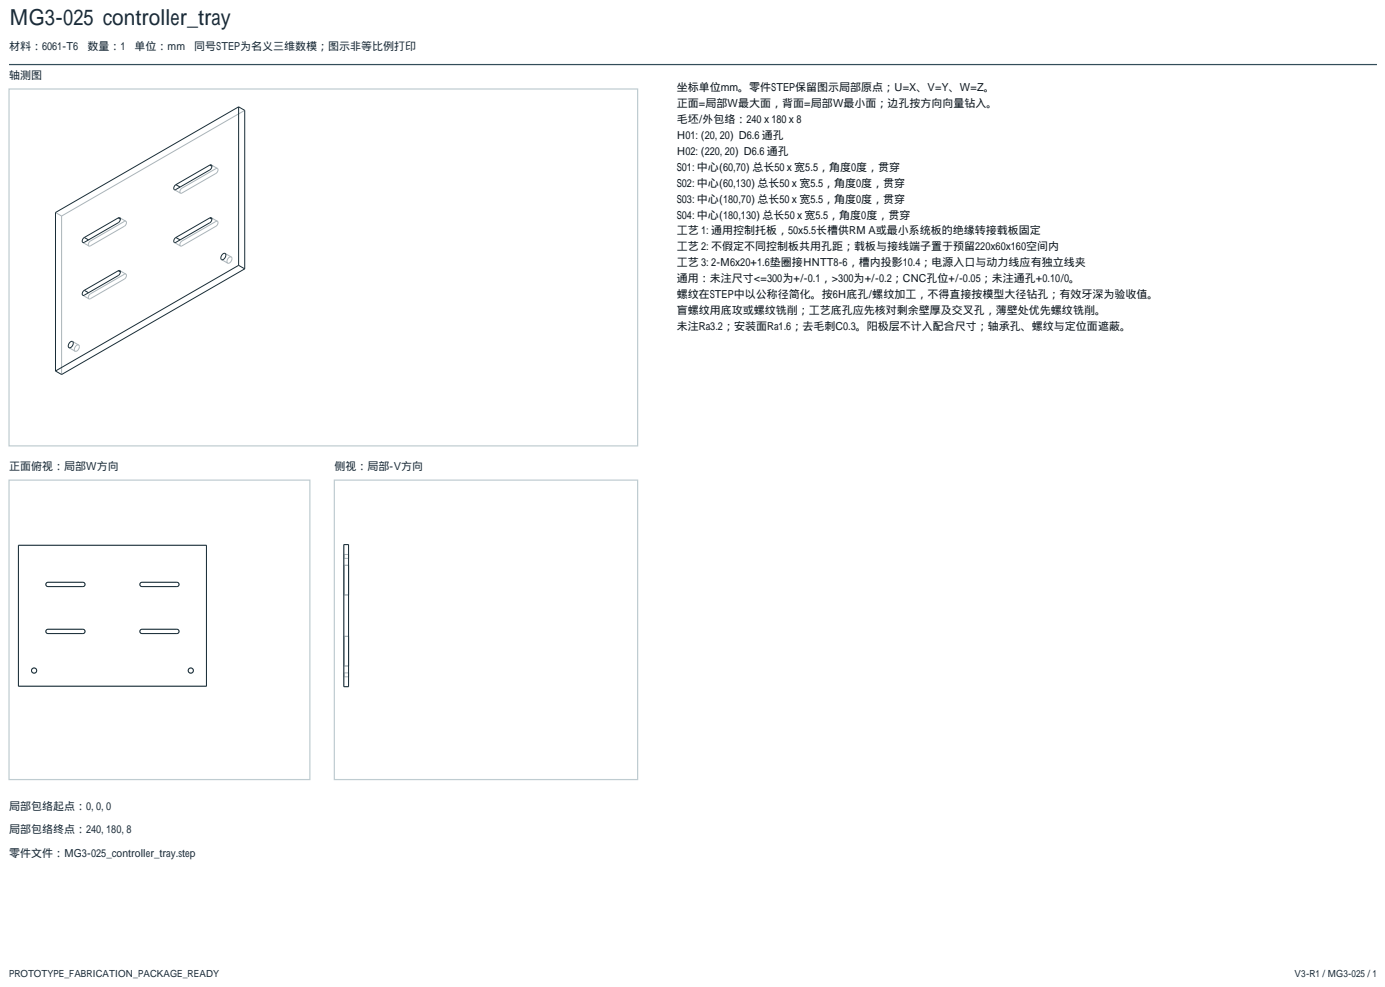
[picture p143: page 25]
轴测图; 正面俯视：局部W方向; 侧视：局部-V方向; 局部包络起点：0, 0, 0; 局部包络终点：240, 180, 8; 零件文件：MG3-025_controller_tray.step

材料：6061-T6 数量：1 单位：mm 同号STEP为名义三维数模；图示非等比例打印

坐标单位mm。零件STEP保留图示局部原点；U=X、V=Y、W=Z。
正面=局部W最大面，背面=局部W最小面；边孔按方向向量钻入。
毛坯/外包络：240 x 180 x 8
工艺 1: 通用控制托板，50x5.5长槽供RM A或最小系统板的绝缘转接载板固定
工艺 2: 不假定不同控制板共用孔距；载板与接线端子置于预留220x60x160空间内
工艺 3: 2-M6x20+1.6垫圈接HNTT8-6，槽内投影10.4；电源入口与动力线应有独立线夹
通用：未注尺寸<=300为+/-0.1，>300为+/-0.2；CNC孔位+/-0.05；未注通孔+0.10/0。
螺纹在STEP中以公称径简化。按6H底孔/螺纹加工，不得直接按模型大径钻孔；有效牙深为验收值。
盲螺纹用底攻或螺纹铣削；工艺底孔应先核对剩余壁厚及交叉孔，薄壁处优先螺纹铣削。
未注Ra3.2；安装面Ra1.6；去毛刺C0.3。阳极层不计入配合尺寸；轴承孔、螺纹与定位面遮蔽。

# MG3-026 fixed_head_side_0

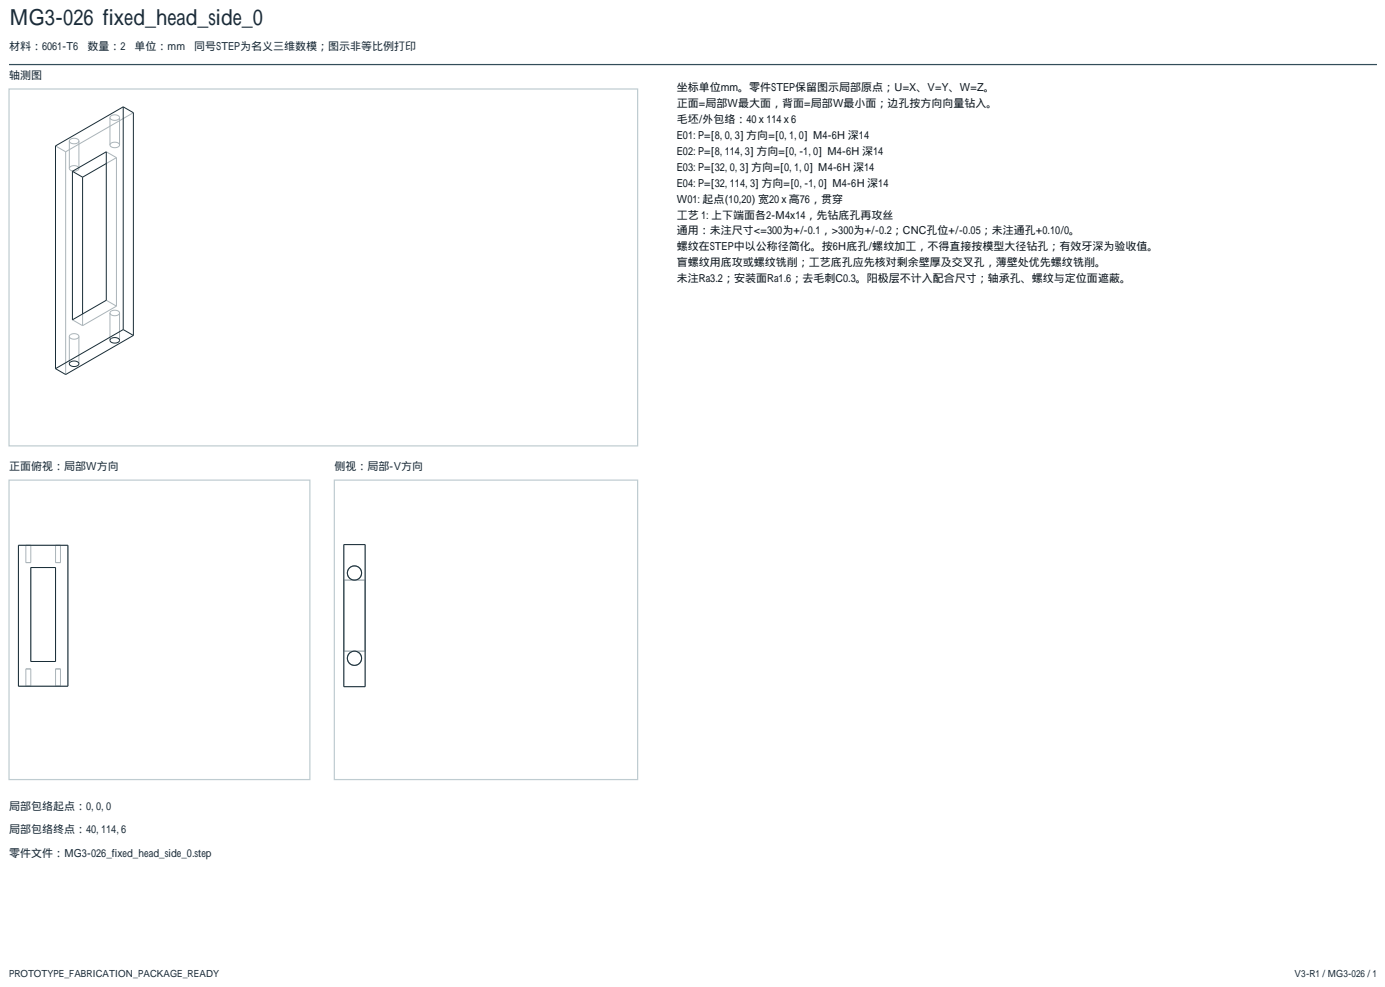
[picture p144: page 26]
轴测图; 正面俯视：局部W方向; 侧视：局部-V方向; 局部包络起点：0, 0, 0; 局部包络终点：40, 114, 6; 零件文件：MG3-026_fixed_head_side_0.step

材料：6061-T6 数量：2 单位：mm 同号STEP为名义三维数模；图示非等比例打印

坐标单位mm。零件STEP保留图示局部原点；U=X、V=Y、W=Z。
正面=局部W最大面，背面=局部W最小面；边孔按方向向量钻入。
毛坯/外包络：40 x 114 x 6
工艺 1: 上下端面各2-M4x14，先钻底孔再攻丝
通用：未注尺寸<=300为+/-0.1，>300为+/-0.2；CNC孔位+/-0.05；未注通孔+0.10/0。
螺纹在STEP中以公称径简化。按6H底孔/螺纹加工，不得直接按模型大径钻孔；有效牙深为验收值。
盲螺纹用底攻或螺纹铣削；工艺底孔应先核对剩余壁厚及交叉孔，薄壁处优先螺纹铣削。
未注Ra3.2；安装面Ra1.6；去毛刺C0.3。阳极层不计入配合尺寸；轴承孔、螺纹与定位面遮蔽。

# MG3-027 fixed_head_top

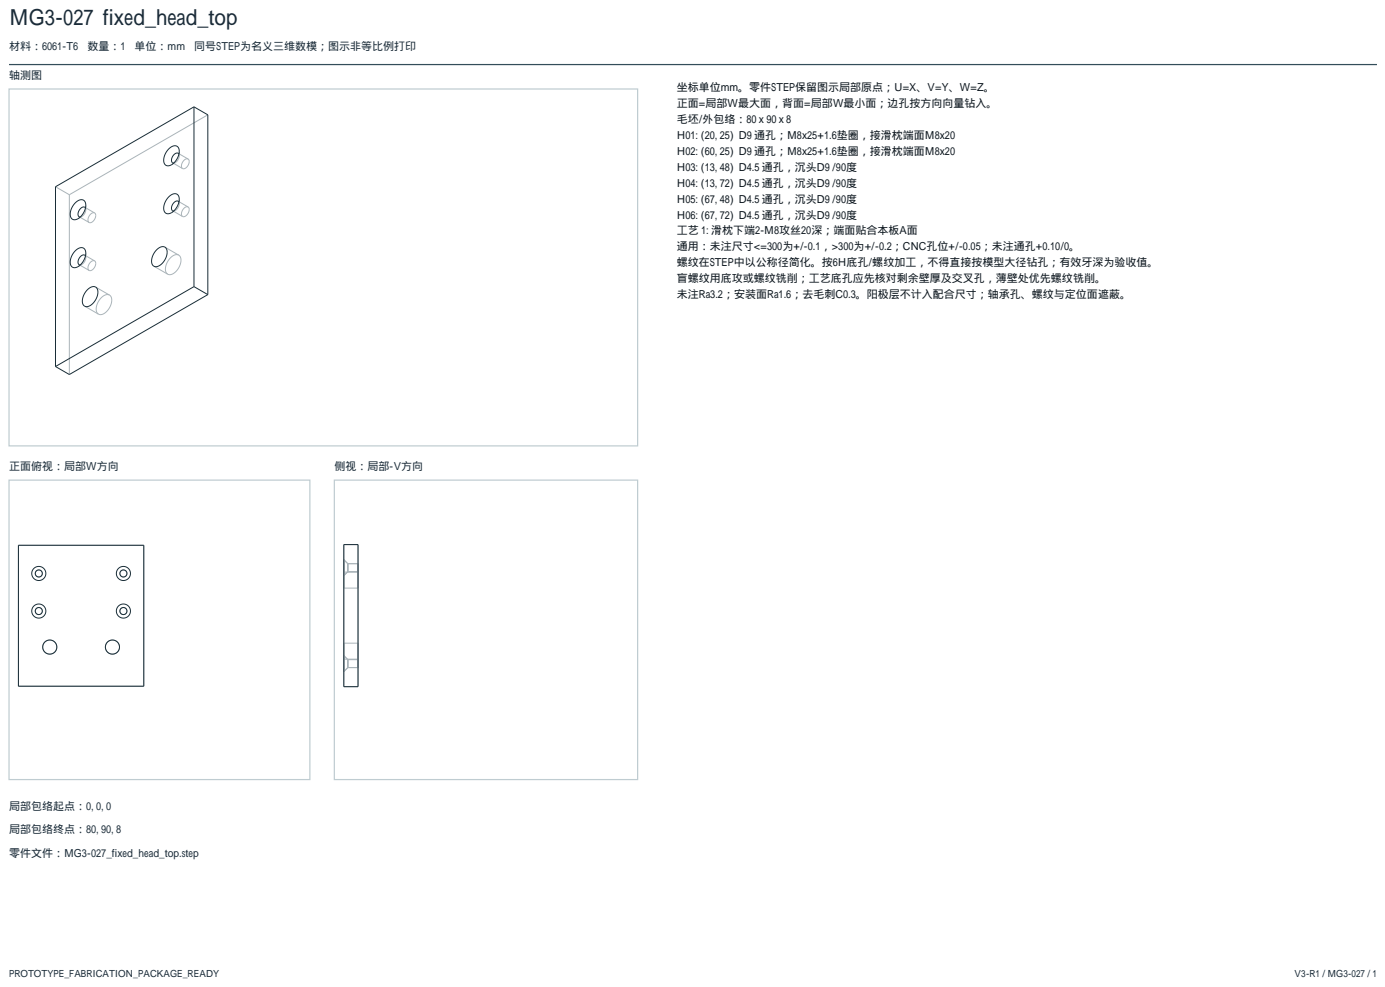
[picture p145: page 27]
轴测图; 正面俯视：局部W方向; 侧视：局部-V方向; 局部包络起点：0, 0, 0; 局部包络终点：80, 90, 8; 零件文件：MG3-027_fixed_head_top.step

材料：6061-T6 数量：1 单位：mm 同号STEP为名义三维数模；图示非等比例打印

坐标单位mm。零件STEP保留图示局部原点；U=X、V=Y、W=Z。
正面=局部W最大面，背面=局部W最小面；边孔按方向向量钻入。
毛坯/外包络：80 x 90 x 8
H01: (20, 25) D9 通孔；M8x25+1.6垫圈，接滑枕端面M8x20
H02: (60, 25) D9 通孔；M8x25+1.6垫圈，接滑枕端面M8x20
H03: (13, 48) D4.5 通孔，沉头D9 /90度
H04: (13, 72) D4.5 通孔，沉头D9 /90度
H05: (67, 48) D4.5 通孔，沉头D9 /90度
H06: (67, 72) D4.5 通孔，沉头D9 /90度
工艺 1: 滑枕下端2-M8攻丝20深；端面贴合本板A面
通用：未注尺寸<=300为+/-0.1，>300为+/-0.2；CNC孔位+/-0.05；未注通孔+0.10/0。
螺纹在STEP中以公称径简化。按6H底孔/螺纹加工，不得直接按模型大径钻孔；有效牙深为验收值。
盲螺纹用底攻或螺纹铣削；工艺底孔应先核对剩余壁厚及交叉孔，薄壁处优先螺纹铣削。
未注Ra3.2；安装面Ra1.6；去毛刺C0.3。阳极层不计入配合尺寸；轴承孔、螺纹与定位面遮蔽。

# MG3-028 frame_corner_front_0_0

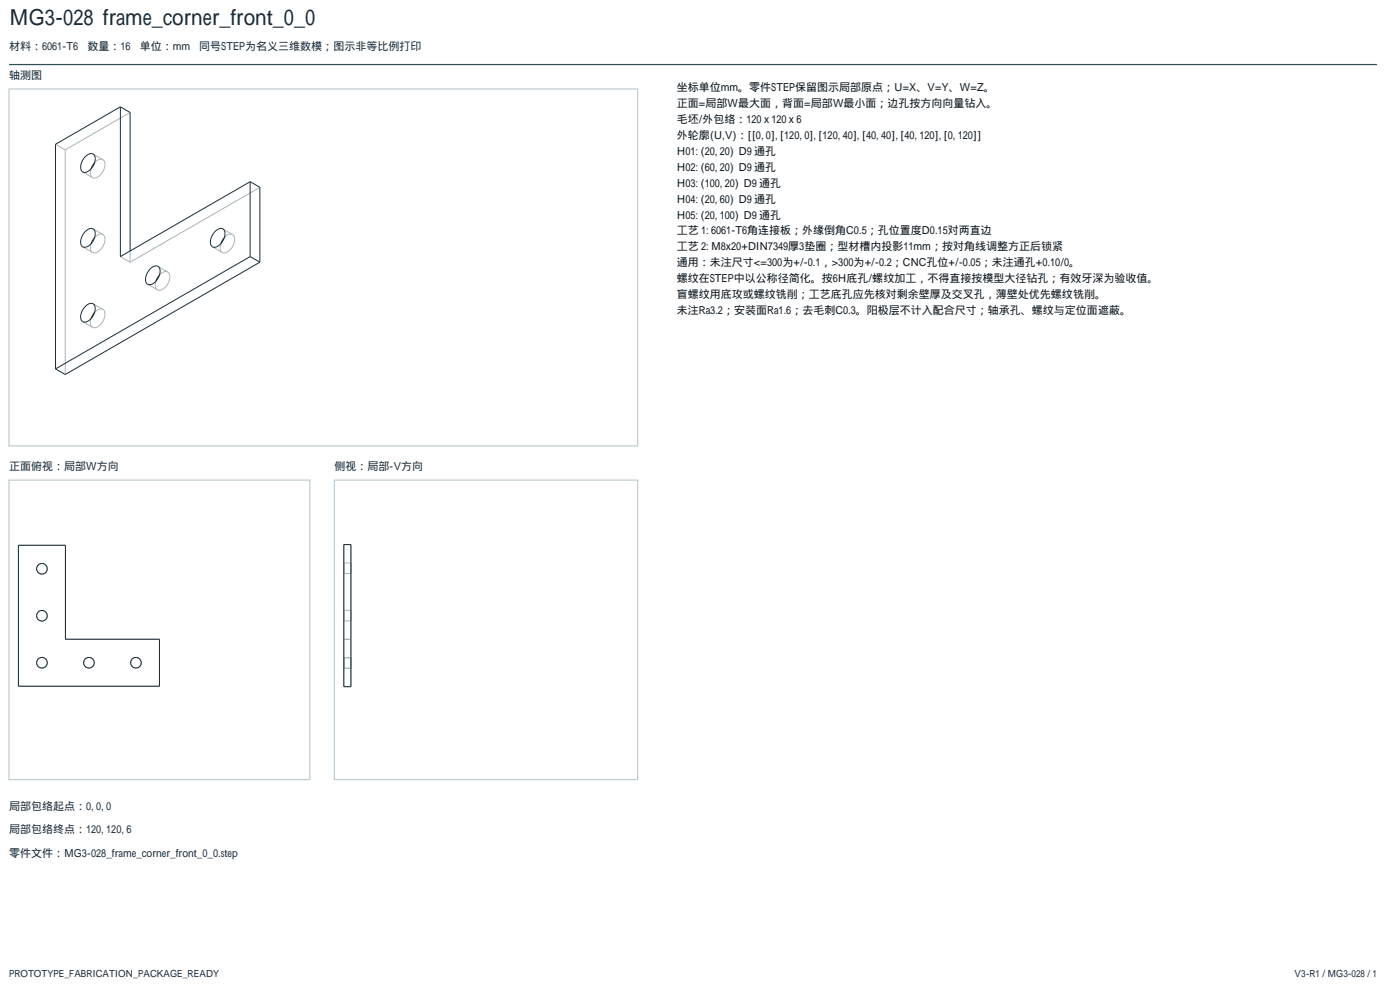
[picture p146: page 28]
轴测图; 正面俯视：局部W方向; 侧视：局部-V方向; 局部包络起点：0, 0, 0; 局部包络终点：120, 120, 6; 零件文件：MG3-028_frame_corner_front_0_0.step

材料：6061-T6 数量：16 单位：mm 同号STEP为名义三维数模；图示非等比例打印

坐标单位mm。零件STEP保留图示局部原点；U=X、V=Y、W=Z。
正面=局部W最大面，背面=局部W最小面；边孔按方向向量钻入。
毛坯/外包络：120 x 120 x 6
外轮廓(U,V)：[[0, 0], [120, 0], [120, 40], [40, 40], [40, 120], [0, 120]]
工艺 1: 6061-T6角连接板；外缘倒角C0.5；孔位置度D0.15对两直边
工艺 2: M8x20+DIN7349厚3垫圈；型材槽内投影11mm；按对角线调整方正后锁紧
通用：未注尺寸<=300为+/-0.1，>300为+/-0.2；CNC孔位+/-0.05；未注通孔+0.10/0。
螺纹在STEP中以公称径简化。按6H底孔/螺纹加工，不得直接按模型大径钻孔；有效牙深为验收值。
盲螺纹用底攻或螺纹铣削；工艺底孔应先核对剩余壁厚及交叉孔，薄壁处优先螺纹铣削。
未注Ra3.2；安装面Ra1.6；去毛刺C0.3。阳极层不计入配合尺寸；轴承孔、螺纹与定位面遮蔽。

# MG3-029 gripper_adapter

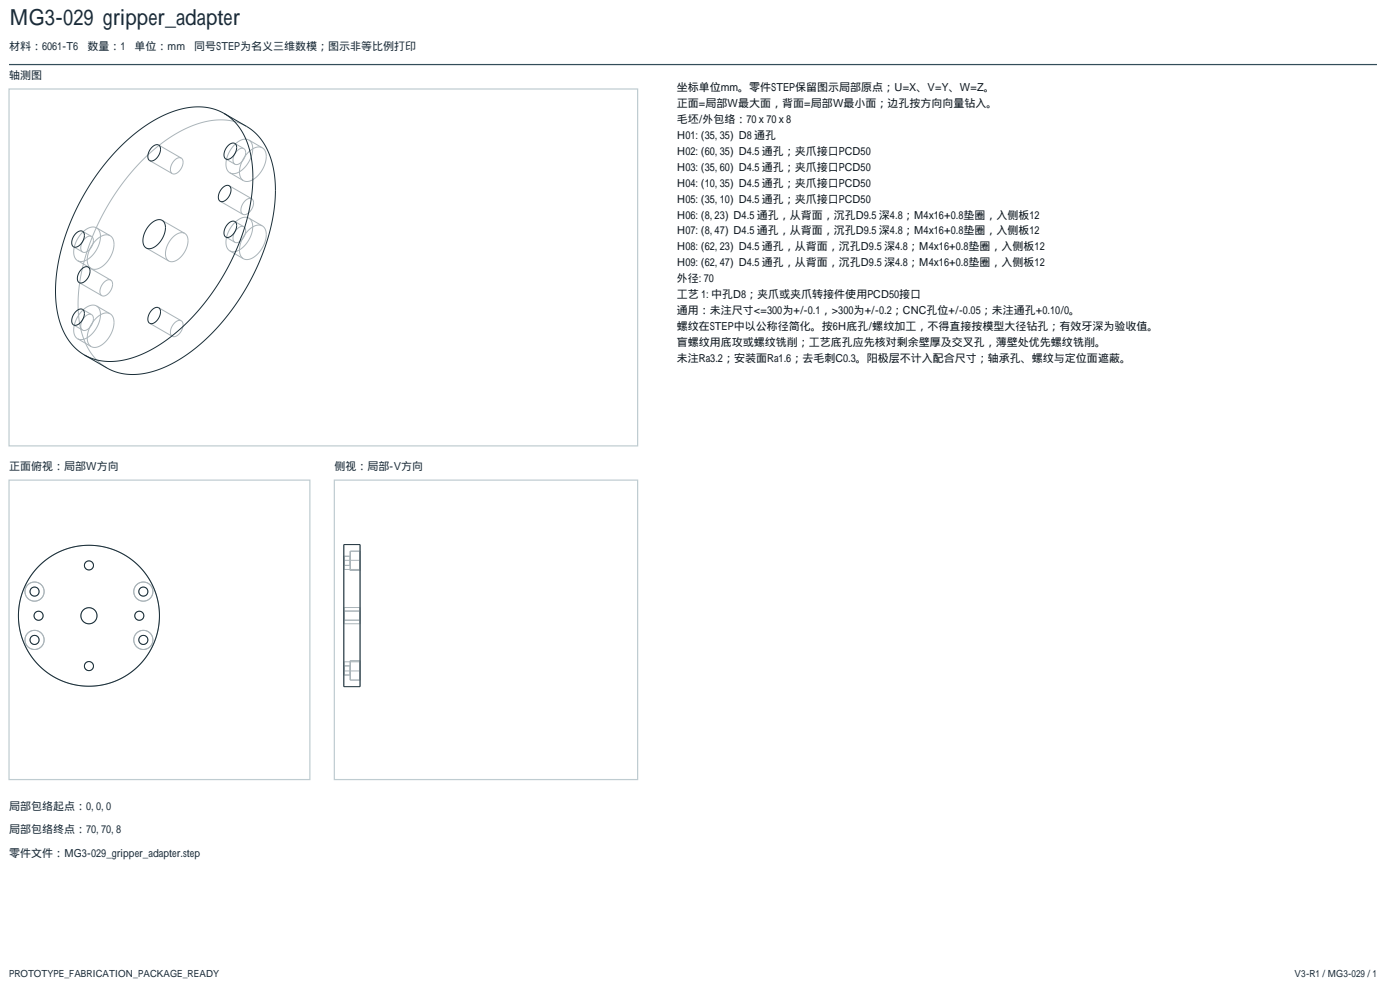
[picture p147: page 29]
轴测图; 正面俯视：局部W方向; 侧视：局部-V方向; 局部包络起点：0, 0, 0; 局部包络终点：70, 70, 8; 零件文件：MG3-029_gripper_adapter.step

材料：6061-T6 数量：1 单位：mm 同号STEP为名义三维数模；图示非等比例打印

坐标单位mm。零件STEP保留图示局部原点；U=X、V=Y、W=Z。
正面=局部W最大面，背面=局部W最小面；边孔按方向向量钻入。
毛坯/外包络：70 x 70 x 8
H02: (60, 35) D4.5 通孔；夹爪接口PCD50
H03: (35, 60) D4.5 通孔；夹爪接口PCD50
H04: (10, 35) D4.5 通孔；夹爪接口PCD50
H05: (35, 10) D4.5 通孔；夹爪接口PCD50
H06: (8, 23) D4.5 通孔，从背面，沉孔D9.5 深4.8；M4x16+0.8垫圈，入侧板12
H07: (8, 47) D4.5 通孔，从背面，沉孔D9.5 深4.8；M4x16+0.8垫圈，入侧板12
H08: (62, 23) D4.5 通孔，从背面，沉孔D9.5 深4.8；M4x16+0.8垫圈，入侧板12
H09: (62, 47) D4.5 通孔，从背面，沉孔D9.5 深4.8；M4x16+0.8垫圈，入侧板12
工艺 1: 中孔D8；夹爪或夹爪转接件使用PCD50接口
通用：未注尺寸<=300为+/-0.1，>300为+/-0.2；CNC孔位+/-0.05；未注通孔+0.10/0。
螺纹在STEP中以公称径简化。按6H底孔/螺纹加工，不得直接按模型大径钻孔；有效牙深为验收值。
盲螺纹用底攻或螺纹铣削；工艺底孔应先核对剩余壁厚及交叉孔，薄壁处优先螺纹铣削。
未注Ra3.2；安装面Ra1.6；去毛刺C0.3。阳极层不计入配合尺寸；轴承孔、螺纹与定位面遮蔽。

# MG3-030 rear_brace_0

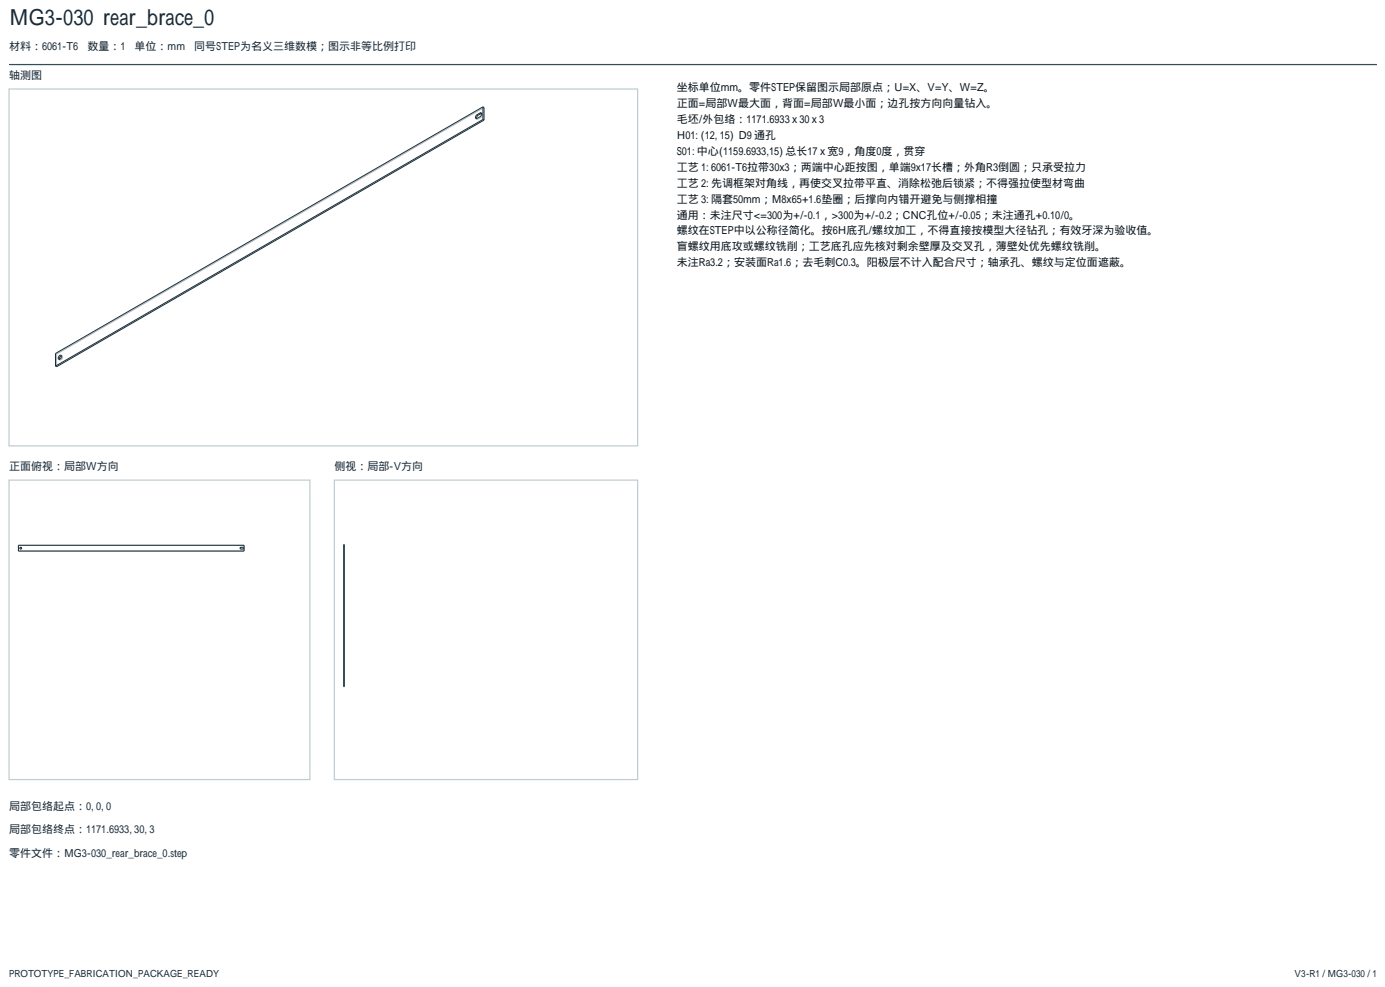
[picture p148: page 30]
轴测图; 正面俯视：局部W方向; 侧视：局部-V方向; 局部包络起点：0, 0, 0; 局部包络终点：1171.6933, 30, 3; 零件文件：MG3-030_rear_brace_0.step

材料：6061-T6 数量：1 单位：mm 同号STEP为名义三维数模；图示非等比例打印

坐标单位mm。零件STEP保留图示局部原点；U=X、V=Y、W=Z。
正面=局部W最大面，背面=局部W最小面；边孔按方向向量钻入。
毛坯/外包络：1171.6933 x 30 x 3
工艺 1: 6061-T6拉带30x3；两端中心距按图，单端9x17长槽；外角R3倒圆；只承受拉力
工艺 2: 先调框架对角线，再使交叉拉带平直、消除松弛后锁紧；不得强拉使型材弯曲
工艺 3: 隔套50mm；M8x65+1.6垫圈；后撑向内错开避免与侧撑相撞
通用：未注尺寸<=300为+/-0.1，>300为+/-0.2；CNC孔位+/-0.05；未注通孔+0.10/0。
螺纹在STEP中以公称径简化。按6H底孔/螺纹加工，不得直接按模型大径钻孔；有效牙深为验收值。
盲螺纹用底攻或螺纹铣削；工艺底孔应先核对剩余壁厚及交叉孔，薄壁处优先螺纹铣削。
未注Ra3.2；安装面Ra1.6；去毛刺C0.3。阳极层不计入配合尺寸；轴承孔、螺纹与定位面遮蔽。

# MG3-031 rear_brace_0_spacer_0

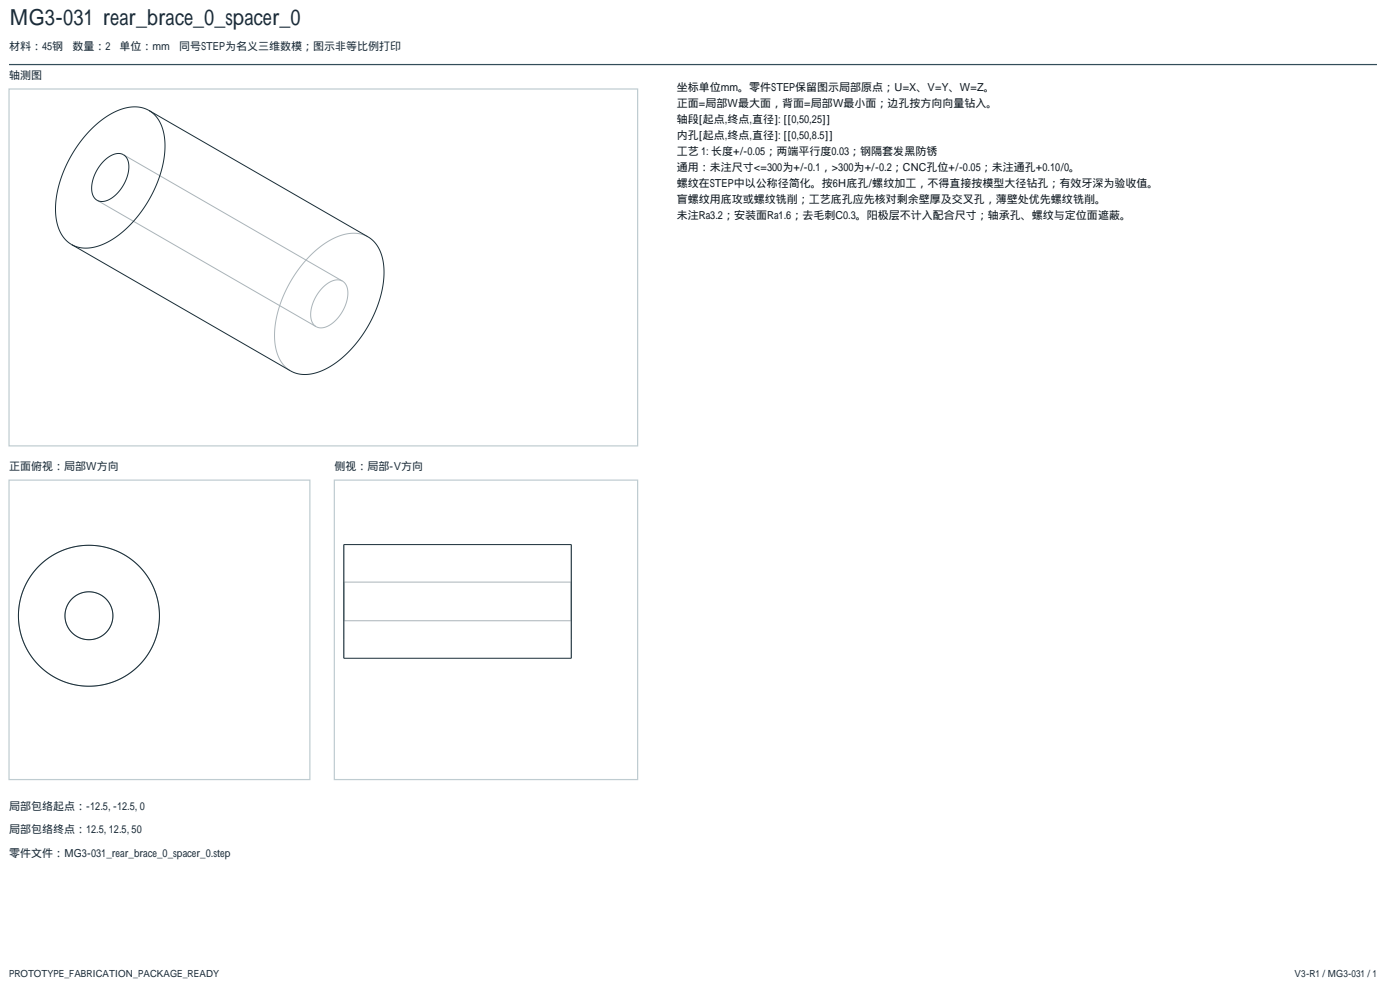
[picture p149: page 31]
轴测图; 正面俯视：局部W方向; 侧视：局部-V方向; 局部包络起点：-12.5, -12.5, 0; 局部包络终点：12.5, 12.5, 50; 零件文件：MG3-031_rear_brace_0_spacer_0.step

材料：45钢 数量：2 单位：mm 同号STEP为名义三维数模；图示非等比例打印

坐标单位mm。零件STEP保留图示局部原点；U=X、V=Y、W=Z。
正面=局部W最大面，背面=局部W最小面；边孔按方向向量钻入。
工艺 1: 长度+/-0.05；两端平行度0.03；钢隔套发黑防锈
通用：未注尺寸<=300为+/-0.1，>300为+/-0.2；CNC孔位+/-0.05；未注通孔+0.10/0。
螺纹在STEP中以公称径简化。按6H底孔/螺纹加工，不得直接按模型大径钻孔；有效牙深为验收值。
盲螺纹用底攻或螺纹铣削；工艺底孔应先核对剩余壁厚及交叉孔，薄壁处优先螺纹铣削。
未注Ra3.2；安装面Ra1.6；去毛刺C0.3。阳极层不计入配合尺寸；轴承孔、螺纹与定位面遮蔽。

# MG3-032 rear_brace_1

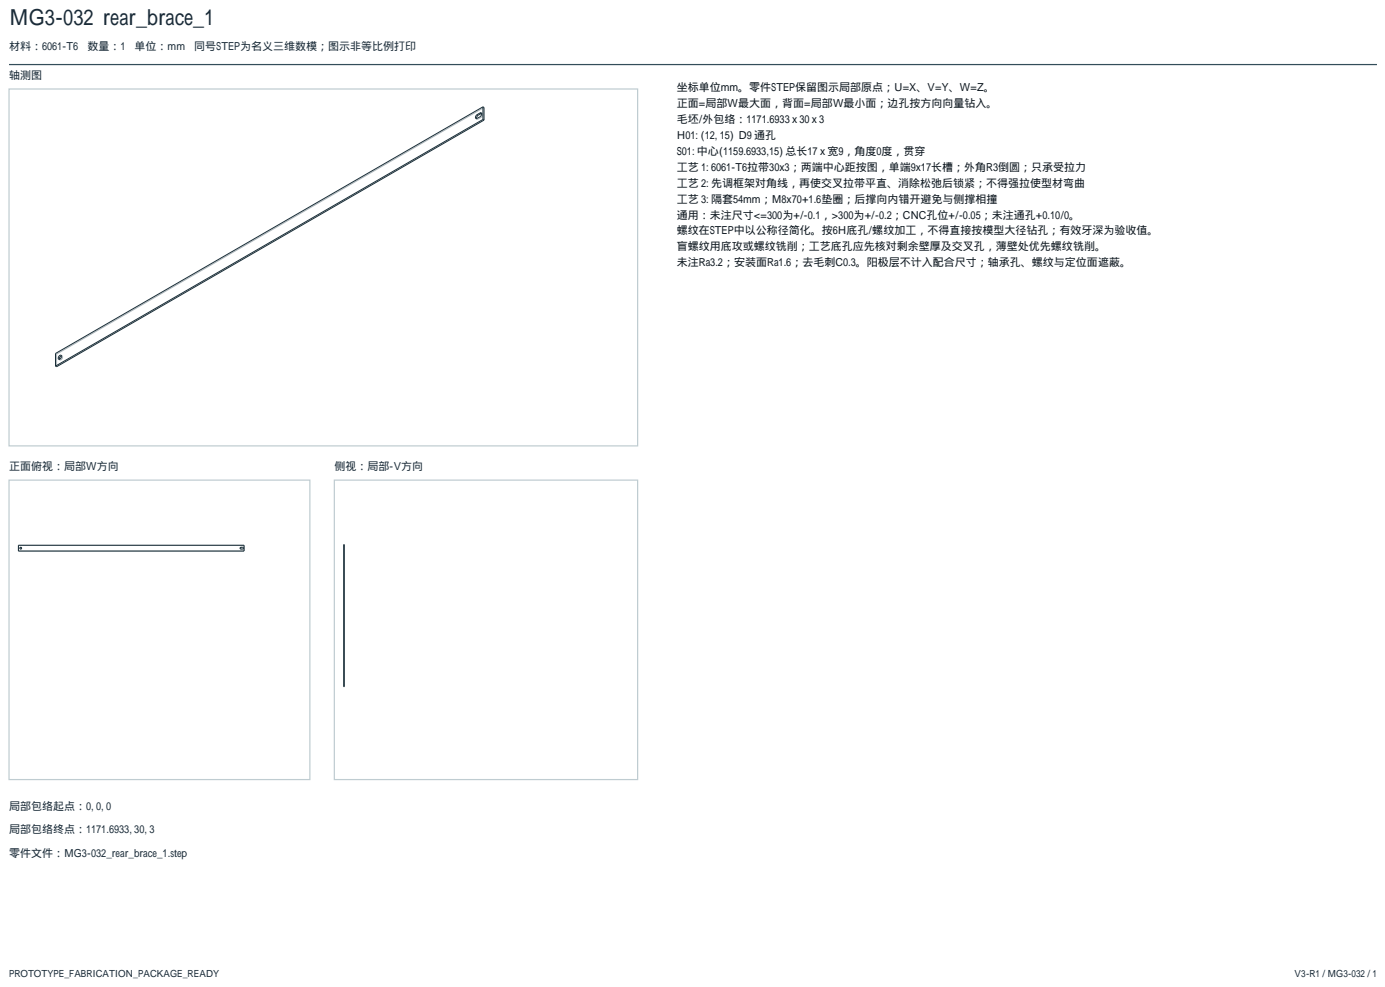
[picture p150: page 32]
轴测图; 正面俯视：局部W方向; 侧视：局部-V方向; 局部包络起点：0, 0, 0; 局部包络终点：1171.6933, 30, 3; 零件文件：MG3-032_rear_brace_1.step

材料：6061-T6 数量：1 单位：mm 同号STEP为名义三维数模；图示非等比例打印

坐标单位mm。零件STEP保留图示局部原点；U=X、V=Y、W=Z。
正面=局部W最大面，背面=局部W最小面；边孔按方向向量钻入。
毛坯/外包络：1171.6933 x 30 x 3
工艺 1: 6061-T6拉带30x3；两端中心距按图，单端9x17长槽；外角R3倒圆；只承受拉力
工艺 2: 先调框架对角线，再使交叉拉带平直、消除松弛后锁紧；不得强拉使型材弯曲
工艺 3: 隔套54mm；M8x70+1.6垫圈；后撑向内错开避免与侧撑相撞
通用：未注尺寸<=300为+/-0.1，>300为+/-0.2；CNC孔位+/-0.05；未注通孔+0.10/0。
螺纹在STEP中以公称径简化。按6H底孔/螺纹加工，不得直接按模型大径钻孔；有效牙深为验收值。
盲螺纹用底攻或螺纹铣削；工艺底孔应先核对剩余壁厚及交叉孔，薄壁处优先螺纹铣削。
未注Ra3.2；安装面Ra1.6；去毛刺C0.3。阳极层不计入配合尺寸；轴承孔、螺纹与定位面遮蔽。

# MG3-033 rear_brace_1_spacer_0

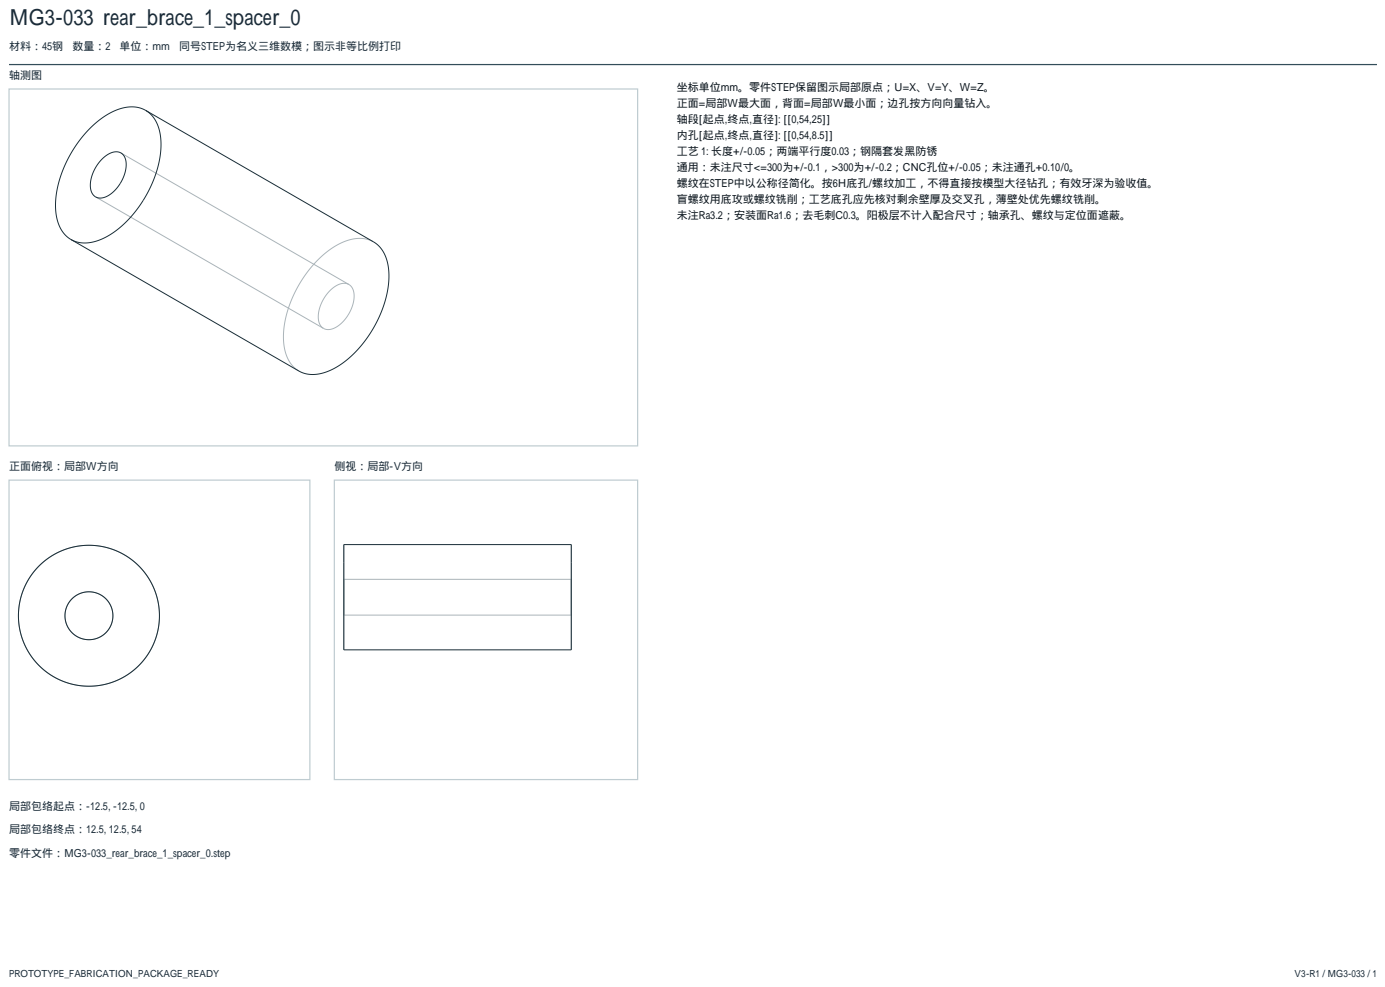
[picture p151: page 33]
轴测图; 正面俯视：局部W方向; 侧视：局部-V方向; 局部包络起点：-12.5, -12.5, 0; 局部包络终点：12.5, 12.5, 54; 零件文件：MG3-033_rear_brace_1_spacer_0.step

材料：45钢 数量：2 单位：mm 同号STEP为名义三维数模；图示非等比例打印

坐标单位mm。零件STEP保留图示局部原点；U=X、V=Y、W=Z。
正面=局部W最大面，背面=局部W最小面；边孔按方向向量钻入。
工艺 1: 长度+/-0.05；两端平行度0.03；钢隔套发黑防锈
通用：未注尺寸<=300为+/-0.1，>300为+/-0.2；CNC孔位+/-0.05；未注通孔+0.10/0。
螺纹在STEP中以公称径简化。按6H底孔/螺纹加工，不得直接按模型大径钻孔；有效牙深为验收值。
盲螺纹用底攻或螺纹铣削；工艺底孔应先核对剩余壁厚及交叉孔，薄壁处优先螺纹铣削。
未注Ra3.2；安装面Ra1.6；去毛刺C0.3。阳极层不计入配合尺寸；轴承孔、螺纹与定位面遮蔽。

# MG3-034 side_brace_0_0

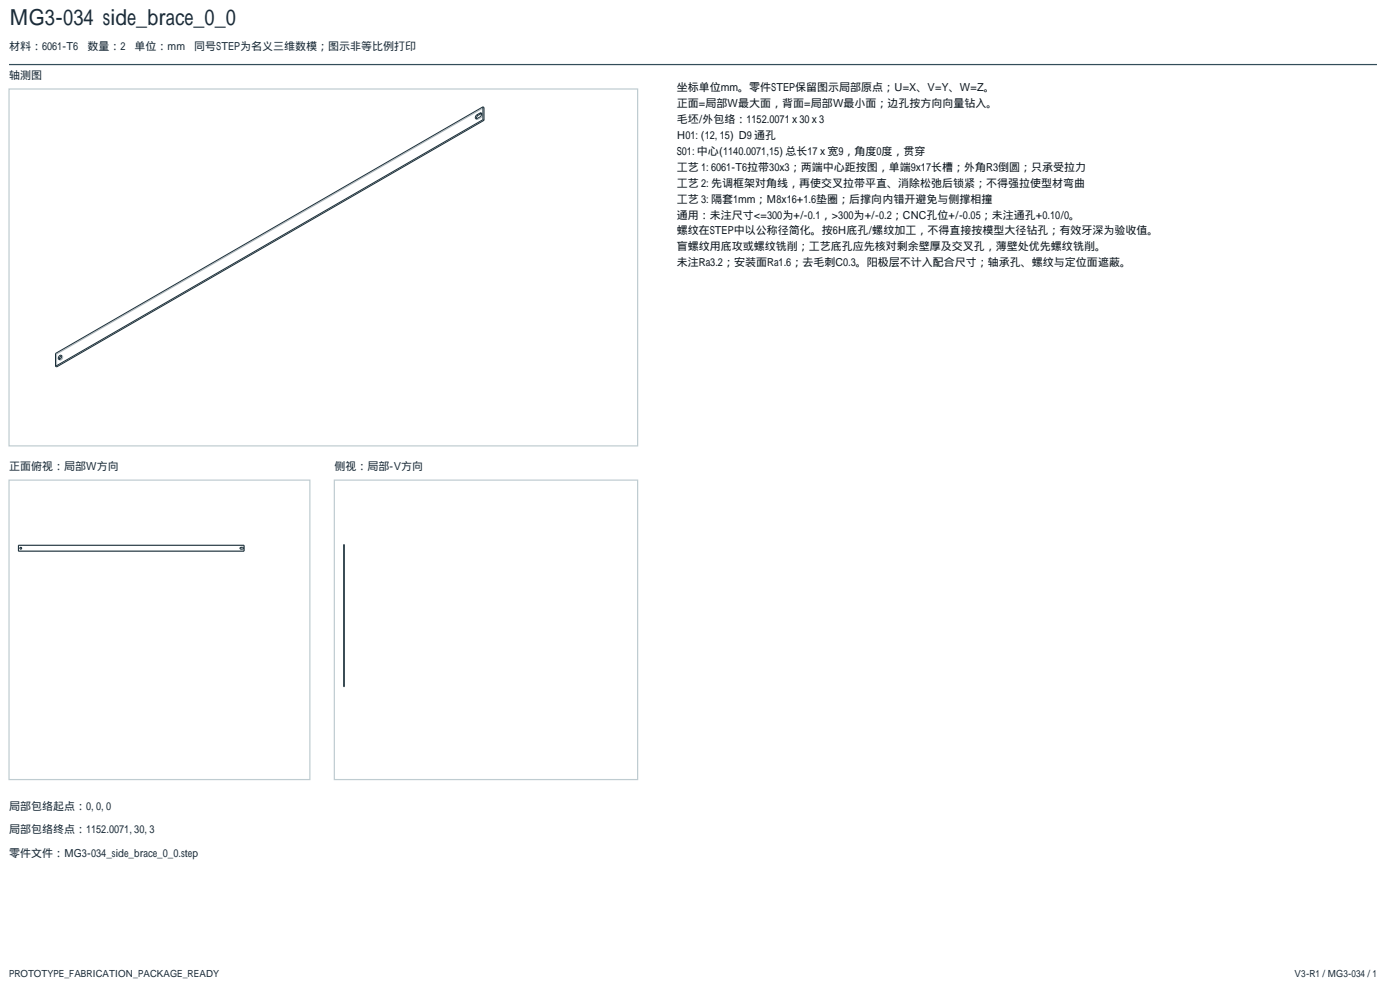
[picture p152: page 34]
轴测图; 正面俯视：局部W方向; 侧视：局部-V方向; 局部包络起点：0, 0, 0; 局部包络终点：1152.0071, 30, 3; 零件文件：MG3-034_side_brace_0_0.step

材料：6061-T6 数量：2 单位：mm 同号STEP为名义三维数模；图示非等比例打印

坐标单位mm。零件STEP保留图示局部原点；U=X、V=Y、W=Z。
正面=局部W最大面，背面=局部W最小面；边孔按方向向量钻入。
毛坯/外包络：1152.0071 x 30 x 3
工艺 1: 6061-T6拉带30x3；两端中心距按图，单端9x17长槽；外角R3倒圆；只承受拉力
工艺 2: 先调框架对角线，再使交叉拉带平直、消除松弛后锁紧；不得强拉使型材弯曲
工艺 3: 隔套1mm；M8x16+1.6垫圈；后撑向内错开避免与侧撑相撞
通用：未注尺寸<=300为+/-0.1，>300为+/-0.2；CNC孔位+/-0.05；未注通孔+0.10/0。
螺纹在STEP中以公称径简化。按6H底孔/螺纹加工，不得直接按模型大径钻孔；有效牙深为验收值。
盲螺纹用底攻或螺纹铣削；工艺底孔应先核对剩余壁厚及交叉孔，薄壁处优先螺纹铣削。
未注Ra3.2；安装面Ra1.6；去毛刺C0.3。阳极层不计入配合尺寸；轴承孔、螺纹与定位面遮蔽。

# MG3-035 side_brace_0_0_spacer_0

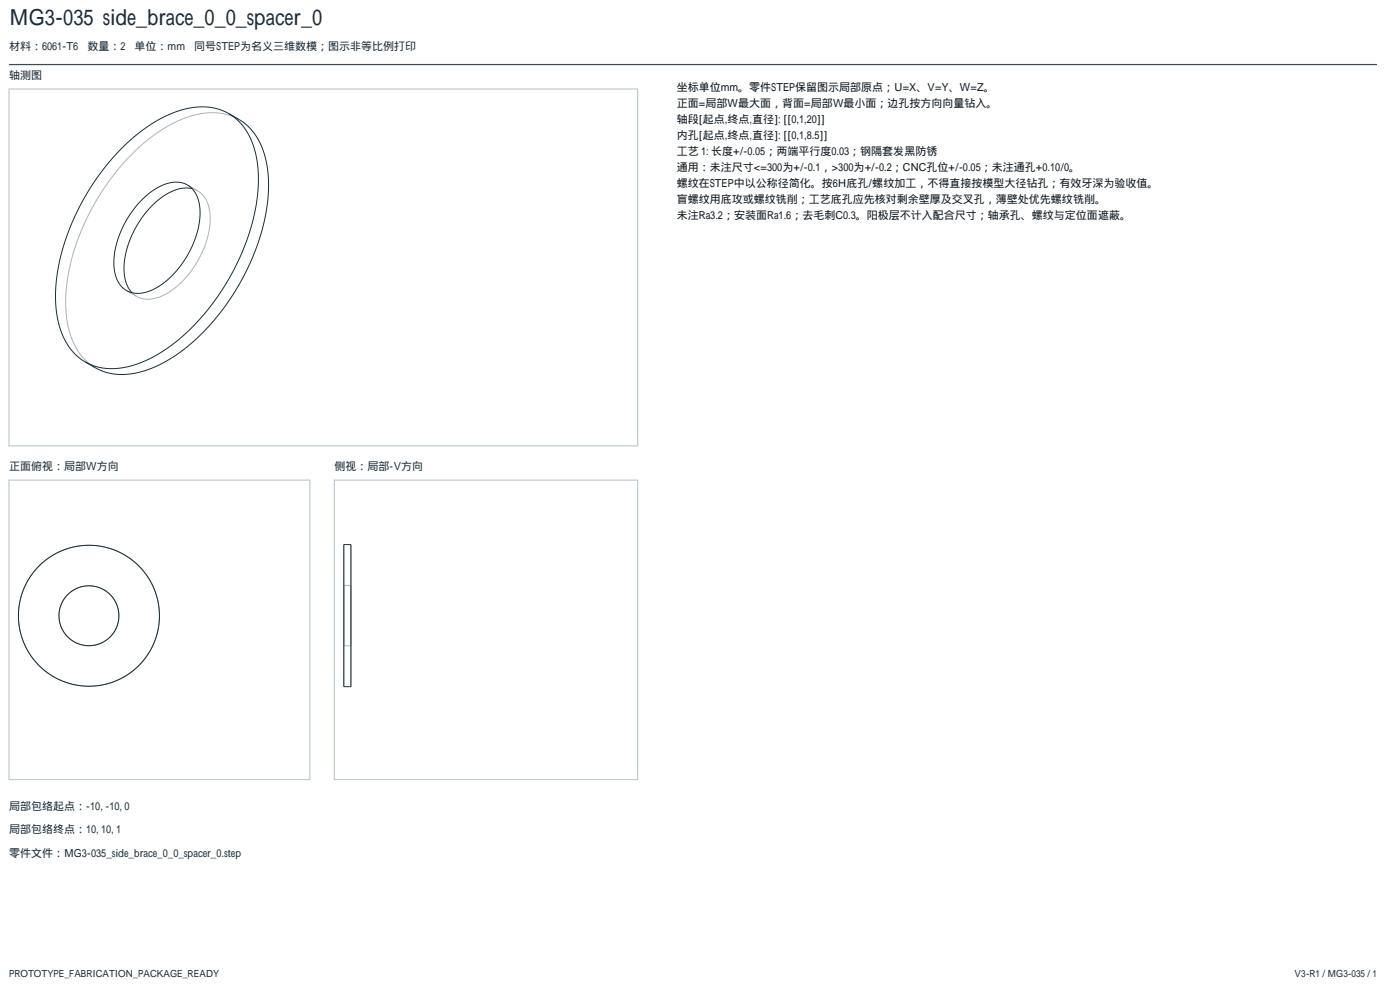
[picture p153: page 35]
轴测图; 正面俯视：局部W方向; 侧视：局部-V方向; 局部包络起点：-10, -10, 0; 局部包络终点：10, 10, 1; 零件文件：MG3-035_side_brace_0_0_spacer_0.step

材料：6061-T6 数量：2 单位：mm 同号STEP为名义三维数模；图示非等比例打印

坐标单位mm。零件STEP保留图示局部原点；U=X、V=Y、W=Z。
正面=局部W最大面，背面=局部W最小面；边孔按方向向量钻入。
工艺 1: 长度+/-0.05；两端平行度0.03；钢隔套发黑防锈
通用：未注尺寸<=300为+/-0.1，>300为+/-0.2；CNC孔位+/-0.05；未注通孔+0.10/0。
螺纹在STEP中以公称径简化。按6H底孔/螺纹加工，不得直接按模型大径钻孔；有效牙深为验收值。
盲螺纹用底攻或螺纹铣削；工艺底孔应先核对剩余壁厚及交叉孔，薄壁处优先螺纹铣削。
未注Ra3.2；安装面Ra1.6；去毛刺C0.3。阳极层不计入配合尺寸；轴承孔、螺纹与定位面遮蔽。

# MG3-036 side_brace_0_1

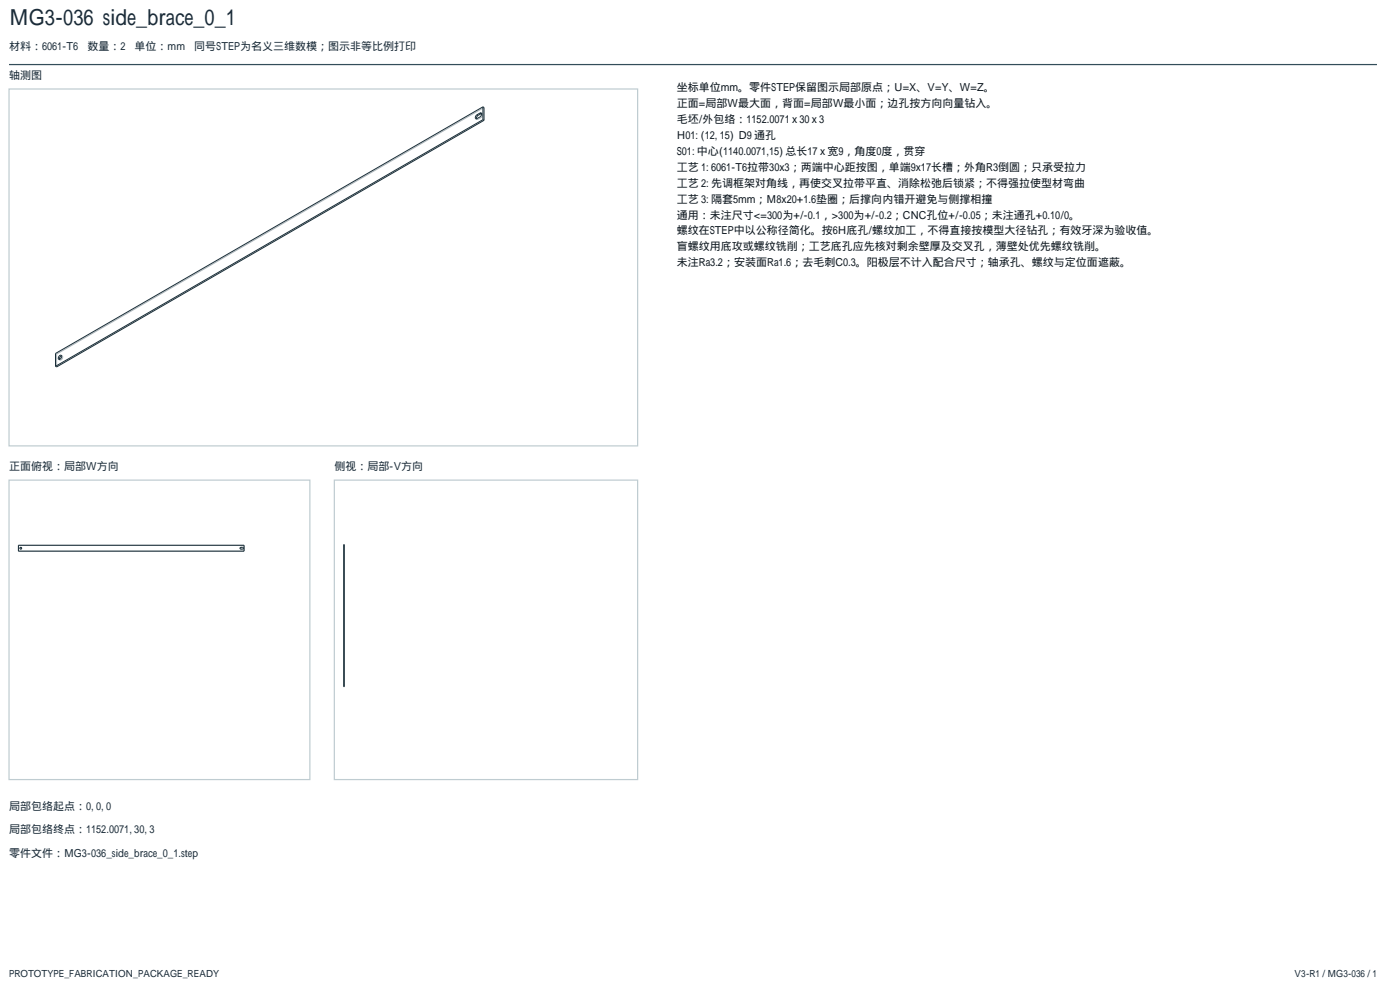
[picture p154: page 36]
轴测图; 正面俯视：局部W方向; 侧视：局部-V方向; 局部包络起点：0, 0, 0; 局部包络终点：1152.0071, 30, 3; 零件文件：MG3-036_side_brace_0_1.step

材料：6061-T6 数量：2 单位：mm 同号STEP为名义三维数模；图示非等比例打印

坐标单位mm。零件STEP保留图示局部原点；U=X、V=Y、W=Z。
正面=局部W最大面，背面=局部W最小面；边孔按方向向量钻入。
毛坯/外包络：1152.0071 x 30 x 3
工艺 1: 6061-T6拉带30x3；两端中心距按图，单端9x17长槽；外角R3倒圆；只承受拉力
工艺 2: 先调框架对角线，再使交叉拉带平直、消除松弛后锁紧；不得强拉使型材弯曲
工艺 3: 隔套5mm；M8x20+1.6垫圈；后撑向内错开避免与侧撑相撞
通用：未注尺寸<=300为+/-0.1，>300为+/-0.2；CNC孔位+/-0.05；未注通孔+0.10/0。
螺纹在STEP中以公称径简化。按6H底孔/螺纹加工，不得直接按模型大径钻孔；有效牙深为验收值。
盲螺纹用底攻或螺纹铣削；工艺底孔应先核对剩余壁厚及交叉孔，薄壁处优先螺纹铣削。
未注Ra3.2；安装面Ra1.6；去毛刺C0.3。阳极层不计入配合尺寸；轴承孔、螺纹与定位面遮蔽。

# MG3-037 side_brace_0_1_spacer_0

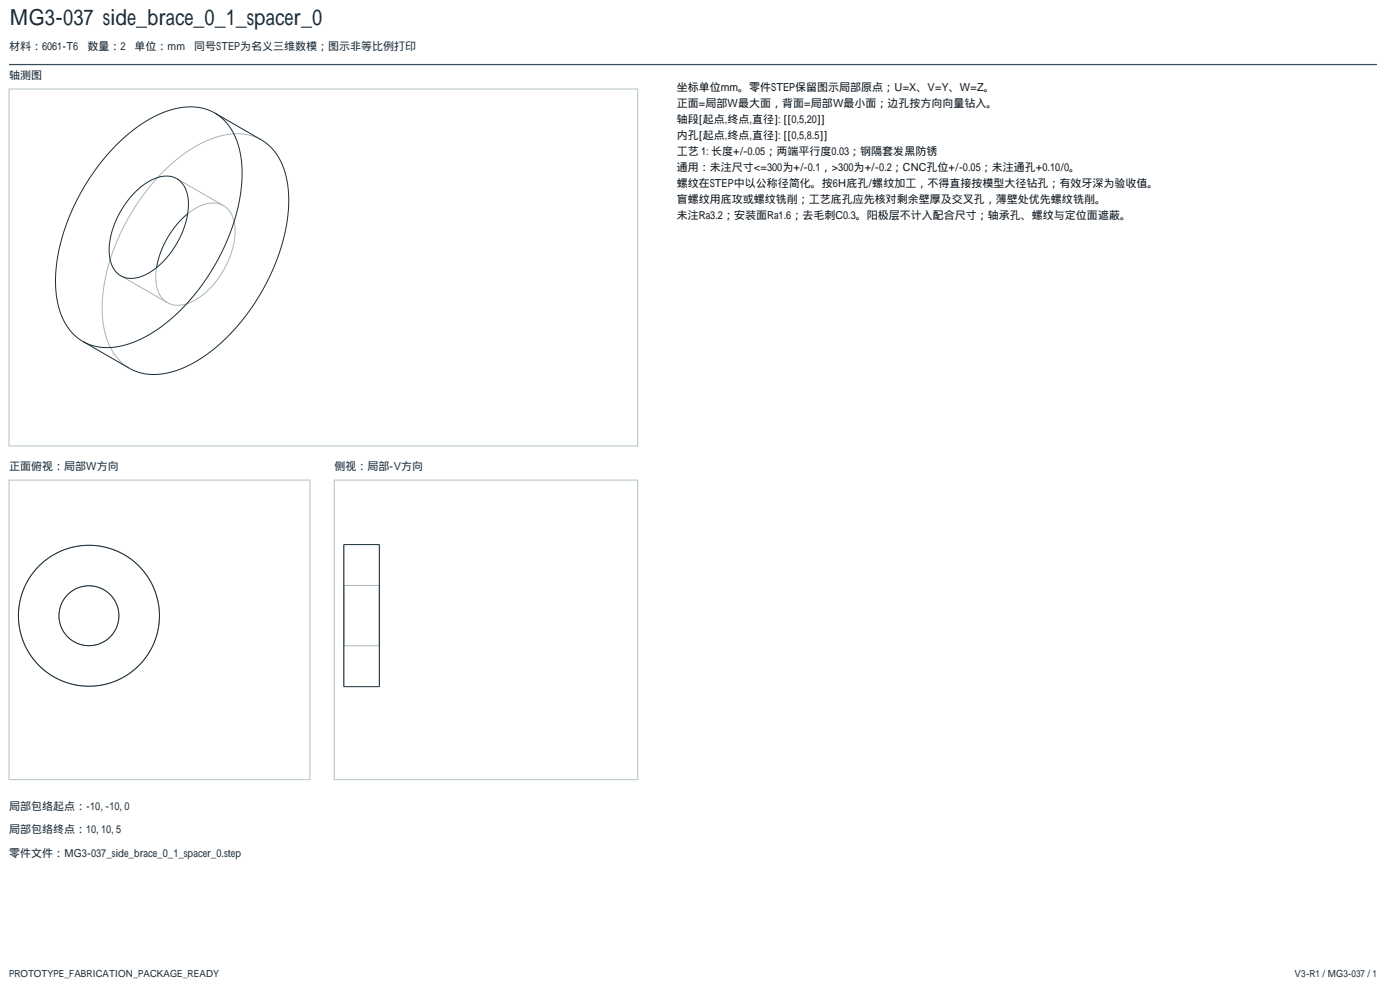
[picture p155: page 37]
轴测图; 正面俯视：局部W方向; 侧视：局部-V方向; 局部包络起点：-10, -10, 0; 局部包络终点：10, 10, 5; 零件文件：MG3-037_side_brace_0_1_spacer_0.step

材料：6061-T6 数量：2 单位：mm 同号STEP为名义三维数模；图示非等比例打印

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

# MG3-038 side_brace_1_0_spacer_0

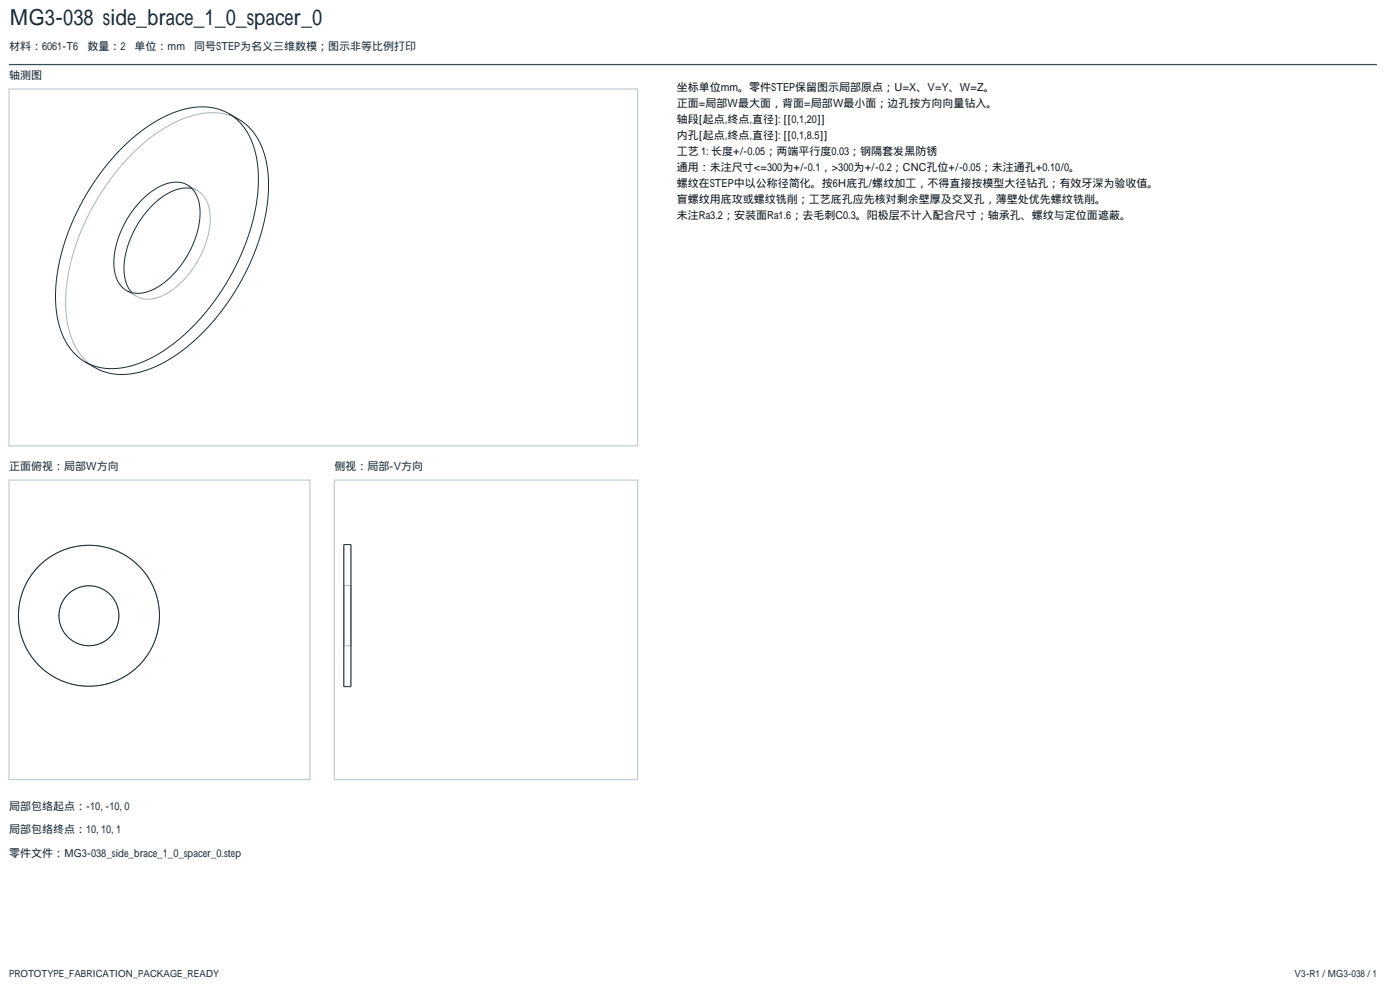
[picture p156: page 38]
轴测图; 正面俯视：局部W方向; 侧视：局部-V方向; 局部包络起点：-10, -10, 0; 局部包络终点：10, 10, 1; 零件文件：MG3-038_side_brace_1_0_spacer_0.step

材料：6061-T6 数量：2 单位：mm 同号STEP为名义三维数模；图示非等比例打印

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

# MG3-039 side_brace_1_1_spacer_0

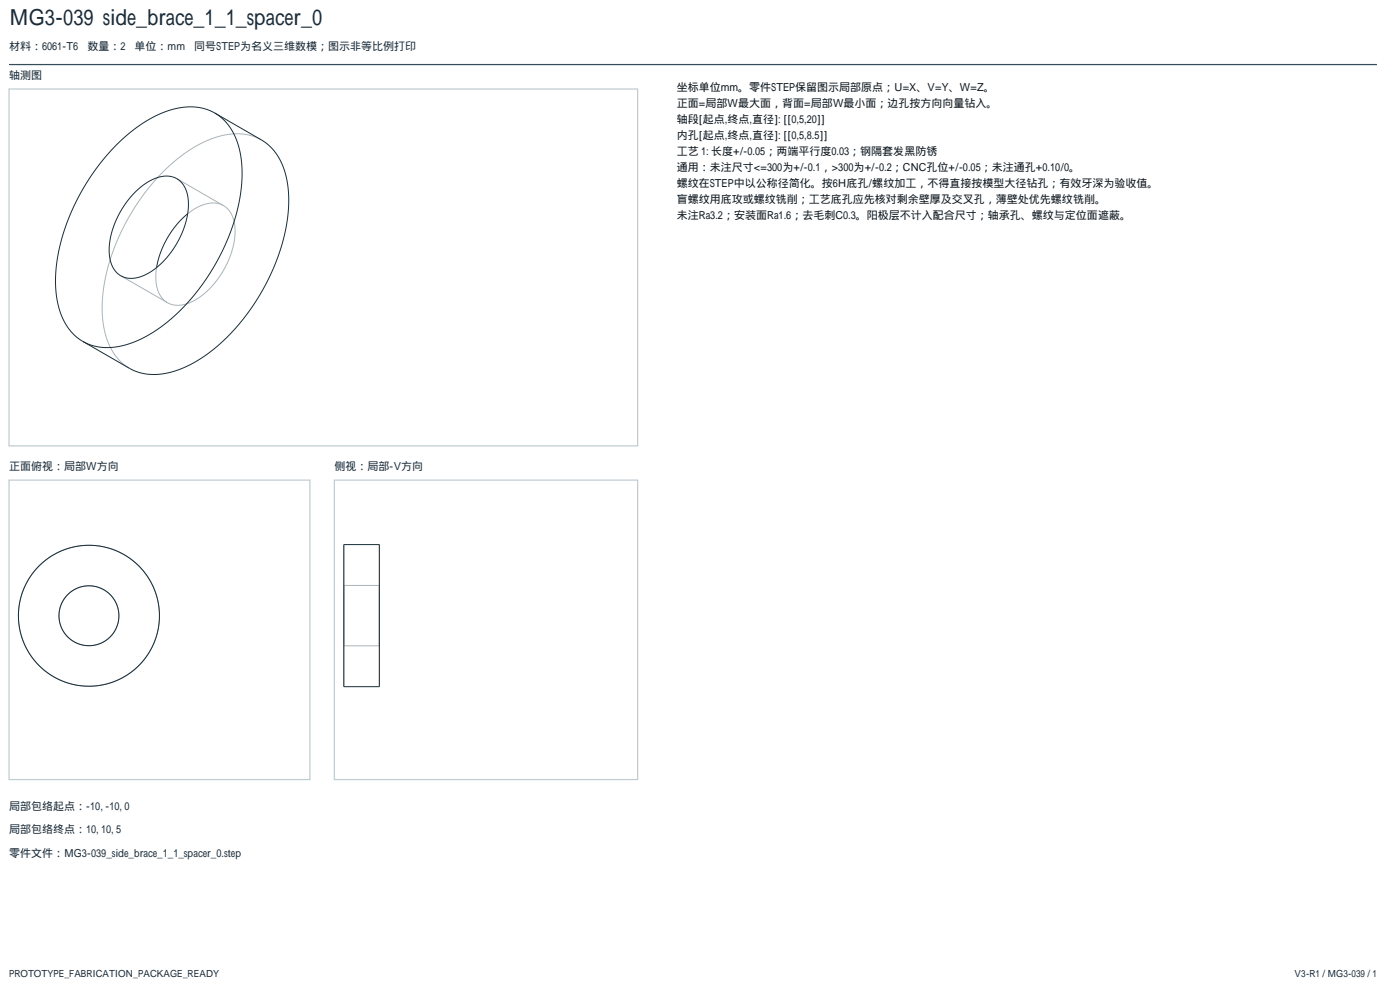
[picture p157: page 39]
轴测图; 正面俯视：局部W方向; 侧视：局部-V方向; 局部包络起点：-10, -10, 0; 局部包络终点：10, 10, 5; 零件文件：MG3-039_side_brace_1_1_spacer_0.step

材料：6061-T6 数量：2 单位：mm 同号STEP为名义三维数模；图示非等比例打印

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

# MG3-040 x_belt_bridge

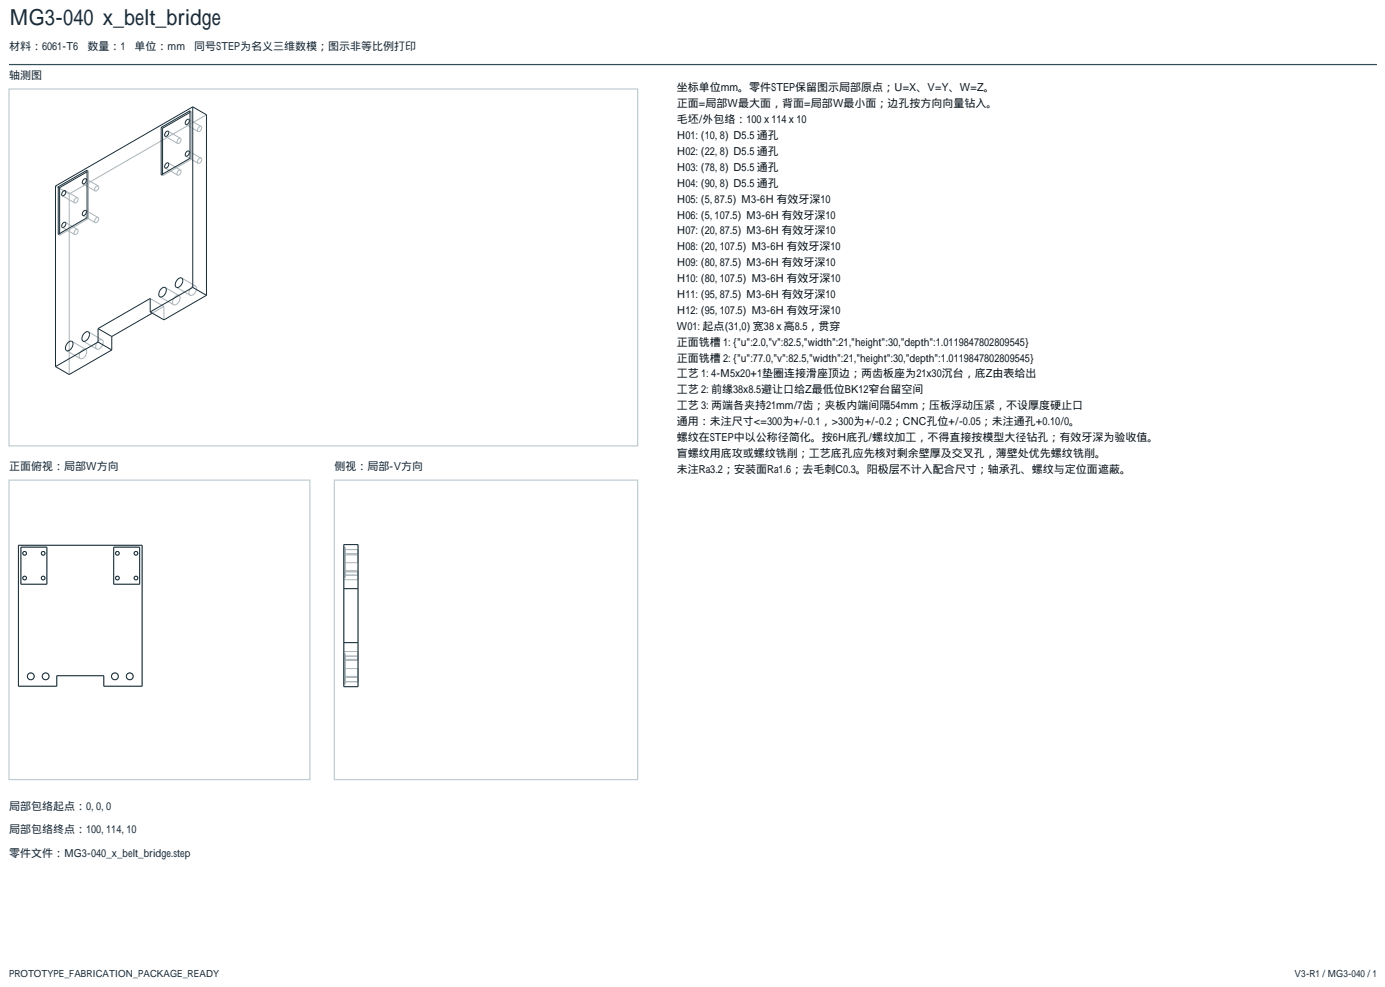
[picture p158: page 40]
轴测图; 正面俯视：局部W方向; 侧视：局部-V方向; 局部包络起点：0, 0, 0; 局部包络终点：100, 114, 10; 零件文件：MG3-040_x_belt_bridge.step

材料：6061-T6 数量：1 单位：mm 同号STEP为名义三维数模；图示非等比例打印

坐标单位mm。零件STEP保留图示局部原点；U=X、V=Y、W=Z。
正面=局部W最大面，背面=局部W最小面；边孔按方向向量钻入。
毛坯/外包络：100 x 114 x 10
H05: (5, 87.5) M3-6H 有效牙深10
H06: (5, 107.5) M3-6H 有效牙深10
H07: (20, 87.5) M3-6H 有效牙深10
H08: (20, 107.5) M3-6H 有效牙深10
H09: (80, 87.5) M3-6H 有效牙深10
H10: (80, 107.5) M3-6H 有效牙深10
H11: (95, 87.5) M3-6H 有效牙深10
H12: (95, 107.5) M3-6H 有效牙深10
正面铣槽 1: {"u":2.0,"v":82.5,"width":21,"height":30,"depth":1.0119847802809545}
正面铣槽 2: {"u":77.0,"v":82.5,"width":21,"height":30,"depth":1.0119847802809545}
工艺 1: 4-M5x20+1垫圈连接滑座顶边；两齿板座为21x30沉台，底Z由表给出
工艺 2: 前缘38x8.5避让口给Z最低位BK12窄台留空间
工艺 3: 两端各夹持21mm/7齿；夹板内端间隔54mm；压板浮动压紧，不设厚度硬止口
通用：未注尺寸<=300为+/-0.1，>300为+/-0.2；CNC孔位+/-0.05；未注通孔+0.10/0。
螺纹在STEP中以公称径简化。按6H底孔/螺纹加工，不得直接按模型大径钻孔；有效牙深为验收值。
盲螺纹用底攻或螺纹铣削；工艺底孔应先核对剩余壁厚及交叉孔，薄壁处优先螺纹铣削。
未注Ra3.2；安装面Ra1.6；去毛刺C0.3。阳极层不计入配合尺寸；轴承孔、螺纹与定位面遮蔽。

# MG3-041 x_clamp_0_-1_cap

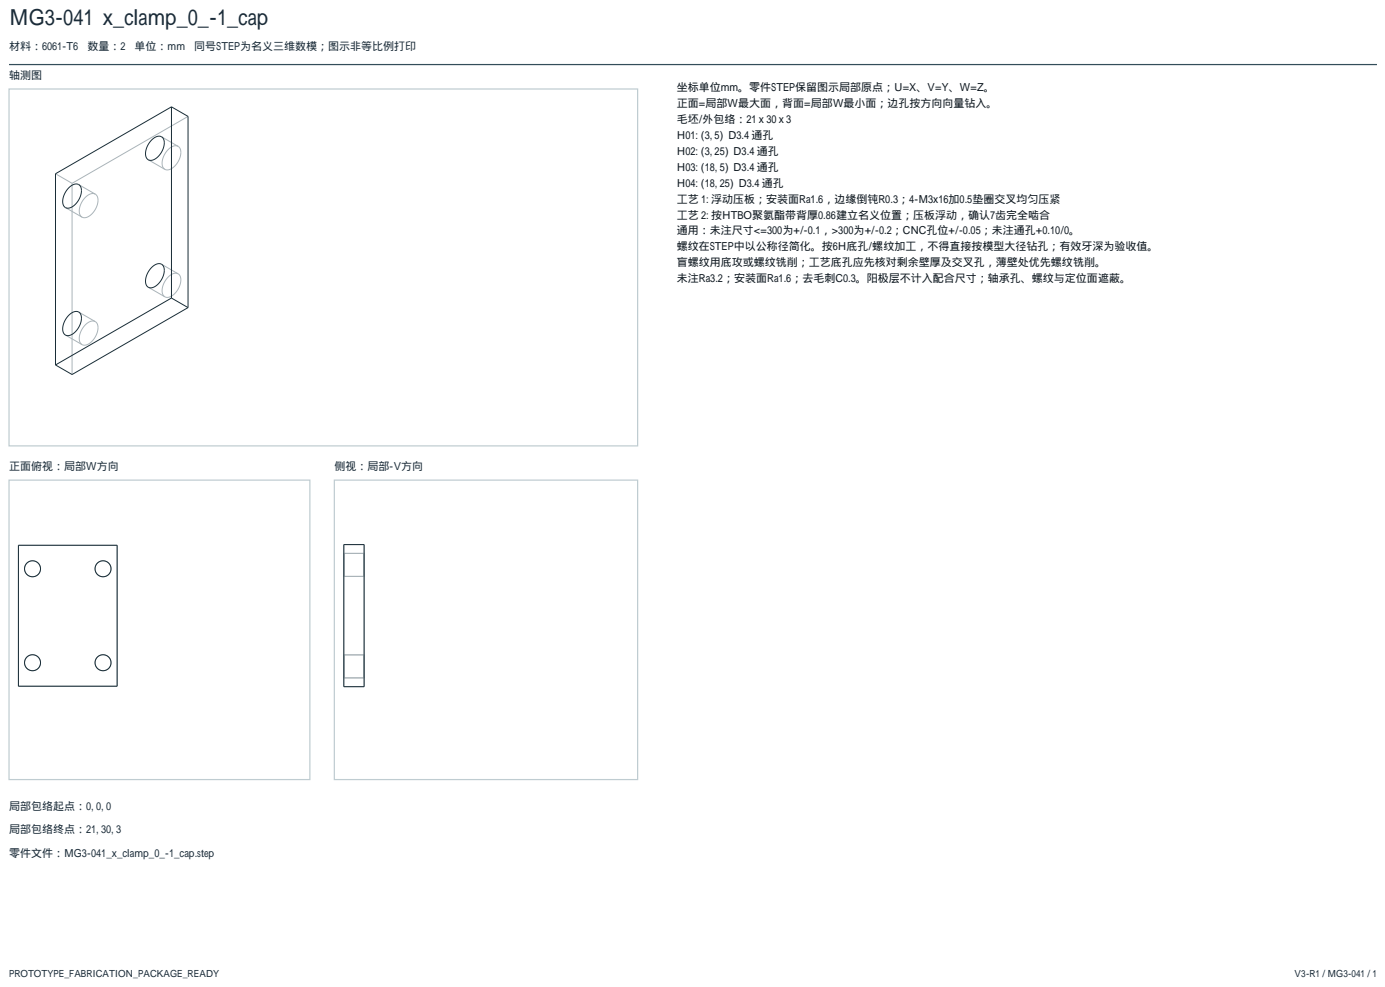
[picture p159: page 41]
轴测图; 正面俯视：局部W方向; 侧视：局部-V方向; 局部包络起点：0, 0, 0; 局部包络终点：21, 30, 3; 零件文件：MG3-041_x_clamp_0_-1_cap.step

材料：6061-T6 数量：2 单位：mm 同号STEP为名义三维数模；图示非等比例打印

坐标单位mm。零件STEP保留图示局部原点；U=X、V=Y、W=Z。
正面=局部W最大面，背面=局部W最小面；边孔按方向向量钻入。
毛坯/外包络：21 x 30 x 3
工艺 1: 浮动压板；安装面Ra1.6，边缘倒钝R0.3；4-M3x16加0.5垫圈交叉均匀压紧
工艺 2: 按HTBO聚氨酯带背厚0.86建立名义位置；压板浮动，确认7齿完全啮合
通用：未注尺寸<=300为+/-0.1，>300为+/-0.2；CNC孔位+/-0.05；未注通孔+0.10/0。
螺纹在STEP中以公称径简化。按6H底孔/螺纹加工，不得直接按模型大径钻孔；有效牙深为验收值。
盲螺纹用底攻或螺纹铣削；工艺底孔应先核对剩余壁厚及交叉孔，薄壁处优先螺纹铣削。
未注Ra3.2；安装面Ra1.6；去毛刺C0.3。阳极层不计入配合尺寸；轴承孔、螺纹与定位面遮蔽。

# MG3-042 x_input_end_retainer

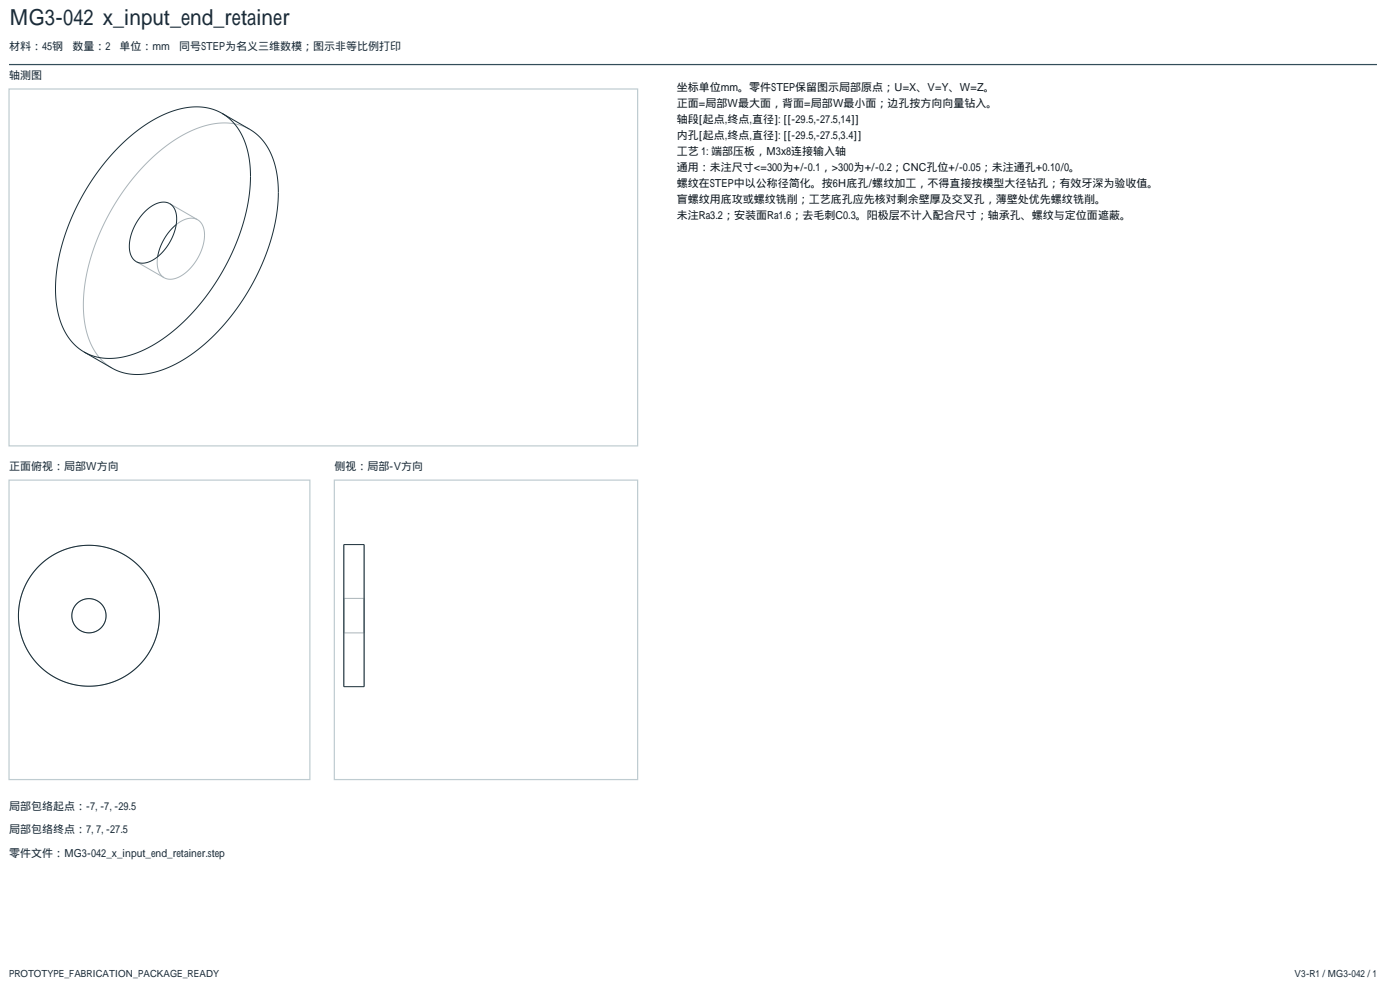
[picture p160: page 42]
轴测图; 正面俯视：局部W方向; 侧视：局部-V方向; 局部包络起点：-7, -7, -29.5; 局部包络终点：7, 7, -27.5; 零件文件：MG3-042_x_input_end_retainer.step

材料：45钢 数量：2 单位：mm 同号STEP为名义三维数模；图示非等比例打印

坐标单位mm。零件STEP保留图示局部原点；U=X、V=Y、W=Z。
正面=局部W最大面，背面=局部W最小面；边孔按方向向量钻入。
工艺 1: 端部压板，M3x8连接输入轴
通用：未注尺寸<=300为+/-0.1，>300为+/-0.2；CNC孔位+/-0.05；未注通孔+0.10/0。
螺纹在STEP中以公称径简化。按6H底孔/螺纹加工，不得直接按模型大径钻孔；有效牙深为验收值。
盲螺纹用底攻或螺纹铣削；工艺底孔应先核对剩余壁厚及交叉孔，薄壁处优先螺纹铣削。
未注Ra3.2；安装面Ra1.6；去毛刺C0.3。阳极层不计入配合尺寸；轴承孔、螺纹与定位面遮蔽。

# MG3-043 x_input_end_spacer

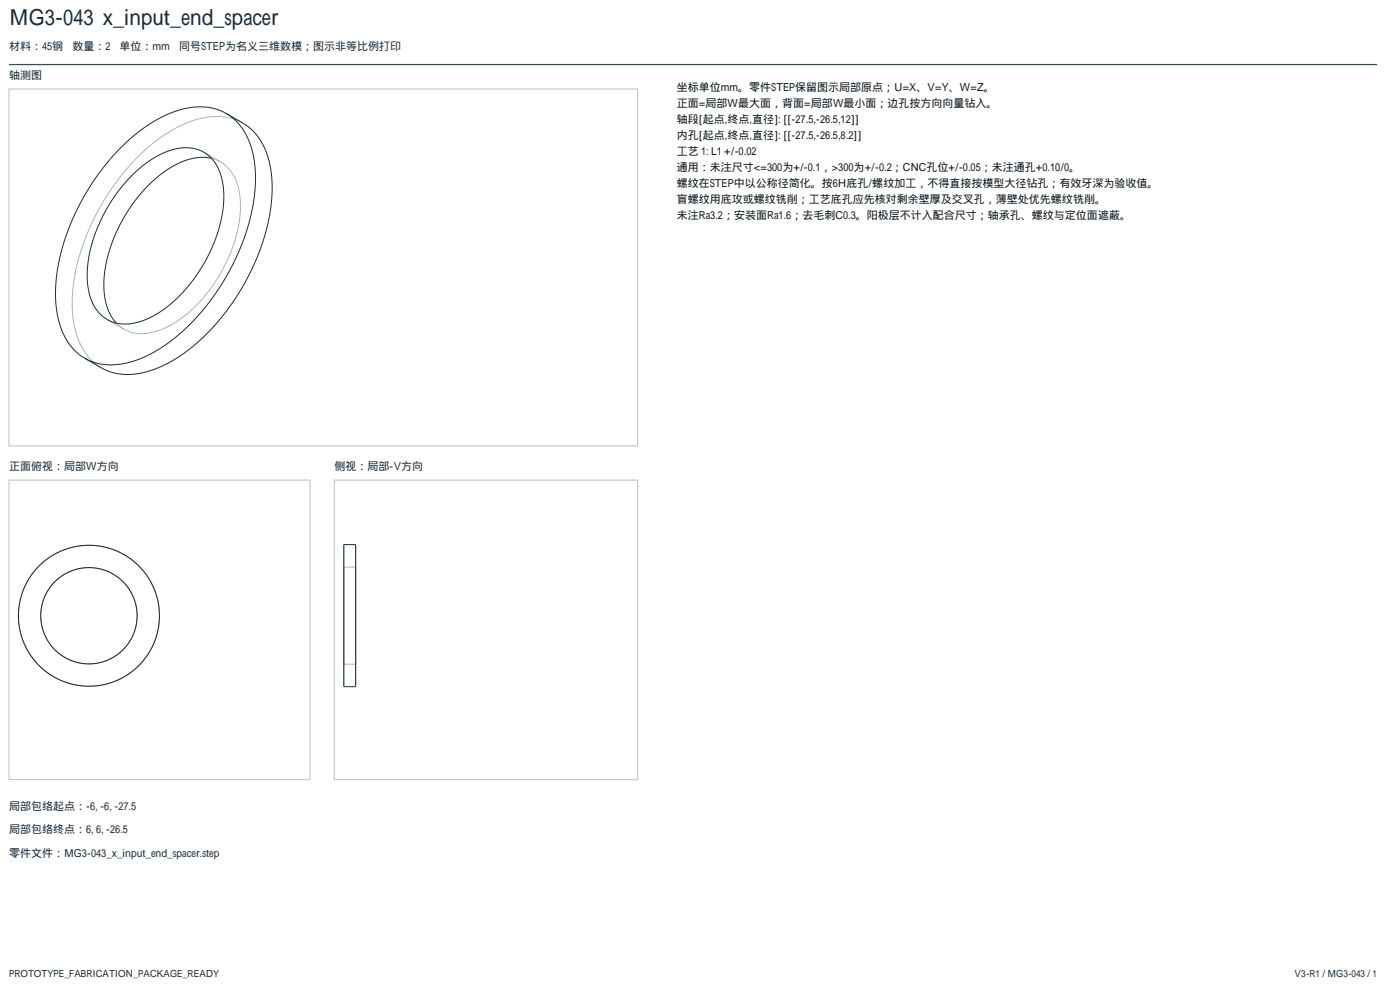
[picture p161: page 43]
轴测图; 正面俯视：局部W方向; 侧视：局部-V方向; 局部包络起点：-6, -6, -27.5; 局部包络终点：6, 6, -26.5; 零件文件：MG3-043_x_input_end_spacer.step

材料：45钢 数量：2 单位：mm 同号STEP为名义三维数模；图示非等比例打印

坐标单位mm。零件STEP保留图示局部原点；U=X、V=Y、W=Z。
正面=局部W最大面，背面=局部W最小面；边孔按方向向量钻入。
通用：未注尺寸<=300为+/-0.1，>300为+/-0.2；CNC孔位+/-0.05；未注通孔+0.10/0。
螺纹在STEP中以公称径简化。按6H底孔/螺纹加工，不得直接按模型大径钻孔；有效牙深为验收值。
盲螺纹用底攻或螺纹铣削；工艺底孔应先核对剩余壁厚及交叉孔，薄壁处优先螺纹铣削。
未注Ra3.2；安装面Ra1.6；去毛刺C0.3。阳极层不计入配合尺寸；轴承孔、螺纹与定位面遮蔽。

# MG3-044 x_input_front_cover

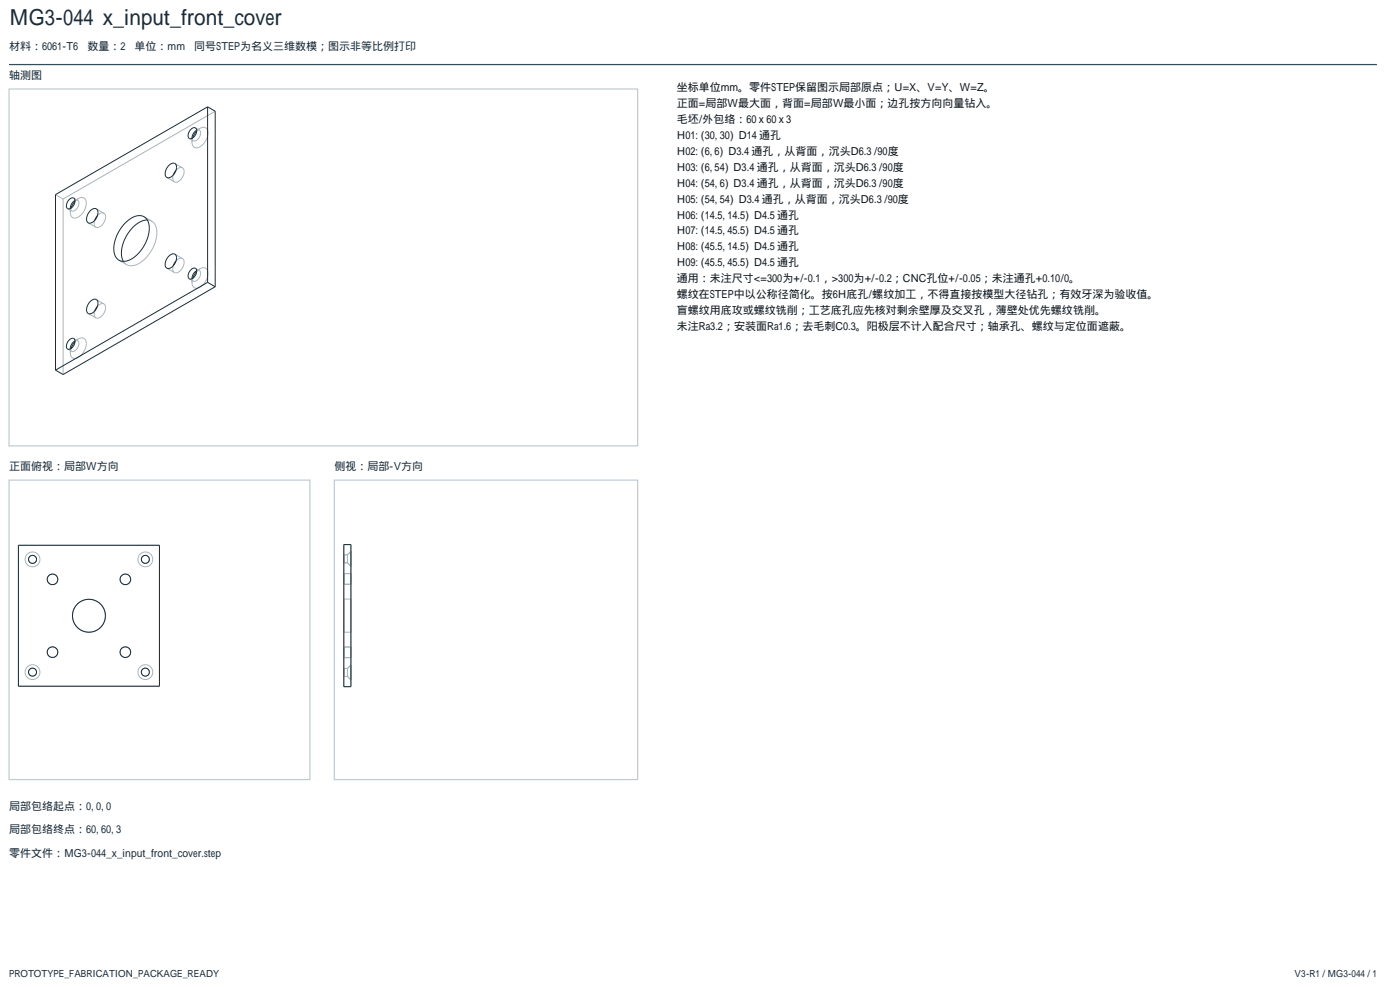
[picture p162: page 44]
轴测图; 正面俯视：局部W方向; 侧视：局部-V方向; 局部包络起点：0, 0, 0; 局部包络终点：60, 60, 3; 零件文件：MG3-044_x_input_front_cover.step

材料：6061-T6 数量：2 单位：mm 同号STEP为名义三维数模；图示非等比例打印

坐标单位mm。零件STEP保留图示局部原点；U=X、V=Y、W=Z。
正面=局部W最大面，背面=局部W最小面；边孔按方向向量钻入。
毛坯/外包络：60 x 60 x 3
H02: (6, 6) D3.4 通孔，从背面，沉头D6.3 /90度
H03: (6, 54) D3.4 通孔，从背面，沉头D6.3 /90度
H04: (54, 6) D3.4 通孔，从背面，沉头D6.3 /90度
H05: (54, 54) D3.4 通孔，从背面，沉头D6.3 /90度
通用：未注尺寸<=300为+/-0.1，>300为+/-0.2；CNC孔位+/-0.05；未注通孔+0.10/0。
螺纹在STEP中以公称径简化。按6H底孔/螺纹加工，不得直接按模型大径钻孔；有效牙深为验收值。
盲螺纹用底攻或螺纹铣削；工艺底孔应先核对剩余壁厚及交叉孔，薄壁处优先螺纹铣削。
未注Ra3.2；安装面Ra1.6；去毛刺C0.3。阳极层不计入配合尺寸；轴承孔、螺纹与定位面遮蔽。

# MG3-045 x_input_housing

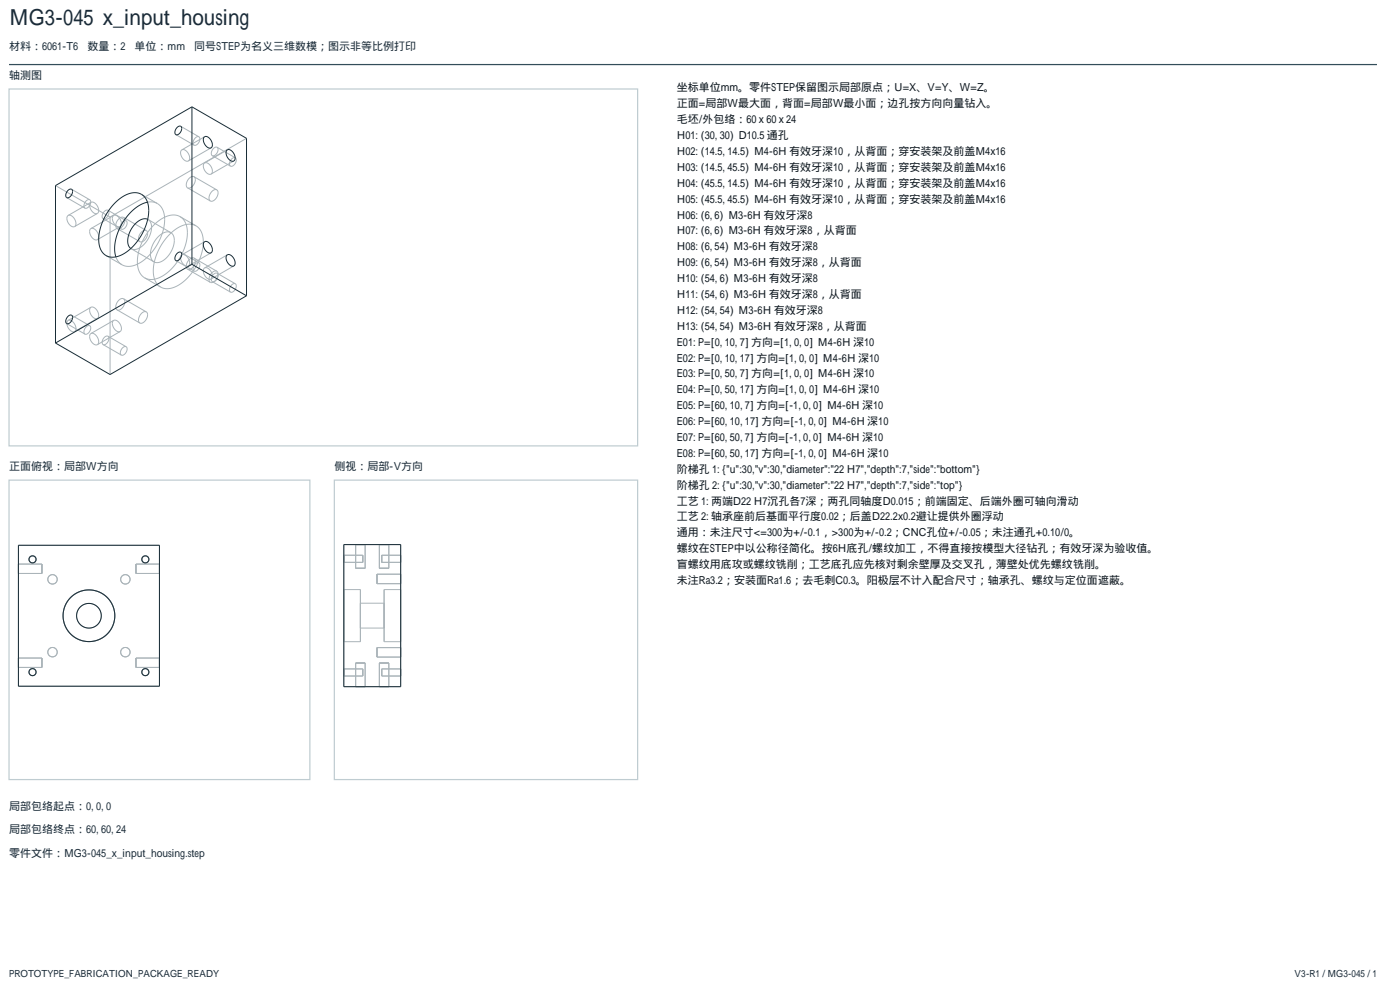
[picture p163: page 45]
轴测图; 正面俯视：局部W方向; 侧视：局部-V方向; 局部包络起点：0, 0, 0; 局部包络终点：60, 60, 24; 零件文件：MG3-045_x_input_housing.step

材料：6061-T6 数量：2 单位：mm 同号STEP为名义三维数模；图示非等比例打印

坐标单位mm。零件STEP保留图示局部原点；U=X、V=Y、W=Z。
正面=局部W最大面，背面=局部W最小面；边孔按方向向量钻入。
毛坯/外包络：60 x 60 x 24
H02: (14.5, 14.5) M4-6H 有效牙深10，从背面；穿安装架及前盖M4x16
H03: (14.5, 45.5) M4-6H 有效牙深10，从背面；穿安装架及前盖M4x16
H04: (45.5, 14.5) M4-6H 有效牙深10，从背面；穿安装架及前盖M4x16
H05: (45.5, 45.5) M4-6H 有效牙深10，从背面；穿安装架及前盖M4x16
H06: (6, 6) M3-6H 有效牙深8
H07: (6, 6) M3-6H 有效牙深8，从背面
H08: (6, 54) M3-6H 有效牙深8
H09: (6, 54) M3-6H 有效牙深8，从背面
H10: (54, 6) M3-6H 有效牙深8
H11: (54, 6) M3-6H 有效牙深8，从背面
H12: (54, 54) M3-6H 有效牙深8
H13: (54, 54) M3-6H 有效牙深8，从背面
阶梯孔 1: {"u":30,"v":30,"diameter":"22 H7","depth":7,"side":"bottom"}
阶梯孔 2: {"u":30,"v":30,"diameter":"22 H7","depth":7,"side":"top"}
工艺 1: 两端D22 H7沉孔各7深；两孔同轴度D0.015；前端固定、后端外圈可轴向滑动
工艺 2: 轴承座前后基面平行度0.02；后盖D22.2x0.2避让提供外圈浮动
通用：未注尺寸<=300为+/-0.1，>300为+/-0.2；CNC孔位+/-0.05；未注通孔+0.10/0。
螺纹在STEP中以公称径简化。按6H底孔/螺纹加工，不得直接按模型大径钻孔；有效牙深为验收值。
盲螺纹用底攻或螺纹铣削；工艺底孔应先核对剩余壁厚及交叉孔，薄壁处优先螺纹铣削。
未注Ra3.2；安装面Ra1.6；去毛刺C0.3。阳极层不计入配合尺寸；轴承孔、螺纹与定位面遮蔽。

# MG3-046 x_input_inner_spacer

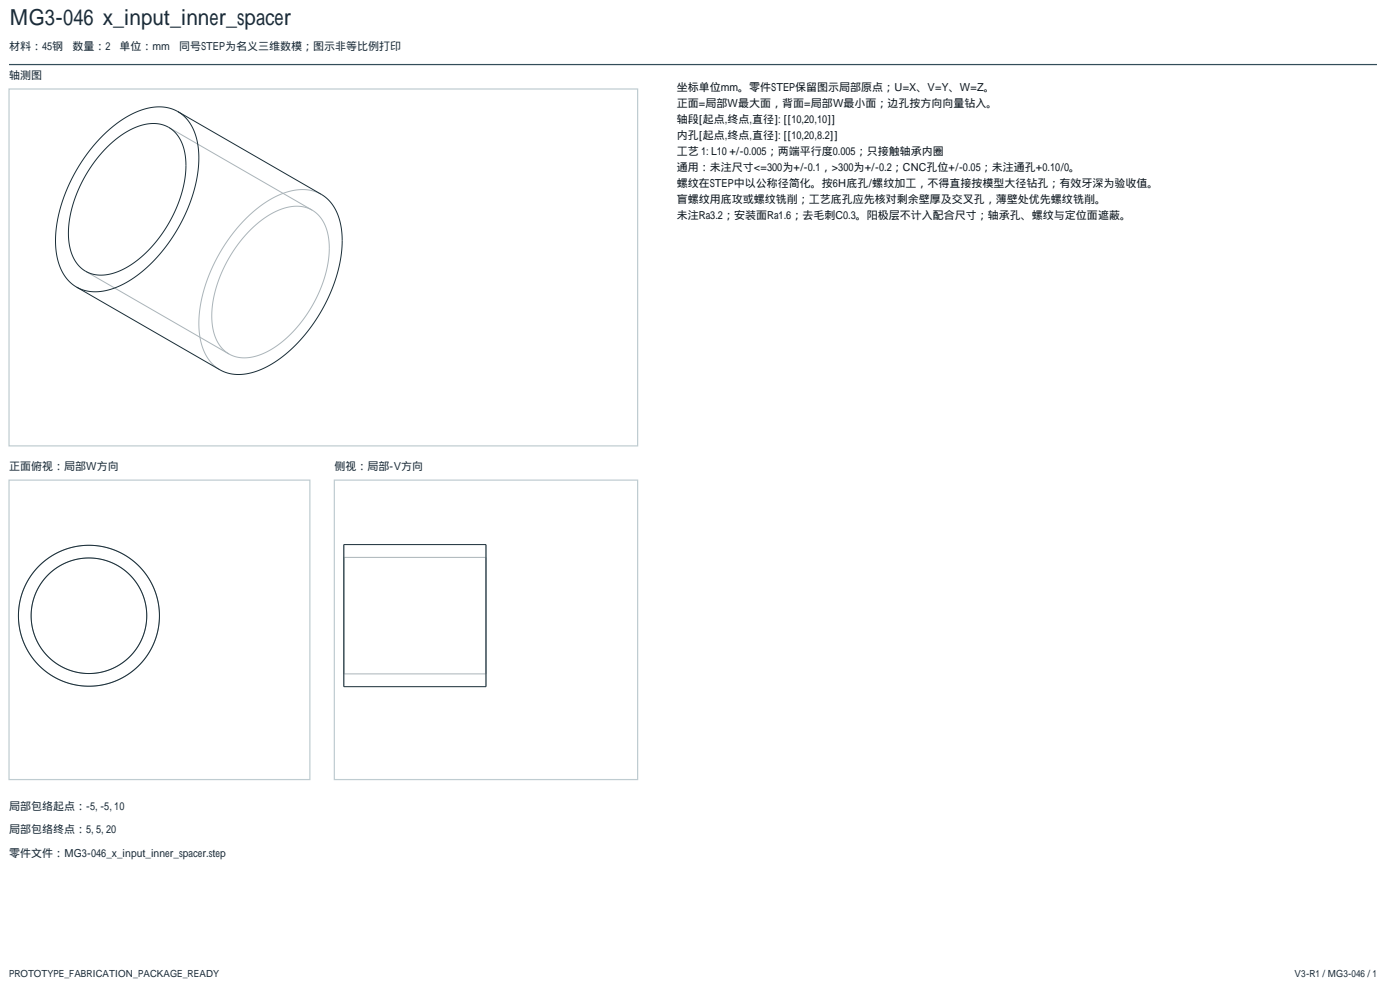
[picture p164: page 46]
轴测图; 正面俯视：局部W方向; 侧视：局部-V方向; 局部包络起点：-5, -5, 10; 局部包络终点：5, 5, 20; 零件文件：MG3-046_x_input_inner_spacer.step

材料：45钢 数量：2 单位：mm 同号STEP为名义三维数模；图示非等比例打印

坐标单位mm。零件STEP保留图示局部原点；U=X、V=Y、W=Z。
正面=局部W最大面，背面=局部W最小面；边孔按方向向量钻入。
工艺 1: L10 +/-0.005；两端平行度0.005；只接触轴承内圈
通用：未注尺寸<=300为+/-0.1，>300为+/-0.2；CNC孔位+/-0.05；未注通孔+0.10/0。
螺纹在STEP中以公称径简化。按6H底孔/螺纹加工，不得直接按模型大径钻孔；有效牙深为验收值。
盲螺纹用底攻或螺纹铣削；工艺底孔应先核对剩余壁厚及交叉孔，薄壁处优先螺纹铣削。
未注Ra3.2；安装面Ra1.6；去毛刺C0.3。阳极层不计入配合尺寸；轴承孔、螺纹与定位面遮蔽。

# MG3-047 x_input_motor_plate

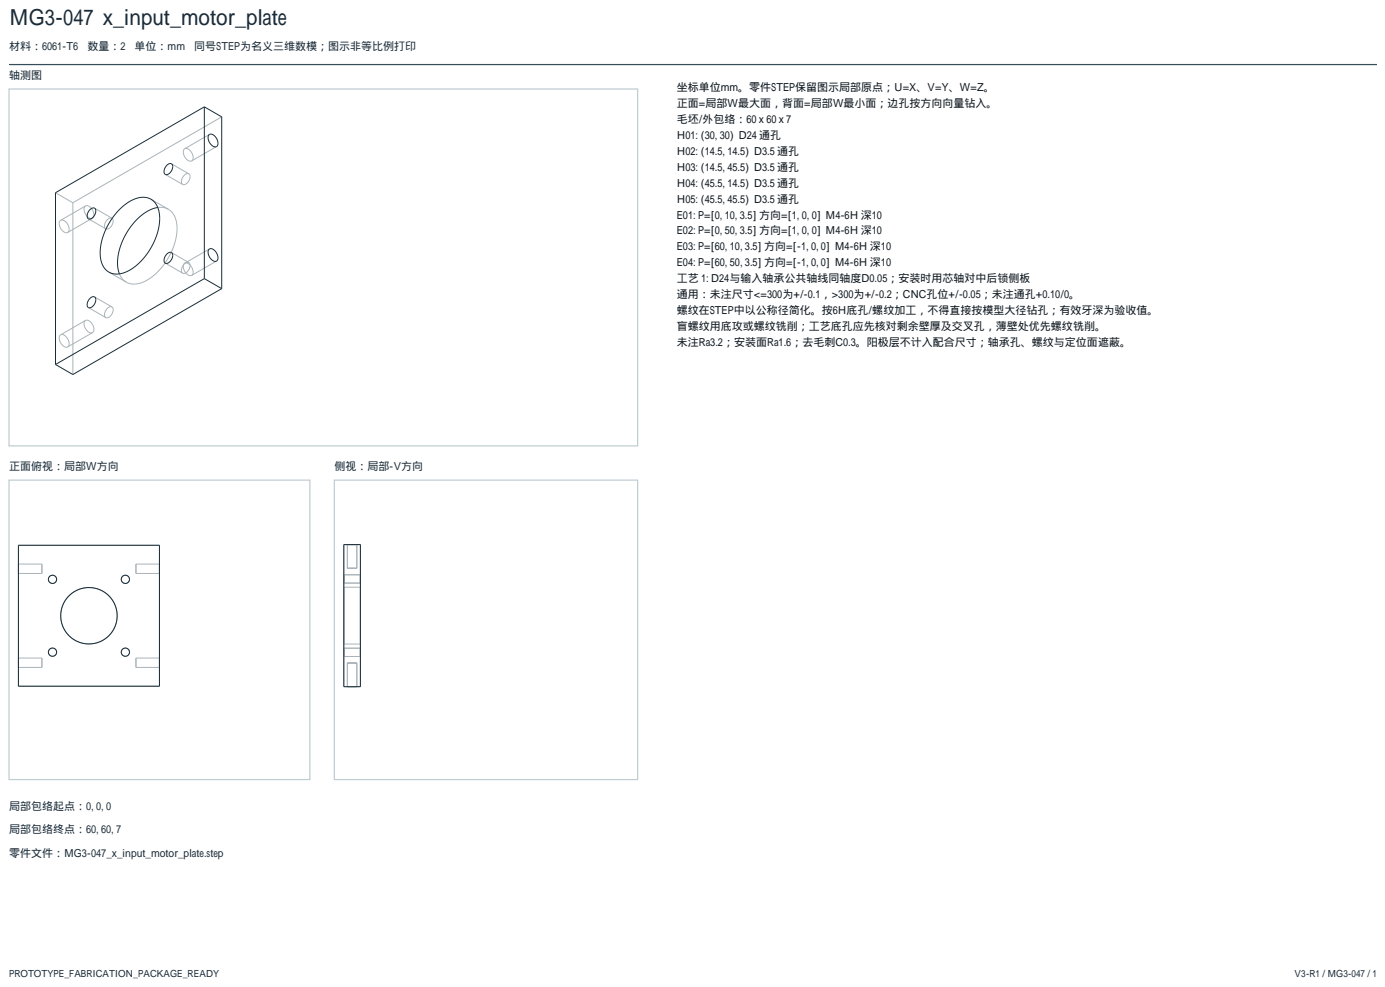
[picture p165: page 47]
轴测图; 正面俯视：局部W方向; 侧视：局部-V方向; 局部包络起点：0, 0, 0; 局部包络终点：60, 60, 7; 零件文件：MG3-047_x_input_motor_plate.step

材料：6061-T6 数量：2 单位：mm 同号STEP为名义三维数模；图示非等比例打印

坐标单位mm。零件STEP保留图示局部原点；U=X、V=Y、W=Z。
正面=局部W最大面，背面=局部W最小面；边孔按方向向量钻入。
毛坯/外包络：60 x 60 x 7
工艺 1: D24与输入轴承公共轴线同轴度D0.05；安装时用芯轴对中后锁侧板
通用：未注尺寸<=300为+/-0.1，>300为+/-0.2；CNC孔位+/-0.05；未注通孔+0.10/0。
螺纹在STEP中以公称径简化。按6H底孔/螺纹加工，不得直接按模型大径钻孔；有效牙深为验收值。
盲螺纹用底攻或螺纹铣削；工艺底孔应先核对剩余壁厚及交叉孔，薄壁处优先螺纹铣削。
未注Ra3.2；安装面Ra1.6；去毛刺C0.3。阳极层不计入配合尺寸；轴承孔、螺纹与定位面遮蔽。

# MG3-048 x_input_rear_cover

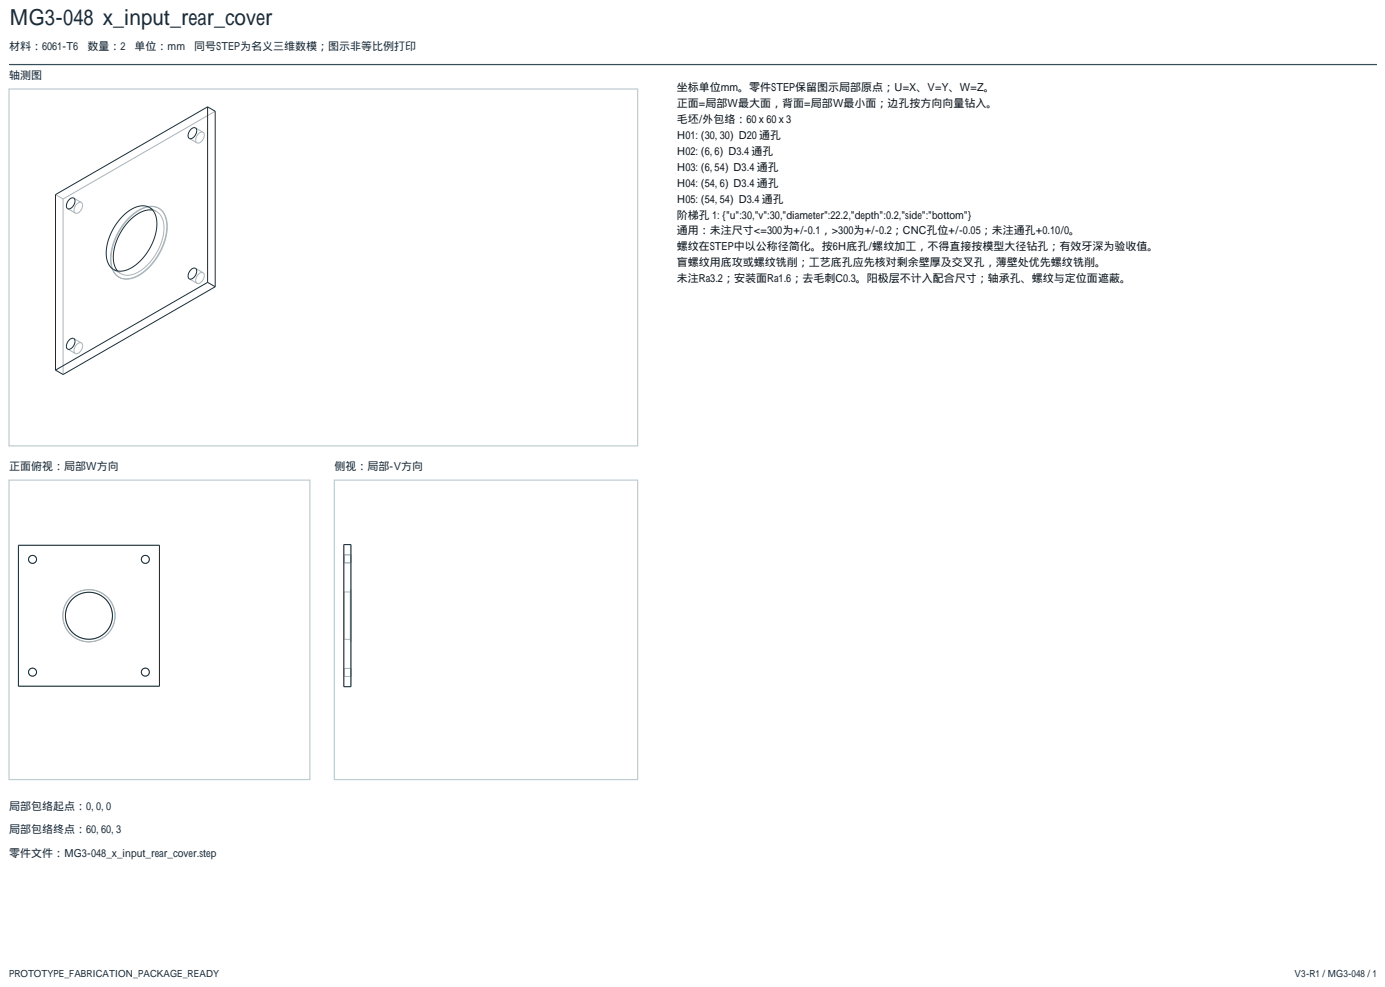
[picture p166: page 48]
轴测图; 正面俯视：局部W方向; 侧视：局部-V方向; 局部包络起点：0, 0, 0; 局部包络终点：60, 60, 3; 零件文件：MG3-048_x_input_rear_cover.step

材料：6061-T6 数量：2 单位：mm 同号STEP为名义三维数模；图示非等比例打印

坐标单位mm。零件STEP保留图示局部原点；U=X、V=Y、W=Z。
正面=局部W最大面，背面=局部W最小面；边孔按方向向量钻入。
毛坯/外包络：60 x 60 x 3
阶梯孔 1: {"u":30,"v":30,"diameter":22.2,"depth":0.2,"side":"bottom"}
通用：未注尺寸<=300为+/-0.1，>300为+/-0.2；CNC孔位+/-0.05；未注通孔+0.10/0。
螺纹在STEP中以公称径简化。按6H底孔/螺纹加工，不得直接按模型大径钻孔；有效牙深为验收值。
盲螺纹用底攻或螺纹铣削；工艺底孔应先核对剩余壁厚及交叉孔，薄壁处优先螺纹铣削。
未注Ra3.2；安装面Ra1.6；去毛刺C0.3。阳极层不计入配合尺寸；轴承孔、螺纹与定位面遮蔽。

# MG3-049 x_input_shaft

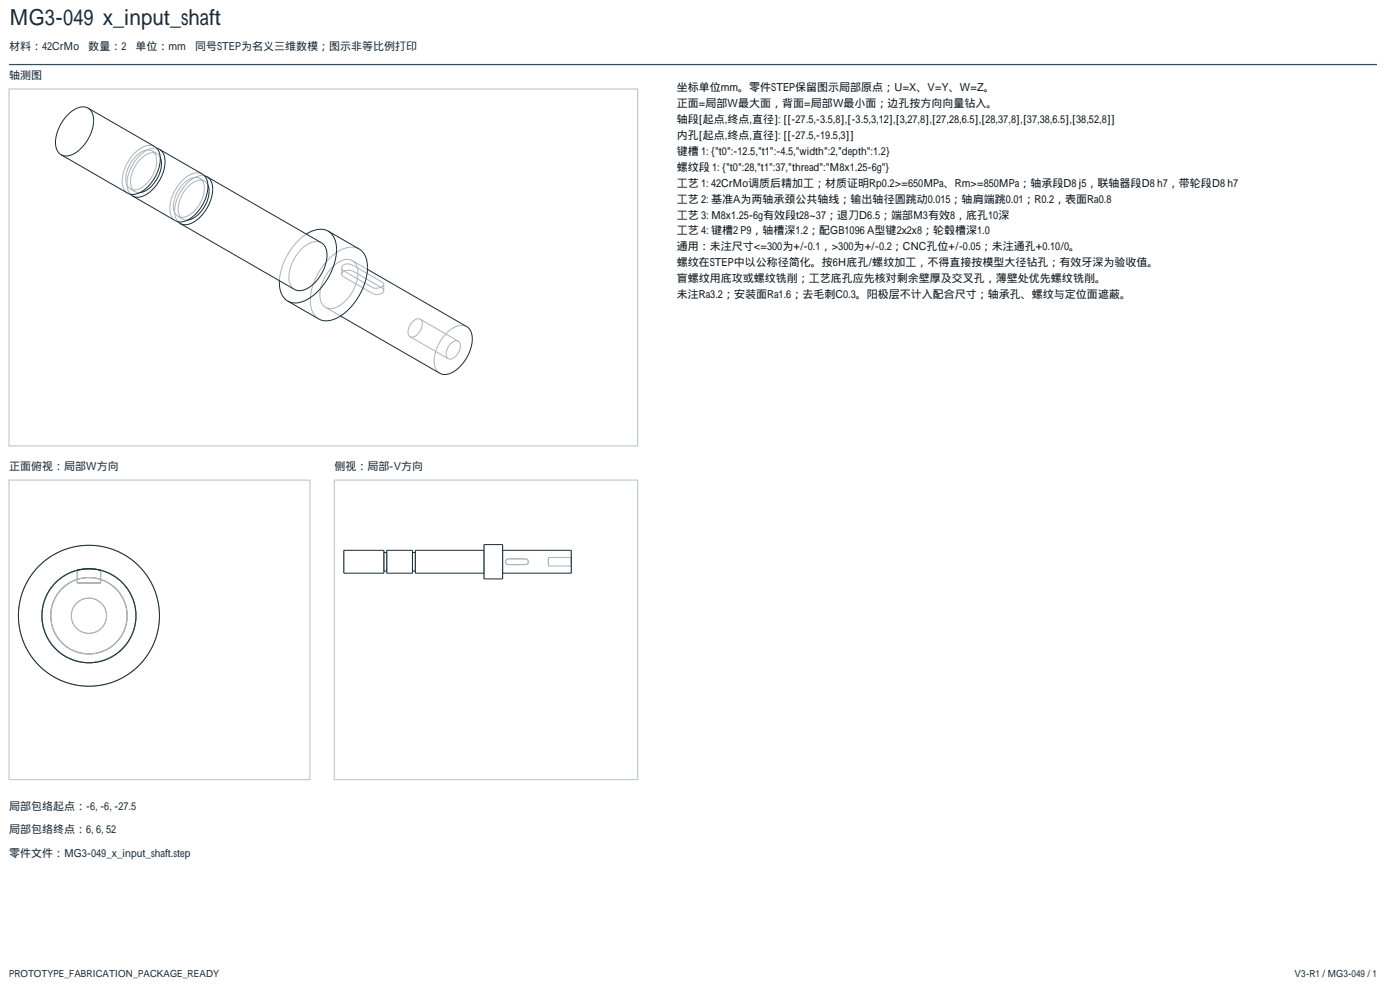
[picture p167: page 49]
轴测图; 正面俯视：局部W方向; 侧视：局部-V方向; 局部包络起点：-6, -6, -27.5; 局部包络终点：6, 6, 52; 零件文件：MG3-049_x_input_shaft.step

材料：42CrMo 数量：2 单位：mm 同号STEP为名义三维数模；图示非等比例打印

坐标单位mm。零件STEP保留图示局部原点；U=X、V=Y、W=Z。
正面=局部W最大面，背面=局部W最小面；边孔按方向向量钻入。
键槽 1: {"t0":-12.5,"t1":-4.5,"width":2,"depth":1.2}
螺纹段 1: {"t0":28,"t1":37,"thread":"M8x1.25-6g"}
工艺 1: 42CrMo调质后精加工；材质证明Rp0.2>=650MPa、Rm>=850MPa；轴承段D8 j5，联轴器段D8 h7，带轮段D8 h7
工艺 2: 基准A为两轴承颈公共轴线；输出轴径圆跳动0.015；轴肩端跳0.01；R0.2，表面Ra0.8
工艺 3: M8x1.25-6g有效段t28~37；退刀D6.5；端部M3有效8，底孔10深
工艺 4: 键槽2 P9，轴槽深1.2；配GB1096 A型键2x2x8；轮毂槽深1.0
通用：未注尺寸<=300为+/-0.1，>300为+/-0.2；CNC孔位+/-0.05；未注通孔+0.10/0。
螺纹在STEP中以公称径简化。按6H底孔/螺纹加工，不得直接按模型大径钻孔；有效牙深为验收值。
盲螺纹用底攻或螺纹铣削；工艺底孔应先核对剩余壁厚及交叉孔，薄壁处优先螺纹铣削。
未注Ra3.2；安装面Ra1.6；去毛刺C0.3。阳极层不计入配合尺寸；轴承孔、螺纹与定位面遮蔽。

# MG3-050 x_input_side_0

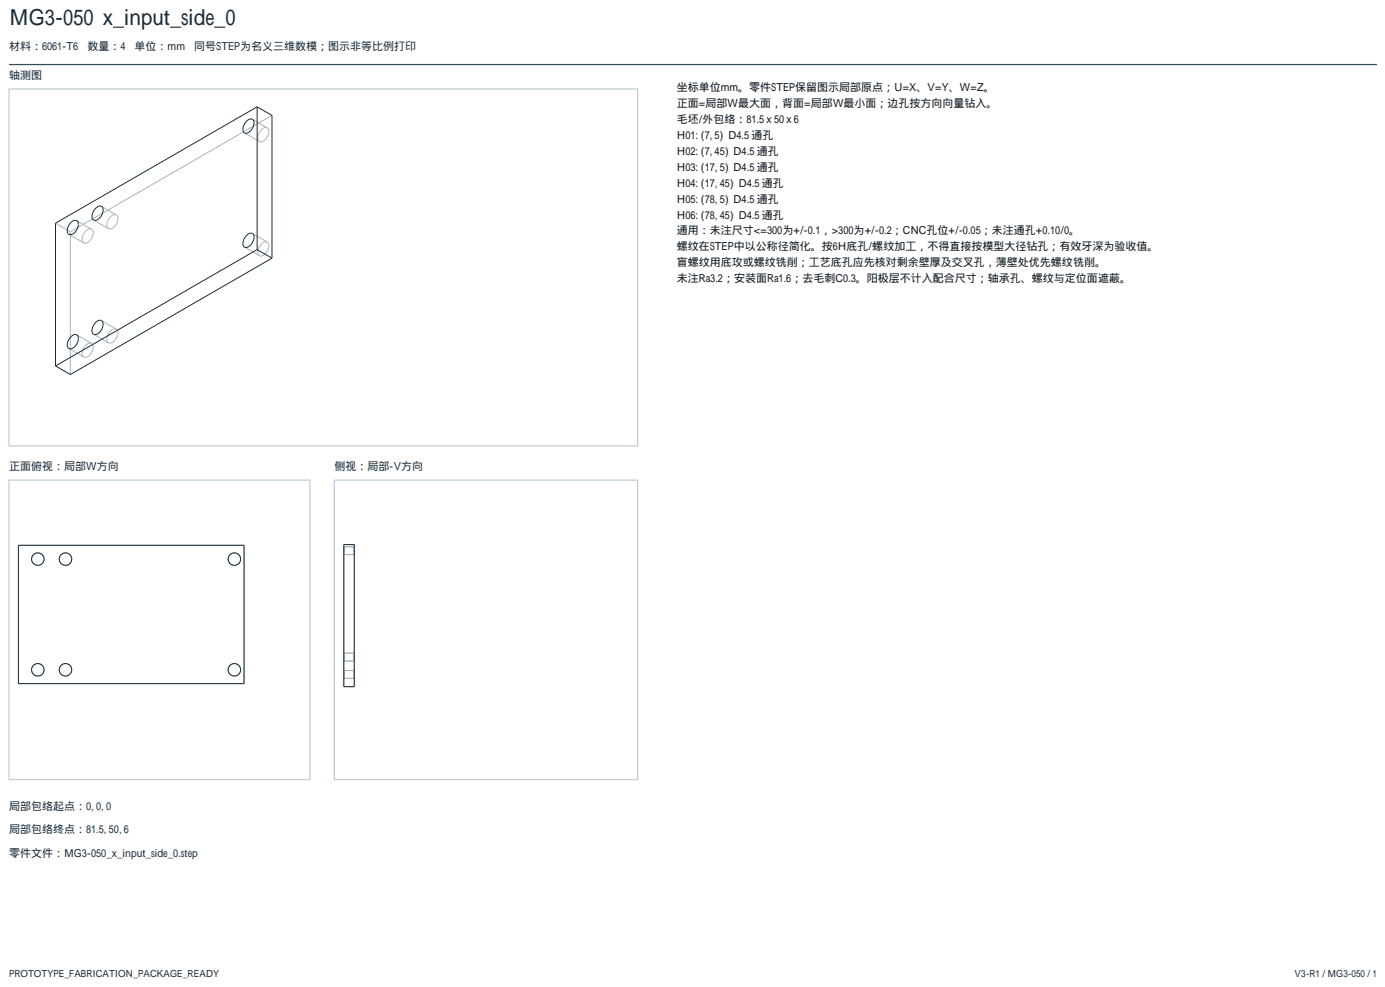
[picture p168: page 50]
轴测图; 正面俯视：局部W方向; 侧视：局部-V方向; 局部包络起点：0, 0, 0; 局部包络终点：81.5, 50, 6; 零件文件：MG3-050_x_input_side_0.step

材料：6061-T6 数量：4 单位：mm 同号STEP为名义三维数模；图示非等比例打印

坐标单位mm。零件STEP保留图示局部原点；U=X、V=Y、W=Z。
正面=局部W最大面，背面=局部W最小面；边孔按方向向量钻入。
毛坯/外包络：81.5 x 50 x 6
通用：未注尺寸<=300为+/-0.1，>300为+/-0.2；CNC孔位+/-0.05；未注通孔+0.10/0。
螺纹在STEP中以公称径简化。按6H底孔/螺纹加工，不得直接按模型大径钻孔；有效牙深为验收值。
盲螺纹用底攻或螺纹铣削；工艺底孔应先核对剩余壁厚及交叉孔，薄壁处优先螺纹铣削。
未注Ra3.2；安装面Ra1.6；去毛刺C0.3。阳极层不计入配合尺寸；轴承孔、螺纹与定位面遮蔽。

# MG3-051 x_motor_bracket

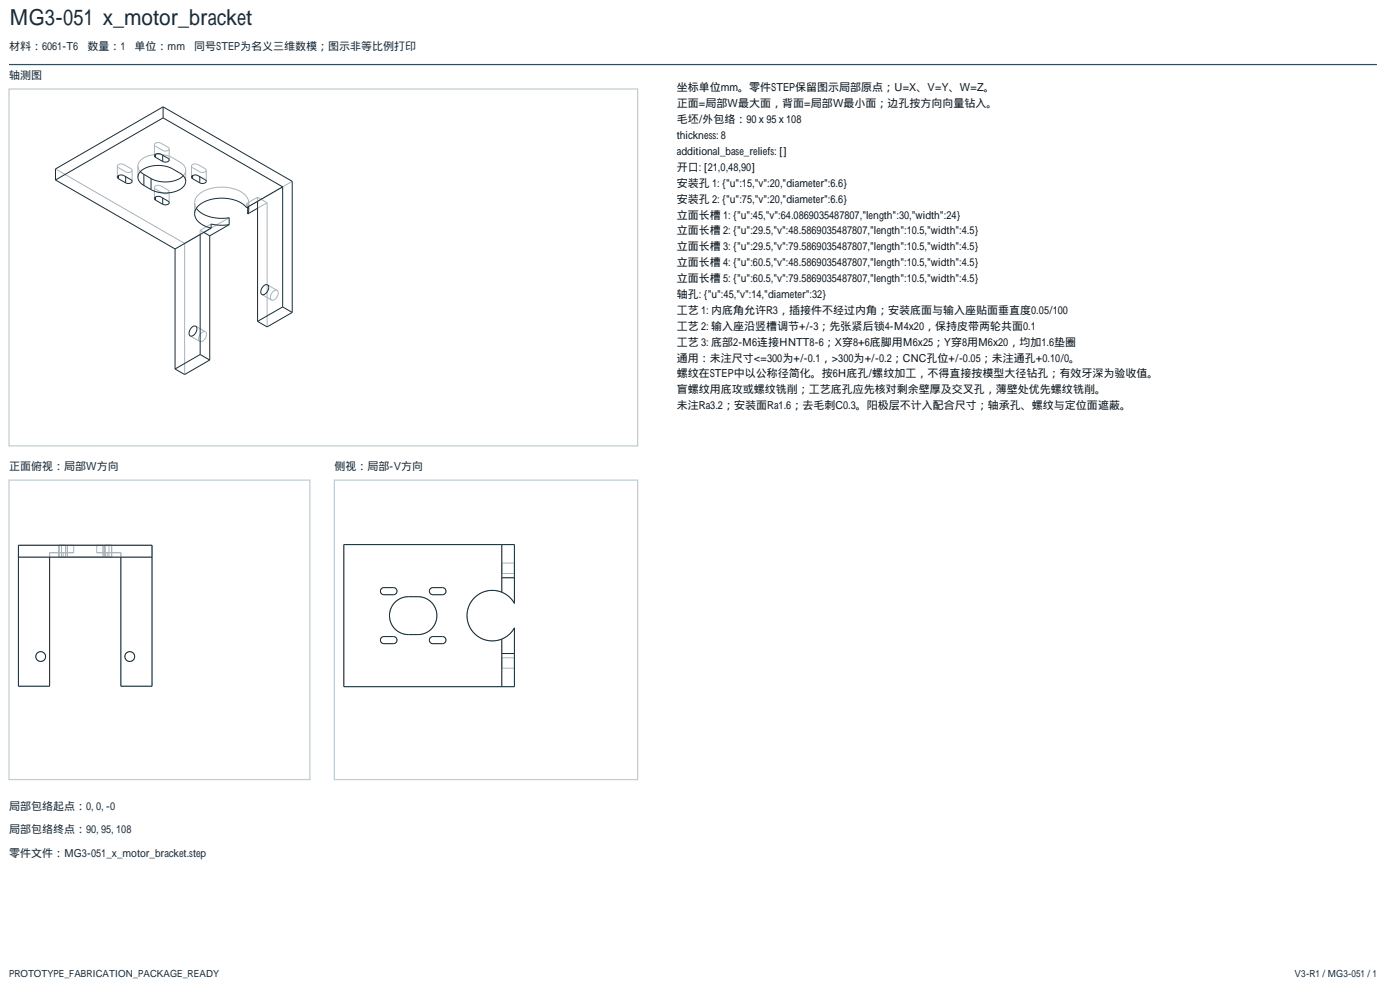
[picture p169: page 51]
轴测图; 正面俯视：局部W方向; 侧视：局部-V方向; 局部包络起点：0, 0, -0; 局部包络终点：90, 95, 108; 零件文件：MG3-051_x_motor_bracket.step

材料：6061-T6 数量：1 单位：mm 同号STEP为名义三维数模；图示非等比例打印

坐标单位mm。零件STEP保留图示局部原点；U=X、V=Y、W=Z。
正面=局部W最大面，背面=局部W最小面；边孔按方向向量钻入。
毛坯/外包络：90 x 95 x 108
thickness: 8
additional_base_reliefs: []
安装孔 1: {"u":15,"v":20,"diameter":6.6}
安装孔 2: {"u":75,"v":20,"diameter":6.6}
立面长槽 1: {"u":45,"v":64.0869035487807,"length":30,"width":24}
立面长槽 2: {"u":29.5,"v":48.5869035487807,"length":10.5,"width":4.5}
立面长槽 3: {"u":29.5,"v":79.5869035487807,"length":10.5,"width":4.5}
立面长槽 4: {"u":60.5,"v":48.5869035487807,"length":10.5,"width":4.5}
立面长槽 5: {"u":60.5,"v":79.5869035487807,"length":10.5,"width":4.5}
轴孔: {"u":45,"v":14,"diameter":32}
工艺 1: 内底角允许R3，插接件不经过内角；安装底面与输入座贴面垂直度0.05/100
工艺 2: 输入座沿竖槽调节+/-3；先张紧后锁4-M4x20，保持皮带两轮共面0.1
工艺 3: 底部2-M6连接HNTT8-6；X穿8+6底脚用M6x25；Y穿8用M6x20，均加1.6垫圈
通用：未注尺寸<=300为+/-0.1，>300为+/-0.2；CNC孔位+/-0.05；未注通孔+0.10/0。
螺纹在STEP中以公称径简化。按6H底孔/螺纹加工，不得直接按模型大径钻孔；有效牙深为验收值。
盲螺纹用底攻或螺纹铣削；工艺底孔应先核对剩余壁厚及交叉孔，薄壁处优先螺纹铣削。
未注Ra3.2；安装面Ra1.6；去毛刺C0.3。阳极层不计入配合尺寸；轴承孔、螺纹与定位面遮蔽。

# MG3-052 x_output_cover_0

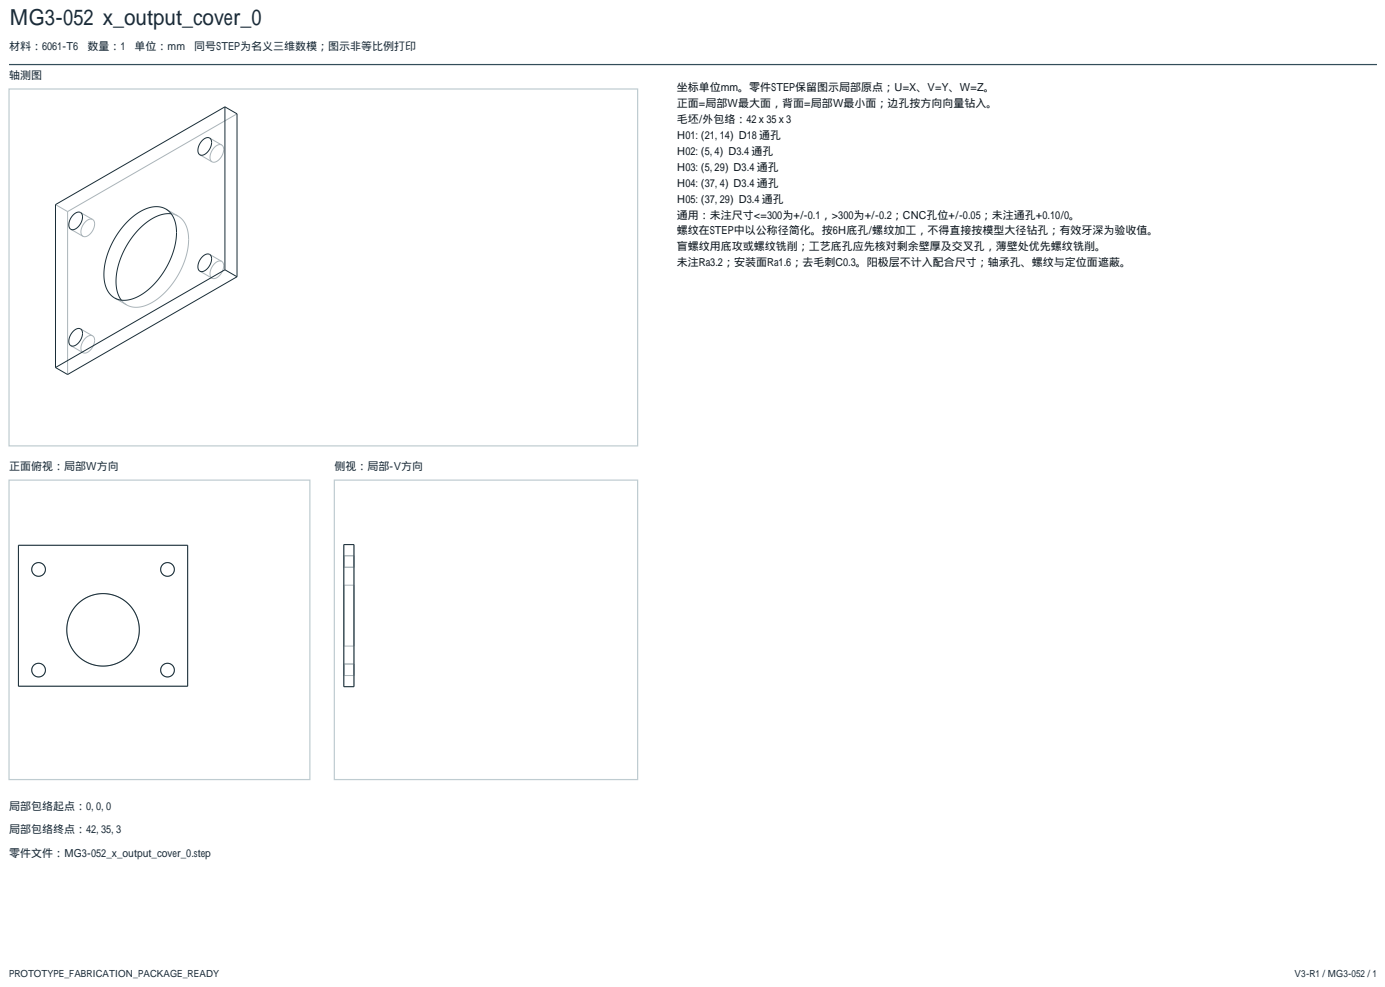
[picture p170: page 52]
轴测图; 正面俯视：局部W方向; 侧视：局部-V方向; 局部包络起点：0, 0, 0; 局部包络终点：42, 35, 3; 零件文件：MG3-052_x_output_cover_0.step

材料：6061-T6 数量：1 单位：mm 同号STEP为名义三维数模；图示非等比例打印

坐标单位mm。零件STEP保留图示局部原点；U=X、V=Y、W=Z。
正面=局部W最大面，背面=局部W最小面；边孔按方向向量钻入。
毛坯/外包络：42 x 35 x 3
通用：未注尺寸<=300为+/-0.1，>300为+/-0.2；CNC孔位+/-0.05；未注通孔+0.10/0。
螺纹在STEP中以公称径简化。按6H底孔/螺纹加工，不得直接按模型大径钻孔；有效牙深为验收值。
盲螺纹用底攻或螺纹铣削；工艺底孔应先核对剩余壁厚及交叉孔，薄壁处优先螺纹铣削。
未注Ra3.2；安装面Ra1.6；去毛刺C0.3。阳极层不计入配合尺寸；轴承孔、螺纹与定位面遮蔽。

# MG3-053 x_output_cover_1

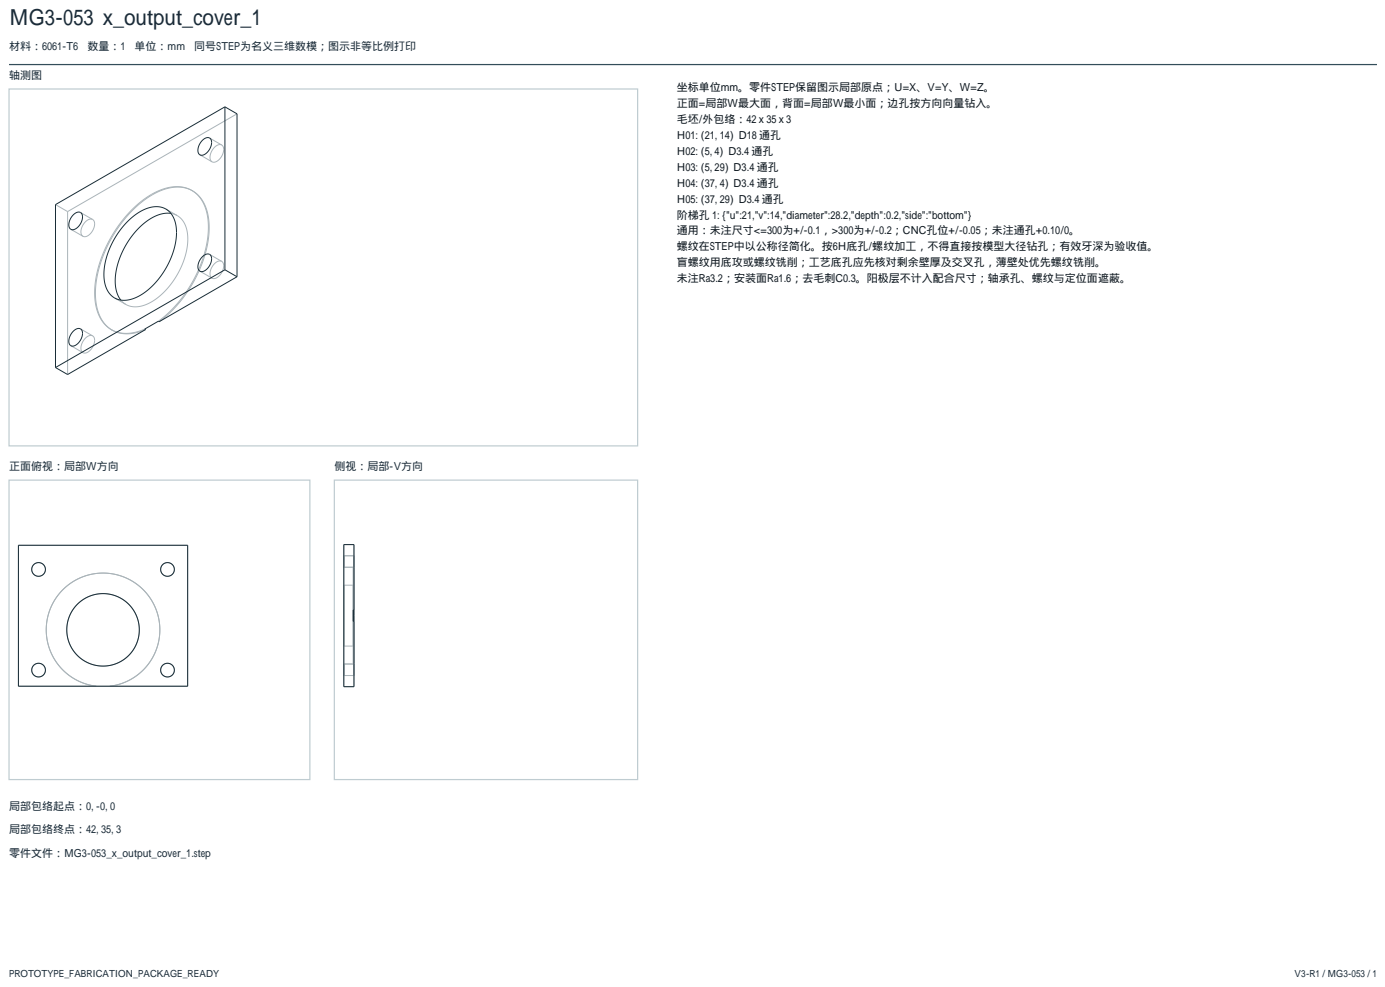
[picture p171: page 53]
轴测图; 正面俯视：局部W方向; 侧视：局部-V方向; 局部包络起点：0, -0, 0; 局部包络终点：42, 35, 3; 零件文件：MG3-053_x_output_cover_1.step

材料：6061-T6 数量：1 单位：mm 同号STEP为名义三维数模；图示非等比例打印

坐标单位mm。零件STEP保留图示局部原点；U=X、V=Y、W=Z。
正面=局部W最大面，背面=局部W最小面；边孔按方向向量钻入。
毛坯/外包络：42 x 35 x 3
阶梯孔 1: {"u":21,"v":14,"diameter":28.2,"depth":0.2,"side":"bottom"}
通用：未注尺寸<=300为+/-0.1，>300为+/-0.2；CNC孔位+/-0.05；未注通孔+0.10/0。
螺纹在STEP中以公称径简化。按6H底孔/螺纹加工，不得直接按模型大径钻孔；有效牙深为验收值。
盲螺纹用底攻或螺纹铣削；工艺底孔应先核对剩余壁厚及交叉孔，薄壁处优先螺纹铣削。
未注Ra3.2；安装面Ra1.6；去毛刺C0.3。阳极层不计入配合尺寸；轴承孔、螺纹与定位面遮蔽。

# MG3-054 x_output_housing

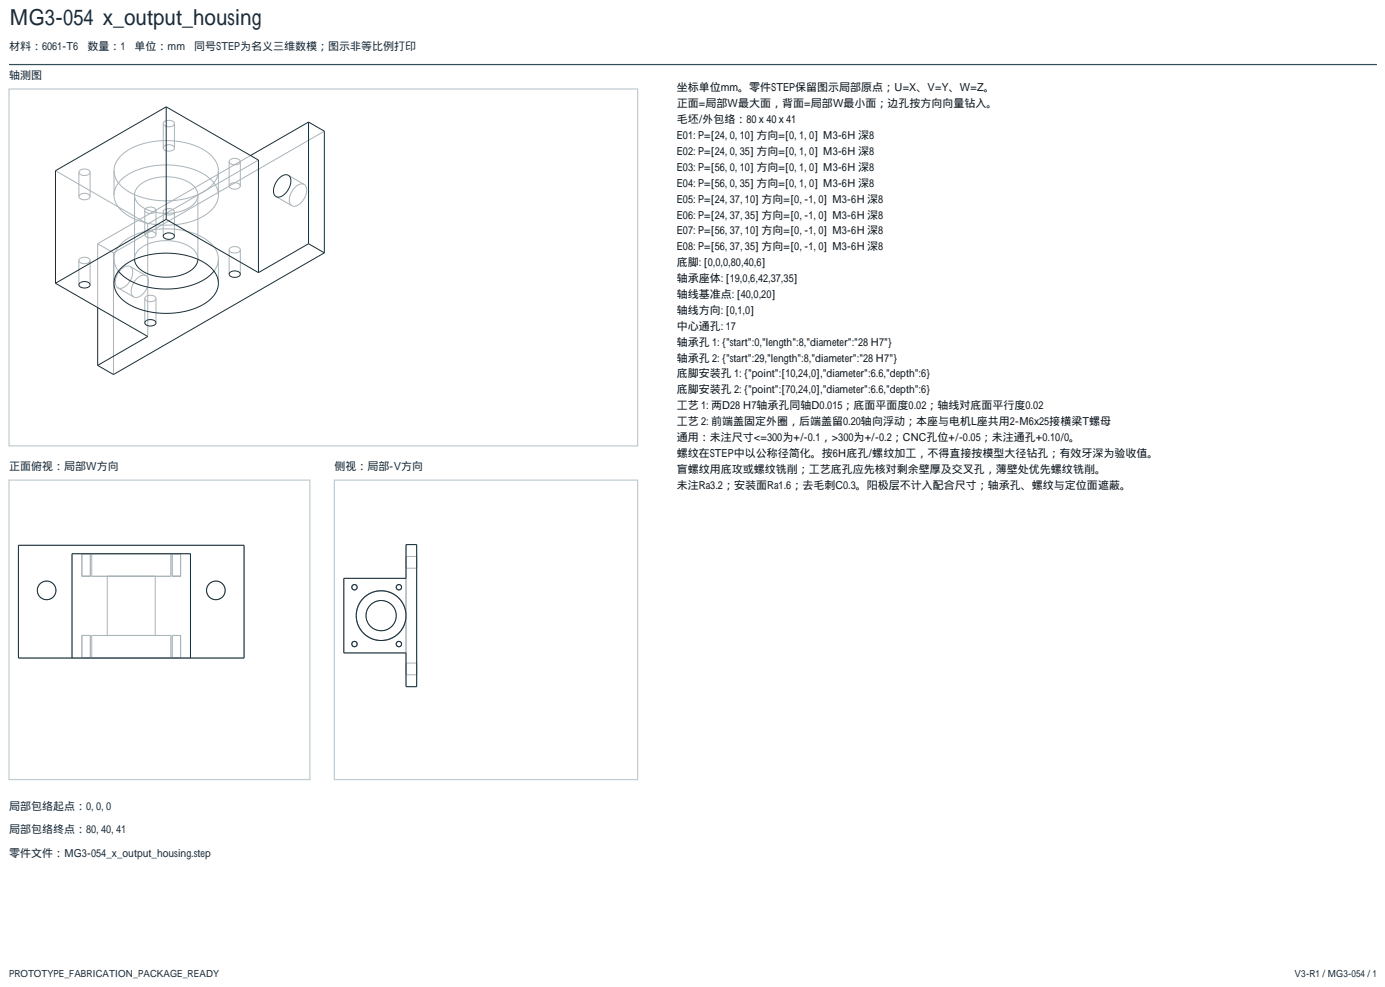
[picture p172: page 54]
轴测图; 正面俯视：局部W方向; 侧视：局部-V方向; 局部包络起点：0, 0, 0; 局部包络终点：80, 40, 41; 零件文件：MG3-054_x_output_housing.step

材料：6061-T6 数量：1 单位：mm 同号STEP为名义三维数模；图示非等比例打印

坐标单位mm。零件STEP保留图示局部原点；U=X、V=Y、W=Z。
正面=局部W最大面，背面=局部W最小面；边孔按方向向量钻入。
毛坯/外包络：80 x 40 x 41
轴承座体: [19,0,6,42,37,35]
轴线基准点: [40,0,20]
轴线方向: [0,1,0]
中心通孔: 17
轴承孔 1: {"start":0,"length":8,"diameter":"28 H7"}
轴承孔 2: {"start":29,"length":8,"diameter":"28 H7"}
底脚安装孔 1: {"point":[10,24,0],"diameter":6.6,"depth":6}
底脚安装孔 2: {"point":[70,24,0],"diameter":6.6,"depth":6}
工艺 1: 两D28 H7轴承孔同轴D0.015；底面平面度0.02；轴线对底面平行度0.02
工艺 2: 前端盖固定外圈，后端盖留0.20轴向浮动；本座与电机L座共用2-M6x25接横梁T螺母
通用：未注尺寸<=300为+/-0.1，>300为+/-0.2；CNC孔位+/-0.05；未注通孔+0.10/0。
螺纹在STEP中以公称径简化。按6H底孔/螺纹加工，不得直接按模型大径钻孔；有效牙深为验收值。
盲螺纹用底攻或螺纹铣削；工艺底孔应先核对剩余壁厚及交叉孔，薄壁处优先螺纹铣削。
未注Ra3.2；安装面Ra1.6；去毛刺C0.3。阳极层不计入配合尺寸；轴承孔、螺纹与定位面遮蔽。

# MG3-055 x_output_shaft

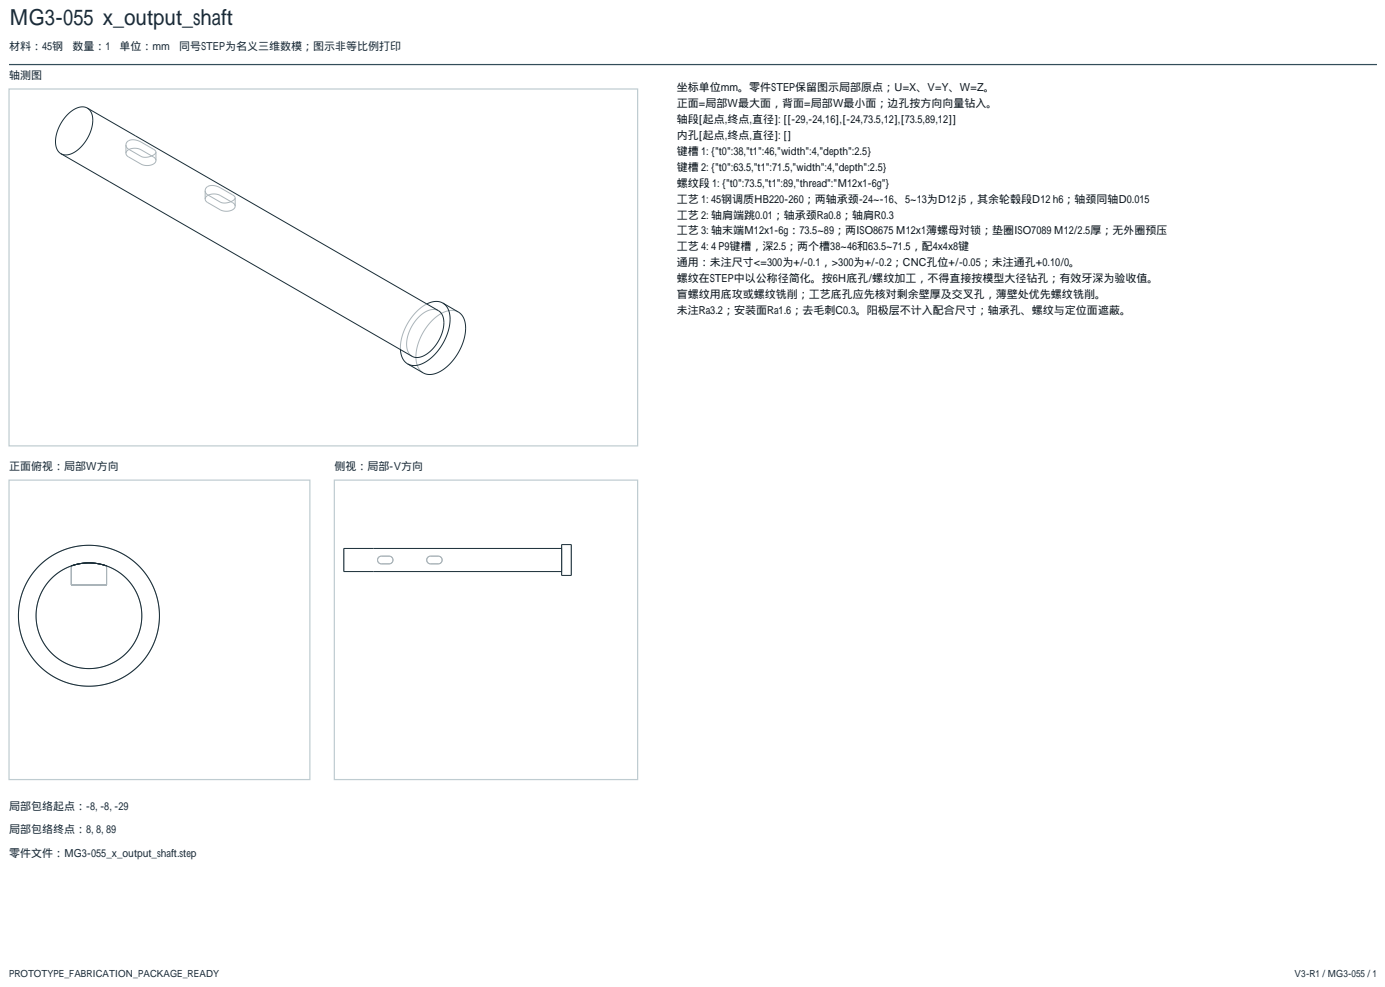
[picture p173: page 55]
轴测图; 正面俯视：局部W方向; 侧视：局部-V方向; 局部包络起点：-8, -8, -29; 局部包络终点：8, 8, 89; 零件文件：MG3-055_x_output_shaft.step

材料：45钢 数量：1 单位：mm 同号STEP为名义三维数模；图示非等比例打印

坐标单位mm。零件STEP保留图示局部原点；U=X、V=Y、W=Z。
正面=局部W最大面，背面=局部W最小面；边孔按方向向量钻入。
键槽 1: {"t0":38,"t1":46,"width":4,"depth":2.5}
键槽 2: {"t0":63.5,"t1":71.5,"width":4,"depth":2.5}
螺纹段 1: {"t0":73.5,"t1":89,"thread":"M12x1-6g"}
工艺 1: 45钢调质HB220-260；两轴承颈-24~-16、5~13为D12 j5，其余轮毂段D12 h6；轴颈同轴D0.015
工艺 2: 轴肩端跳0.01；轴承颈Ra0.8；轴肩R0.3
工艺 3: 轴末端M12x1-6g：73.5~89；两ISO8675 M12x1薄螺母对锁；垫圈ISO7089 M12/2.5厚；无外圈预压
工艺 4: 4 P9键槽，深2.5；两个槽38~46和63.5~71.5，配4x4x8键
通用：未注尺寸<=300为+/-0.1，>300为+/-0.2；CNC孔位+/-0.05；未注通孔+0.10/0。
螺纹在STEP中以公称径简化。按6H底孔/螺纹加工，不得直接按模型大径钻孔；有效牙深为验收值。
盲螺纹用底攻或螺纹铣削；工艺底孔应先核对剩余壁厚及交叉孔，薄壁处优先螺纹铣削。
未注Ra3.2；安装面Ra1.6；去毛刺C0.3。阳极层不计入配合尺寸；轴承孔、螺纹与定位面遮蔽。

# MG3-056 x_output_spacer_0

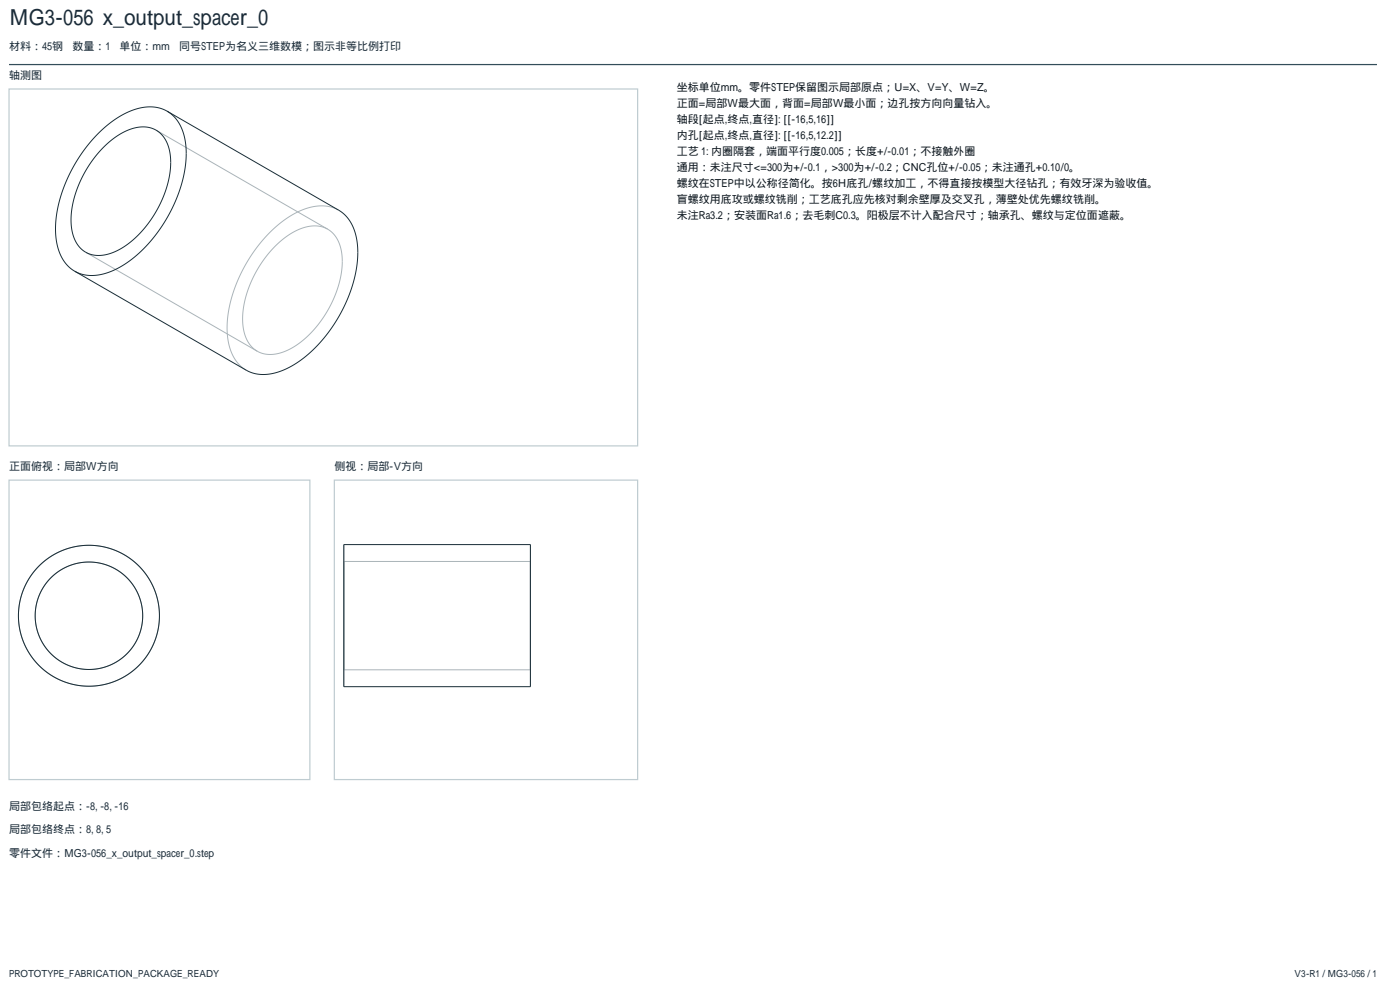
[picture p174: page 56]
轴测图; 正面俯视：局部W方向; 侧视：局部-V方向; 局部包络起点：-8, -8, -16; 局部包络终点：8, 8, 5; 零件文件：MG3-056_x_output_spacer_0.step

材料：45钢 数量：1 单位：mm 同号STEP为名义三维数模；图示非等比例打印

坐标单位mm。零件STEP保留图示局部原点；U=X、V=Y、W=Z。
正面=局部W最大面，背面=局部W最小面；边孔按方向向量钻入。
工艺 1: 内圈隔套，端面平行度0.005；长度+/-0.01；不接触外圈
通用：未注尺寸<=300为+/-0.1，>300为+/-0.2；CNC孔位+/-0.05；未注通孔+0.10/0。
螺纹在STEP中以公称径简化。按6H底孔/螺纹加工，不得直接按模型大径钻孔；有效牙深为验收值。
盲螺纹用底攻或螺纹铣削；工艺底孔应先核对剩余壁厚及交叉孔，薄壁处优先螺纹铣削。
未注Ra3.2；安装面Ra1.6；去毛刺C0.3。阳极层不计入配合尺寸；轴承孔、螺纹与定位面遮蔽。

# MG3-057 x_output_spacer_1

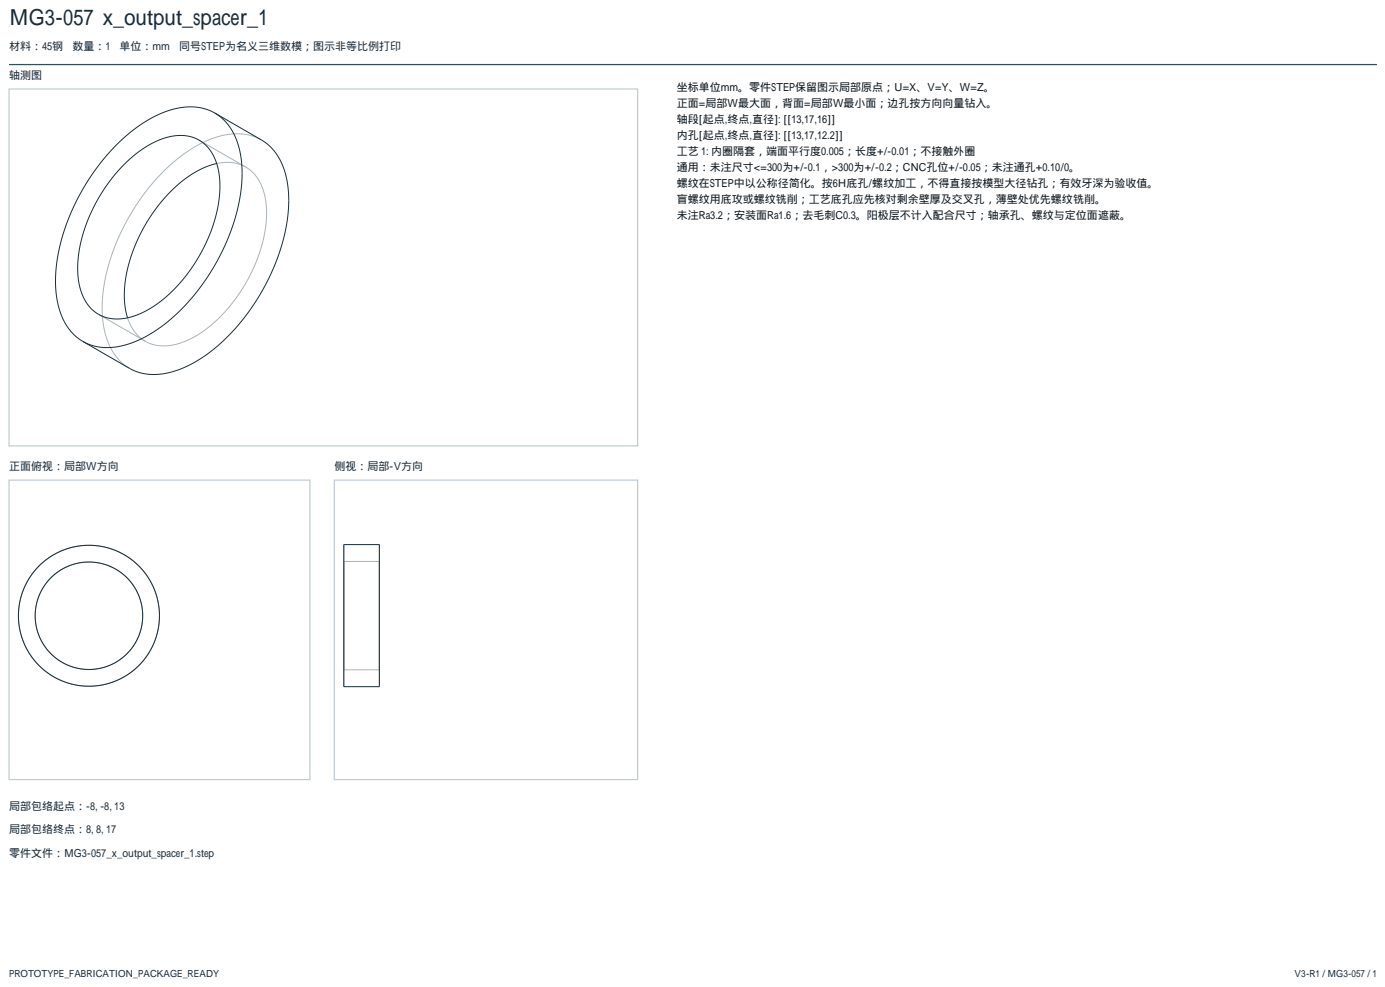
[picture p175: page 57]
轴测图; 正面俯视：局部W方向; 侧视：局部-V方向; 局部包络起点：-8, -8, 13; 局部包络终点：8, 8, 17; 零件文件：MG3-057_x_output_spacer_1.step

材料：45钢 数量：1 单位：mm 同号STEP为名义三维数模；图示非等比例打印

坐标单位mm。零件STEP保留图示局部原点；U=X、V=Y、W=Z。
正面=局部W最大面，背面=局部W最小面；边孔按方向向量钻入。
工艺 1: 内圈隔套，端面平行度0.005；长度+/-0.01；不接触外圈
通用：未注尺寸<=300为+/-0.1，>300为+/-0.2；CNC孔位+/-0.05；未注通孔+0.10/0。
螺纹在STEP中以公称径简化。按6H底孔/螺纹加工，不得直接按模型大径钻孔；有效牙深为验收值。
盲螺纹用底攻或螺纹铣削；工艺底孔应先核对剩余壁厚及交叉孔，薄壁处优先螺纹铣削。
未注Ra3.2；安装面Ra1.6；去毛刺C0.3。阳极层不计入配合尺寸；轴承孔、螺纹与定位面遮蔽。

# MG3-058 x_output_spacer_2

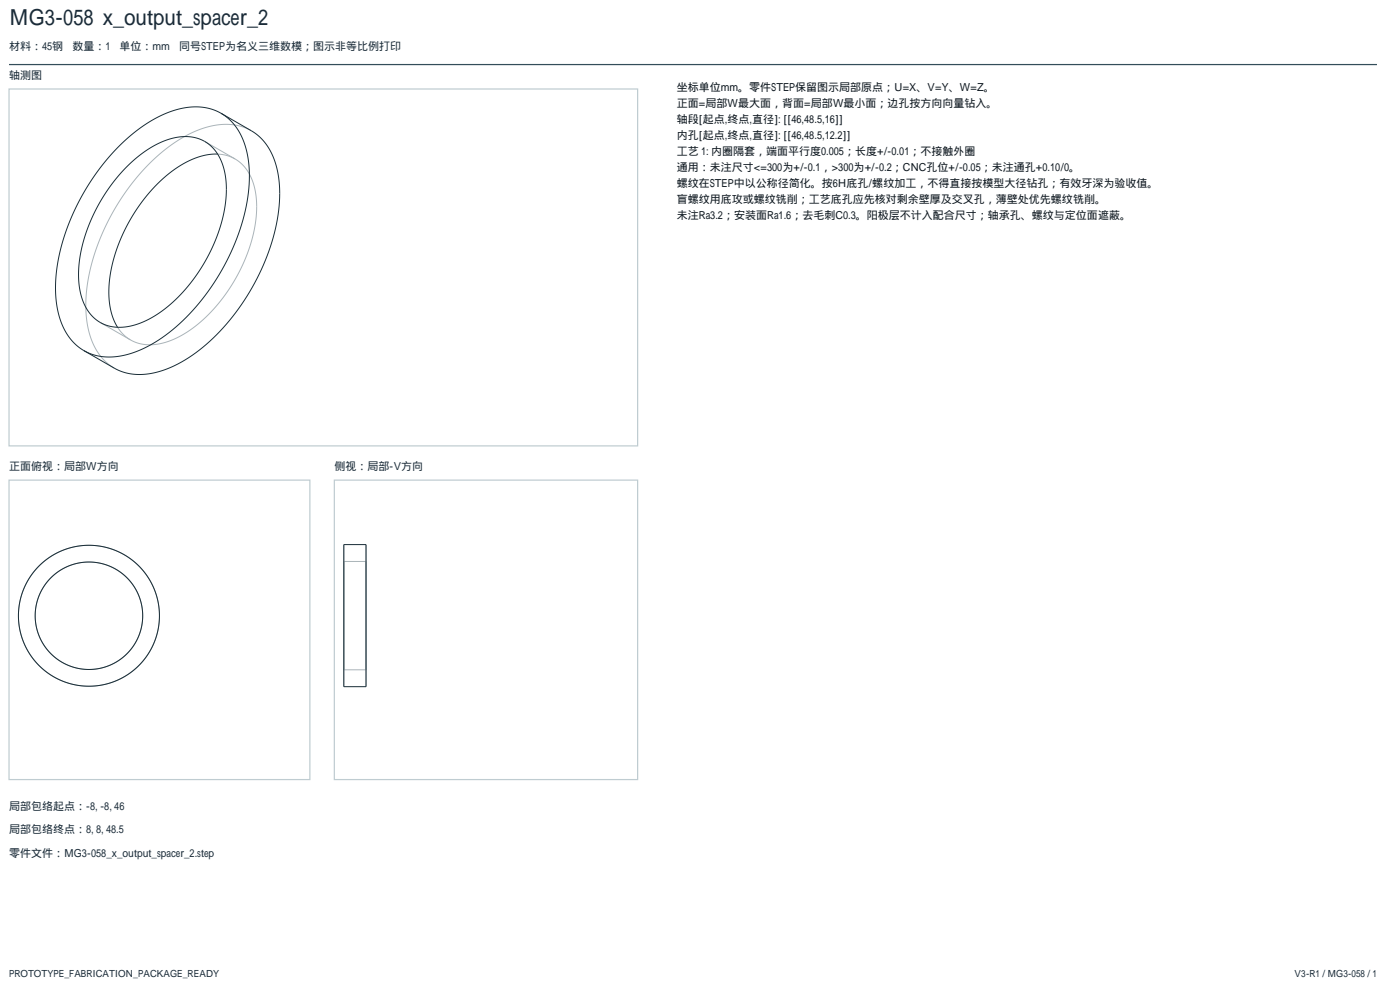
[picture p176: page 58]
轴测图; 正面俯视：局部W方向; 侧视：局部-V方向; 局部包络起点：-8, -8, 46; 局部包络终点：8, 8, 48.5; 零件文件：MG3-058_x_output_spacer_2.step

材料：45钢 数量：1 单位：mm 同号STEP为名义三维数模；图示非等比例打印

坐标单位mm。零件STEP保留图示局部原点；U=X、V=Y、W=Z。
正面=局部W最大面，背面=局部W最小面；边孔按方向向量钻入。
工艺 1: 内圈隔套，端面平行度0.005；长度+/-0.01；不接触外圈
通用：未注尺寸<=300为+/-0.1，>300为+/-0.2；CNC孔位+/-0.05；未注通孔+0.10/0。
螺纹在STEP中以公称径简化。按6H底孔/螺纹加工，不得直接按模型大径钻孔；有效牙深为验收值。
盲螺纹用底攻或螺纹铣削；工艺底孔应先核对剩余壁厚及交叉孔，薄壁处优先螺纹铣削。
未注Ra3.2；安装面Ra1.6；去毛刺C0.3。阳极层不计入配合尺寸；轴承孔、螺纹与定位面遮蔽。

# MG3-059 x_output_spacer_3

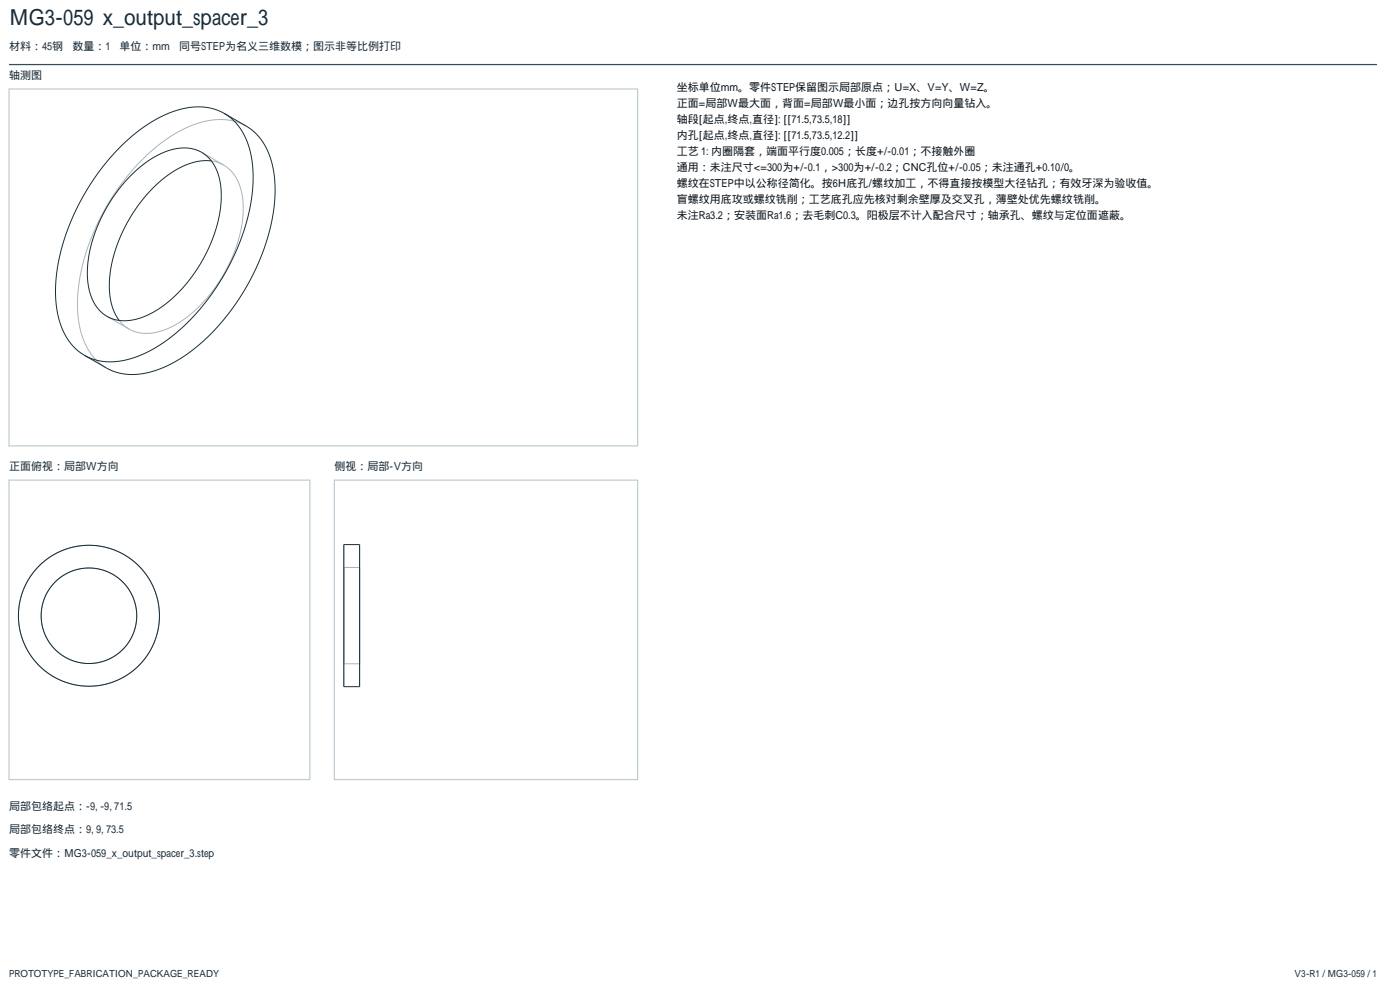
[picture p177: page 59]
轴测图; 正面俯视：局部W方向; 侧视：局部-V方向; 局部包络起点：-9, -9, 71.5; 局部包络终点：9, 9, 73.5; 零件文件：MG3-059_x_output_spacer_3.step

材料：45钢 数量：1 单位：mm 同号STEP为名义三维数模；图示非等比例打印

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

# MG3-060 x_pulley_0

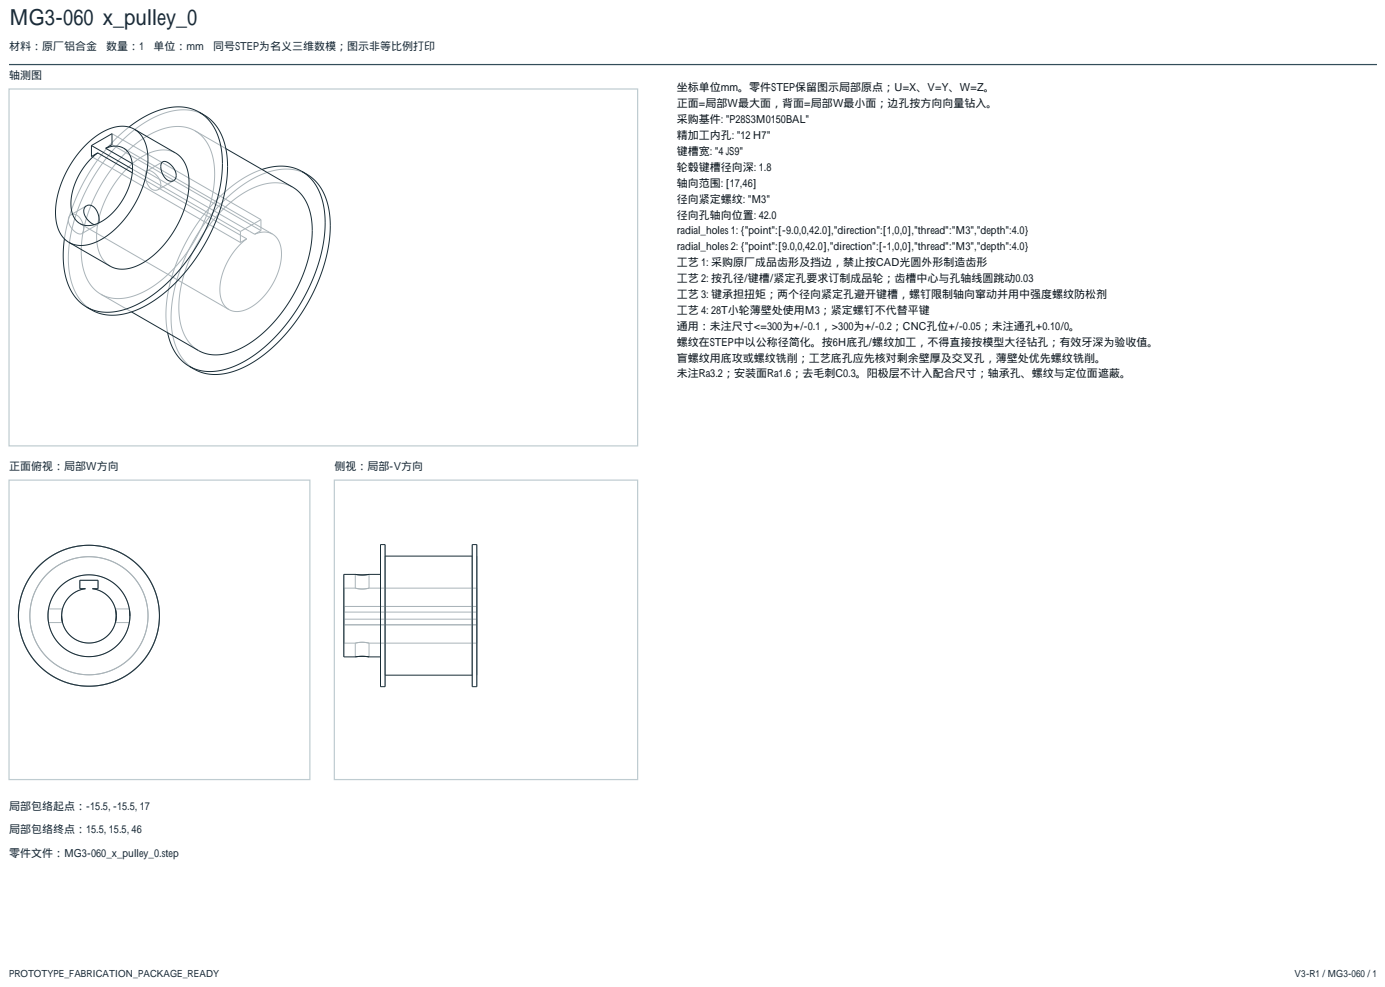
[picture p178: page 60]
轴测图; 正面俯视：局部W方向; 侧视：局部-V方向; 局部包络起点：-15.5, -15.5, 17; 局部包络终点：15.5, 15.5, 46; 零件文件：MG3-060_x_pulley_0.step

材料：原厂铝合金 数量：1 单位：mm 同号STEP为名义三维数模；图示非等比例打印

坐标单位mm。零件STEP保留图示局部原点；U=X、V=Y、W=Z。
正面=局部W最大面，背面=局部W最小面；边孔按方向向量钻入。
采购基件: "P28S3M0150BAL"
精加工内孔: "12 H7"
键槽宽: "4 JS9"
轮毂键槽径向深: 1.8
轴向范围: [17,46]
径向紧定螺纹: "M3"
径向孔轴向位置: 42.0
radial_holes 1: {"point":[-9.0,0,42.0],"direction":[1,0,0],"thread":"M3","depth":4.0}
radial_holes 2: {"point":[9.0,0,42.0],"direction":[-1,0,0],"thread":"M3","depth":4.0}
工艺 1: 采购原厂成品齿形及挡边，禁止按CAD光圆外形制造齿形
工艺 2: 按孔径/键槽/紧定孔要求订制成品轮；齿槽中心与孔轴线圆跳动0.03
工艺 3: 键承担扭矩；两个径向紧定孔避开键槽，螺钉限制轴向窜动并用中强度螺纹防松剂
工艺 4: 28T小轮薄壁处使用M3；紧定螺钉不代替平键
通用：未注尺寸<=300为+/-0.1，>300为+/-0.2；CNC孔位+/-0.05；未注通孔+0.10/0。
螺纹在STEP中以公称径简化。按6H底孔/螺纹加工，不得直接按模型大径钻孔；有效牙深为验收值。
盲螺纹用底攻或螺纹铣削；工艺底孔应先核对剩余壁厚及交叉孔，薄壁处优先螺纹铣削。
未注Ra3.2；安装面Ra1.6；去毛刺C0.3。阳极层不计入配合尺寸；轴承孔、螺纹与定位面遮蔽。

# MG3-061 x_rail_base_0

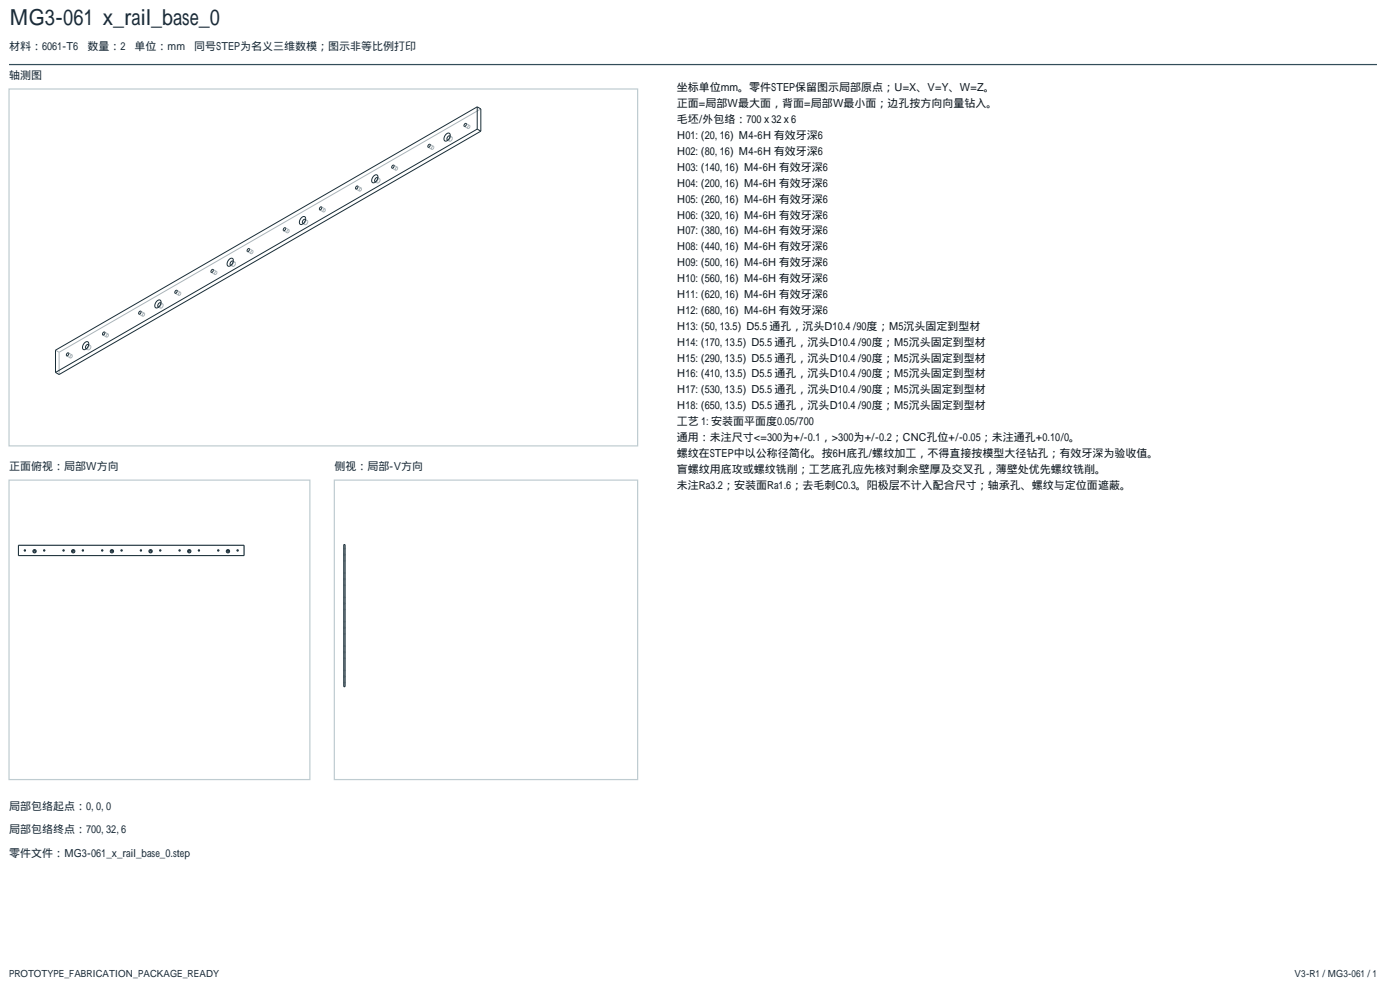
[picture p179: page 61]
轴测图; 正面俯视：局部W方向; 侧视：局部-V方向; 局部包络起点：0, 0, 0; 局部包络终点：700, 32, 6; 零件文件：MG3-061_x_rail_base_0.step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

材料：6061-T6 数量：2 单位：mm 同号STEP为名义三维数模；图示非等比例打印

# MG3-062 x_reduction_driven_pulley

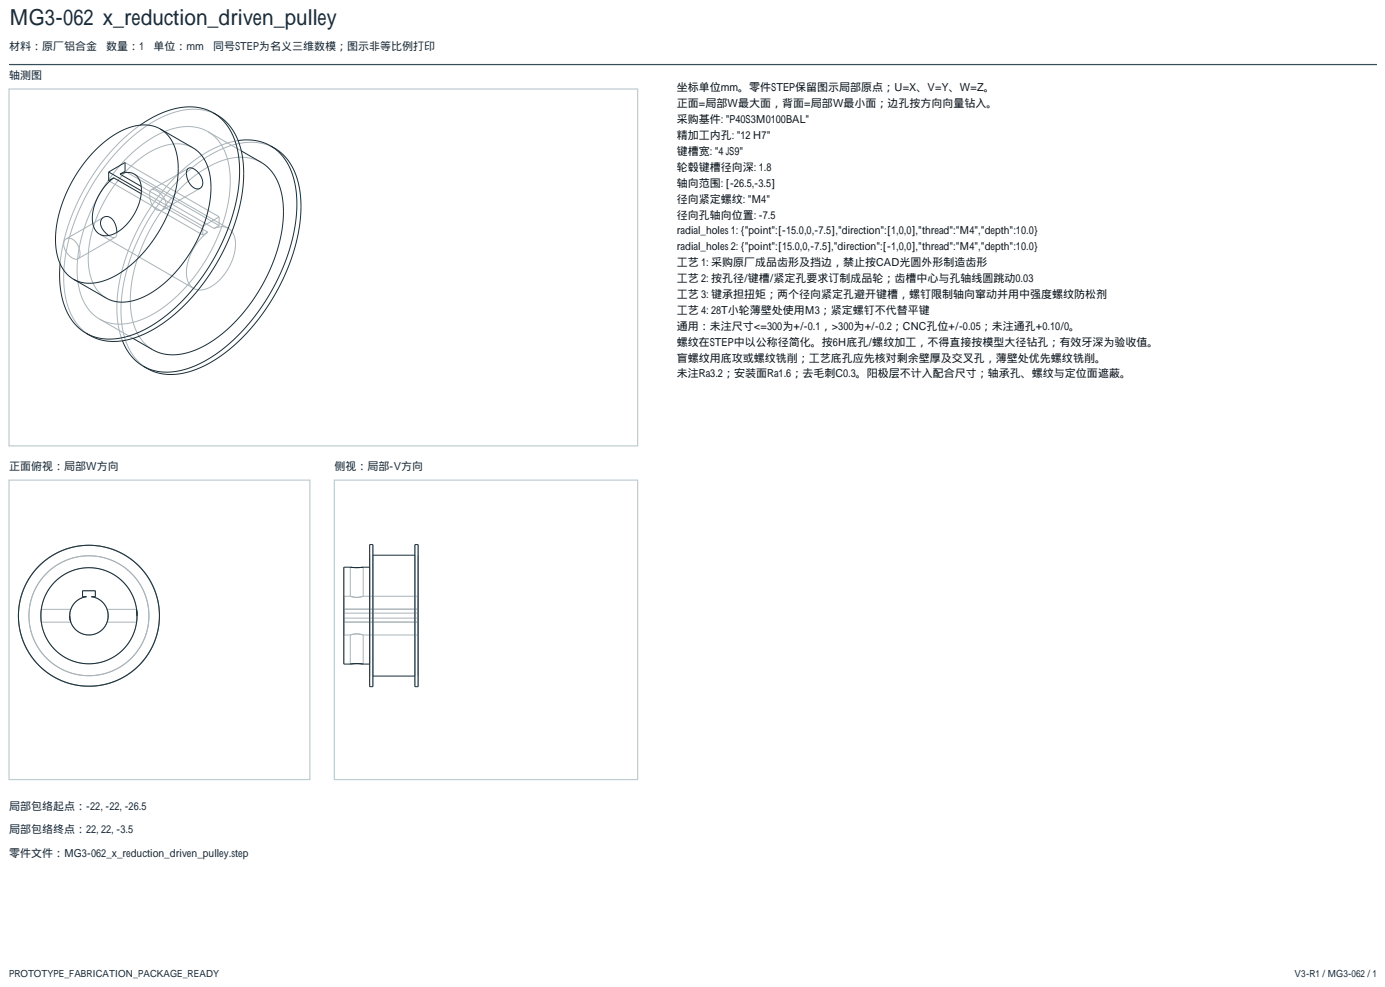
[picture p180: page 62]
轴测图; 正面俯视：局部W方向; 侧视：局部-V方向; 局部包络起点：-22, -22, -26.5; 局部包络终点：22, 22, -3.5; 零件文件：MG3-062_x_reduction_driven_pulley.step

材料：原厂铝合金 数量：1 单位：mm 同号STEP为名义三维数模；图示非等比例打印

坐标单位mm。零件STEP保留图示局部原点；U=X、V=Y、W=Z。
正面=局部W最大面，背面=局部W最小面；边孔按方向向量钻入。
采购基件: "P40S3M0100BAL"
精加工内孔: "12 H7"
键槽宽: "4 JS9"
轮毂键槽径向深: 1.8
轴向范围: [-26.5,-3.5]
径向紧定螺纹: "M4"
径向孔轴向位置: -7.5
radial_holes 1: {"point":[-15.0,0,-7.5],"direction":[1,0,0],"thread":"M4","depth":10.0}
radial_holes 2: {"point":[15.0,0,-7.5],"direction":[-1,0,0],"thread":"M4","depth":10.0}
工艺 1: 采购原厂成品齿形及挡边，禁止按CAD光圆外形制造齿形
工艺 2: 按孔径/键槽/紧定孔要求订制成品轮；齿槽中心与孔轴线圆跳动0.03
工艺 3: 键承担扭矩；两个径向紧定孔避开键槽，螺钉限制轴向窜动并用中强度螺纹防松剂
工艺 4: 28T小轮薄壁处使用M3；紧定螺钉不代替平键
通用：未注尺寸<=300为+/-0.1，>300为+/-0.2；CNC孔位+/-0.05；未注通孔+0.10/0。
螺纹在STEP中以公称径简化。按6H底孔/螺纹加工，不得直接按模型大径钻孔；有效牙深为验收值。
盲螺纹用底攻或螺纹铣削；工艺底孔应先核对剩余壁厚及交叉孔，薄壁处优先螺纹铣削。
未注Ra3.2；安装面Ra1.6；去毛刺C0.3。阳极层不计入配合尺寸；轴承孔、螺纹与定位面遮蔽。

# MG3-063 x_reduction_input_pulley

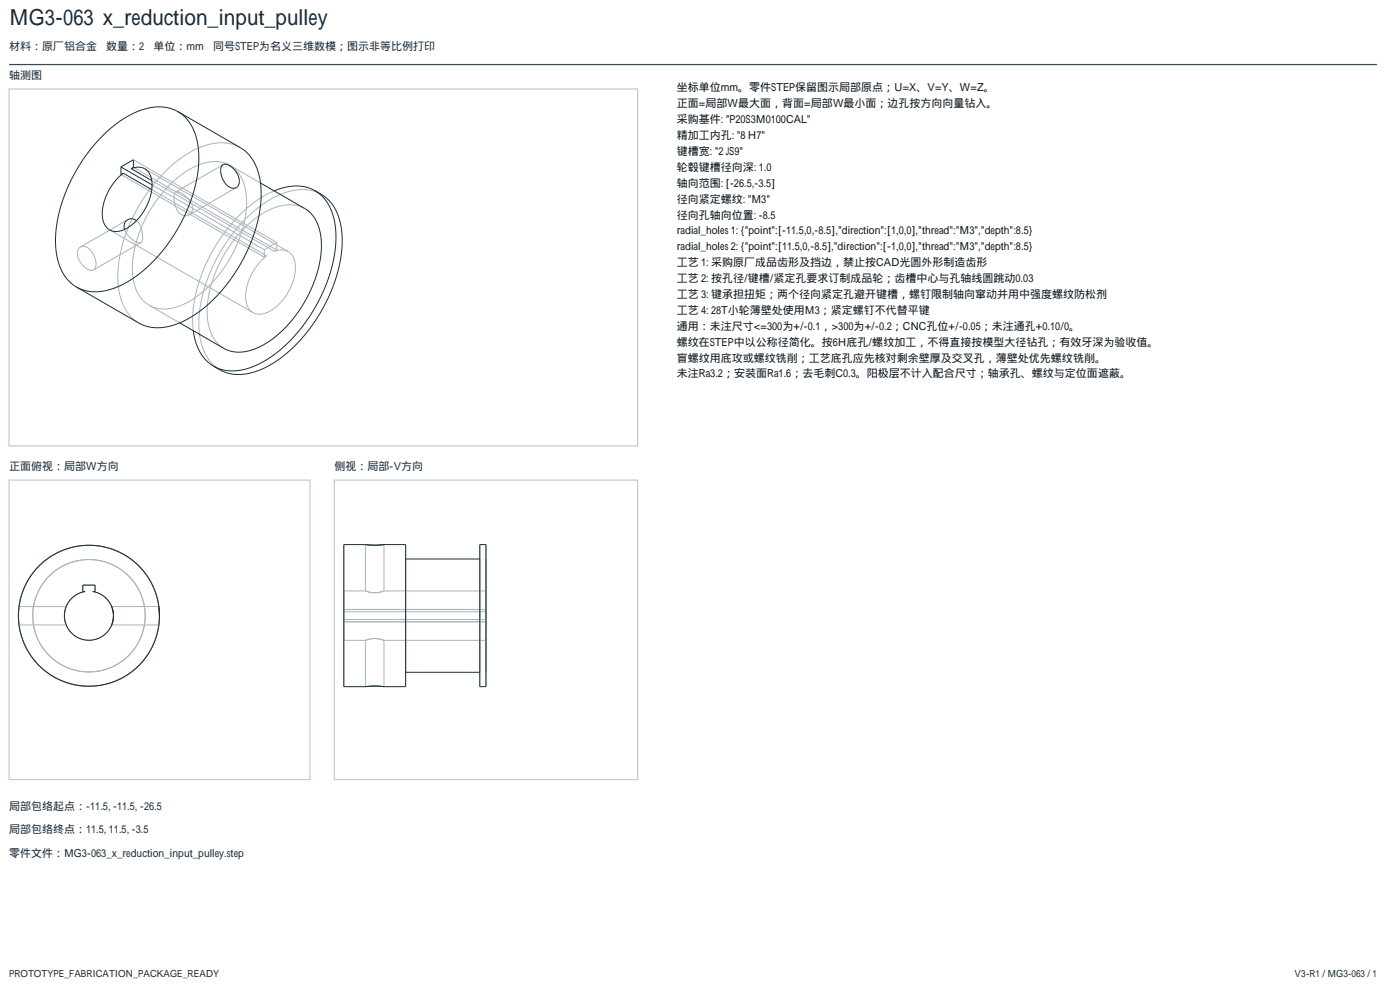
[picture p181: page 63]
轴测图; 正面俯视：局部W方向; 侧视：局部-V方向; 局部包络起点：-11.5, -11.5, -26.5; 局部包络终点：11.5, 11.5, -3.5; 零件文件：MG3-063_x_reduction_input_pulley.step

材料：原厂铝合金 数量：2 单位：mm 同号STEP为名义三维数模；图示非等比例打印

坐标单位mm。零件STEP保留图示局部原点；U=X、V=Y、W=Z。
正面=局部W最大面，背面=局部W最小面；边孔按方向向量钻入。
采购基件: "P20S3M0100CAL"
精加工内孔: "8 H7"
键槽宽: "2 JS9"
轮毂键槽径向深: 1.0
轴向范围: [-26.5,-3.5]
径向紧定螺纹: "M3"
径向孔轴向位置: -8.5
radial_holes 1: {"point":[-11.5,0,-8.5],"direction":[1,0,0],"thread":"M3","depth":8.5}
radial_holes 2: {"point":[11.5,0,-8.5],"direction":[-1,0,0],"thread":"M3","depth":8.5}
工艺 1: 采购原厂成品齿形及挡边，禁止按CAD光圆外形制造齿形
工艺 2: 按孔径/键槽/紧定孔要求订制成品轮；齿槽中心与孔轴线圆跳动0.03
工艺 3: 键承担扭矩；两个径向紧定孔避开键槽，螺钉限制轴向窜动并用中强度螺纹防松剂
工艺 4: 28T小轮薄壁处使用M3；紧定螺钉不代替平键
通用：未注尺寸<=300为+/-0.1，>300为+/-0.2；CNC孔位+/-0.05；未注通孔+0.10/0。
螺纹在STEP中以公称径简化。按6H底孔/螺纹加工，不得直接按模型大径钻孔；有效牙深为验收值。
盲螺纹用底攻或螺纹铣削；工艺底孔应先核对剩余壁厚及交叉孔，薄壁处优先螺纹铣削。
未注Ra3.2；安装面Ra1.6；去毛刺C0.3。阳极层不计入配合尺寸；轴承孔、螺纹与定位面遮蔽。

# MG3-064 x_tension_0_adjuster

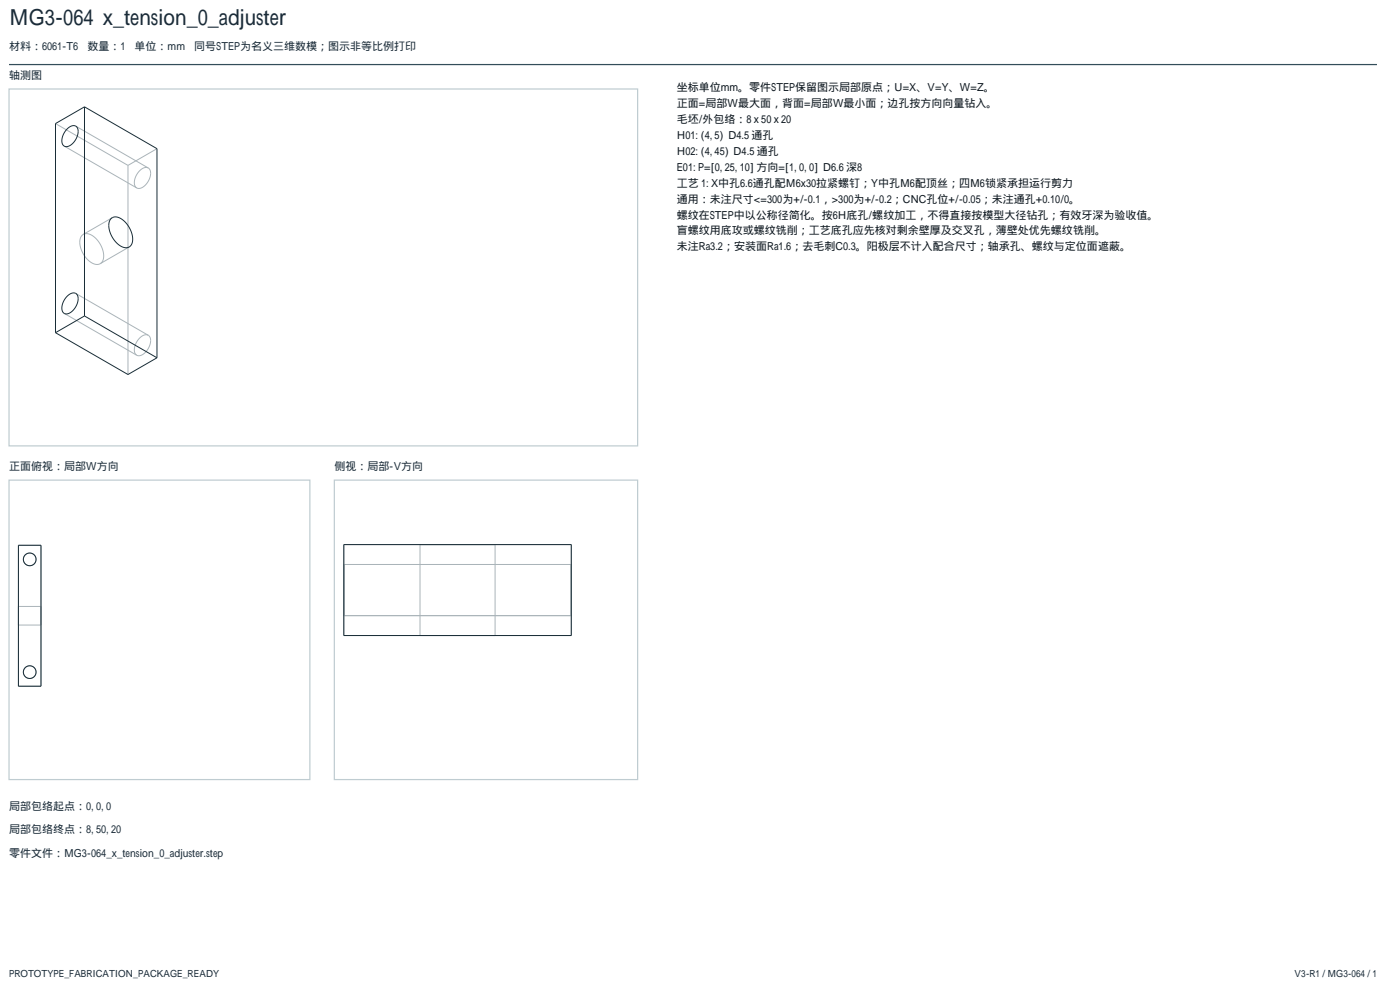
[picture p182: page 64]
轴测图; 正面俯视：局部W方向; 侧视：局部-V方向; 局部包络起点：0, 0, 0; 局部包络终点：8, 50, 20; 零件文件：MG3-064_x_tension_0_adjuster.step

材料：6061-T6 数量：1 单位：mm 同号STEP为名义三维数模；图示非等比例打印

坐标单位mm。零件STEP保留图示局部原点；U=X、V=Y、W=Z。
正面=局部W最大面，背面=局部W最小面；边孔按方向向量钻入。
毛坯/外包络：8 x 50 x 20
工艺 1: X中孔6.6通孔配M6x30拉紧螺钉；Y中孔M6配顶丝；四M6锁紧承担运行剪力
通用：未注尺寸<=300为+/-0.1，>300为+/-0.2；CNC孔位+/-0.05；未注通孔+0.10/0。
螺纹在STEP中以公称径简化。按6H底孔/螺纹加工，不得直接按模型大径钻孔；有效牙深为验收值。
盲螺纹用底攻或螺纹铣削；工艺底孔应先核对剩余壁厚及交叉孔，薄壁处优先螺纹铣削。
未注Ra3.2；安装面Ra1.6；去毛刺C0.3。阳极层不计入配合尺寸；轴承孔、螺纹与定位面遮蔽。

# MG3-065 x_tension_0_axle

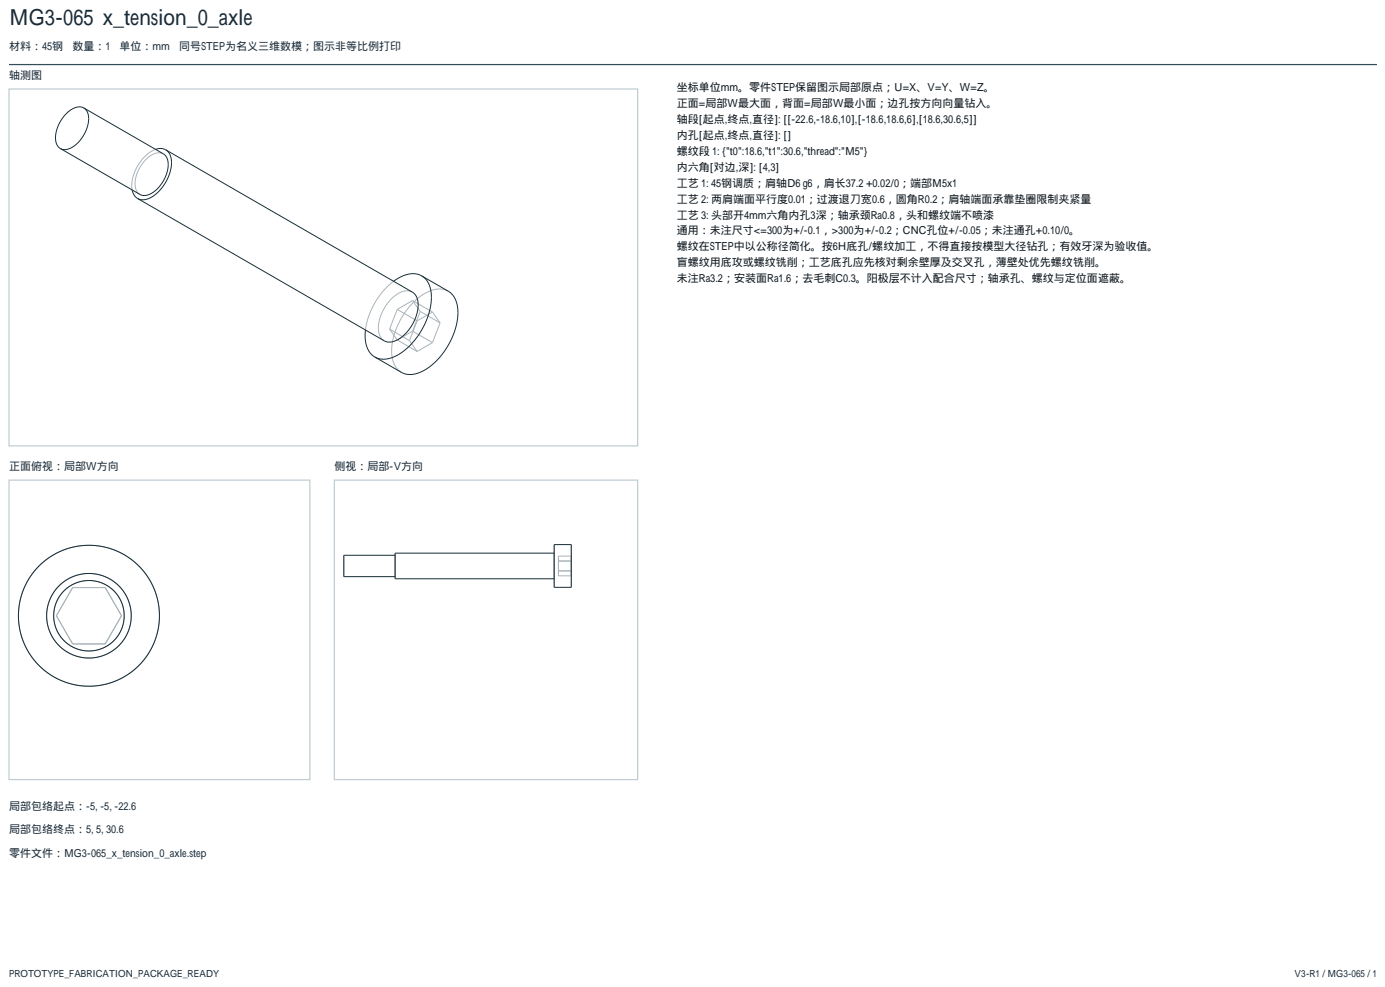
[picture p183: page 65]
轴测图; 正面俯视：局部W方向; 侧视：局部-V方向; 局部包络起点：-5, -5, -22.6; 局部包络终点：5, 5, 30.6; 零件文件：MG3-065_x_tension_0_axle.step

材料：45钢 数量：1 单位：mm 同号STEP为名义三维数模；图示非等比例打印

坐标单位mm。零件STEP保留图示局部原点；U=X、V=Y、W=Z。
正面=局部W最大面，背面=局部W最小面；边孔按方向向量钻入。
螺纹段 1: {"t0":18.6,"t1":30.6,"thread":"M5"}
内六角[对边,深]: [4,3]
工艺 1: 45钢调质；肩轴D6 g6，肩长37.2 +0.02/0；端部M5x1
工艺 2: 两肩端面平行度0.01；过渡退刀宽0.6，圆角R0.2；肩轴端面承靠垫圈限制夹紧量
工艺 3: 头部开4mm六角内孔3深；轴承颈Ra0.8，头和螺纹端不喷漆
通用：未注尺寸<=300为+/-0.1，>300为+/-0.2；CNC孔位+/-0.05；未注通孔+0.10/0。
螺纹在STEP中以公称径简化。按6H底孔/螺纹加工，不得直接按模型大径钻孔；有效牙深为验收值。
盲螺纹用底攻或螺纹铣削；工艺底孔应先核对剩余壁厚及交叉孔，薄壁处优先螺纹铣削。
未注Ra3.2；安装面Ra1.6；去毛刺C0.3。阳极层不计入配合尺寸；轴承孔、螺纹与定位面遮蔽。

# MG3-066 x_tension_0_base

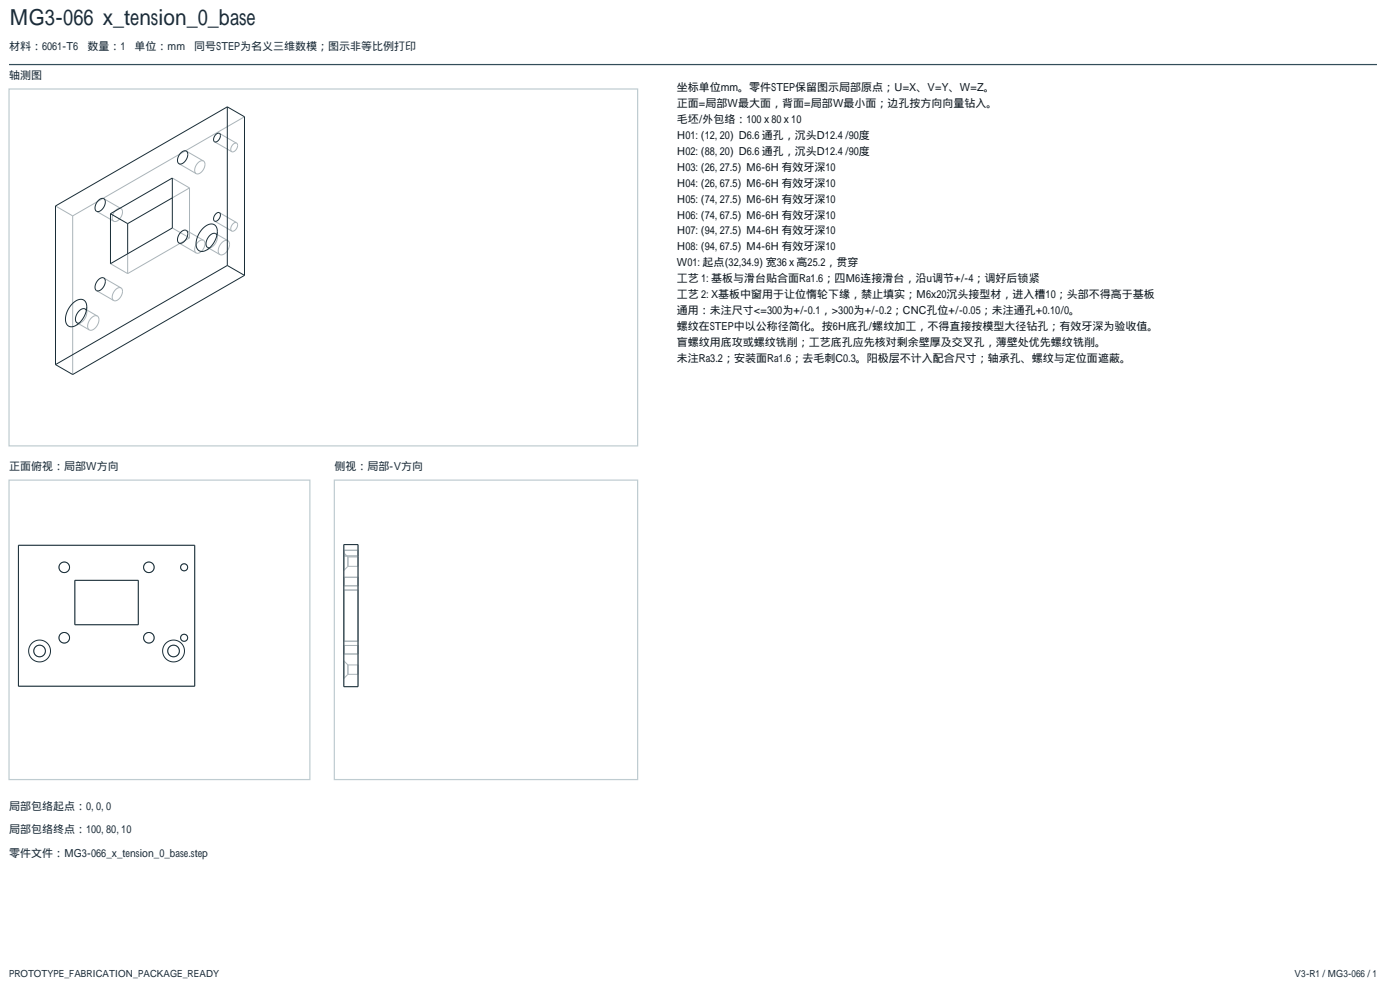
[picture p184: page 66]
轴测图; 正面俯视：局部W方向; 侧视：局部-V方向; 局部包络起点：0, 0, 0; 局部包络终点：100, 80, 10; 零件文件：MG3-066_x_tension_0_base.step

材料：6061-T6 数量：1 单位：mm 同号STEP为名义三维数模；图示非等比例打印

坐标单位mm。零件STEP保留图示局部原点；U=X、V=Y、W=Z。
正面=局部W最大面，背面=局部W最小面；边孔按方向向量钻入。
毛坯/外包络：100 x 80 x 10
H01: (12, 20) D6.6 通孔，沉头D12.4 /90度
H02: (88, 20) D6.6 通孔，沉头D12.4 /90度
H03: (26, 27.5) M6-6H 有效牙深10
H04: (26, 67.5) M6-6H 有效牙深10
H05: (74, 27.5) M6-6H 有效牙深10
H06: (74, 67.5) M6-6H 有效牙深10
H07: (94, 27.5) M4-6H 有效牙深10
H08: (94, 67.5) M4-6H 有效牙深10
工艺 1: 基板与滑台贴合面Ra1.6；四M6连接滑台，沿u调节+/-4；调好后锁紧
工艺 2: X基板中窗用于让位惰轮下缘，禁止填实；M6x20沉头接型材，进入槽10；头部不得高于基板
通用：未注尺寸<=300为+/-0.1，>300为+/-0.2；CNC孔位+/-0.05；未注通孔+0.10/0。
螺纹在STEP中以公称径简化。按6H底孔/螺纹加工，不得直接按模型大径钻孔；有效牙深为验收值。
盲螺纹用底攻或螺纹铣削；工艺底孔应先核对剩余壁厚及交叉孔，薄壁处优先螺纹铣削。
未注Ra3.2；安装面Ra1.6；去毛刺C0.3。阳极层不计入配合尺寸；轴承孔、螺纹与定位面遮蔽。

# MG3-067 x_tension_0_fork

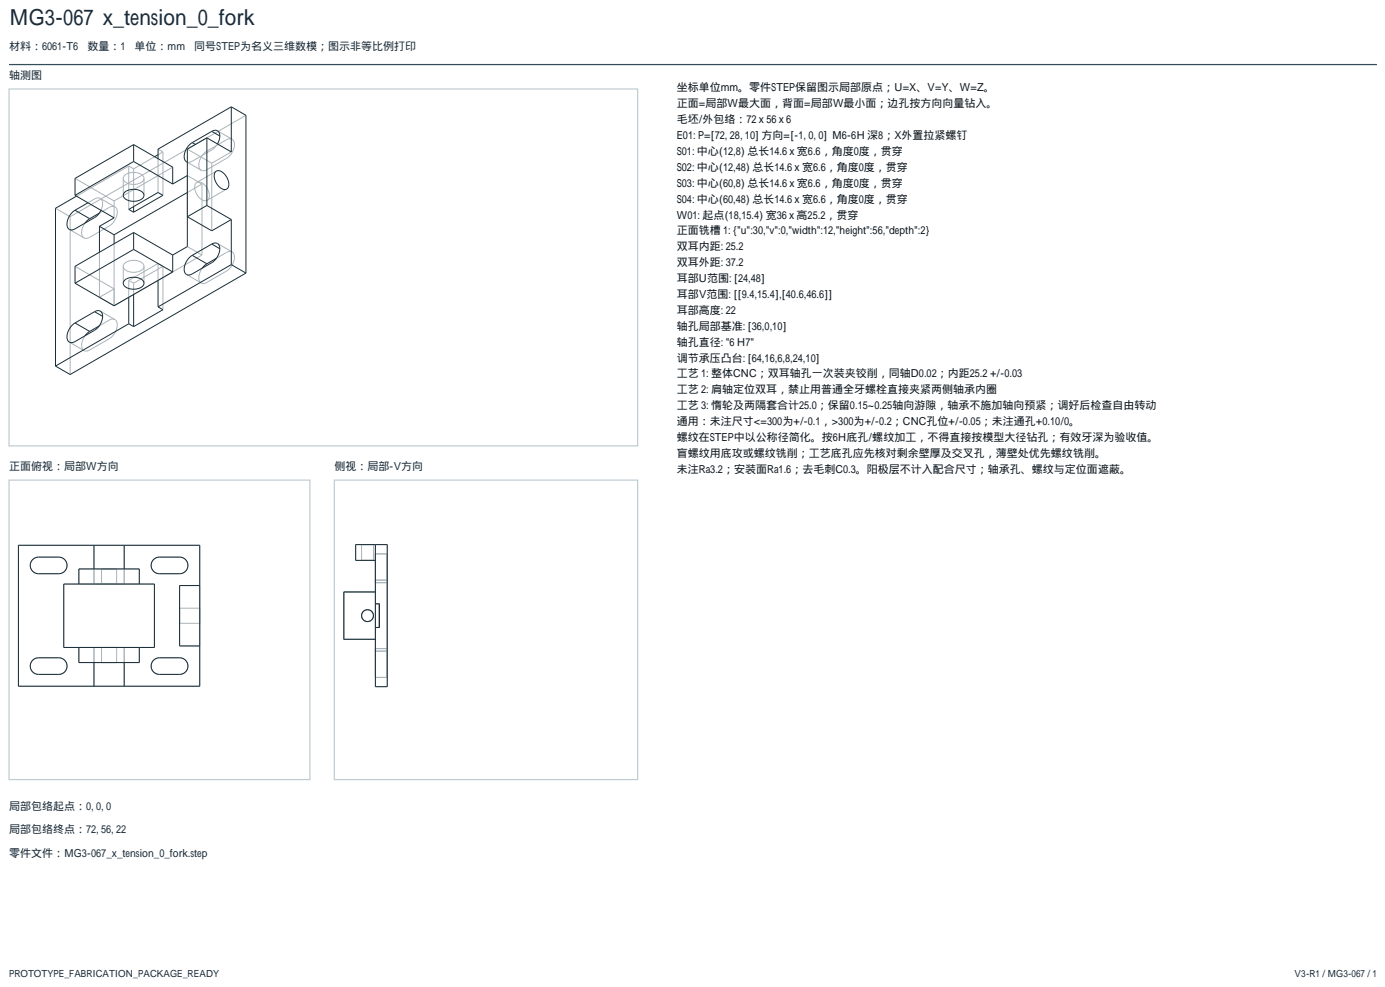
[picture p185: page 67]
轴测图; 正面俯视：局部W方向; 侧视：局部-V方向; 局部包络起点：0, 0, 0; 局部包络终点：72, 56, 22; 零件文件：MG3-067_x_tension_0_fork.step

材料：6061-T6 数量：1 单位：mm 同号STEP为名义三维数模；图示非等比例打印

坐标单位mm。零件STEP保留图示局部原点；U=X、V=Y、W=Z。
正面=局部W最大面，背面=局部W最小面；边孔按方向向量钻入。
毛坯/外包络：72 x 56 x 6
E01: P=[72, 28, 10] 方向=[-1, 0, 0] M6-6H 深8；X外置拉紧螺钉
正面铣槽 1: {"u":30,"v":0,"width":12,"height":56,"depth":2}
双耳内距: 25.2
双耳外距: 37.2
耳部U范围: [24,48]
耳部V范围: [[9.4,15.4],[40.6,46.6]]
耳部高度: 22
轴孔局部基准: [36,0,10]
轴孔直径: "6 H7"
调节承压凸台: [64,16,6,8,24,10]
工艺 1: 整体CNC；双耳轴孔一次装夹铰削，同轴D0.02；内距25.2 +/-0.03
工艺 2: 肩轴定位双耳，禁止用普通全牙螺栓直接夹紧两侧轴承内圈
工艺 3: 惰轮及两隔套合计25.0；保留0.15~0.25轴向游隙，轴承不施加轴向预紧；调好后检查自由转动
通用：未注尺寸<=300为+/-0.1，>300为+/-0.2；CNC孔位+/-0.05；未注通孔+0.10/0。
螺纹在STEP中以公称径简化。按6H底孔/螺纹加工，不得直接按模型大径钻孔；有效牙深为验收值。
盲螺纹用底攻或螺纹铣削；工艺底孔应先核对剩余壁厚及交叉孔，薄壁处优先螺纹铣削。
未注Ra3.2；安装面Ra1.6；去毛刺C0.3。阳极层不计入配合尺寸；轴承孔、螺纹与定位面遮蔽。

# MG3-068 x_tension_0_spacer_0

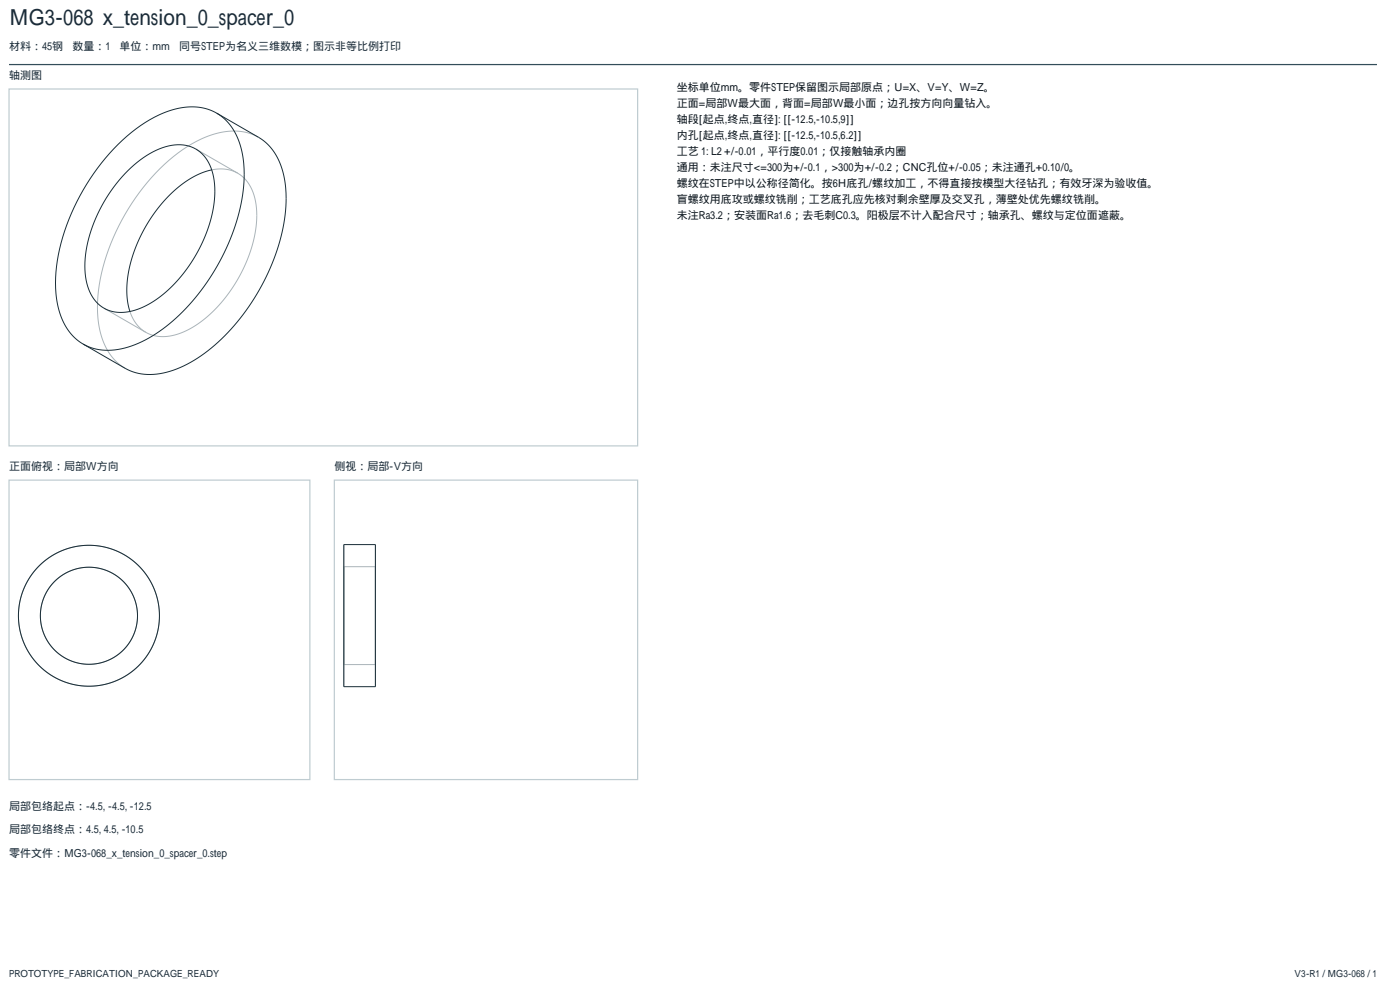
[picture p186: page 68]
轴测图; 正面俯视：局部W方向; 侧视：局部-V方向; 局部包络起点：-4.5, -4.5, -12.5; 局部包络终点：4.5, 4.5, -10.5; 零件文件：MG3-068_x_tension_0_spacer_0.step

材料：45钢 数量：1 单位：mm 同号STEP为名义三维数模；图示非等比例打印

坐标单位mm。零件STEP保留图示局部原点；U=X、V=Y、W=Z。
正面=局部W最大面，背面=局部W最小面；边孔按方向向量钻入。
工艺 1: L2 +/-0.01，平行度0.01；仅接触轴承内圈
通用：未注尺寸<=300为+/-0.1，>300为+/-0.2；CNC孔位+/-0.05；未注通孔+0.10/0。
螺纹在STEP中以公称径简化。按6H底孔/螺纹加工，不得直接按模型大径钻孔；有效牙深为验收值。
盲螺纹用底攻或螺纹铣削；工艺底孔应先核对剩余壁厚及交叉孔，薄壁处优先螺纹铣削。
未注Ra3.2；安装面Ra1.6；去毛刺C0.3。阳极层不计入配合尺寸；轴承孔、螺纹与定位面遮蔽。

# MG3-069 x_tension_0_spacer_1

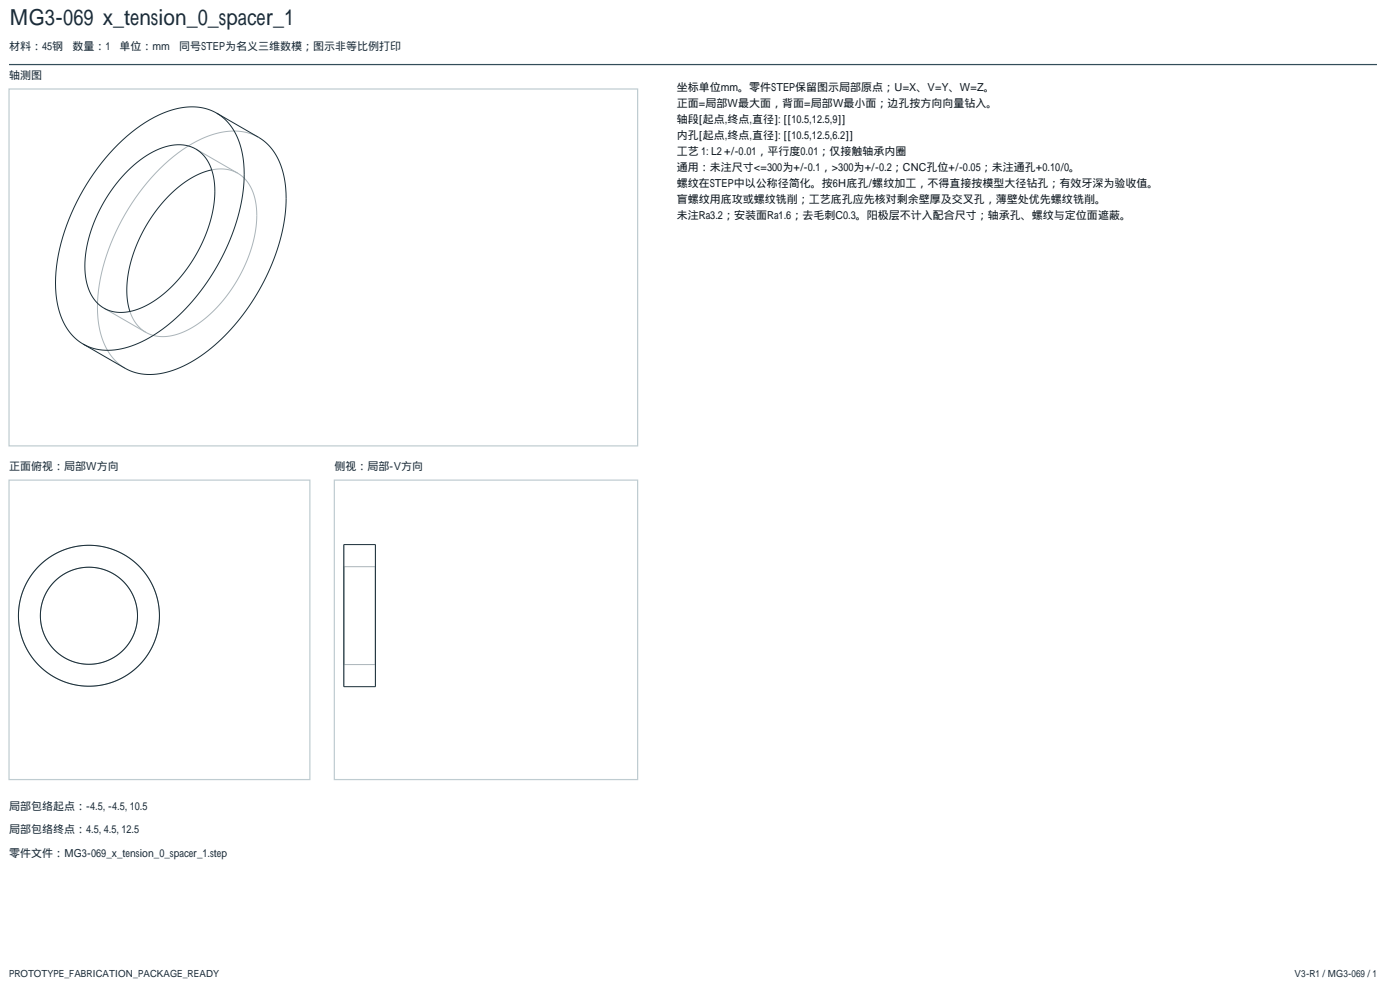
[picture p187: page 69]
轴测图; 正面俯视：局部W方向; 侧视：局部-V方向; 局部包络起点：-4.5, -4.5, 10.5; 局部包络终点：4.5, 4.5, 12.5; 零件文件：MG3-069_x_tension_0_spacer_1.step

材料：45钢 数量：1 单位：mm 同号STEP为名义三维数模；图示非等比例打印

坐标单位mm。零件STEP保留图示局部原点；U=X、V=Y、W=Z。
正面=局部W最大面，背面=局部W最小面；边孔按方向向量钻入。
工艺 1: L2 +/-0.01，平行度0.01；仅接触轴承内圈
通用：未注尺寸<=300为+/-0.1，>300为+/-0.2；CNC孔位+/-0.05；未注通孔+0.10/0。
螺纹在STEP中以公称径简化。按6H底孔/螺纹加工，不得直接按模型大径钻孔；有效牙深为验收值。
盲螺纹用底攻或螺纹铣削；工艺底孔应先核对剩余壁厚及交叉孔，薄壁处优先螺纹铣削。
未注Ra3.2；安装面Ra1.6；去毛刺C0.3。阳极层不计入配合尺寸；轴承孔、螺纹与定位面遮蔽。

# MG3-070 x_z_carrier

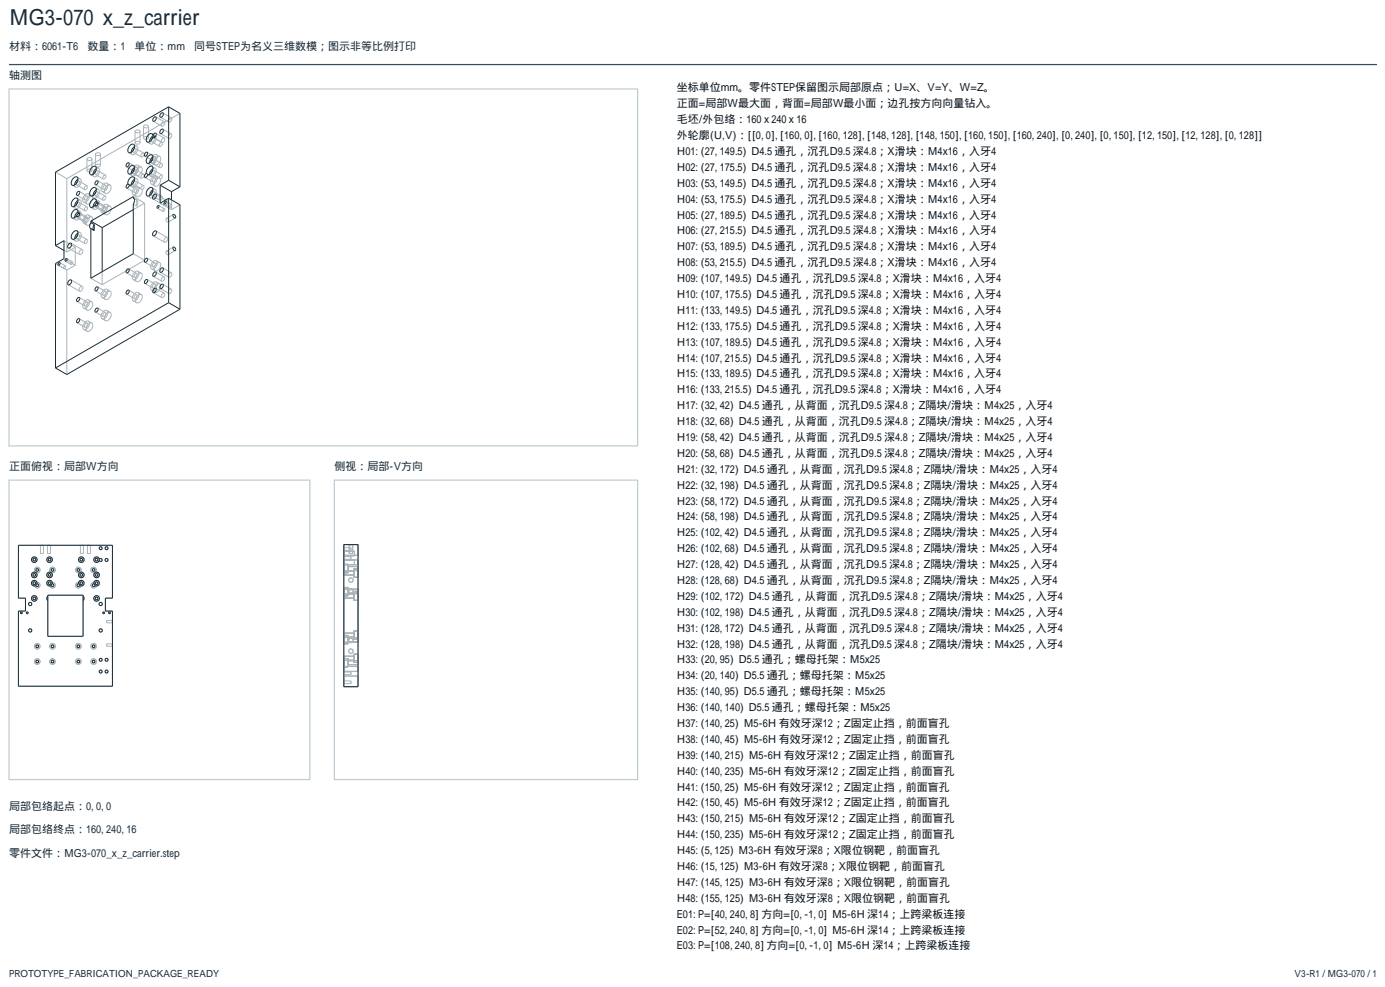
[picture p188: page 70]
轴测图; 正面俯视：局部W方向; 侧视：局部-V方向; 局部包络起点：0, 0, 0; 局部包络终点：160, 240, 16; 零件文件：MG3-070_x_z_carrier.step

材料：6061-T6 数量：1 单位：mm 同号STEP为名义三维数模；图示非等比例打印

坐标单位mm。零件STEP保留图示局部原点；U=X、V=Y、W=Z。
正面=局部W最大面，背面=局部W最小面；边孔按方向向量钻入。
毛坯/外包络：160 x 240 x 16
外轮廓(U,V)：[[0, 0], [160, 0], [160, 128], [148, 128], [148, 150], [160, 150], [160, 240], [0, 240], [0, 150], [12, 150], [12, 128], [0, 128]]
H01: (27, 149.5) D4.5 通孔，沉孔D9.5 深4.8；X滑块：M4x16，入牙4
H02: (27, 175.5) D4.5 通孔，沉孔D9.5 深4.8；X滑块：M4x16，入牙4
H03: (53, 149.5) D4.5 通孔，沉孔D9.5 深4.8；X滑块：M4x16，入牙4
H04: (53, 175.5) D4.5 通孔，沉孔D9.5 深4.8；X滑块：M4x16，入牙4
H05: (27, 189.5) D4.5 通孔，沉孔D9.5 深4.8；X滑块：M4x16，入牙4
H06: (27, 215.5) D4.5 通孔，沉孔D9.5 深4.8；X滑块：M4x16，入牙4
H07: (53, 189.5) D4.5 通孔，沉孔D9.5 深4.8；X滑块：M4x16，入牙4
H08: (53, 215.5) D4.5 通孔，沉孔D9.5 深4.8；X滑块：M4x16，入牙4
H09: (107, 149.5) D4.5 通孔，沉孔D9.5 深4.8；X滑块：M4x16，入牙4
H10: (107, 175.5) D4.5 通孔，沉孔D9.5 深4.8；X滑块：M4x16，入牙4
H11: (133, 149.5) D4.5 通孔，沉孔D9.5 深4.8；X滑块：M4x16，入牙4
H12: (133, 175.5) D4.5 通孔，沉孔D9.5 深4.8；X滑块：M4x16，入牙4
H13: (107, 189.5) D4.5 通孔，沉孔D9.5 深4.8；X滑块：M4x16，入牙4
H14: (107, 215.5) D4.5 通孔，沉孔D9.5 深4.8；X滑块：M4x16，入牙4
H15: (133, 189.5) D4.5 通孔，沉孔D9.5 深4.8；X滑块：M4x16，入牙4
H16: (133, 215.5) D4.5 通孔，沉孔D9.5 深4.8；X滑块：M4x16，入牙4
H17: (32, 42) D4.5 通孔，从背面，沉孔D9.5 深4.8；Z隔块/滑块：M4x25，入牙4
H18: (32, 68) D4.5 通孔，从背面，沉孔D9.5 深4.8；Z隔块/滑块：M4x25，入牙4
H19: (58, 42) D4.5 通孔，从背面，沉孔D9.5 深4.8；Z隔块/滑块：M4x25，入牙4
H20: (58, 68) D4.5 通孔，从背面，沉孔D9.5 深4.8；Z隔块/滑块：M4x25，入牙4
H21: (32, 172) D4.5 通孔，从背面，沉孔D9.5 深4.8；Z隔块/滑块：M4x25，入牙4
H22: (32, 198) D4.5 通孔，从背面，沉孔D9.5 深4.8；Z隔块/滑块：M4x25，入牙4
H23: (58, 172) D4.5 通孔，从背面，沉孔D9.5 深4.8；Z隔块/滑块：M4x25，入牙4
H24: (58, 198) D4.5 通孔，从背面，沉孔D9.5 深4.8；Z隔块/滑块：M4x25，入牙4
H25: (102, 42) D4.5 通孔，从背面，沉孔D9.5 深4.8；Z隔块/滑块：M4x25，入牙4
H26: (102, 68) D4.5 通孔，从背面，沉孔D9.5 深4.8；Z隔块/滑块：M4x25，入牙4
H27: (128, 42) D4.5 通孔，从背面，沉孔D9.5 深4.8；Z隔块/滑块：M4x25，入牙4
H28: (128, 68) D4.5 通孔，从背面，沉孔D9.5 深4.8；Z隔块/滑块：M4x25，入牙4
H29: (102, 172) D4.5 通孔，从背面，沉孔D9.5 深4.8；Z隔块/滑块：M4x25，入牙4
H30: (102, 198) D4.5 通孔，从背面，沉孔D9.5 深4.8；Z隔块/滑块：M4x25，入牙4
H31: (128, 172) D4.5 通孔，从背面，沉孔D9.5 深4.8；Z隔块/滑块：M4x25，入牙4
H32: (128, 198) D4.5 通孔，从背面，沉孔D9.5 深4.8；Z隔块/滑块：M4x25，入牙4
H33: (20, 95) D5.5 通孔；螺母托架：M5x25
H34: (20, 140) D5.5 通孔；螺母托架：M5x25
H35: (140, 95) D5.5 通孔；螺母托架：M5x25
H36: (140, 140) D5.5 通孔；螺母托架：M5x25
H37: (140, 25) M5-6H 有效牙深12；Z固定止挡，前面盲孔
H38: (140, 45) M5-6H 有效牙深12；Z固定止挡，前面盲孔
H39: (140, 215) M5-6H 有效牙深12；Z固定止挡，前面盲孔
H40: (140, 235) M5-6H 有效牙深12；Z固定止挡，前面盲孔
H41: (150, 25) M5-6H 有效牙深12；Z固定止挡，前面盲孔
H42: (150, 45) M5-6H 有效牙深12；Z固定止挡，前面盲孔
H43: (150, 215) M5-6H 有效牙深12；Z固定止挡，前面盲孔
H44: (150, 235) M5-6H 有效牙深12；Z固定止挡，前面盲孔
H45: (5, 125) M3-6H 有效牙深8；X限位钢靶，前面盲孔
H46: (15, 125) M3-6H 有效牙深8；X限位钢靶，前面盲孔
H47: (145, 125) M3-6H 有效牙深8；X限位钢靶，前面盲孔
H48: (155, 125) M3-6H 有效牙深8；X限位钢靶，前面盲孔
E01: P=[40, 240, 8] 方向=[0, -1, 0] M5-6H 深14；上跨梁板连接
E02: P=[52, 240, 8] 方向=[0, -1, 0] M5-6H 深14；上跨梁板连接
E03: P=[108, 240, 8] 方向=[0, -1, 0] M5-6H 深14；上跨梁板连接

# MG3-070 x_z_carrier

材料：6061-T6 数量：1 单位：mm 同号STEP为名义三维数模；图示非等比例打印

E04: P=[120, 240, 8] 方向=[0, -1, 0] M5-6H 深14；上跨梁板连接
E05: P=[160, 70, 8] 方向=[-1, 0, 0] M4-6H 深10；X线夹/拖链转接板预留
E06: P=[160, 110, 8] 方向=[-1, 0, 0] M4-6H 深10；X线夹/拖链转接板预留
W01: 起点(50,85) 宽60 x 高70，贯穿
工艺 1: A为背面；X滑块螺钉头从前面沉入，Z滑块螺钉头从背面沉入；先装X滑座再装Z机构 工艺 2: 两侧12x22缺口用于X越程与Y夹座相位调节避让；缺口内角R<=1，不得用R3代替 通用：未注尺寸<=300为+/-0.1，>300为+/-0.2；CNC孔位+/-0.05；未注通孔+0.10/0。 螺纹在STEP中以公称径简化。按6H底孔/螺纹加工，不得直接按模型大径钻孔；有效牙深为验收值。 盲螺纹用底攻或螺纹铣削；工艺底孔应先核对剩余壁厚及交叉孔，薄壁处优先螺纹铣削。 未注Ra3.2；安装面Ra1.6；去毛刺C0.3。阳极层不计入配合尺寸；轴承孔、螺纹与定位面遮蔽。

# MG3-071 y_clamp_0_-1_cap

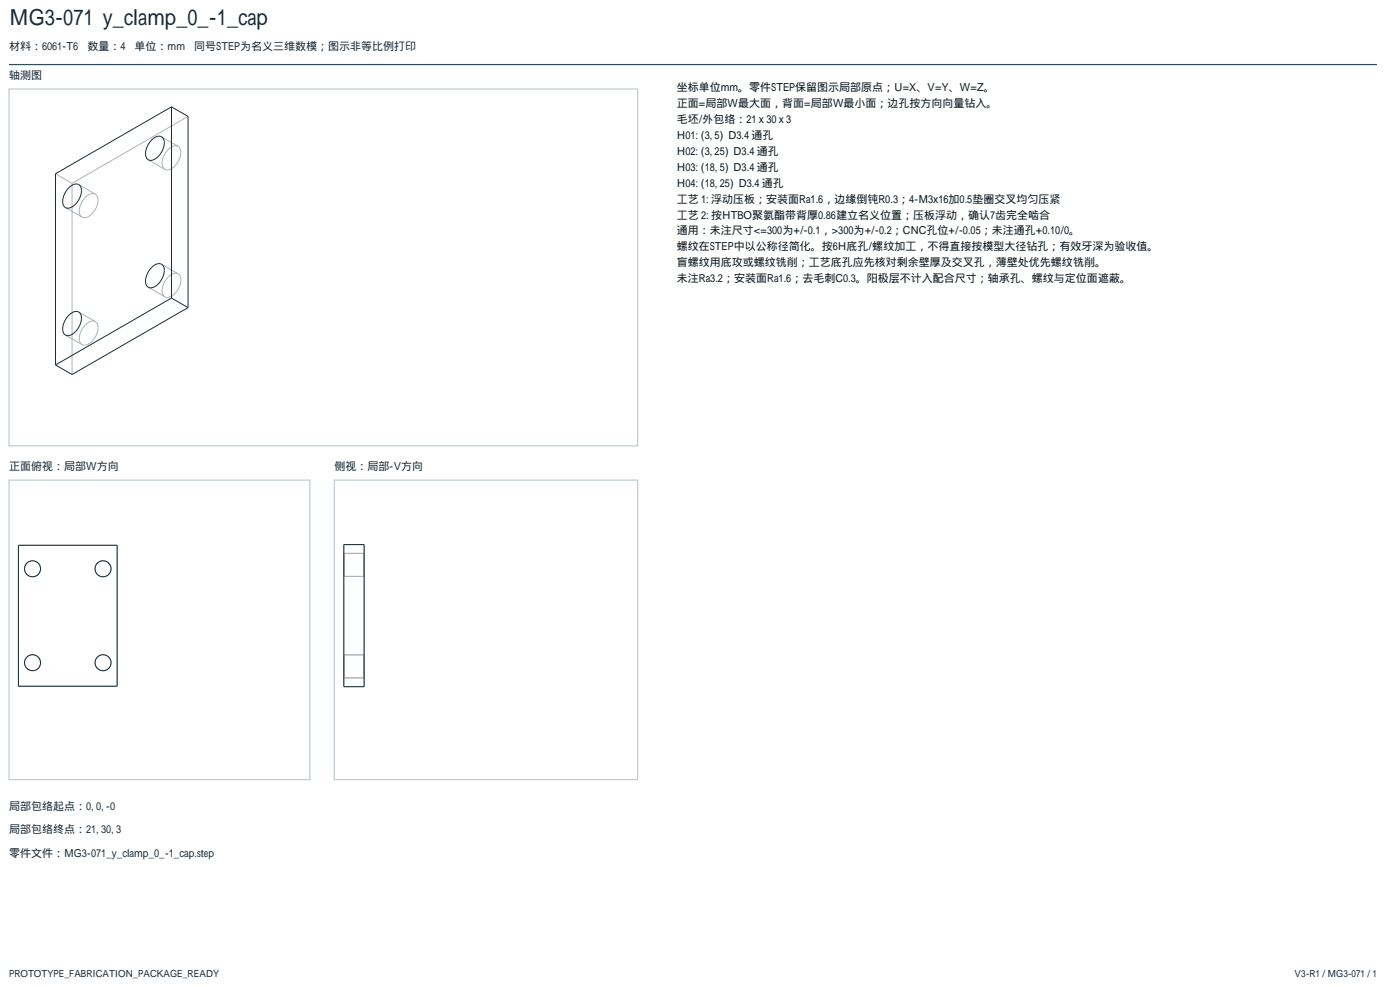
[picture p189: page 72]
轴测图; 正面俯视：局部W方向; 侧视：局部-V方向; 局部包络起点：0, 0, -0; 局部包络终点：21, 30, 3; 零件文件：MG3-071_y_clamp_0_-1_cap.step

材料：6061-T6 数量：4 单位：mm 同号STEP为名义三维数模；图示非等比例打印

坐标单位mm。零件STEP保留图示局部原点；U=X、V=Y、W=Z。
正面=局部W最大面，背面=局部W最小面；边孔按方向向量钻入。
毛坯/外包络：21 x 30 x 3
工艺 1: 浮动压板；安装面Ra1.6，边缘倒钝R0.3；4-M3x16加0.5垫圈交叉均匀压紧
工艺 2: 按HTBO聚氨酯带背厚0.86建立名义位置；压板浮动，确认7齿完全啮合
通用：未注尺寸<=300为+/-0.1，>300为+/-0.2；CNC孔位+/-0.05；未注通孔+0.10/0。
螺纹在STEP中以公称径简化。按6H底孔/螺纹加工，不得直接按模型大径钻孔；有效牙深为验收值。
盲螺纹用底攻或螺纹铣削；工艺底孔应先核对剩余壁厚及交叉孔，薄壁处优先螺纹铣削。
未注Ra3.2；安装面Ra1.6；去毛刺C0.3。阳极层不计入配合尺寸；轴承孔、螺纹与定位面遮蔽。

# MG3-072 y_clamp_0_-1_carrier

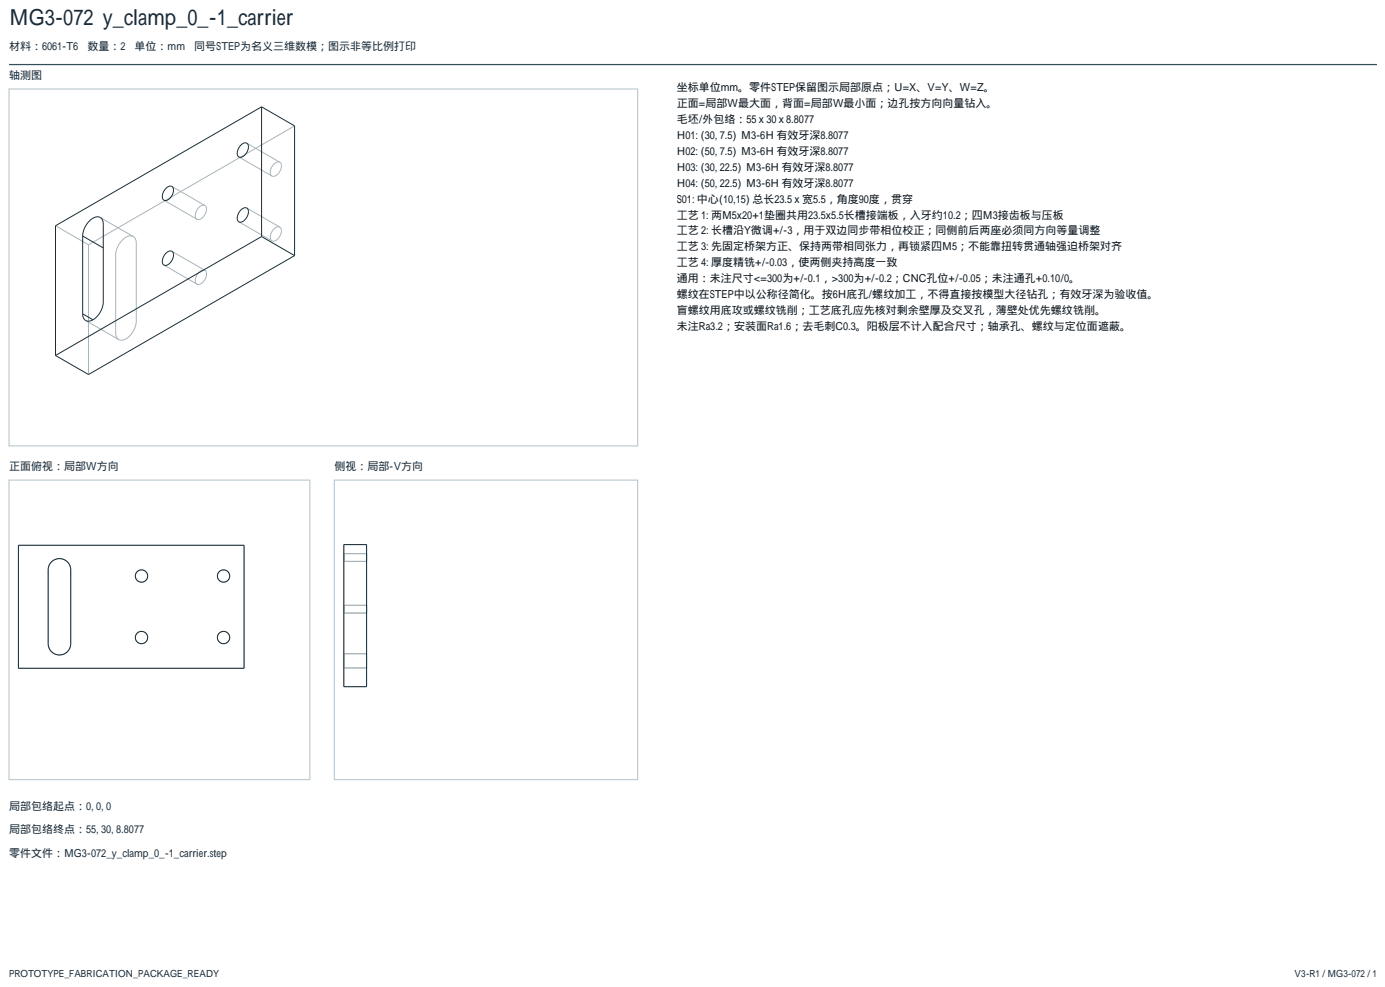
[picture p190: page 73]
轴测图; 正面俯视：局部W方向; 侧视：局部-V方向; 局部包络起点：0, 0, 0; 局部包络终点：55, 30, 8.8077; 零件文件：MG3-072_y_clamp_0_-1_carrier.step

材料：6061-T6 数量：2 单位：mm 同号STEP为名义三维数模；图示非等比例打印

坐标单位mm。零件STEP保留图示局部原点；U=X、V=Y、W=Z。
正面=局部W最大面，背面=局部W最小面；边孔按方向向量钻入。
毛坯/外包络：55 x 30 x 8.8077
H01: (30, 7.5) M3-6H 有效牙深8.8077
H02: (50, 7.5) M3-6H 有效牙深8.8077
H03: (30, 22.5) M3-6H 有效牙深8.8077
H04: (50, 22.5) M3-6H 有效牙深8.8077
工艺 1: 两M5x20+1垫圈共用23.5x5.5长槽接端板，入牙约10.2；四M3接齿板与压板
工艺 2: 长槽沿Y微调+/-3，用于双边同步带相位校正；同侧前后两座必须同方向等量调整
工艺 3: 先固定桥架方正、保持两带相同张力，再锁紧四M5；不能靠扭转贯通轴强迫桥架对齐
工艺 4: 厚度精铣+/-0.03，使两侧夹持高度一致
通用：未注尺寸<=300为+/-0.1，>300为+/-0.2；CNC孔位+/-0.05；未注通孔+0.10/0。
螺纹在STEP中以公称径简化。按6H底孔/螺纹加工，不得直接按模型大径钻孔；有效牙深为验收值。
盲螺纹用底攻或螺纹铣削；工艺底孔应先核对剩余壁厚及交叉孔，薄壁处优先螺纹铣削。
未注Ra3.2；安装面Ra1.6；去毛刺C0.3。阳极层不计入配合尺寸；轴承孔、螺纹与定位面遮蔽。

# MG3-073 y_clamp_1_-1_carrier

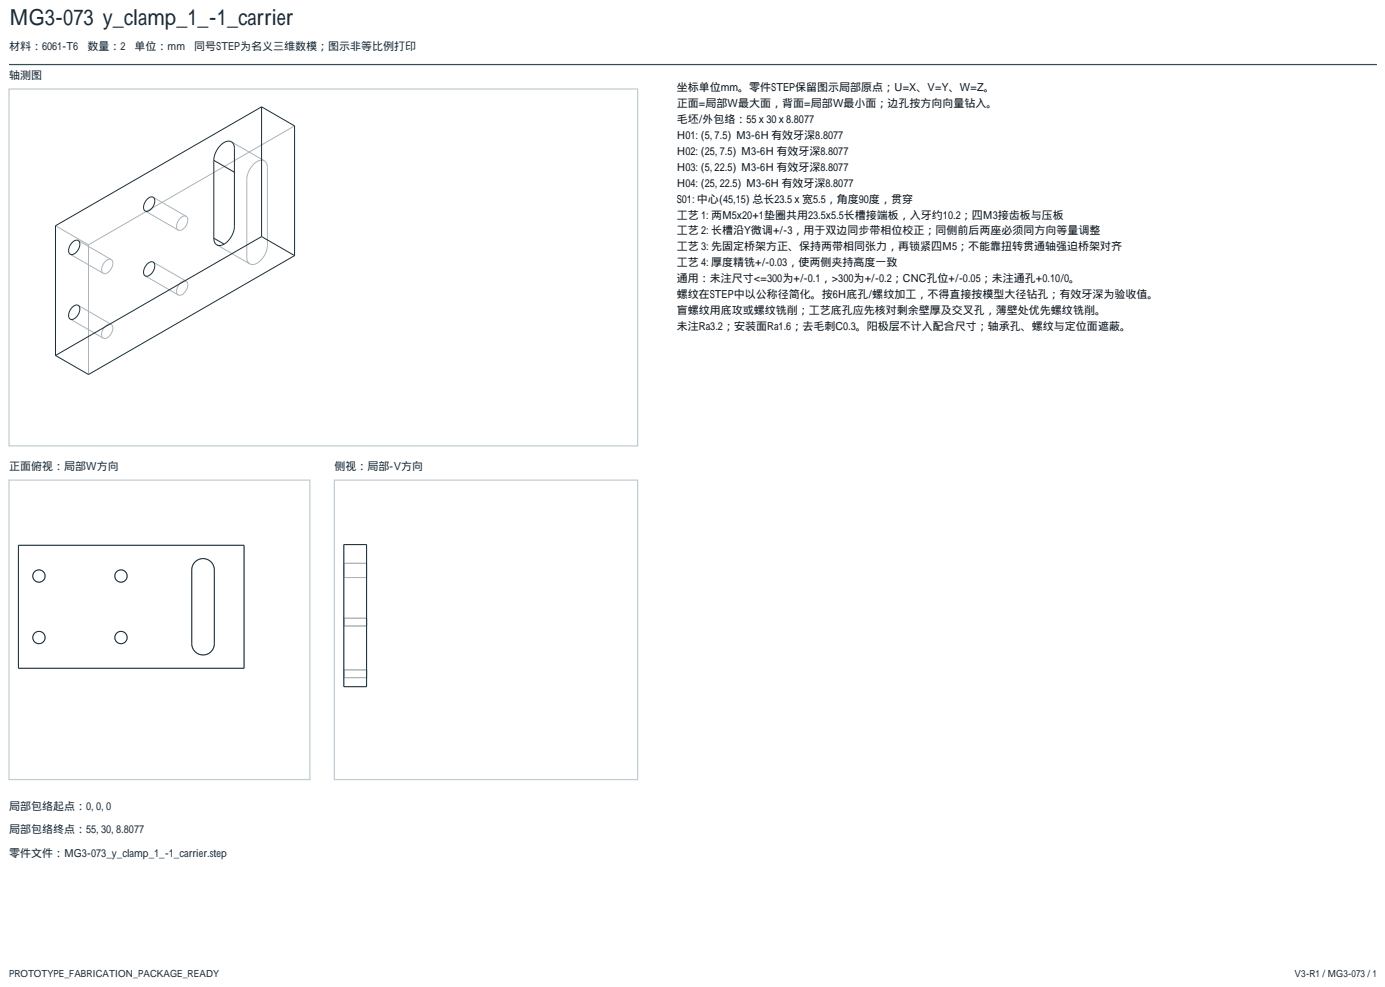
[picture p191: page 74]
轴测图; 正面俯视：局部W方向; 侧视：局部-V方向; 局部包络起点：0, 0, 0; 局部包络终点：55, 30, 8.8077; 零件文件：MG3-073_y_clamp_1_-1_carrier.step

材料：6061-T6 数量：2 单位：mm 同号STEP为名义三维数模；图示非等比例打印

坐标单位mm。零件STEP保留图示局部原点；U=X、V=Y、W=Z。
正面=局部W最大面，背面=局部W最小面；边孔按方向向量钻入。
毛坯/外包络：55 x 30 x 8.8077
H01: (5, 7.5) M3-6H 有效牙深8.8077
H02: (25, 7.5) M3-6H 有效牙深8.8077
H03: (5, 22.5) M3-6H 有效牙深8.8077
H04: (25, 22.5) M3-6H 有效牙深8.8077
工艺 1: 两M5x20+1垫圈共用23.5x5.5长槽接端板，入牙约10.2；四M3接齿板与压板
工艺 2: 长槽沿Y微调+/-3，用于双边同步带相位校正；同侧前后两座必须同方向等量调整
工艺 3: 先固定桥架方正、保持两带相同张力，再锁紧四M5；不能靠扭转贯通轴强迫桥架对齐
工艺 4: 厚度精铣+/-0.03，使两侧夹持高度一致
通用：未注尺寸<=300为+/-0.1，>300为+/-0.2；CNC孔位+/-0.05；未注通孔+0.10/0。
螺纹在STEP中以公称径简化。按6H底孔/螺纹加工，不得直接按模型大径钻孔；有效牙深为验收值。
盲螺纹用底攻或螺纹铣削；工艺底孔应先核对剩余壁厚及交叉孔，薄壁处优先螺纹铣削。
未注Ra3.2；安装面Ra1.6；去毛刺C0.3。阳极层不计入配合尺寸；轴承孔、螺纹与定位面遮蔽。

# MG3-074 y_end_plate_0

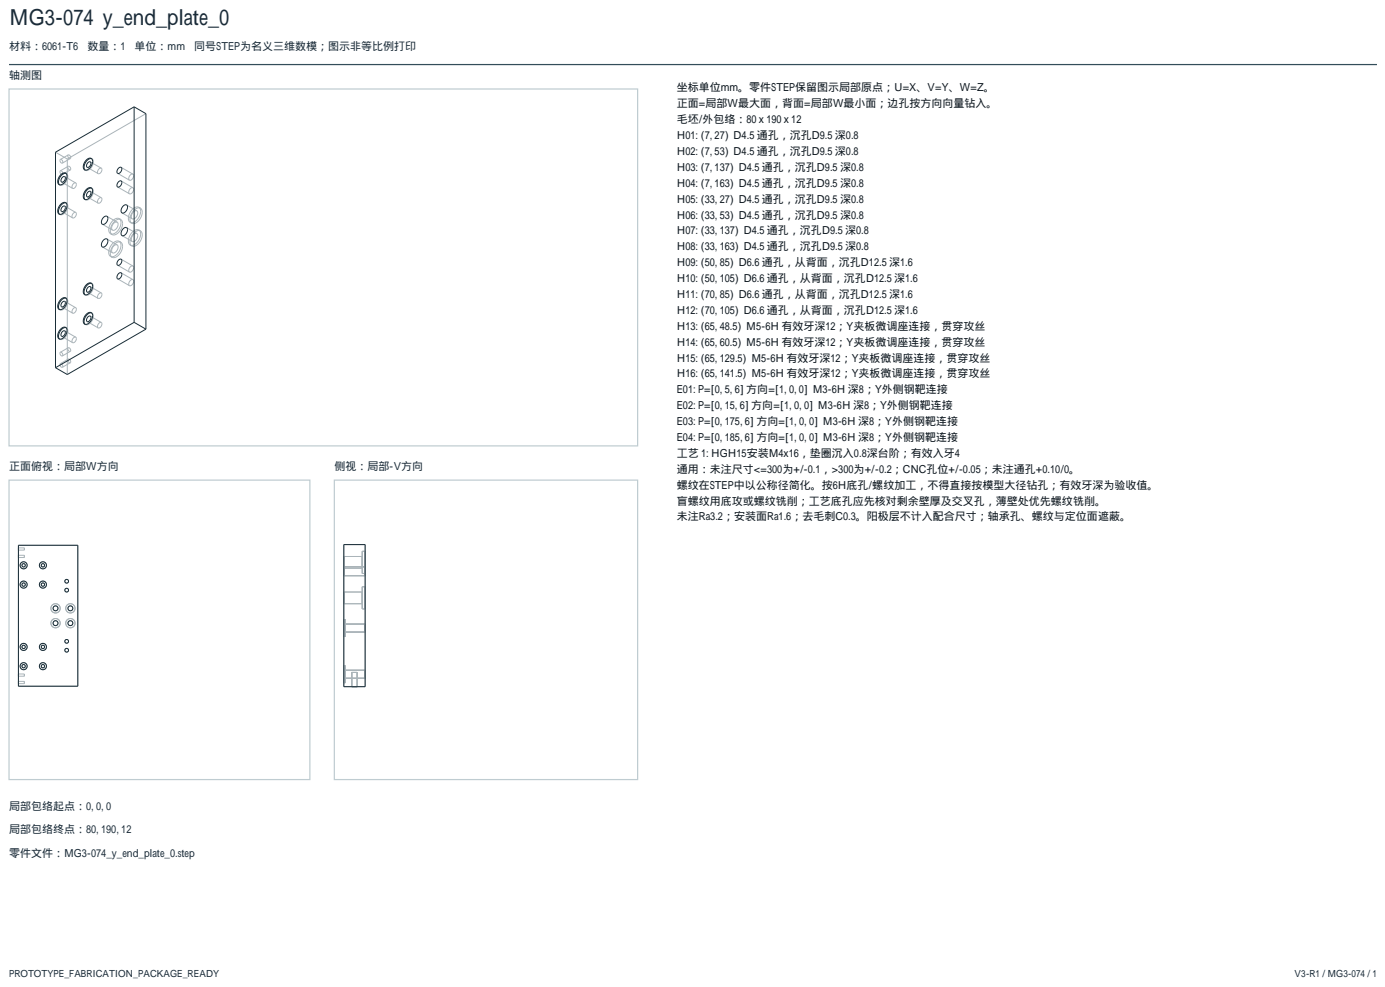
[picture p192: page 75]
轴测图; 正面俯视：局部W方向; 侧视：局部-V方向; 局部包络起点：0, 0, 0; 局部包络终点：80, 190, 12; 零件文件：MG3-074_y_end_plate_0.step

材料：6061-T6 数量：1 单位：mm 同号STEP为名义三维数模；图示非等比例打印

坐标单位mm。零件STEP保留图示局部原点；U=X、V=Y、W=Z。
正面=局部W最大面，背面=局部W最小面；边孔按方向向量钻入。
毛坯/外包络：80 x 190 x 12
H01: (7, 27) D4.5 通孔，沉孔D9.5 深0.8
H02: (7, 53) D4.5 通孔，沉孔D9.5 深0.8
H03: (7, 137) D4.5 通孔，沉孔D9.5 深0.8
H04: (7, 163) D4.5 通孔，沉孔D9.5 深0.8
H05: (33, 27) D4.5 通孔，沉孔D9.5 深0.8
H06: (33, 53) D4.5 通孔，沉孔D9.5 深0.8
H07: (33, 137) D4.5 通孔，沉孔D9.5 深0.8
H08: (33, 163) D4.5 通孔，沉孔D9.5 深0.8
H09: (50, 85) D6.6 通孔，从背面，沉孔D12.5 深1.6
H10: (50, 105) D6.6 通孔，从背面，沉孔D12.5 深1.6
H11: (70, 85) D6.6 通孔，从背面，沉孔D12.5 深1.6
H12: (70, 105) D6.6 通孔，从背面，沉孔D12.5 深1.6
H13: (65, 48.5) M5-6H 有效牙深12；Y夹板微调座连接，贯穿攻丝
H14: (65, 60.5) M5-6H 有效牙深12；Y夹板微调座连接，贯穿攻丝
H15: (65, 129.5) M5-6H 有效牙深12；Y夹板微调座连接，贯穿攻丝
H16: (65, 141.5) M5-6H 有效牙深12；Y夹板微调座连接，贯穿攻丝
E01: P=[0, 5, 6] 方向=[1, 0, 0] M3-6H 深8；Y外侧钢靶连接
E02: P=[0, 15, 6] 方向=[1, 0, 0] M3-6H 深8；Y外侧钢靶连接
E03: P=[0, 175, 6] 方向=[1, 0, 0] M3-6H 深8；Y外侧钢靶连接
E04: P=[0, 185, 6] 方向=[1, 0, 0] M3-6H 深8；Y外侧钢靶连接
工艺 1: HGH15安装M4x16，垫圈沉入0.8深台阶；有效入牙4
通用：未注尺寸<=300为+/-0.1，>300为+/-0.2；CNC孔位+/-0.05；未注通孔+0.10/0。
螺纹在STEP中以公称径简化。按6H底孔/螺纹加工，不得直接按模型大径钻孔；有效牙深为验收值。
盲螺纹用底攻或螺纹铣削；工艺底孔应先核对剩余壁厚及交叉孔，薄壁处优先螺纹铣削。
未注Ra3.2；安装面Ra1.6；去毛刺C0.3。阳极层不计入配合尺寸；轴承孔、螺纹与定位面遮蔽。

# MG3-075 y_end_plate_1

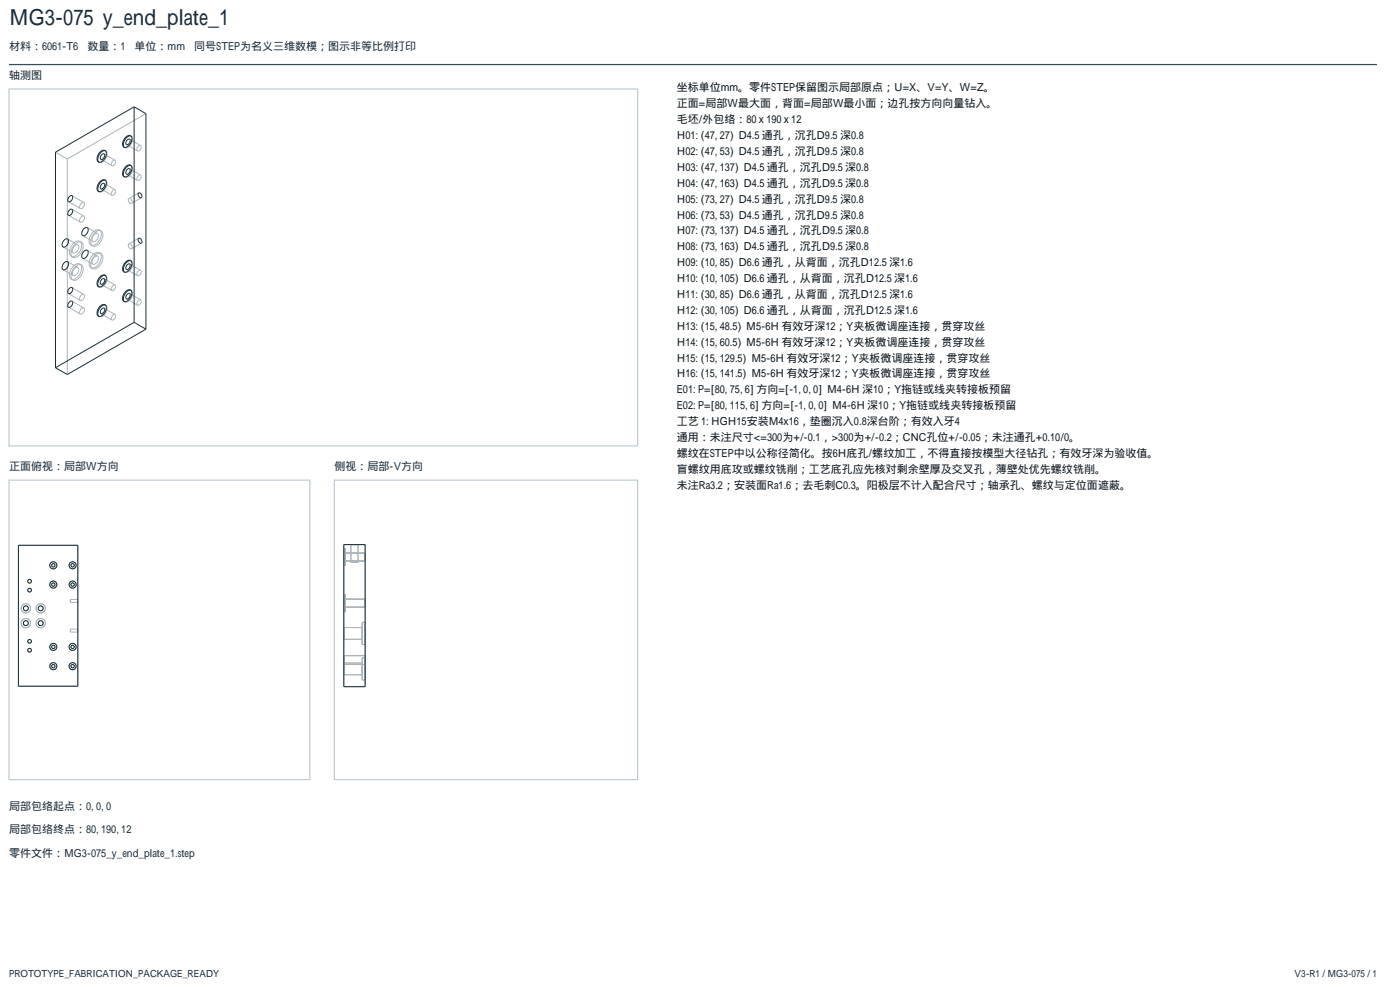
[picture p193: page 76]
轴测图; 正面俯视：局部W方向; 侧视：局部-V方向; 局部包络起点：0, 0, 0; 局部包络终点：80, 190, 12; 零件文件：MG3-075_y_end_plate_1.step

材料：6061-T6 数量：1 单位：mm 同号STEP为名义三维数模；图示非等比例打印

坐标单位mm。零件STEP保留图示局部原点；U=X、V=Y、W=Z。
正面=局部W最大面，背面=局部W最小面；边孔按方向向量钻入。
毛坯/外包络：80 x 190 x 12
H01: (47, 27) D4.5 通孔，沉孔D9.5 深0.8
H02: (47, 53) D4.5 通孔，沉孔D9.5 深0.8
H03: (47, 137) D4.5 通孔，沉孔D9.5 深0.8
H04: (47, 163) D4.5 通孔，沉孔D9.5 深0.8
H05: (73, 27) D4.5 通孔，沉孔D9.5 深0.8
H06: (73, 53) D4.5 通孔，沉孔D9.5 深0.8
H07: (73, 137) D4.5 通孔，沉孔D9.5 深0.8
H08: (73, 163) D4.5 通孔，沉孔D9.5 深0.8
H09: (10, 85) D6.6 通孔，从背面，沉孔D12.5 深1.6
H10: (10, 105) D6.6 通孔，从背面，沉孔D12.5 深1.6
H11: (30, 85) D6.6 通孔，从背面，沉孔D12.5 深1.6
H12: (30, 105) D6.6 通孔，从背面，沉孔D12.5 深1.6
H13: (15, 48.5) M5-6H 有效牙深12；Y夹板微调座连接，贯穿攻丝
H14: (15, 60.5) M5-6H 有效牙深12；Y夹板微调座连接，贯穿攻丝
H15: (15, 129.5) M5-6H 有效牙深12；Y夹板微调座连接，贯穿攻丝
H16: (15, 141.5) M5-6H 有效牙深12；Y夹板微调座连接，贯穿攻丝
E01: P=[80, 75, 6] 方向=[-1, 0, 0] M4-6H 深10；Y拖链或线夹转接板预留
E02: P=[80, 115, 6] 方向=[-1, 0, 0] M4-6H 深10；Y拖链或线夹转接板预留
工艺 1: HGH15安装M4x16，垫圈沉入0.8深台阶；有效入牙4
通用：未注尺寸<=300为+/-0.1，>300为+/-0.2；CNC孔位+/-0.05；未注通孔+0.10/0。
螺纹在STEP中以公称径简化。按6H底孔/螺纹加工，不得直接按模型大径钻孔；有效牙深为验收值。
盲螺纹用底攻或螺纹铣削；工艺底孔应先核对剩余壁厚及交叉孔，薄壁处优先螺纹铣削。
未注Ra3.2；安装面Ra1.6；去毛刺C0.3。阳极层不计入配合尺寸；轴承孔、螺纹与定位面遮蔽。

# MG3-076 y_motor_bracket

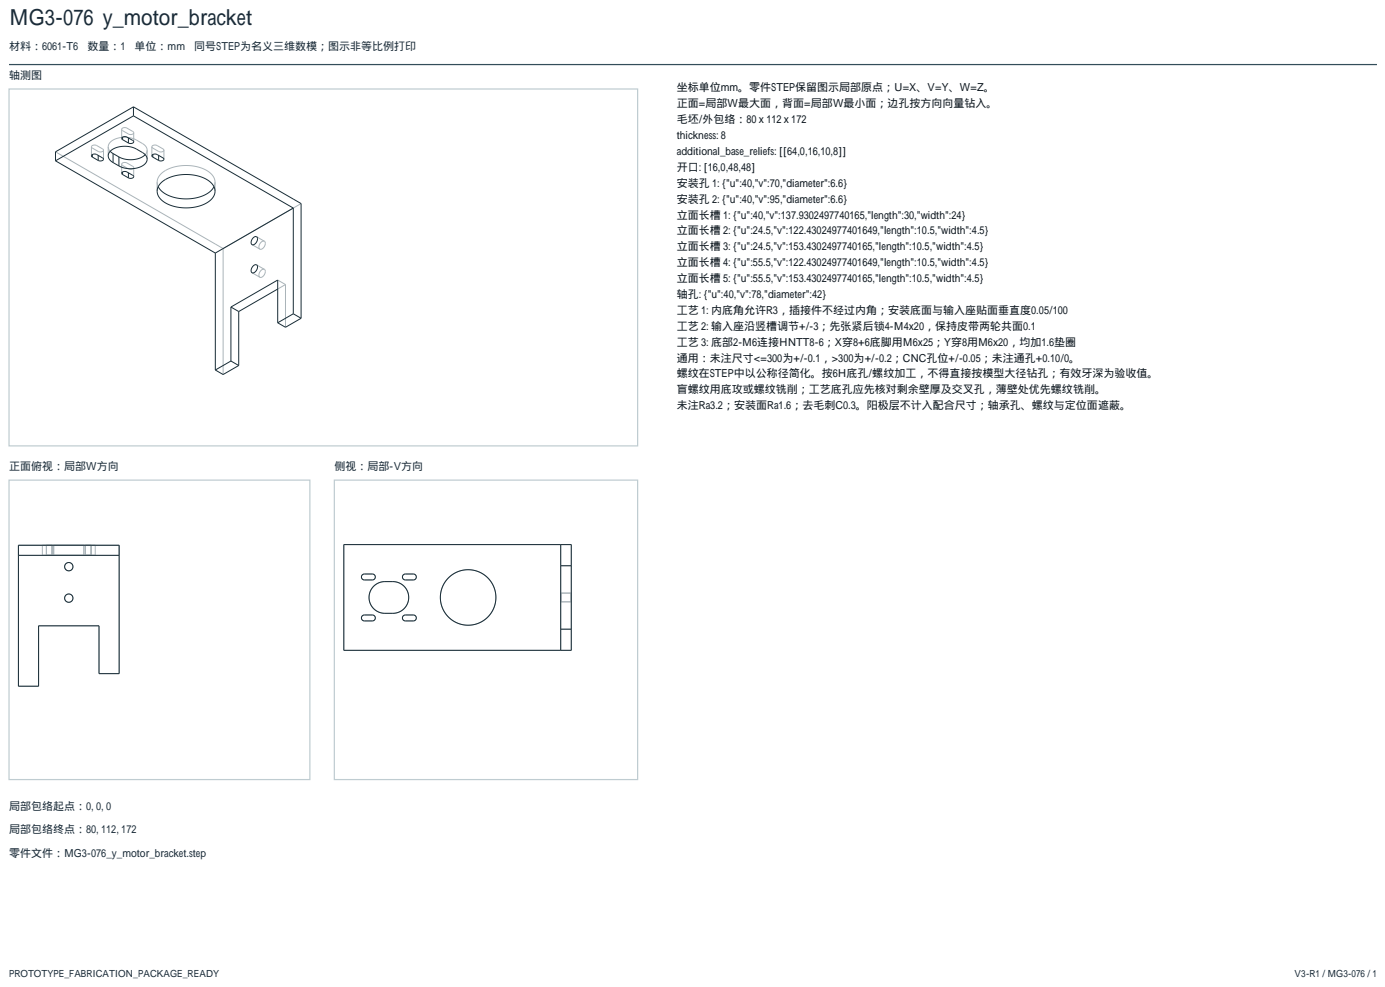
[picture p194: page 77]
轴测图; 正面俯视：局部W方向; 侧视：局部-V方向; 局部包络起点：0, 0, 0; 局部包络终点：80, 112, 172; 零件文件：MG3-076_y_motor_bracket.step

材料：6061-T6 数量：1 单位：mm 同号STEP为名义三维数模；图示非等比例打印

坐标单位mm。零件STEP保留图示局部原点；U=X、V=Y、W=Z。
正面=局部W最大面，背面=局部W最小面；边孔按方向向量钻入。
毛坯/外包络：80 x 112 x 172
thickness: 8
additional_base_reliefs: [[64,0,16,10,8]]
安装孔 1: {"u":40,"v":70,"diameter":6.6}
安装孔 2: {"u":40,"v":95,"diameter":6.6}
立面长槽 1: {"u":40,"v":137.9302497740165,"length":30,"width":24}
立面长槽 2: {"u":24.5,"v":122.43024977401649,"length":10.5,"width":4.5}
立面长槽 3: {"u":24.5,"v":153.4302497740165,"length":10.5,"width":4.5}
立面长槽 4: {"u":55.5,"v":122.43024977401649,"length":10.5,"width":4.5}
立面长槽 5: {"u":55.5,"v":153.4302497740165,"length":10.5,"width":4.5}
轴孔: {"u":40,"v":78,"diameter":42}
工艺 1: 内底角允许R3，插接件不经过内角；安装底面与输入座贴面垂直度0.05/100
工艺 2: 输入座沿竖槽调节+/-3；先张紧后锁4-M4x20，保持皮带两轮共面0.1
工艺 3: 底部2-M6连接HNTT8-6；X穿8+6底脚用M6x25；Y穿8用M6x20，均加1.6垫圈
通用：未注尺寸<=300为+/-0.1，>300为+/-0.2；CNC孔位+/-0.05；未注通孔+0.10/0。
螺纹在STEP中以公称径简化。按6H底孔/螺纹加工，不得直接按模型大径钻孔；有效牙深为验收值。
盲螺纹用底攻或螺纹铣削；工艺底孔应先核对剩余壁厚及交叉孔，薄壁处优先螺纹铣削。
未注Ra3.2；安装面Ra1.6；去毛刺C0.3。阳极层不计入配合尺寸；轴承孔、螺纹与定位面遮蔽。

# MG3-077 y_pulley_0_1

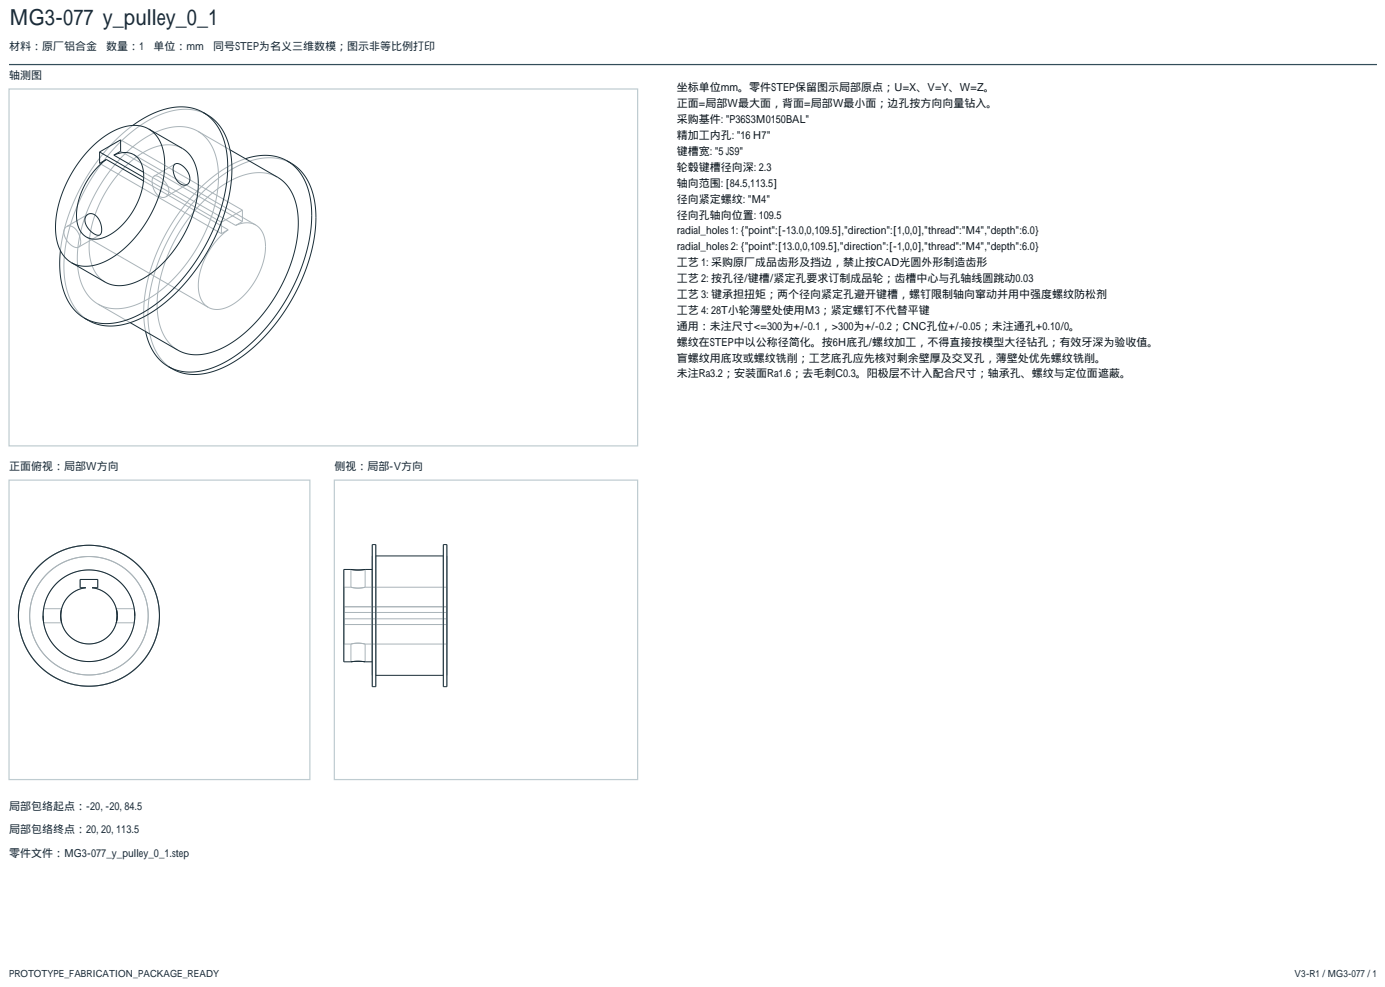
[picture p195: page 78]
轴测图; 正面俯视：局部W方向; 侧视：局部-V方向; 局部包络起点：-20, -20, 84.5; 局部包络终点：20, 20, 113.5; 零件文件：MG3-077_y_pulley_0_1.step

材料：原厂铝合金 数量：1 单位：mm 同号STEP为名义三维数模；图示非等比例打印

坐标单位mm。零件STEP保留图示局部原点；U=X、V=Y、W=Z。
正面=局部W最大面，背面=局部W最小面；边孔按方向向量钻入。
采购基件: "P36S3M0150BAL"
精加工内孔: "16 H7"
键槽宽: "5 JS9"
轮毂键槽径向深: 2.3
轴向范围: [84.5,113.5]
径向紧定螺纹: "M4"
径向孔轴向位置: 109.5
radial_holes 1: {"point":[-13.0,0,109.5],"direction":[1,0,0],"thread":"M4","depth":6.0}
radial_holes 2: {"point":[13.0,0,109.5],"direction":[-1,0,0],"thread":"M4","depth":6.0}
工艺 1: 采购原厂成品齿形及挡边，禁止按CAD光圆外形制造齿形
工艺 2: 按孔径/键槽/紧定孔要求订制成品轮；齿槽中心与孔轴线圆跳动0.03
工艺 3: 键承担扭矩；两个径向紧定孔避开键槽，螺钉限制轴向窜动并用中强度螺纹防松剂
工艺 4: 28T小轮薄壁处使用M3；紧定螺钉不代替平键
通用：未注尺寸<=300为+/-0.1，>300为+/-0.2；CNC孔位+/-0.05；未注通孔+0.10/0。
螺纹在STEP中以公称径简化。按6H底孔/螺纹加工，不得直接按模型大径钻孔；有效牙深为验收值。
盲螺纹用底攻或螺纹铣削；工艺底孔应先核对剩余壁厚及交叉孔，薄壁处优先螺纹铣削。
未注Ra3.2；安装面Ra1.6；去毛刺C0.3。阳极层不计入配合尺寸；轴承孔、螺纹与定位面遮蔽。

# MG3-078 y_pulley_1_1

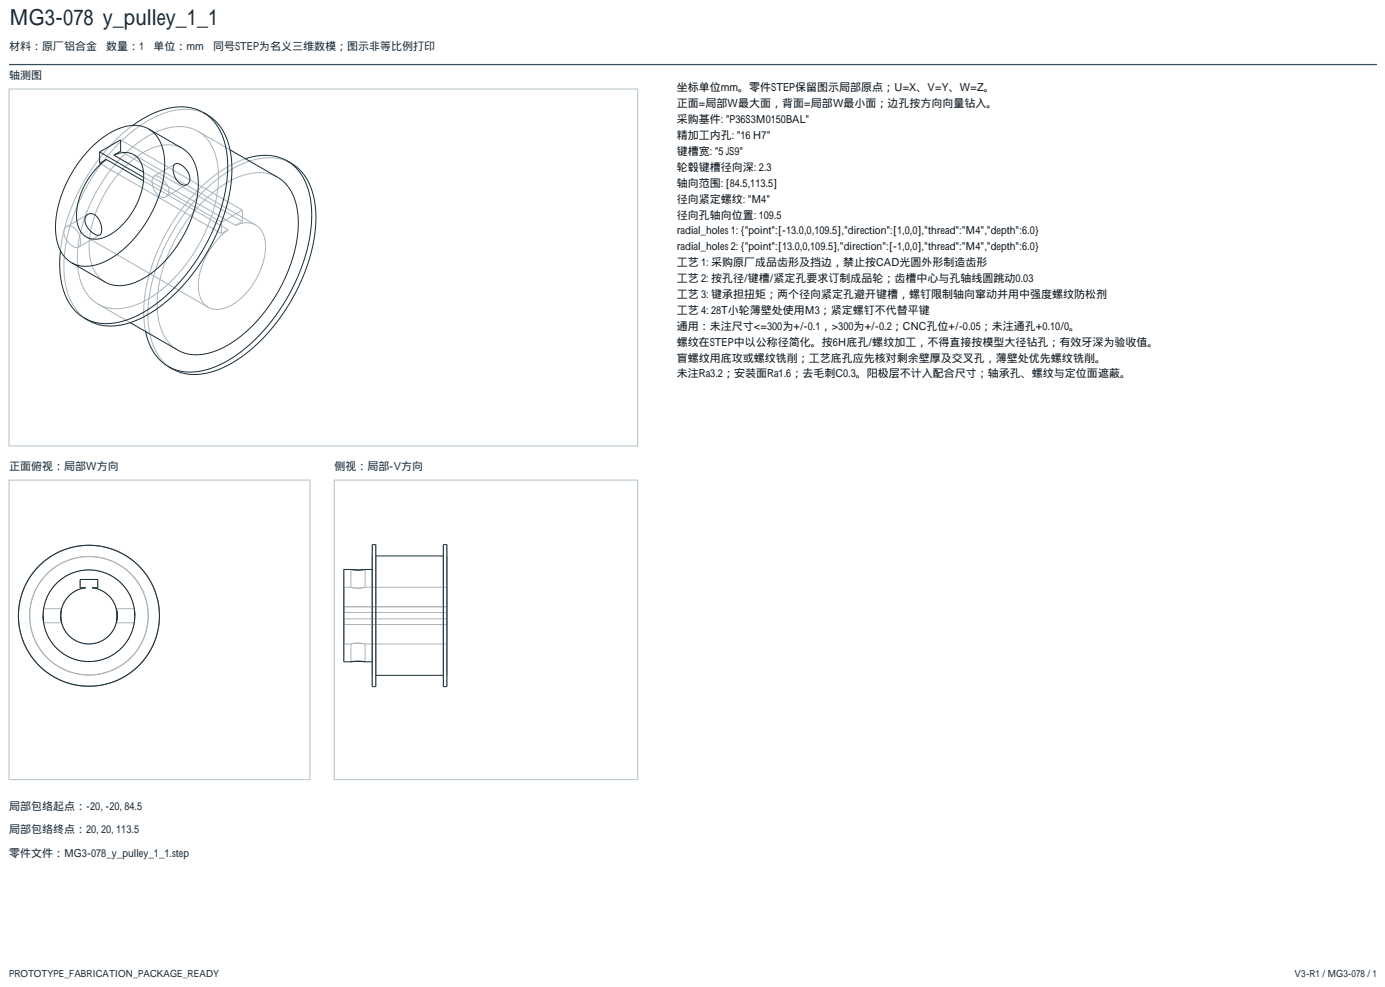
[picture p196: page 79]
轴测图; 正面俯视：局部W方向; 侧视：局部-V方向; 局部包络起点：-20, -20, 84.5; 局部包络终点：20, 20, 113.5; 零件文件：MG3-078_y_pulley_1_1.step

材料：原厂铝合金 数量：1 单位：mm 同号STEP为名义三维数模；图示非等比例打印

坐标单位mm。零件STEP保留图示局部原点；U=X、V=Y、W=Z。
正面=局部W最大面，背面=局部W最小面；边孔按方向向量钻入。
采购基件: "P36S3M0150BAL"
精加工内孔: "16 H7"
键槽宽: "5 JS9"
轮毂键槽径向深: 2.3
轴向范围: [84.5,113.5]
径向紧定螺纹: "M4"
径向孔轴向位置: 109.5
radial_holes 1: {"point":[-13.0,0,109.5],"direction":[1,0,0],"thread":"M4","depth":6.0}
radial_holes 2: {"point":[13.0,0,109.5],"direction":[-1,0,0],"thread":"M4","depth":6.0}
工艺 1: 采购原厂成品齿形及挡边，禁止按CAD光圆外形制造齿形
工艺 2: 按孔径/键槽/紧定孔要求订制成品轮；齿槽中心与孔轴线圆跳动0.03
工艺 3: 键承担扭矩；两个径向紧定孔避开键槽，螺钉限制轴向窜动并用中强度螺纹防松剂
工艺 4: 28T小轮薄壁处使用M3；紧定螺钉不代替平键
通用：未注尺寸<=300为+/-0.1，>300为+/-0.2；CNC孔位+/-0.05；未注通孔+0.10/0。
螺纹在STEP中以公称径简化。按6H底孔/螺纹加工，不得直接按模型大径钻孔；有效牙深为验收值。
盲螺纹用底攻或螺纹铣削；工艺底孔应先核对剩余壁厚及交叉孔，薄壁处优先螺纹铣削。
未注Ra3.2；安装面Ra1.6；去毛刺C0.3。阳极层不计入配合尺寸；轴承孔、螺纹与定位面遮蔽。

# MG3-079 y_rail_base_0

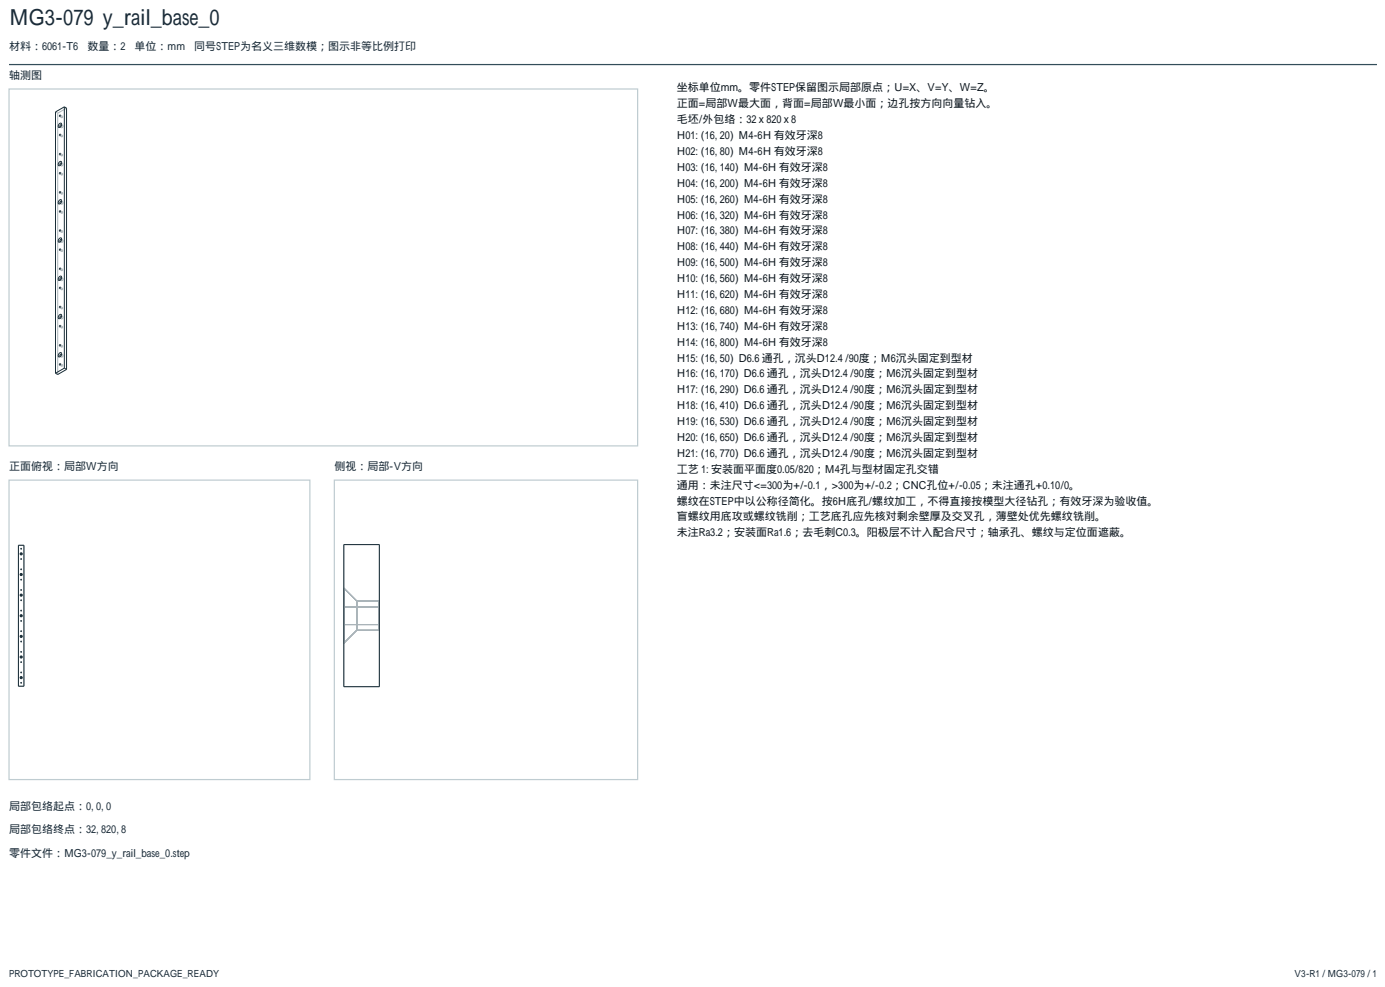
[picture p197: page 80]
轴测图; 正面俯视：局部W方向; 侧视：局部-V方向; 局部包络起点：0, 0, 0; 局部包络终点：32, 820, 8; 零件文件：MG3-079_y_rail_base_0.step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

材料：6061-T6 数量：2 单位：mm 同号STEP为名义三维数模；图示非等比例打印

# MG3-080 y_rear_cover_0

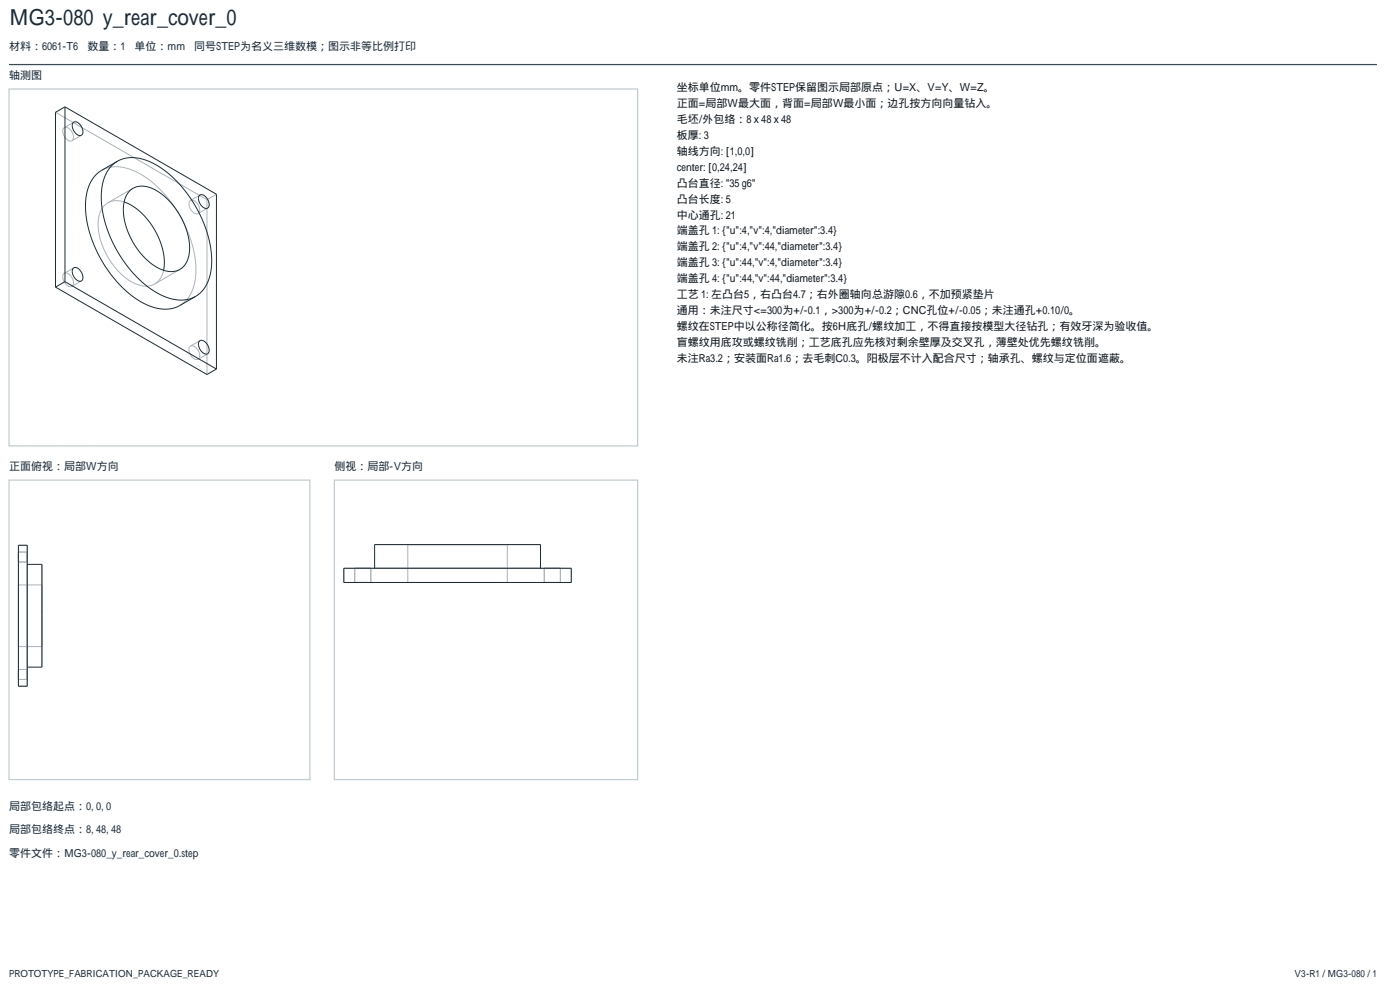
[picture p198: page 81]
轴测图; 正面俯视：局部W方向; 侧视：局部-V方向; 局部包络起点：0, 0, 0; 局部包络终点：8, 48, 48; 零件文件：MG3-080_y_rear_cover_0.step

材料：6061-T6 数量：1 单位：mm 同号STEP为名义三维数模；图示非等比例打印

坐标单位mm。零件STEP保留图示局部原点；U=X、V=Y、W=Z。
正面=局部W最大面，背面=局部W最小面；边孔按方向向量钻入。
毛坯/外包络：8 x 48 x 48
轴线方向: [1,0,0]
center: [0,24,24]
凸台直径: "35 g6"
凸台长度: 5
中心通孔: 21
端盖孔 1: {"u":4,"v":4,"diameter":3.4}
端盖孔 2: {"u":4,"v":44,"diameter":3.4}
端盖孔 3: {"u":44,"v":4,"diameter":3.4}
端盖孔 4: {"u":44,"v":44,"diameter":3.4}
工艺 1: 左凸台5，右凸台4.7；右外圈轴向总游隙0.6，不加预紧垫片
通用：未注尺寸<=300为+/-0.1，>300为+/-0.2；CNC孔位+/-0.05；未注通孔+0.10/0。
螺纹在STEP中以公称径简化。按6H底孔/螺纹加工，不得直接按模型大径钻孔；有效牙深为验收值。
盲螺纹用底攻或螺纹铣削；工艺底孔应先核对剩余壁厚及交叉孔，薄壁处优先螺纹铣削。
未注Ra3.2；安装面Ra1.6；去毛刺C0.3。阳极层不计入配合尺寸；轴承孔、螺纹与定位面遮蔽。

# MG3-081 y_rear_cover_1

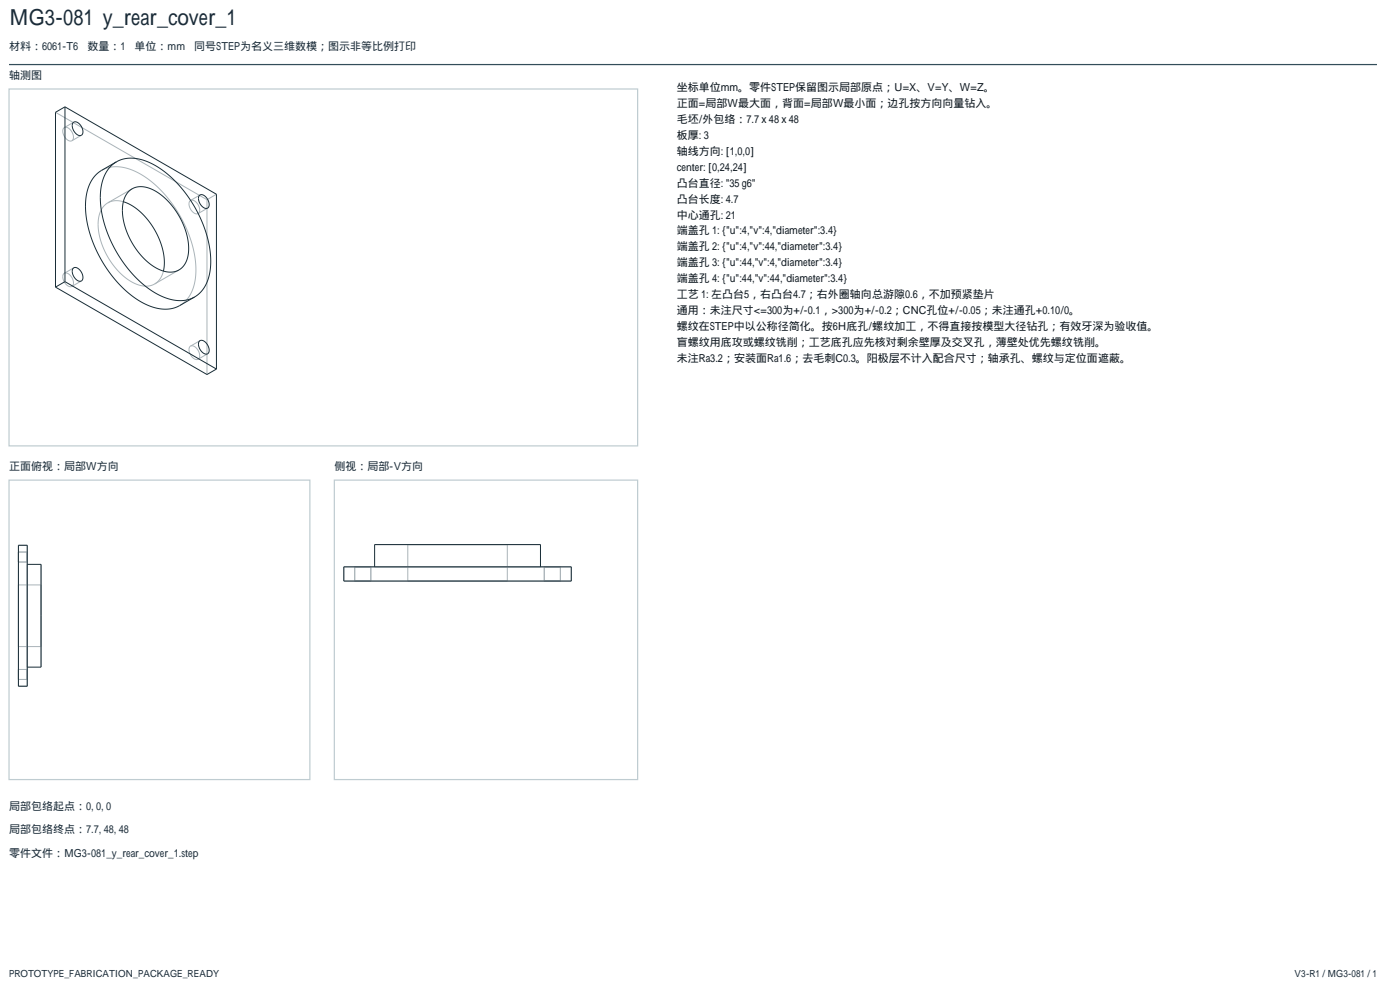
[picture p199: page 82]
轴测图; 正面俯视：局部W方向; 侧视：局部-V方向; 局部包络起点：0, 0, 0; 局部包络终点：7.7, 48, 48; 零件文件：MG3-081_y_rear_cover_1.step

材料：6061-T6 数量：1 单位：mm 同号STEP为名义三维数模；图示非等比例打印

坐标单位mm。零件STEP保留图示局部原点；U=X、V=Y、W=Z。
正面=局部W最大面，背面=局部W最小面；边孔按方向向量钻入。
毛坯/外包络：7.7 x 48 x 48
轴线方向: [1,0,0]
center: [0,24,24]
凸台直径: "35 g6"
凸台长度: 4.7
中心通孔: 21
端盖孔 1: {"u":4,"v":4,"diameter":3.4}
端盖孔 2: {"u":4,"v":44,"diameter":3.4}
端盖孔 3: {"u":44,"v":4,"diameter":3.4}
端盖孔 4: {"u":44,"v":44,"diameter":3.4}
工艺 1: 左凸台5，右凸台4.7；右外圈轴向总游隙0.6，不加预紧垫片
通用：未注尺寸<=300为+/-0.1，>300为+/-0.2；CNC孔位+/-0.05；未注通孔+0.10/0。
螺纹在STEP中以公称径简化。按6H底孔/螺纹加工，不得直接按模型大径钻孔；有效牙深为验收值。
盲螺纹用底攻或螺纹铣削；工艺底孔应先核对剩余壁厚及交叉孔，薄壁处优先螺纹铣削。
未注Ra3.2；安装面Ra1.6；去毛刺C0.3。阳极层不计入配合尺寸；轴承孔、螺纹与定位面遮蔽。

# MG3-082 y_rear_spacer_0_0

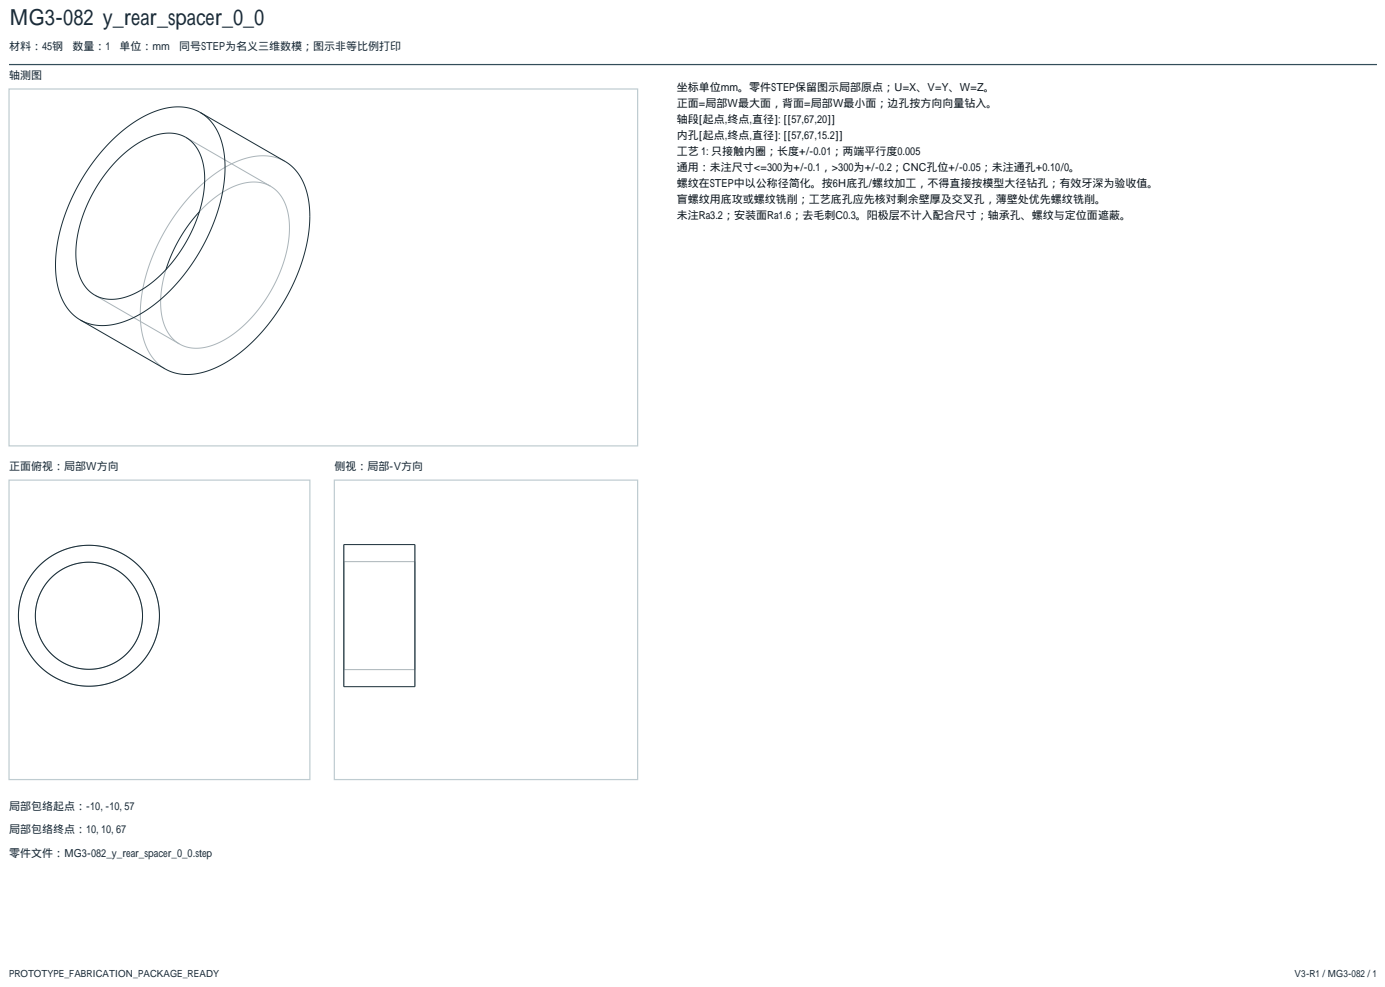
[picture p200: page 83]
轴测图; 正面俯视：局部W方向; 侧视：局部-V方向; 局部包络起点：-10, -10, 57; 局部包络终点：10, 10, 67; 零件文件：MG3-082_y_rear_spacer_0_0.step

材料：45钢 数量：1 单位：mm 同号STEP为名义三维数模；图示非等比例打印

坐标单位mm。零件STEP保留图示局部原点；U=X、V=Y、W=Z。
正面=局部W最大面，背面=局部W最小面；边孔按方向向量钻入。
工艺 1: 只接触内圈；长度+/-0.01；两端平行度0.005
通用：未注尺寸<=300为+/-0.1，>300为+/-0.2；CNC孔位+/-0.05；未注通孔+0.10/0。
螺纹在STEP中以公称径简化。按6H底孔/螺纹加工，不得直接按模型大径钻孔；有效牙深为验收值。
盲螺纹用底攻或螺纹铣削；工艺底孔应先核对剩余壁厚及交叉孔，薄壁处优先螺纹铣削。
未注Ra3.2；安装面Ra1.6；去毛刺C0.3。阳极层不计入配合尺寸；轴承孔、螺纹与定位面遮蔽。

# MG3-083 y_rear_spacer_0_1

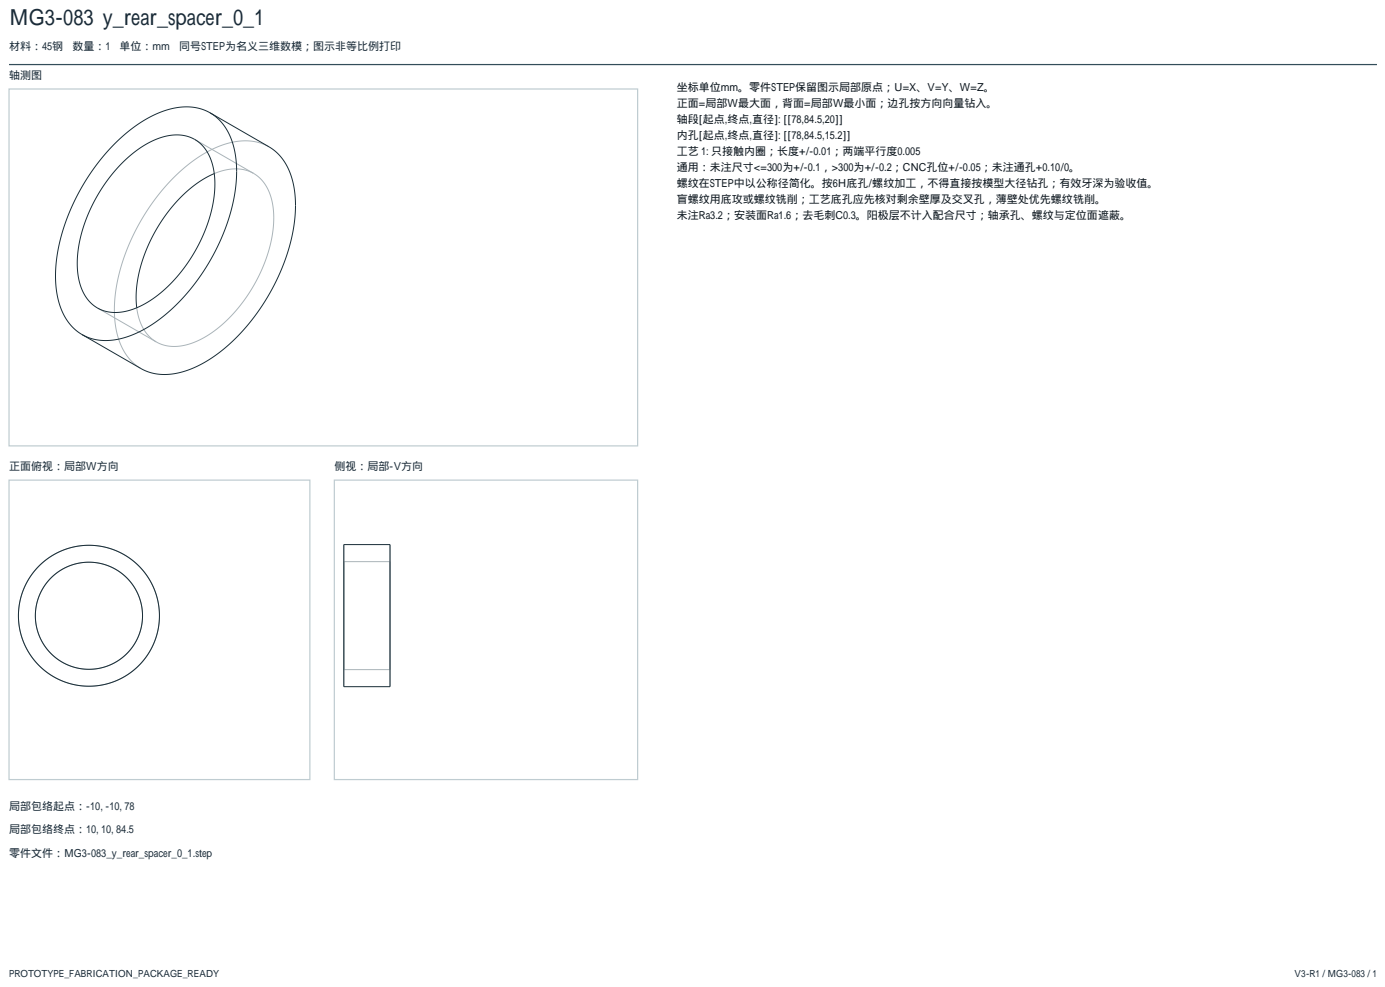
[picture p201: page 84]
轴测图; 正面俯视：局部W方向; 侧视：局部-V方向; 局部包络起点：-10, -10, 78; 局部包络终点：10, 10, 84.5; 零件文件：MG3-083_y_rear_spacer_0_1.step

材料：45钢 数量：1 单位：mm 同号STEP为名义三维数模；图示非等比例打印

坐标单位mm。零件STEP保留图示局部原点；U=X、V=Y、W=Z。
正面=局部W最大面，背面=局部W最小面；边孔按方向向量钻入。
工艺 1: 只接触内圈；长度+/-0.01；两端平行度0.005
通用：未注尺寸<=300为+/-0.1，>300为+/-0.2；CNC孔位+/-0.05；未注通孔+0.10/0。
螺纹在STEP中以公称径简化。按6H底孔/螺纹加工，不得直接按模型大径钻孔；有效牙深为验收值。
盲螺纹用底攻或螺纹铣削；工艺底孔应先核对剩余壁厚及交叉孔，薄壁处优先螺纹铣削。
未注Ra3.2；安装面Ra1.6；去毛刺C0.3。阳极层不计入配合尺寸；轴承孔、螺纹与定位面遮蔽。

# MG3-084 y_rear_spacer_1_0

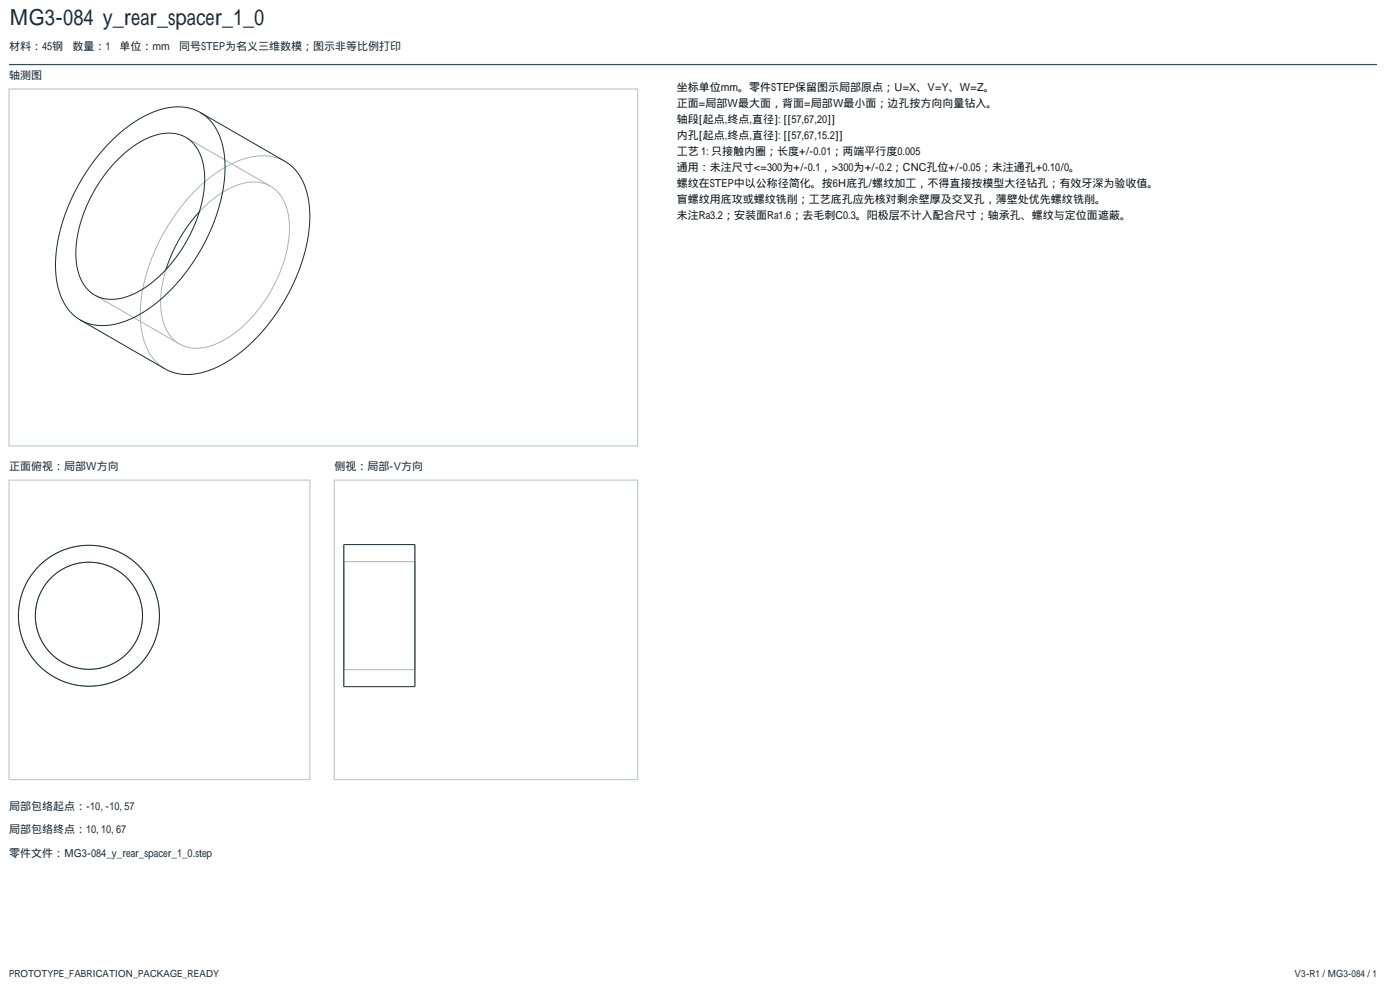
[picture p202: page 85]
轴测图; 正面俯视：局部W方向; 侧视：局部-V方向; 局部包络起点：-10, -10, 57; 局部包络终点：10, 10, 67; 零件文件：MG3-084_y_rear_spacer_1_0.step

材料：45钢 数量：1 单位：mm 同号STEP为名义三维数模；图示非等比例打印

坐标单位mm。零件STEP保留图示局部原点；U=X、V=Y、W=Z。
正面=局部W最大面，背面=局部W最小面；边孔按方向向量钻入。
工艺 1: 只接触内圈；长度+/-0.01；两端平行度0.005
通用：未注尺寸<=300为+/-0.1，>300为+/-0.2；CNC孔位+/-0.05；未注通孔+0.10/0。
螺纹在STEP中以公称径简化。按6H底孔/螺纹加工，不得直接按模型大径钻孔；有效牙深为验收值。
盲螺纹用底攻或螺纹铣削；工艺底孔应先核对剩余壁厚及交叉孔，薄壁处优先螺纹铣削。
未注Ra3.2；安装面Ra1.6；去毛刺C0.3。阳极层不计入配合尺寸；轴承孔、螺纹与定位面遮蔽。

# MG3-085 y_rear_spacer_1_1

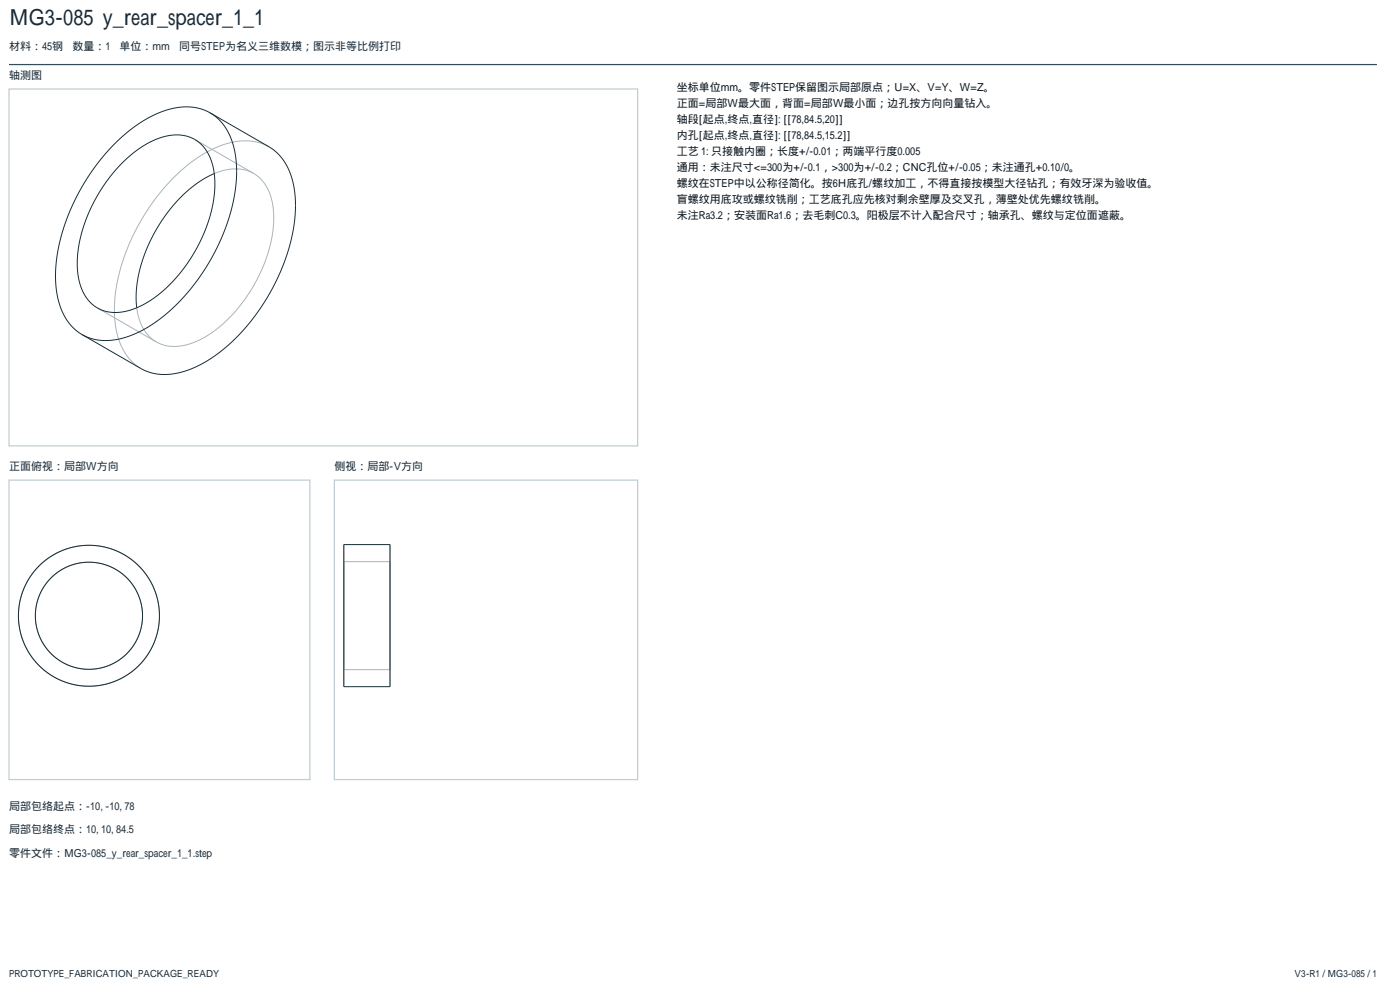
[picture p203: page 86]
轴测图; 正面俯视：局部W方向; 侧视：局部-V方向; 局部包络起点：-10, -10, 78; 局部包络终点：10, 10, 84.5; 零件文件：MG3-085_y_rear_spacer_1_1.step

材料：45钢 数量：1 单位：mm 同号STEP为名义三维数模；图示非等比例打印

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

# MG3-086 y_rear_support_0

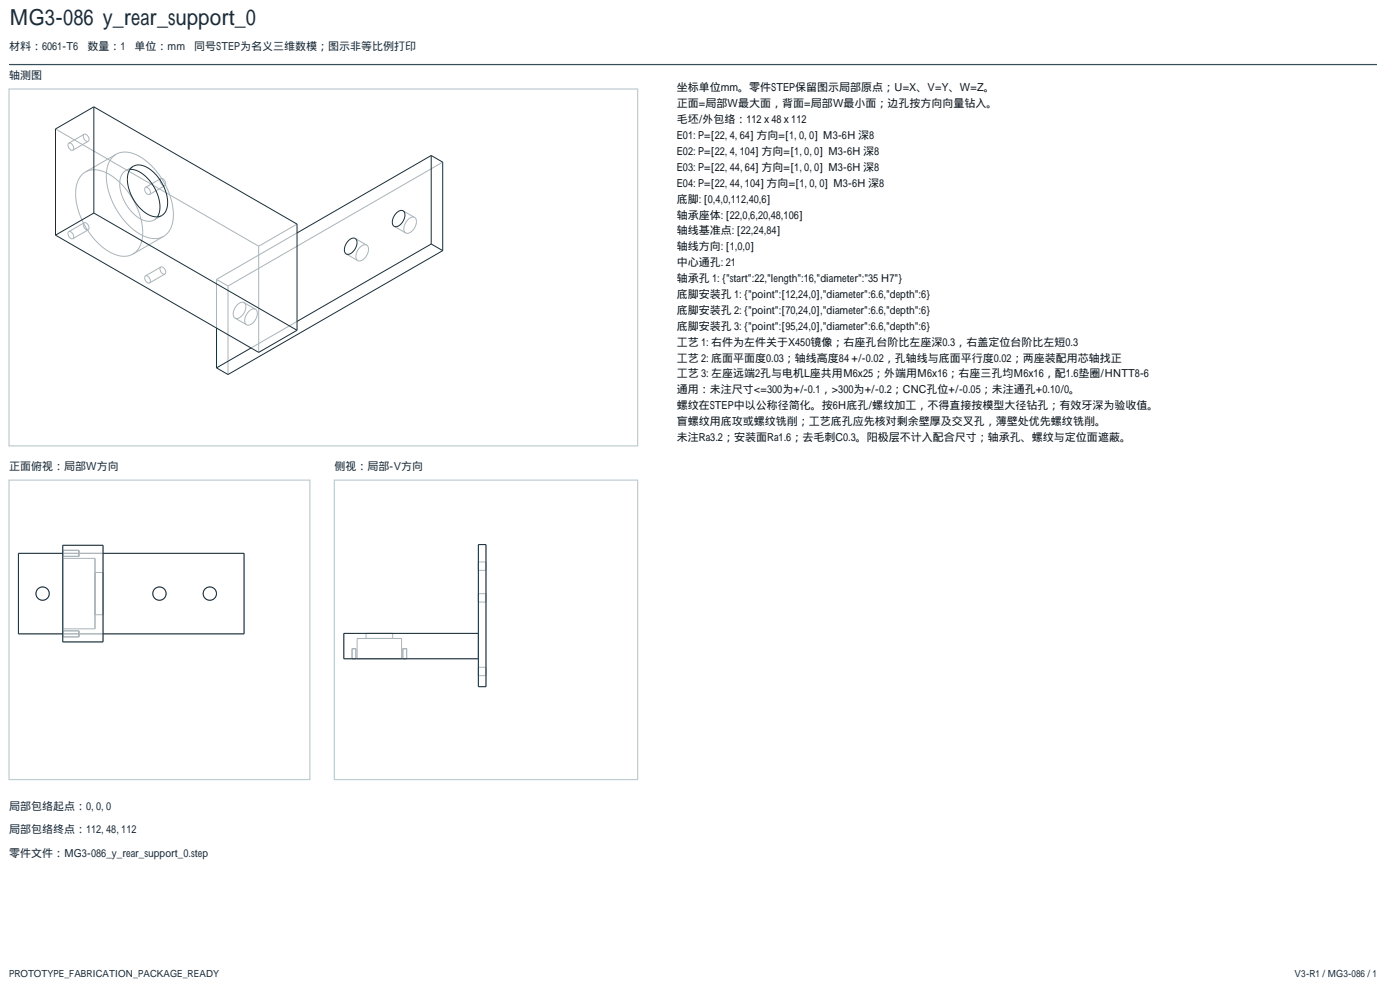
[picture p204: page 87]
轴测图; 正面俯视：局部W方向; 侧视：局部-V方向; 局部包络起点：0, 0, 0; 局部包络终点：112, 48, 112; 零件文件：MG3-086_y_rear_support_0.step

材料：6061-T6 数量：1 单位：mm 同号STEP为名义三维数模；图示非等比例打印

坐标单位mm。零件STEP保留图示局部原点；U=X、V=Y、W=Z。
正面=局部W最大面，背面=局部W最小面；边孔按方向向量钻入。
毛坯/外包络：112 x 48 x 112
轴承座体: [22,0,6,20,48,106]
轴线基准点: [22,24,84]
轴线方向: [1,0,0]
中心通孔: 21
轴承孔 1: {"start":22,"length":16,"diameter":"35 H7"}
底脚安装孔 1: {"point":[12,24,0],"diameter":6.6,"depth":6}
底脚安装孔 2: {"point":[70,24,0],"diameter":6.6,"depth":6}
底脚安装孔 3: {"point":[95,24,0],"diameter":6.6,"depth":6}
工艺 1: 右件为左件关于X450镜像；右座孔台阶比左座深0.3，右盖定位台阶比左短0.3
工艺 2: 底面平面度0.03；轴线高度84 +/-0.02，孔轴线与底面平行度0.02；两座装配用芯轴找正
工艺 3: 左座远端2孔与电机L座共用M6x25；外端用M6x16；右座三孔均M6x16，配1.6垫圈/HNTT8-6
通用：未注尺寸<=300为+/-0.1，>300为+/-0.2；CNC孔位+/-0.05；未注通孔+0.10/0。
螺纹在STEP中以公称径简化。按6H底孔/螺纹加工，不得直接按模型大径钻孔；有效牙深为验收值。
盲螺纹用底攻或螺纹铣削；工艺底孔应先核对剩余壁厚及交叉孔，薄壁处优先螺纹铣削。
未注Ra3.2；安装面Ra1.6；去毛刺C0.3。阳极层不计入配合尺寸；轴承孔、螺纹与定位面遮蔽。

# MG3-087 y_rear_support_1

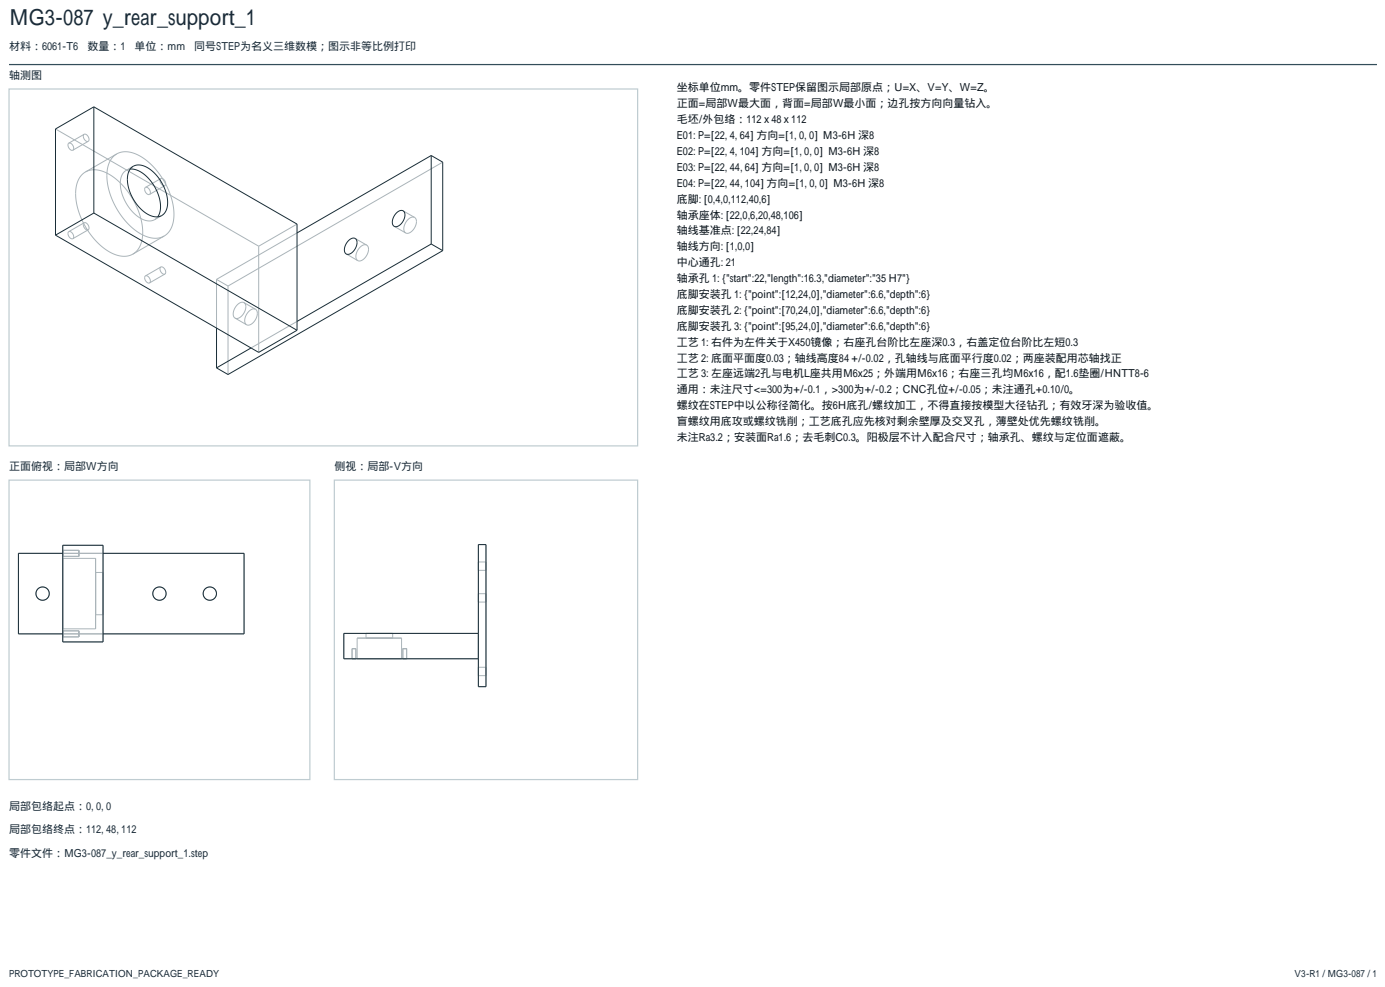
[picture p205: page 88]
轴测图; 正面俯视：局部W方向; 侧视：局部-V方向; 局部包络起点：0, 0, 0; 局部包络终点：112, 48, 112; 零件文件：MG3-087_y_rear_support_1.step

材料：6061-T6 数量：1 单位：mm 同号STEP为名义三维数模；图示非等比例打印

坐标单位mm。零件STEP保留图示局部原点；U=X、V=Y、W=Z。
正面=局部W最大面，背面=局部W最小面；边孔按方向向量钻入。
毛坯/外包络：112 x 48 x 112
轴承座体: [22,0,6,20,48,106]
轴线基准点: [22,24,84]
轴线方向: [1,0,0]
中心通孔: 21
轴承孔 1: {"start":22,"length":16.3,"diameter":"35 H7"}
底脚安装孔 1: {"point":[12,24,0],"diameter":6.6,"depth":6}
底脚安装孔 2: {"point":[70,24,0],"diameter":6.6,"depth":6}
底脚安装孔 3: {"point":[95,24,0],"diameter":6.6,"depth":6}
工艺 1: 右件为左件关于X450镜像；右座孔台阶比左座深0.3，右盖定位台阶比左短0.3
工艺 2: 底面平面度0.03；轴线高度84 +/-0.02，孔轴线与底面平行度0.02；两座装配用芯轴找正
工艺 3: 左座远端2孔与电机L座共用M6x25；外端用M6x16；右座三孔均M6x16，配1.6垫圈/HNTT8-6
通用：未注尺寸<=300为+/-0.1，>300为+/-0.2；CNC孔位+/-0.05；未注通孔+0.10/0。
螺纹在STEP中以公称径简化。按6H底孔/螺纹加工，不得直接按模型大径钻孔；有效牙深为验收值。
盲螺纹用底攻或螺纹铣削；工艺底孔应先核对剩余壁厚及交叉孔，薄壁处优先螺纹铣削。
未注Ra3.2；安装面Ra1.6；去毛刺C0.3。阳极层不计入配合尺寸；轴承孔、螺纹与定位面遮蔽。

# MG3-088 y_rear_washer_0

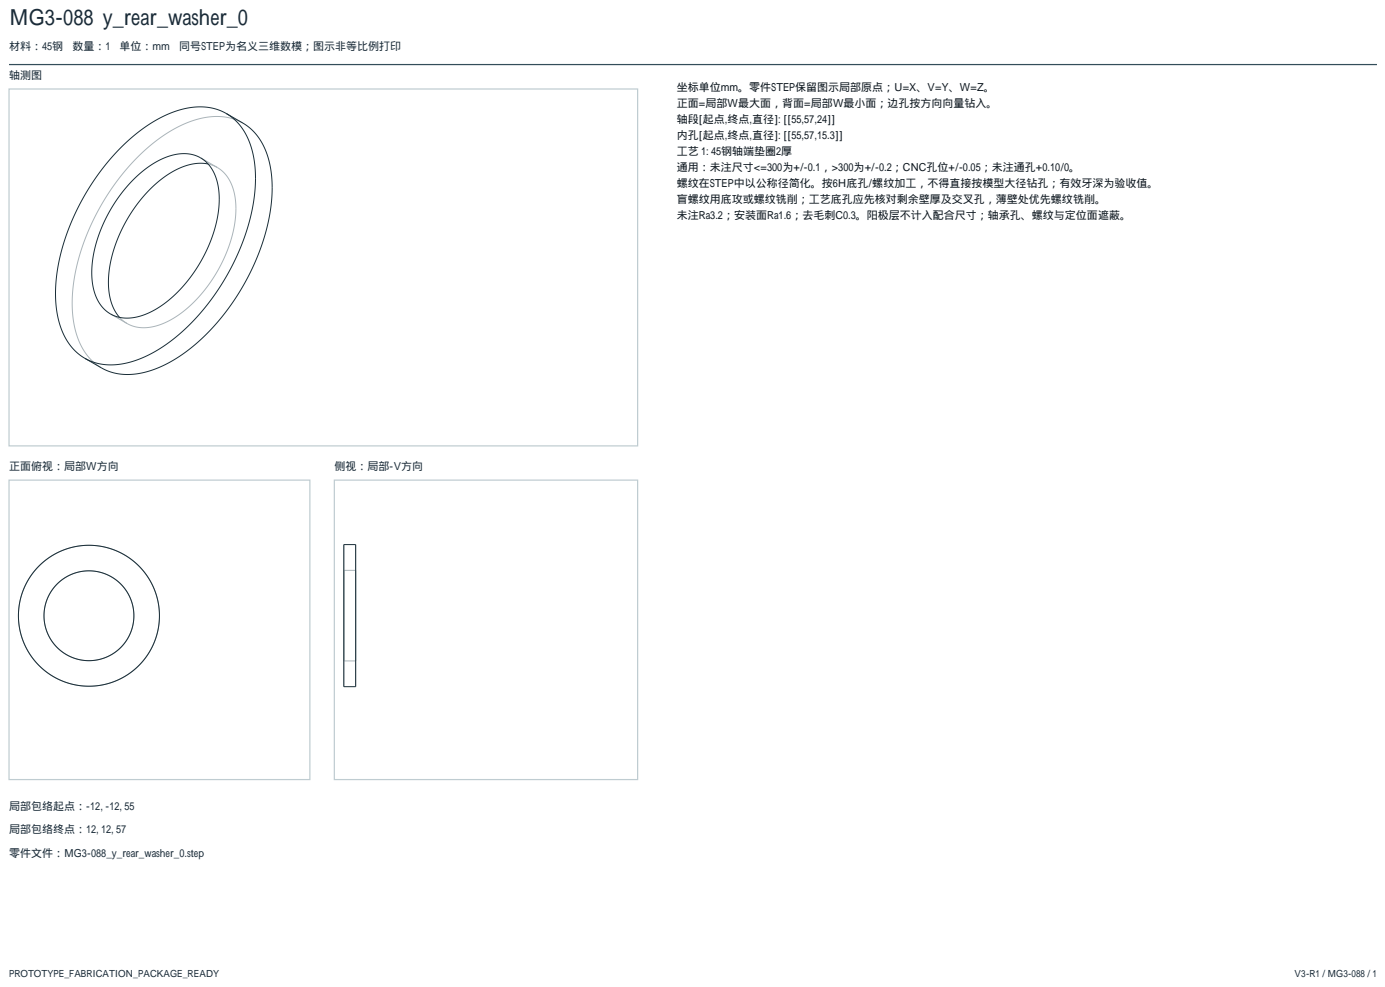
[picture p206: page 89]
轴测图; 正面俯视：局部W方向; 侧视：局部-V方向; 局部包络起点：-12, -12, 55; 局部包络终点：12, 12, 57; 零件文件：MG3-088_y_rear_washer_0.step

材料：45钢 数量：1 单位：mm 同号STEP为名义三维数模；图示非等比例打印

坐标单位mm。零件STEP保留图示局部原点；U=X、V=Y、W=Z。
正面=局部W最大面，背面=局部W最小面；边孔按方向向量钻入。
工艺 1: 45钢轴端垫圈2厚
通用：未注尺寸<=300为+/-0.1，>300为+/-0.2；CNC孔位+/-0.05；未注通孔+0.10/0。
螺纹在STEP中以公称径简化。按6H底孔/螺纹加工，不得直接按模型大径钻孔；有效牙深为验收值。
盲螺纹用底攻或螺纹铣削；工艺底孔应先核对剩余壁厚及交叉孔，薄壁处优先螺纹铣削。
未注Ra3.2；安装面Ra1.6；去毛刺C0.3。阳极层不计入配合尺寸；轴承孔、螺纹与定位面遮蔽。

# MG3-089 y_rear_washer_1

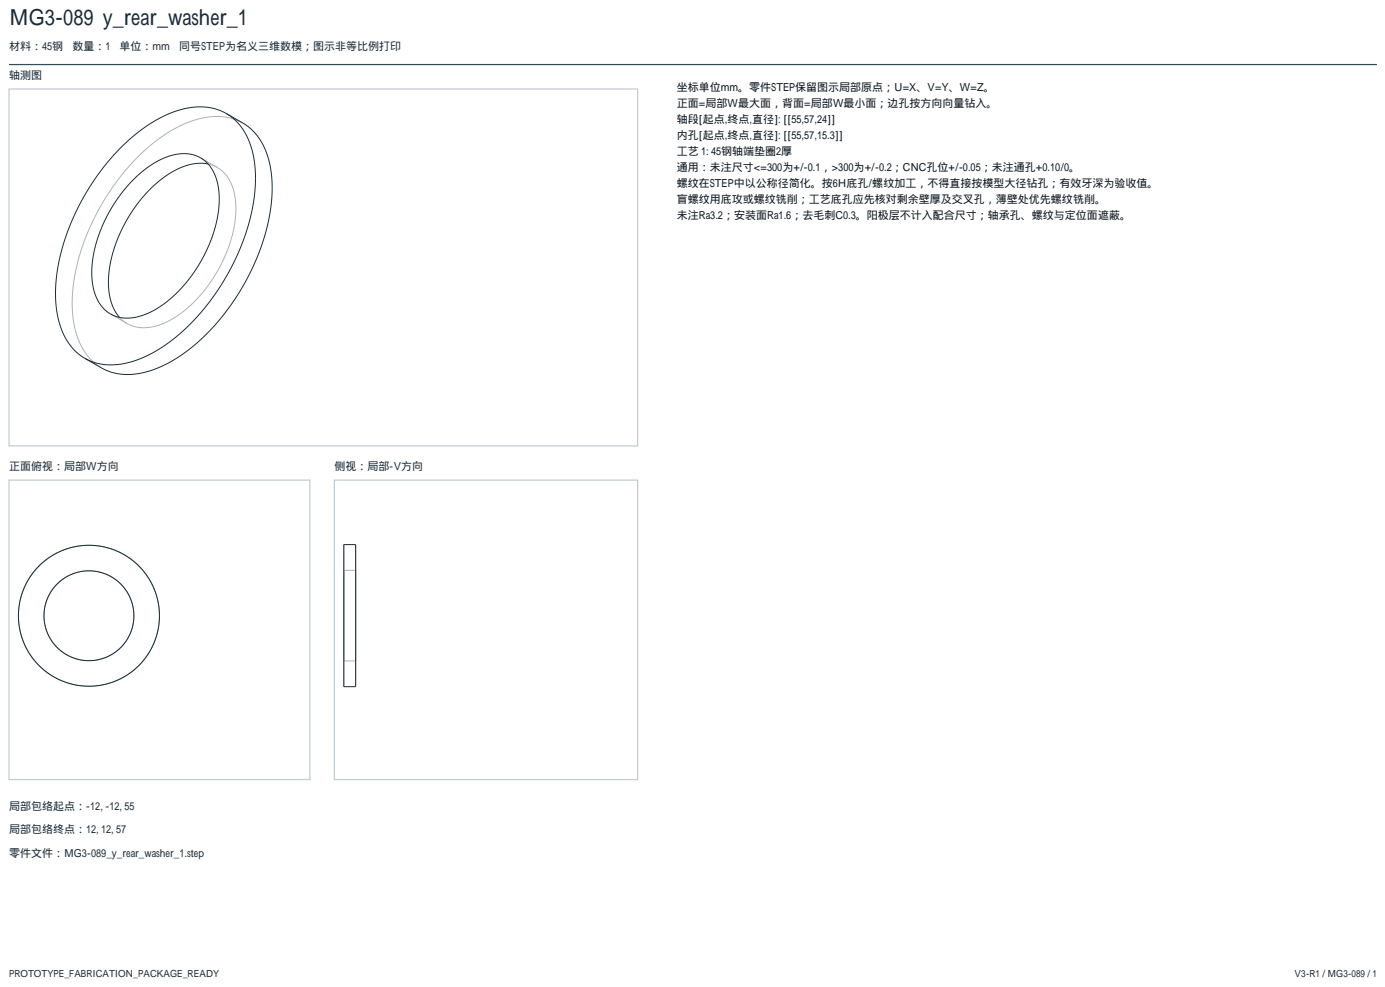
[picture p207: page 90]
轴测图; 正面俯视：局部W方向; 侧视：局部-V方向; 局部包络起点：-12, -12, 55; 局部包络终点：12, 12, 57; 零件文件：MG3-089_y_rear_washer_1.step

材料：45钢 数量：1 单位：mm 同号STEP为名义三维数模；图示非等比例打印

坐标单位mm。零件STEP保留图示局部原点；U=X、V=Y、W=Z。
正面=局部W最大面，背面=局部W最小面；边孔按方向向量钻入。
工艺 1: 45钢轴端垫圈2厚
通用：未注尺寸<=300为+/-0.1，>300为+/-0.2；CNC孔位+/-0.05；未注通孔+0.10/0。
螺纹在STEP中以公称径简化。按6H底孔/螺纹加工，不得直接按模型大径钻孔；有效牙深为验收值。
盲螺纹用底攻或螺纹铣削；工艺底孔应先核对剩余壁厚及交叉孔，薄壁处优先螺纹铣削。
未注Ra3.2；安装面Ra1.6；去毛刺C0.3。阳极层不计入配合尺寸；轴承孔、螺纹与定位面遮蔽。

# MG3-090 y_reduction_driven_pulley

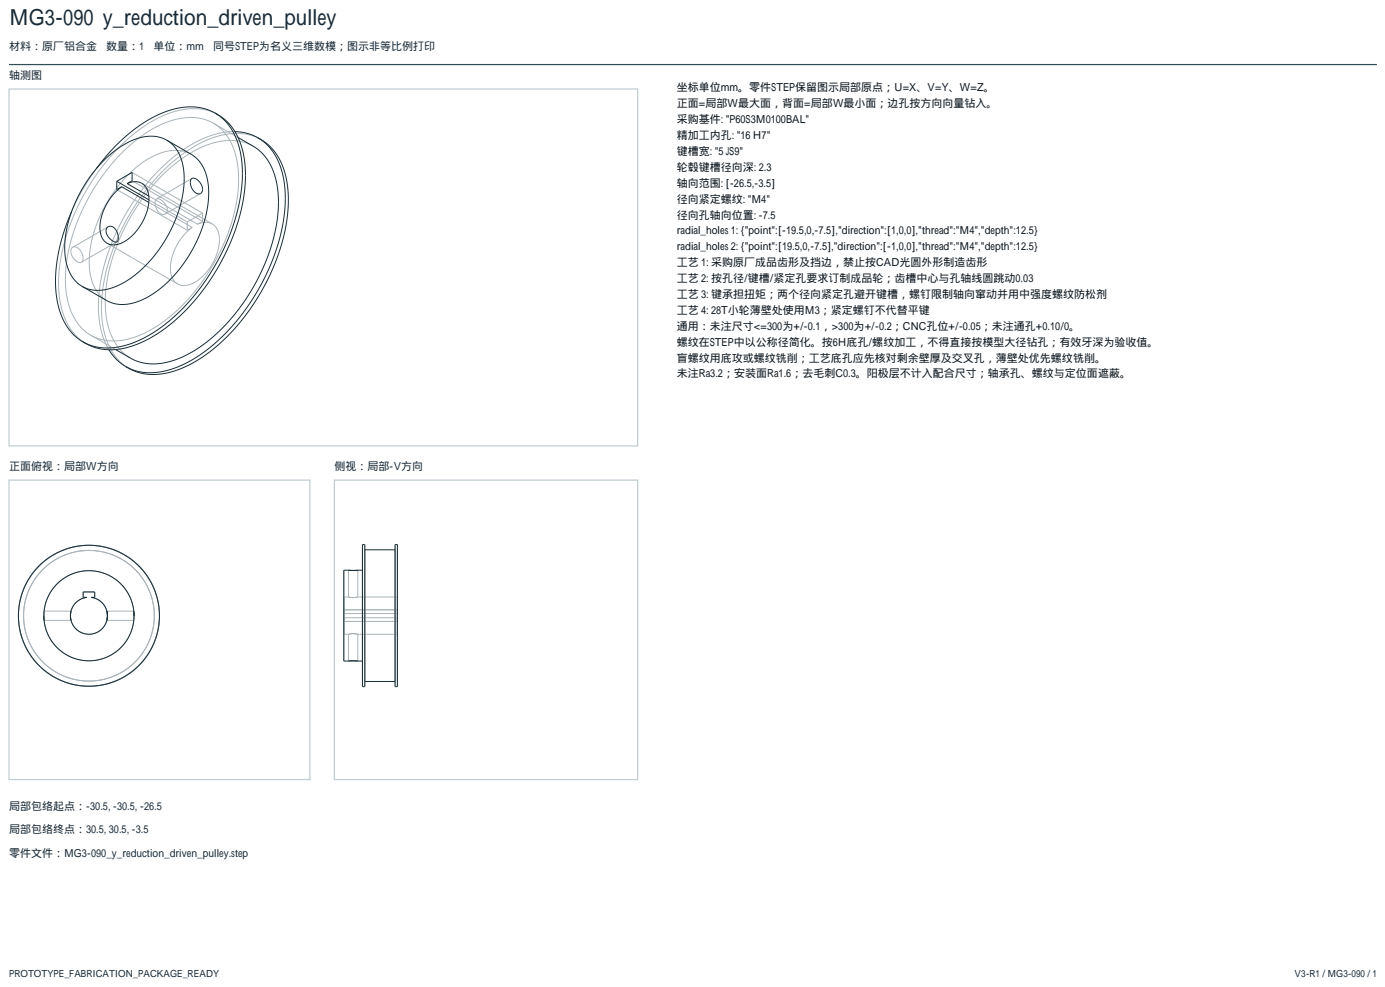
[picture p208: page 91]
轴测图; 正面俯视：局部W方向; 侧视：局部-V方向; 局部包络起点：-30.5, -30.5, -26.5; 局部包络终点：30.5, 30.5, -3.5; 零件文件：MG3-090_y_reduction_driven_pulley.step

材料：原厂铝合金 数量：1 单位：mm 同号STEP为名义三维数模；图示非等比例打印

坐标单位mm。零件STEP保留图示局部原点；U=X、V=Y、W=Z。
正面=局部W最大面，背面=局部W最小面；边孔按方向向量钻入。
采购基件: "P60S3M0100BAL"
精加工内孔: "16 H7"
键槽宽: "5 JS9"
轮毂键槽径向深: 2.3
轴向范围: [-26.5,-3.5]
径向紧定螺纹: "M4"
径向孔轴向位置: -7.5
radial_holes 1: {"point":[-19.5,0,-7.5],"direction":[1,0,0],"thread":"M4","depth":12.5}
radial_holes 2: {"point":[19.5,0,-7.5],"direction":[-1,0,0],"thread":"M4","depth":12.5}
工艺 1: 采购原厂成品齿形及挡边，禁止按CAD光圆外形制造齿形
工艺 2: 按孔径/键槽/紧定孔要求订制成品轮；齿槽中心与孔轴线圆跳动0.03
工艺 3: 键承担扭矩；两个径向紧定孔避开键槽，螺钉限制轴向窜动并用中强度螺纹防松剂
工艺 4: 28T小轮薄壁处使用M3；紧定螺钉不代替平键
通用：未注尺寸<=300为+/-0.1，>300为+/-0.2；CNC孔位+/-0.05；未注通孔+0.10/0。
螺纹在STEP中以公称径简化。按6H底孔/螺纹加工，不得直接按模型大径钻孔；有效牙深为验收值。
盲螺纹用底攻或螺纹铣削；工艺底孔应先核对剩余壁厚及交叉孔，薄壁处优先螺纹铣削。
未注Ra3.2；安装面Ra1.6；去毛刺C0.3。阳极层不计入配合尺寸；轴承孔、螺纹与定位面遮蔽。

# MG3-091 y_sync_shaft

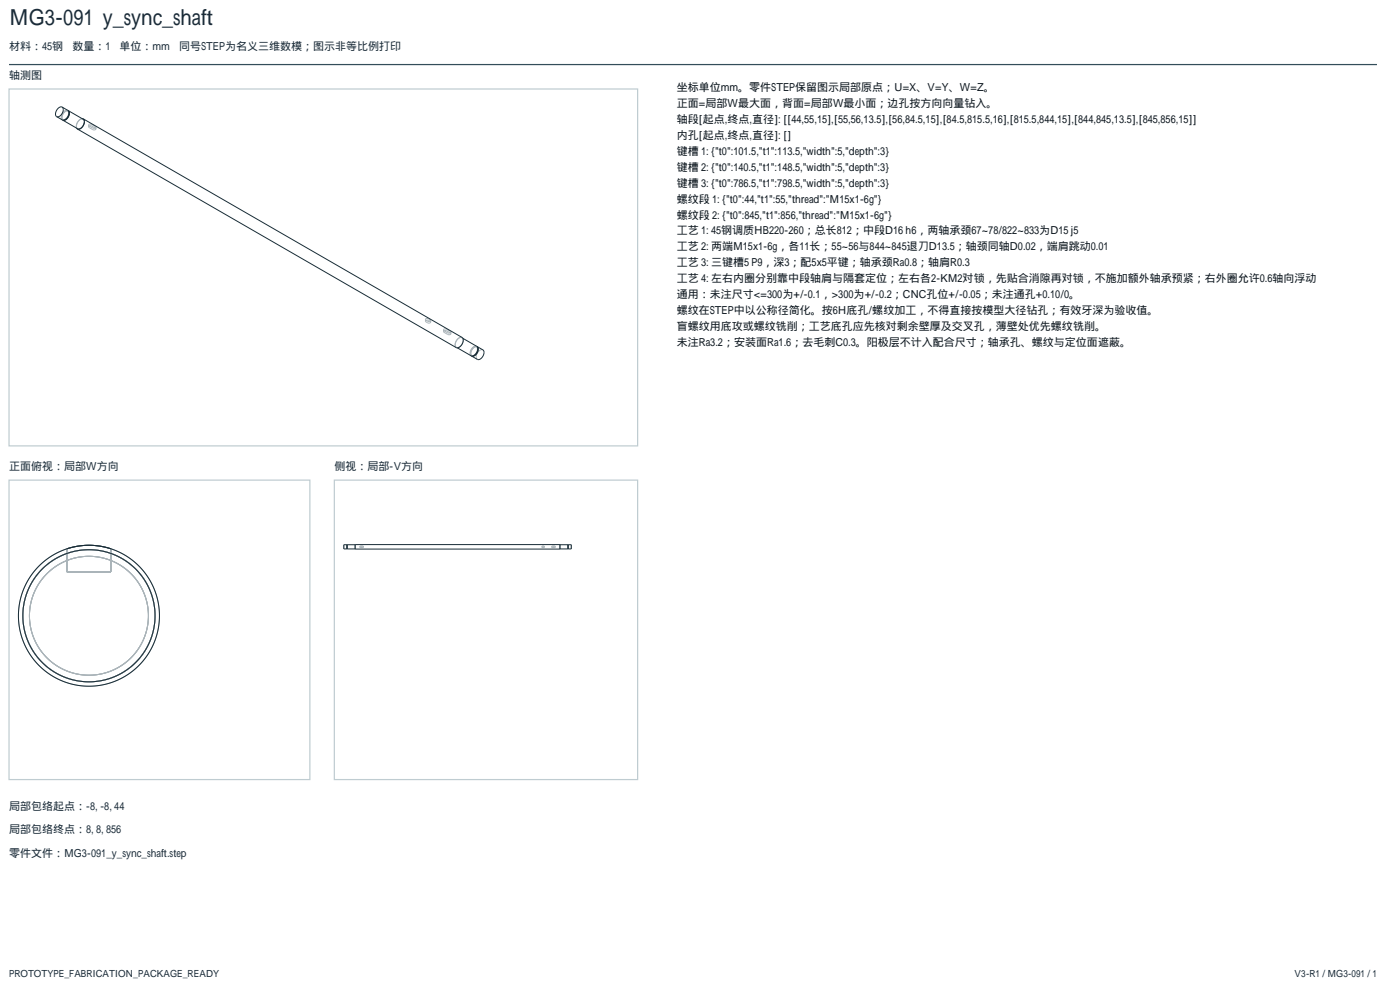
[picture p209: page 92]
轴测图; 正面俯视：局部W方向; 侧视：局部-V方向; 局部包络起点：-8, -8, 44; 局部包络终点：8, 8, 856; 零件文件：MG3-091_y_sync_shaft.step

材料：45钢 数量：1 单位：mm 同号STEP为名义三维数模；图示非等比例打印

坐标单位mm。零件STEP保留图示局部原点；U=X、V=Y、W=Z。
正面=局部W最大面，背面=局部W最小面；边孔按方向向量钻入。
键槽 1: {"t0":101.5,"t1":113.5,"width":5,"depth":3}
键槽 2: {"t0":140.5,"t1":148.5,"width":5,"depth":3}
键槽 3: {"t0":786.5,"t1":798.5,"width":5,"depth":3}
螺纹段 1: {"t0":44,"t1":55,"thread":"M15x1-6g"}
螺纹段 2: {"t0":845,"t1":856,"thread":"M15x1-6g"}
工艺 1: 45钢调质HB220-260；总长812；中段D16 h6，两轴承颈67~78/822~833为D15 j5
工艺 2: 两端M15x1-6g，各11长；55~56与844~845退刀D13.5；轴颈同轴D0.02，端肩跳动0.01
工艺 3: 三键槽5 P9，深3；配5x5平键；轴承颈Ra0.8；轴肩R0.3
工艺 4: 左右内圈分别靠中段轴肩与隔套定位；左右各2-KM2对锁，先贴合消隙再对锁，不施加额外轴承预紧；右外圈允许0.6轴向浮动
通用：未注尺寸<=300为+/-0.1，>300为+/-0.2；CNC孔位+/-0.05；未注通孔+0.10/0。
螺纹在STEP中以公称径简化。按6H底孔/螺纹加工，不得直接按模型大径钻孔；有效牙深为验收值。
盲螺纹用底攻或螺纹铣削；工艺底孔应先核对剩余壁厚及交叉孔，薄壁处优先螺纹铣削。
未注Ra3.2；安装面Ra1.6；去毛刺C0.3。阳极层不计入配合尺寸；轴承孔、螺纹与定位面遮蔽。

# MG3-092 y_tension_0_adjuster

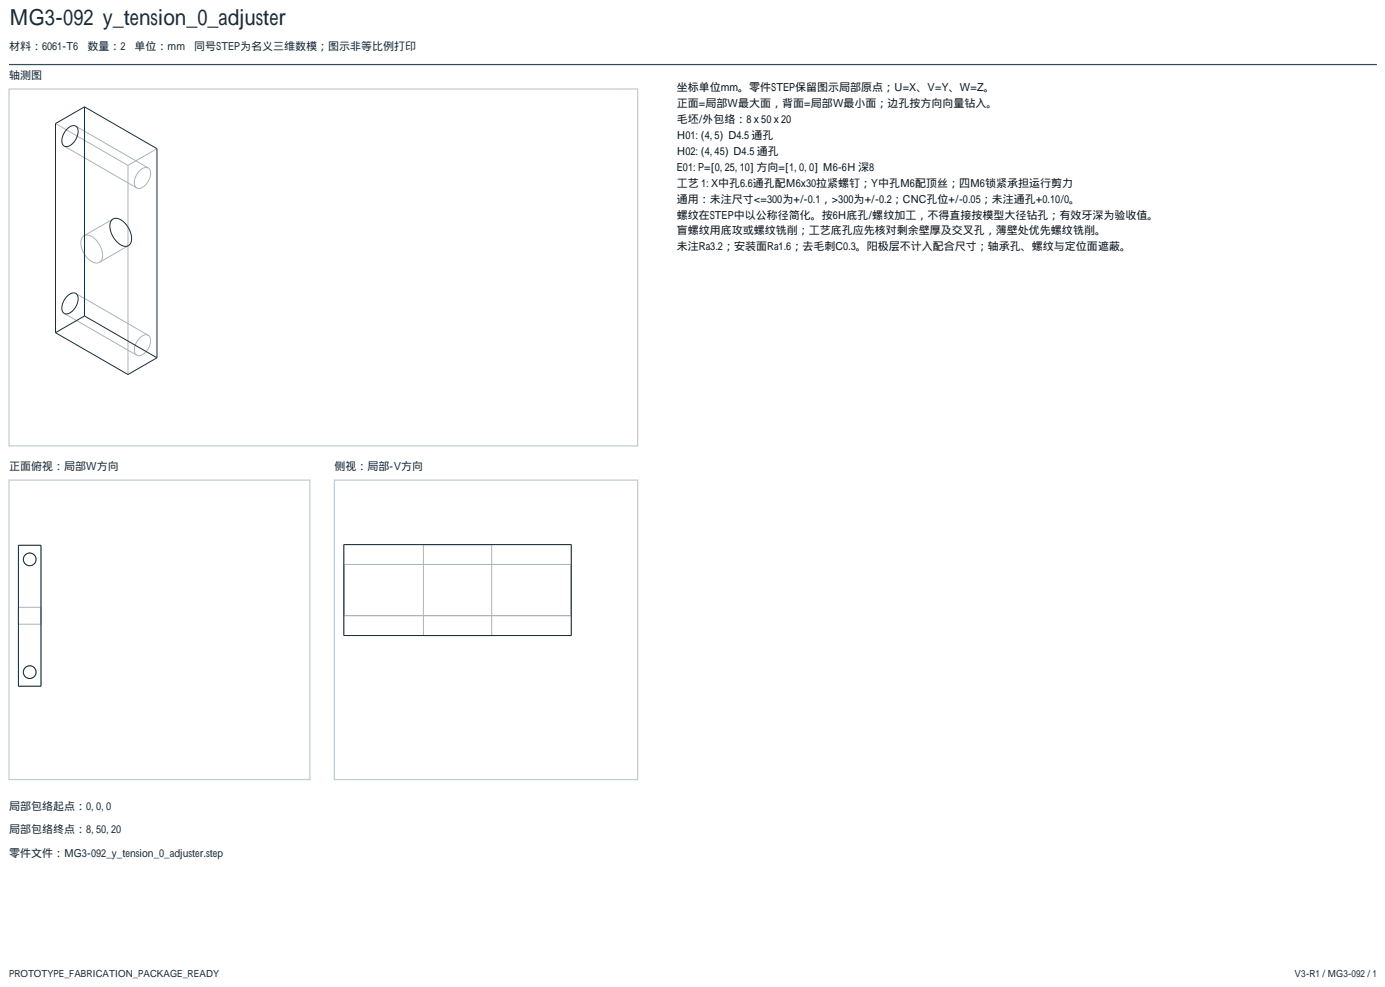
[picture p210: page 93]
轴测图; 正面俯视：局部W方向; 侧视：局部-V方向; 局部包络起点：0, 0, 0; 局部包络终点：8, 50, 20; 零件文件：MG3-092_y_tension_0_adjuster.step

材料：6061-T6 数量：2 单位：mm 同号STEP为名义三维数模；图示非等比例打印

坐标单位mm。零件STEP保留图示局部原点；U=X、V=Y、W=Z。
正面=局部W最大面，背面=局部W最小面；边孔按方向向量钻入。
毛坯/外包络：8 x 50 x 20
工艺 1: X中孔6.6通孔配M6x30拉紧螺钉；Y中孔M6配顶丝；四M6锁紧承担运行剪力
通用：未注尺寸<=300为+/-0.1，>300为+/-0.2；CNC孔位+/-0.05；未注通孔+0.10/0。
螺纹在STEP中以公称径简化。按6H底孔/螺纹加工，不得直接按模型大径钻孔；有效牙深为验收值。
盲螺纹用底攻或螺纹铣削；工艺底孔应先核对剩余壁厚及交叉孔，薄壁处优先螺纹铣削。
未注Ra3.2；安装面Ra1.6；去毛刺C0.3。阳极层不计入配合尺寸；轴承孔、螺纹与定位面遮蔽。

# MG3-093 y_tension_0_axle

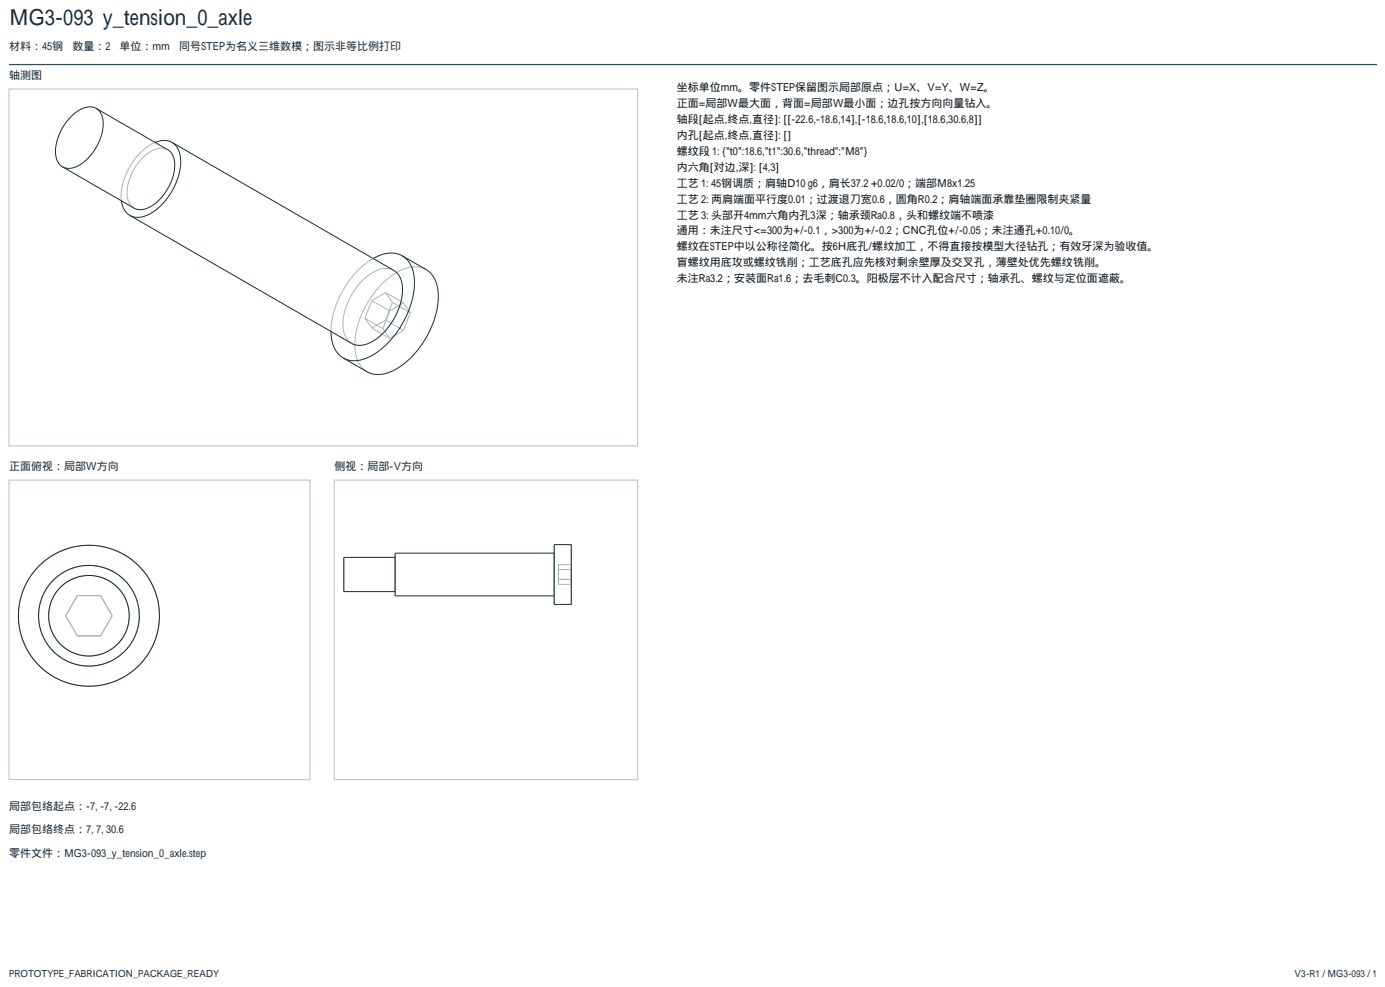
[picture p211: page 94]
轴测图; 正面俯视：局部W方向; 侧视：局部-V方向; 局部包络起点：-7, -7, -22.6; 局部包络终点：7, 7, 30.6; 零件文件：MG3-093_y_tension_0_axle.step

材料：45钢 数量：2 单位：mm 同号STEP为名义三维数模；图示非等比例打印

坐标单位mm。零件STEP保留图示局部原点；U=X、V=Y、W=Z。
正面=局部W最大面，背面=局部W最小面；边孔按方向向量钻入。
螺纹段 1: {"t0":18.6,"t1":30.6,"thread":"M8"}
内六角[对边,深]: [4,3]
工艺 1: 45钢调质；肩轴D10 g6，肩长37.2 +0.02/0；端部M8x1.25
工艺 2: 两肩端面平行度0.01；过渡退刀宽0.6，圆角R0.2；肩轴端面承靠垫圈限制夹紧量
工艺 3: 头部开4mm六角内孔3深；轴承颈Ra0.8，头和螺纹端不喷漆
通用：未注尺寸<=300为+/-0.1，>300为+/-0.2；CNC孔位+/-0.05；未注通孔+0.10/0。
螺纹在STEP中以公称径简化。按6H底孔/螺纹加工，不得直接按模型大径钻孔；有效牙深为验收值。
盲螺纹用底攻或螺纹铣削；工艺底孔应先核对剩余壁厚及交叉孔，薄壁处优先螺纹铣削。
未注Ra3.2；安装面Ra1.6；去毛刺C0.3。阳极层不计入配合尺寸；轴承孔、螺纹与定位面遮蔽。

# MG3-094 y_tension_0_base

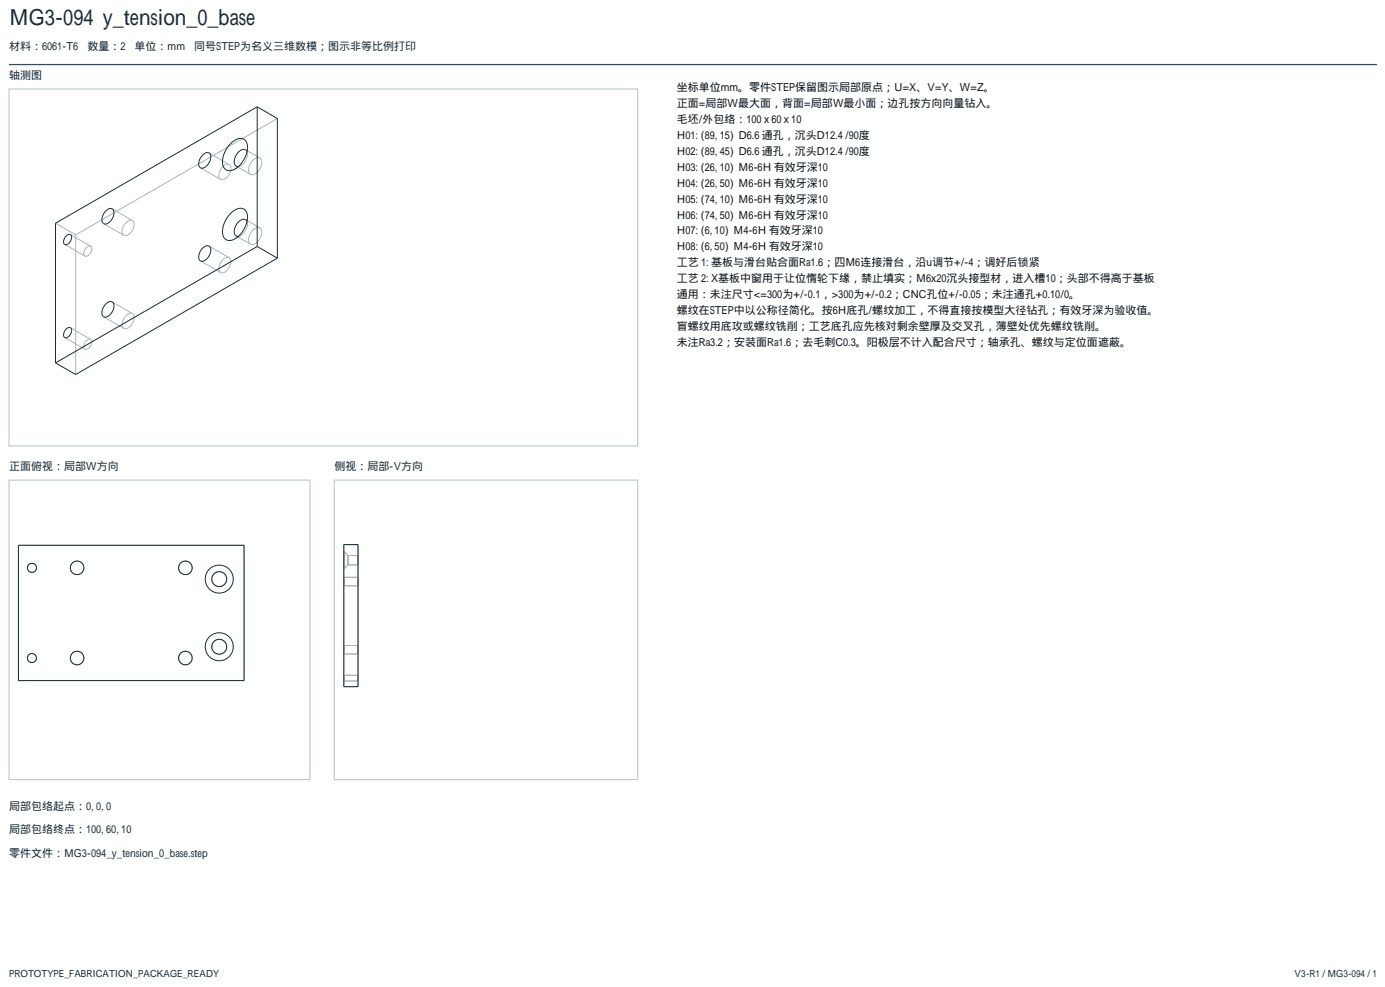
[picture p212: page 95]
轴测图; 正面俯视：局部W方向; 侧视：局部-V方向; 局部包络起点：0, 0, 0; 局部包络终点：100, 60, 10; 零件文件：MG3-094_y_tension_0_base.step

材料：6061-T6 数量：2 单位：mm 同号STEP为名义三维数模；图示非等比例打印

坐标单位mm。零件STEP保留图示局部原点；U=X、V=Y、W=Z。
正面=局部W最大面，背面=局部W最小面；边孔按方向向量钻入。
毛坯/外包络：100 x 60 x 10
H01: (89, 15) D6.6 通孔，沉头D12.4 /90度
H02: (89, 45) D6.6 通孔，沉头D12.4 /90度
H03: (26, 10) M6-6H 有效牙深10
H04: (26, 50) M6-6H 有效牙深10
H05: (74, 10) M6-6H 有效牙深10
H06: (74, 50) M6-6H 有效牙深10
H07: (6, 10) M4-6H 有效牙深10
H08: (6, 50) M4-6H 有效牙深10
工艺 1: 基板与滑台贴合面Ra1.6；四M6连接滑台，沿u调节+/-4；调好后锁紧
工艺 2: X基板中窗用于让位惰轮下缘，禁止填实；M6x20沉头接型材，进入槽10；头部不得高于基板
通用：未注尺寸<=300为+/-0.1，>300为+/-0.2；CNC孔位+/-0.05；未注通孔+0.10/0。
螺纹在STEP中以公称径简化。按6H底孔/螺纹加工，不得直接按模型大径钻孔；有效牙深为验收值。
盲螺纹用底攻或螺纹铣削；工艺底孔应先核对剩余壁厚及交叉孔，薄壁处优先螺纹铣削。
未注Ra3.2；安装面Ra1.6；去毛刺C0.3。阳极层不计入配合尺寸；轴承孔、螺纹与定位面遮蔽。

# MG3-095 y_tension_0_fork

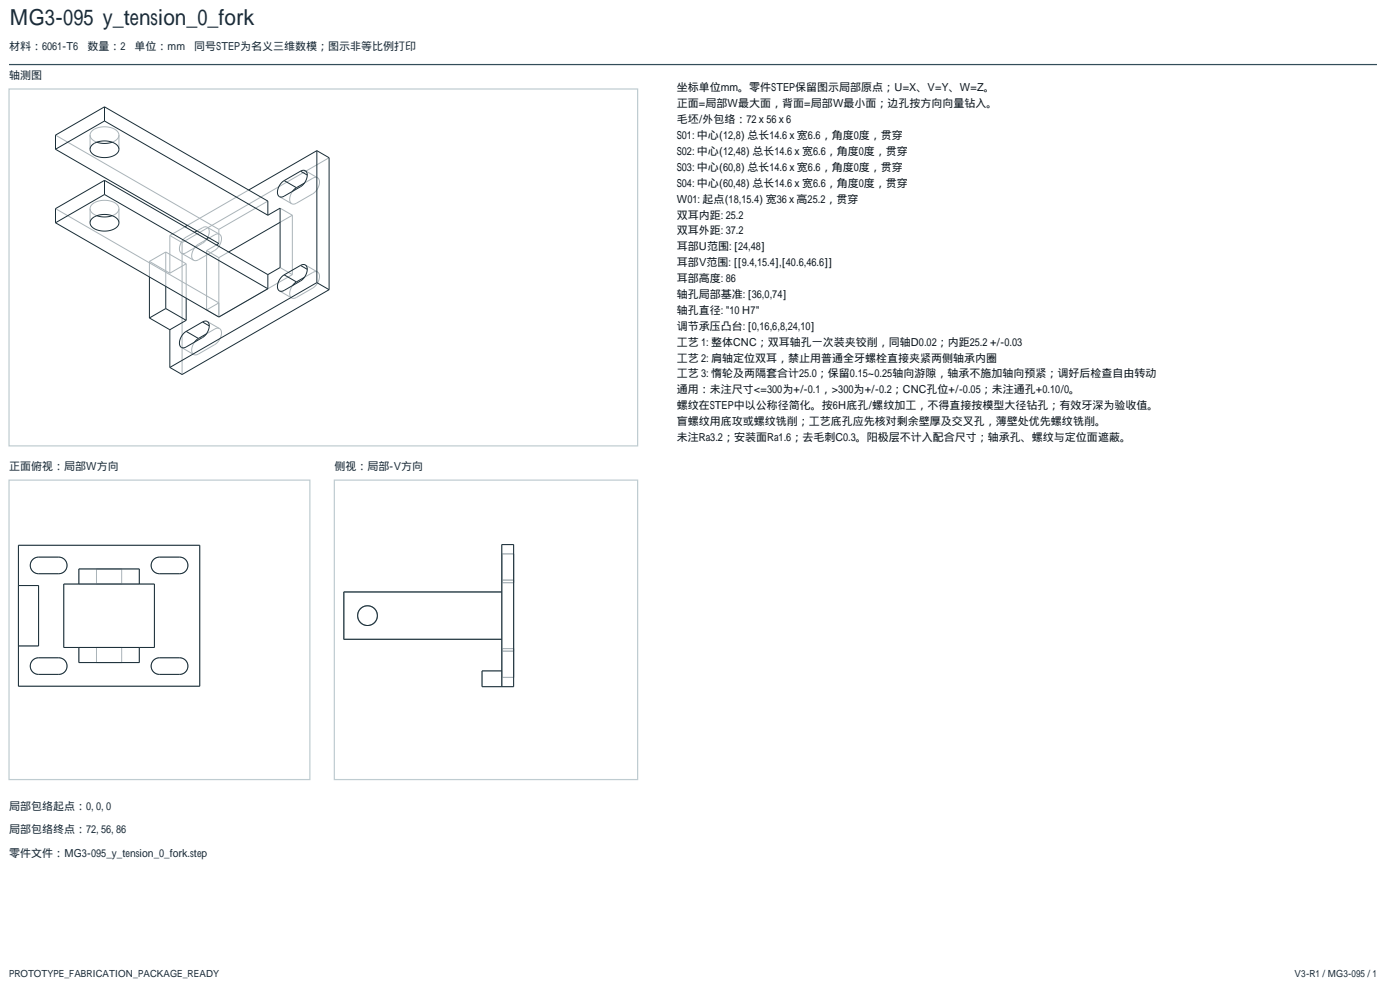
[picture p213: page 96]
轴测图; 正面俯视：局部W方向; 侧视：局部-V方向; 局部包络起点：0, 0, 0; 局部包络终点：72, 56, 86; 零件文件：MG3-095_y_tension_0_fork.step

材料：6061-T6 数量：2 单位：mm 同号STEP为名义三维数模；图示非等比例打印

坐标单位mm。零件STEP保留图示局部原点；U=X、V=Y、W=Z。
正面=局部W最大面，背面=局部W最小面；边孔按方向向量钻入。
毛坯/外包络：72 x 56 x 6
双耳内距: 25.2
双耳外距: 37.2
耳部U范围: [24,48]
耳部V范围: [[9.4,15.4],[40.6,46.6]]
耳部高度: 86
轴孔局部基准: [36,0,74]
轴孔直径: "10 H7"
调节承压凸台: [0,16,6,8,24,10]
工艺 1: 整体CNC；双耳轴孔一次装夹铰削，同轴D0.02；内距25.2 +/-0.03
工艺 2: 肩轴定位双耳，禁止用普通全牙螺栓直接夹紧两侧轴承内圈
工艺 3: 惰轮及两隔套合计25.0；保留0.15~0.25轴向游隙，轴承不施加轴向预紧；调好后检查自由转动
通用：未注尺寸<=300为+/-0.1，>300为+/-0.2；CNC孔位+/-0.05；未注通孔+0.10/0。
螺纹在STEP中以公称径简化。按6H底孔/螺纹加工，不得直接按模型大径钻孔；有效牙深为验收值。
盲螺纹用底攻或螺纹铣削；工艺底孔应先核对剩余壁厚及交叉孔，薄壁处优先螺纹铣削。
未注Ra3.2；安装面Ra1.6；去毛刺C0.3。阳极层不计入配合尺寸；轴承孔、螺纹与定位面遮蔽。

# MG3-096 y_tension_0_spacer_0

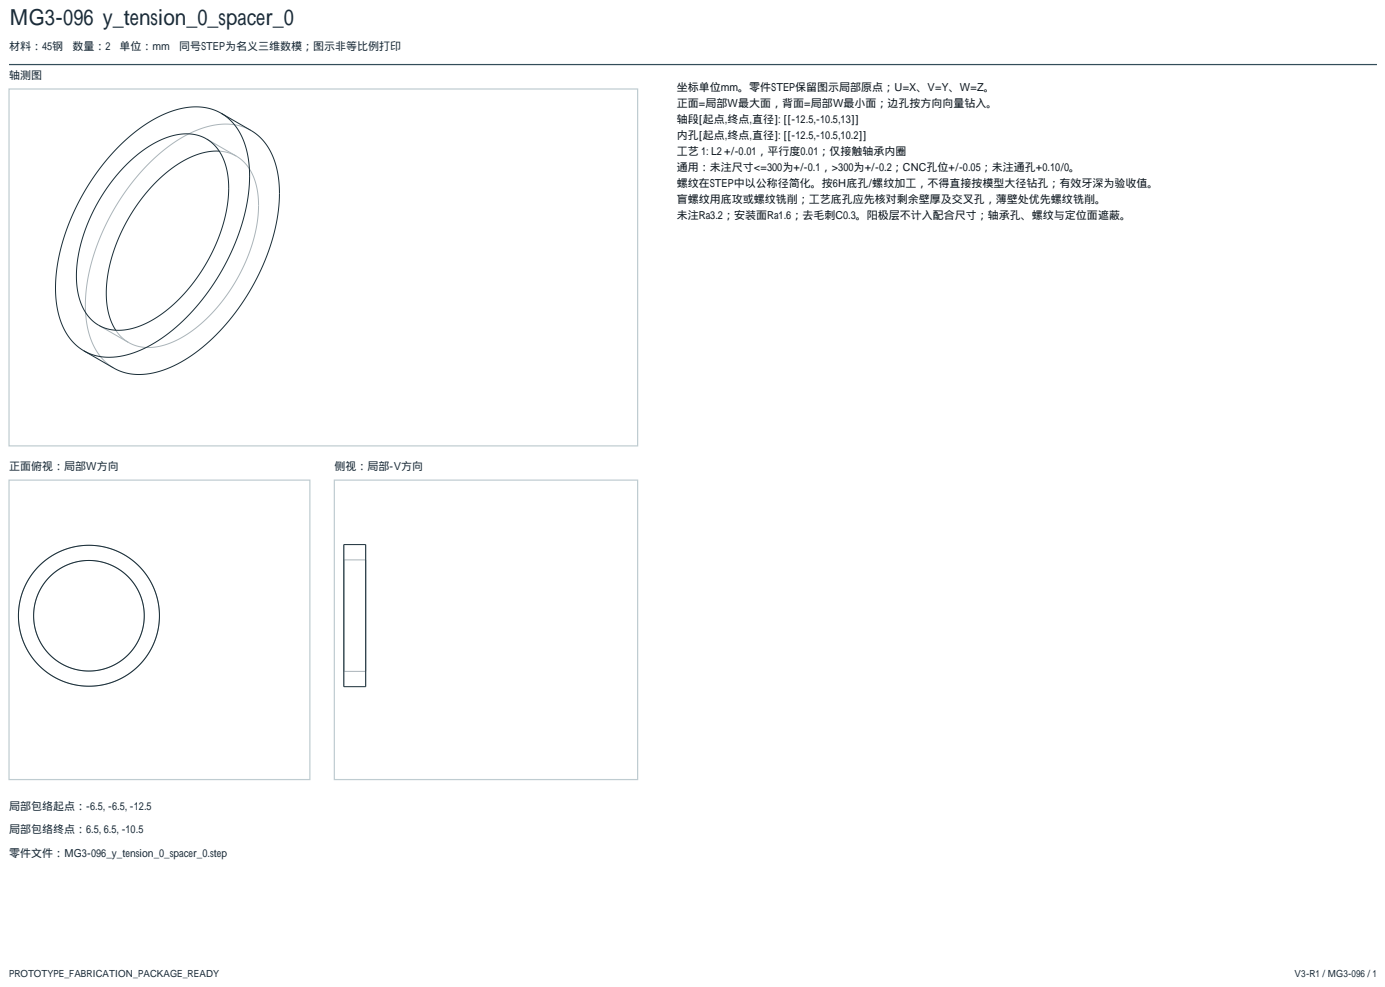
[picture p214: page 97]
轴测图; 正面俯视：局部W方向; 侧视：局部-V方向; 局部包络起点：-6.5, -6.5, -12.5; 局部包络终点：6.5, 6.5, -10.5; 零件文件：MG3-096_y_tension_0_spacer_0.step

材料：45钢 数量：2 单位：mm 同号STEP为名义三维数模；图示非等比例打印

坐标单位mm。零件STEP保留图示局部原点；U=X、V=Y、W=Z。
正面=局部W最大面，背面=局部W最小面；边孔按方向向量钻入。
工艺 1: L2 +/-0.01，平行度0.01；仅接触轴承内圈
通用：未注尺寸<=300为+/-0.1，>300为+/-0.2；CNC孔位+/-0.05；未注通孔+0.10/0。
螺纹在STEP中以公称径简化。按6H底孔/螺纹加工，不得直接按模型大径钻孔；有效牙深为验收值。
盲螺纹用底攻或螺纹铣削；工艺底孔应先核对剩余壁厚及交叉孔，薄壁处优先螺纹铣削。
未注Ra3.2；安装面Ra1.6；去毛刺C0.3。阳极层不计入配合尺寸；轴承孔、螺纹与定位面遮蔽。

# MG3-097 y_tension_0_spacer_1

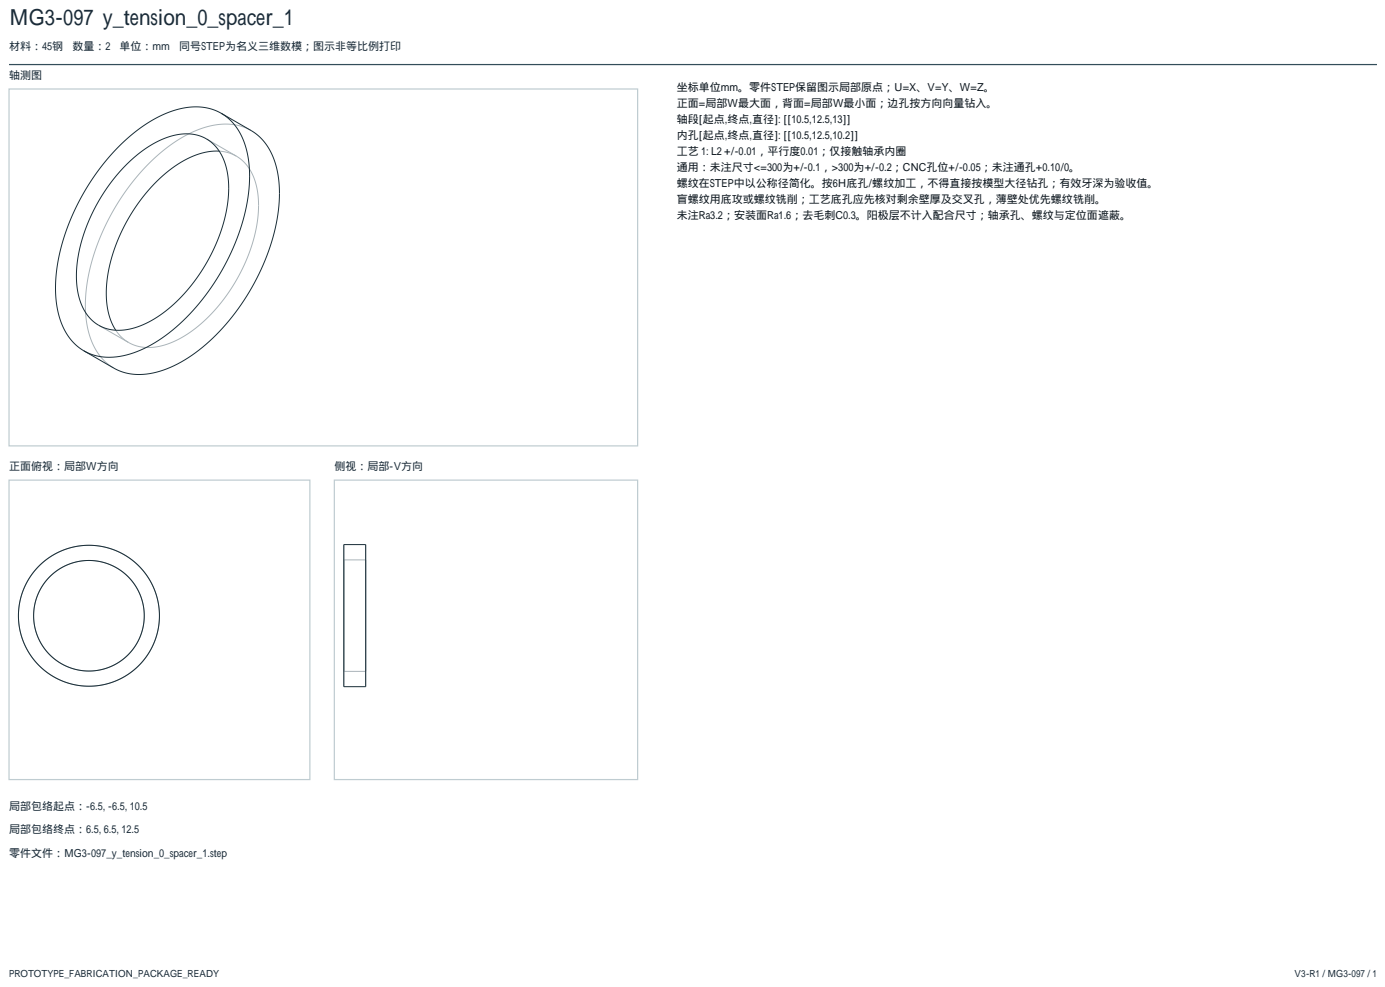
[picture p215: page 98]
轴测图; 正面俯视：局部W方向; 侧视：局部-V方向; 局部包络起点：-6.5, -6.5, 10.5; 局部包络终点：6.5, 6.5, 12.5; 零件文件：MG3-097_y_tension_0_spacer_1.step

材料：45钢 数量：2 单位：mm 同号STEP为名义三维数模；图示非等比例打印

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

# MG3-098 z_block_spacer_0_0

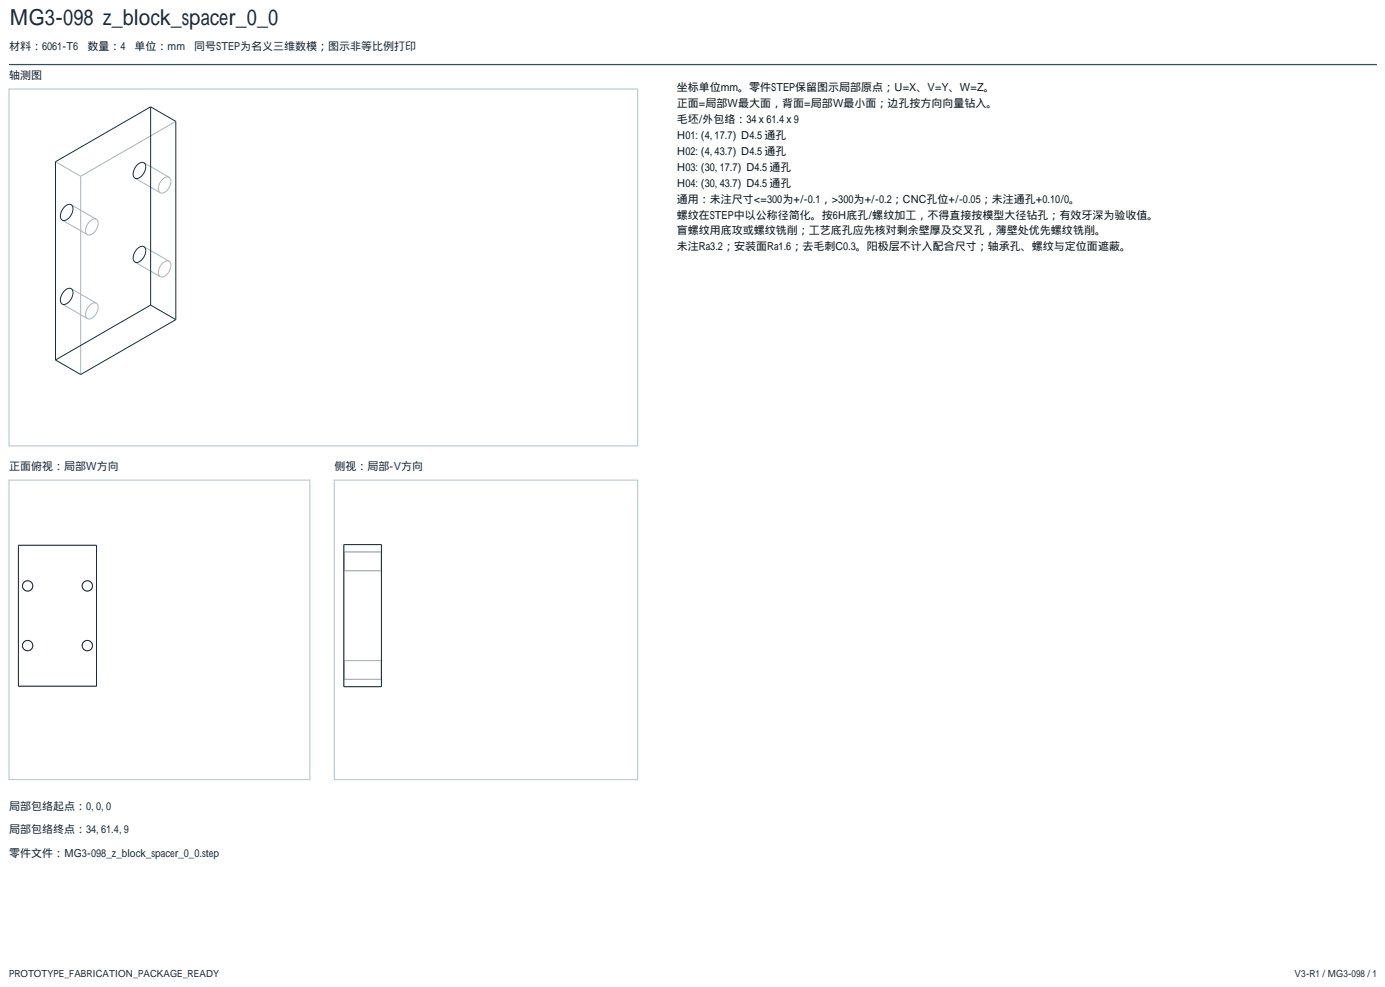
[picture p216: page 99]
轴测图; 正面俯视：局部W方向; 侧视：局部-V方向; 局部包络起点：0, 0, 0; 局部包络终点：34, 61.4, 9; 零件文件：MG3-098_z_block_spacer_0_0.step

材料：6061-T6 数量：4 单位：mm 同号STEP为名义三维数模；图示非等比例打印

坐标单位mm。零件STEP保留图示局部原点；U=X、V=Y、W=Z。
正面=局部W最大面，背面=局部W最小面；边孔按方向向量钻入。
毛坯/外包络：34 x 61.4 x 9
通用：未注尺寸<=300为+/-0.1，>300为+/-0.2；CNC孔位+/-0.05；未注通孔+0.10/0。
螺纹在STEP中以公称径简化。按6H底孔/螺纹加工，不得直接按模型大径钻孔；有效牙深为验收值。
盲螺纹用底攻或螺纹铣削；工艺底孔应先核对剩余壁厚及交叉孔，薄壁处优先螺纹铣削。
未注Ra3.2；安装面Ra1.6；去毛刺C0.3。阳极层不计入配合尺寸；轴承孔、螺纹与定位面遮蔽。

# MG3-099 z_brake_carrier

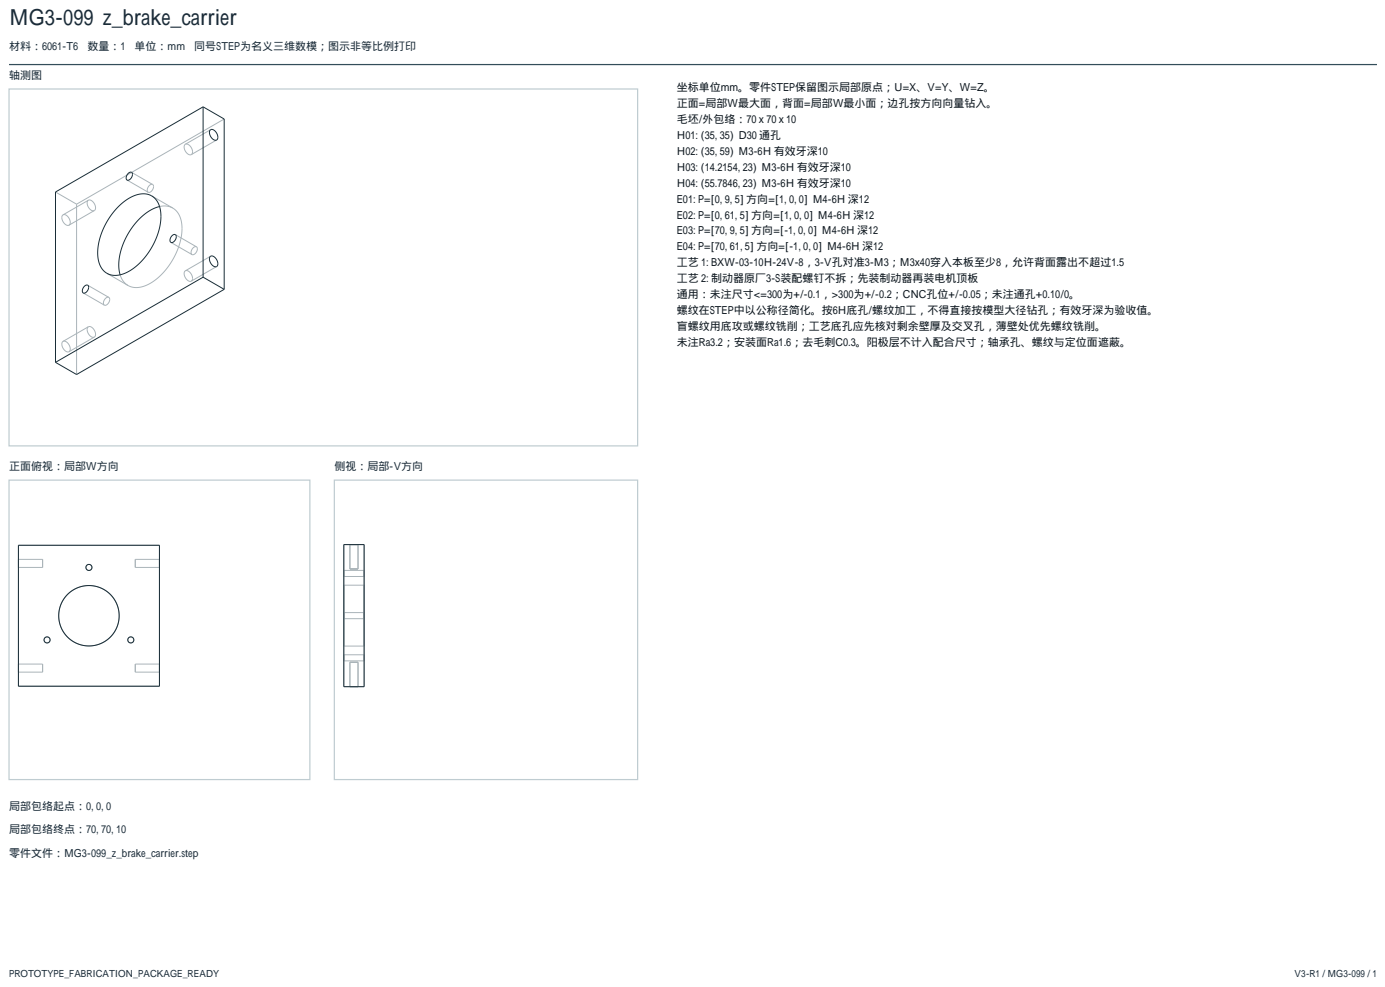
[picture p217: page 100]
轴测图; 正面俯视：局部W方向; 侧视：局部-V方向; 局部包络起点：0, 0, 0; 局部包络终点：70, 70, 10; 零件文件：MG3-099_z_brake_carrier.step

材料：6061-T6 数量：1 单位：mm 同号STEP为名义三维数模；图示非等比例打印

坐标单位mm。零件STEP保留图示局部原点；U=X、V=Y、W=Z。
正面=局部W最大面，背面=局部W最小面；边孔按方向向量钻入。
毛坯/外包络：70 x 70 x 10
H02: (35, 59) M3-6H 有效牙深10
H03: (14.2154, 23) M3-6H 有效牙深10
H04: (55.7846, 23) M3-6H 有效牙深10
工艺 1: BXW-03-10H-24V-8，3-V孔对准3-M3；M3x40穿入本板至少8，允许背面露出不超过1.5
工艺 2: 制动器原厂3-S装配螺钉不拆；先装制动器再装电机顶板
通用：未注尺寸<=300为+/-0.1，>300为+/-0.2；CNC孔位+/-0.05；未注通孔+0.10/0。
螺纹在STEP中以公称径简化。按6H底孔/螺纹加工，不得直接按模型大径钻孔；有效牙深为验收值。
盲螺纹用底攻或螺纹铣削；工艺底孔应先核对剩余壁厚及交叉孔，薄壁处优先螺纹铣削。
未注Ra3.2；安装面Ra1.6；去毛刺C0.3。阳极层不计入配合尺寸；轴承孔、螺纹与定位面遮蔽。

# MG3-100 z_float_cover

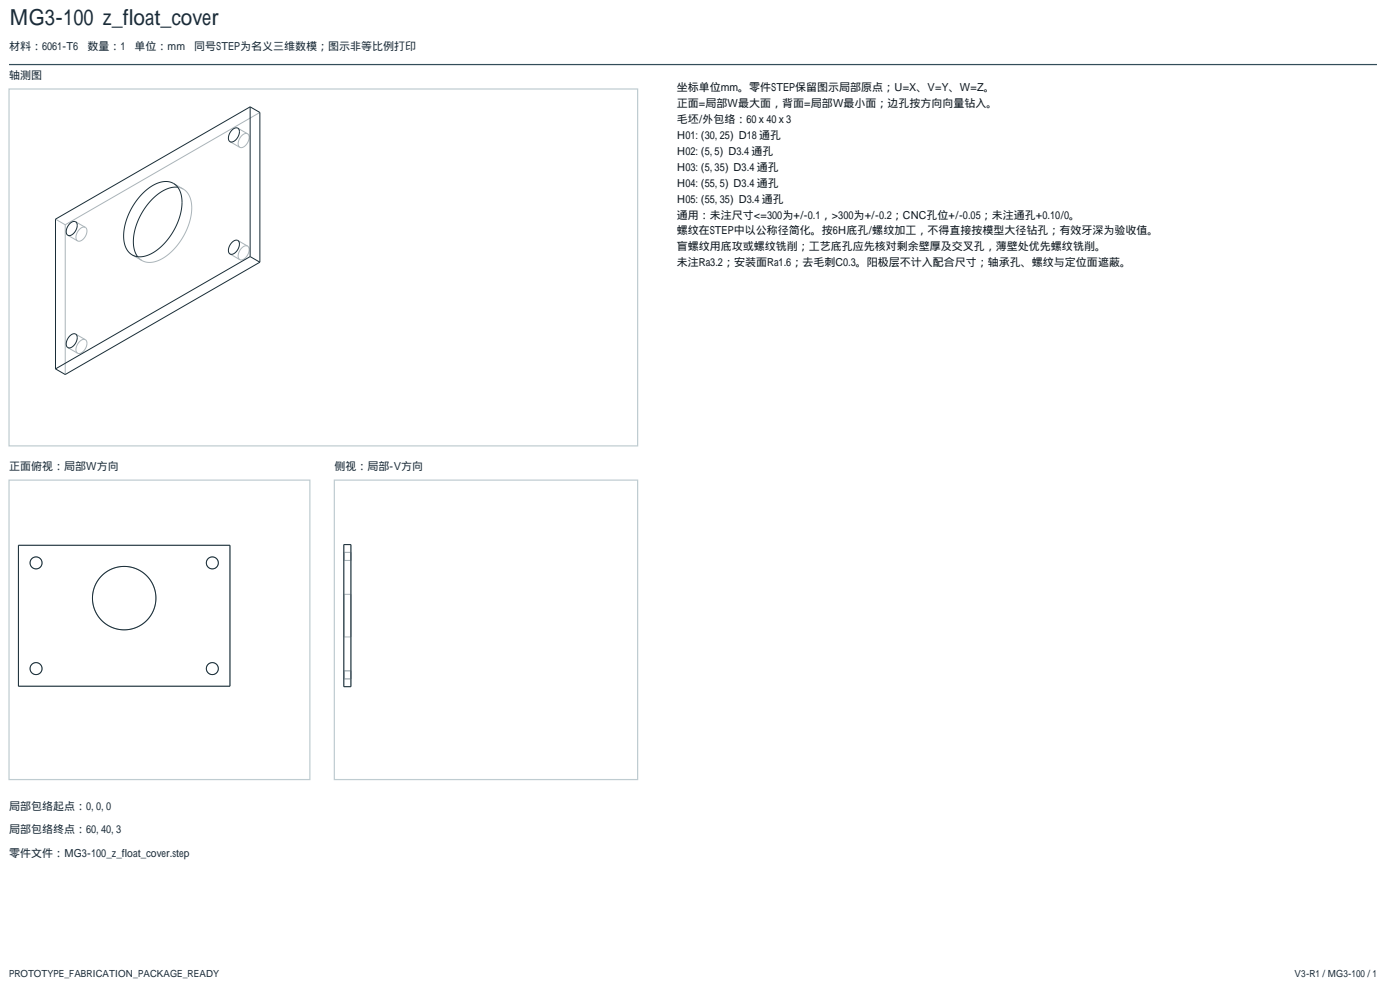
[picture p218: page 101]
轴测图; 正面俯视：局部W方向; 侧视：局部-V方向; 局部包络起点：0, 0, 0; 局部包络终点：60, 40, 3; 零件文件：MG3-100_z_float_cover.step

材料：6061-T6 数量：1 单位：mm 同号STEP为名义三维数模；图示非等比例打印

坐标单位mm。零件STEP保留图示局部原点；U=X、V=Y、W=Z。
正面=局部W最大面，背面=局部W最小面；边孔按方向向量钻入。
毛坯/外包络：60 x 40 x 3
通用：未注尺寸<=300为+/-0.1，>300为+/-0.2；CNC孔位+/-0.05；未注通孔+0.10/0。
螺纹在STEP中以公称径简化。按6H底孔/螺纹加工，不得直接按模型大径钻孔；有效牙深为验收值。
盲螺纹用底攻或螺纹铣削；工艺底孔应先核对剩余壁厚及交叉孔，薄壁处优先螺纹铣削。
未注Ra3.2；安装面Ra1.6；去毛刺C0.3。阳极层不计入配合尺寸；轴承孔、螺纹与定位面遮蔽。

# MG3-101 z_float_housing

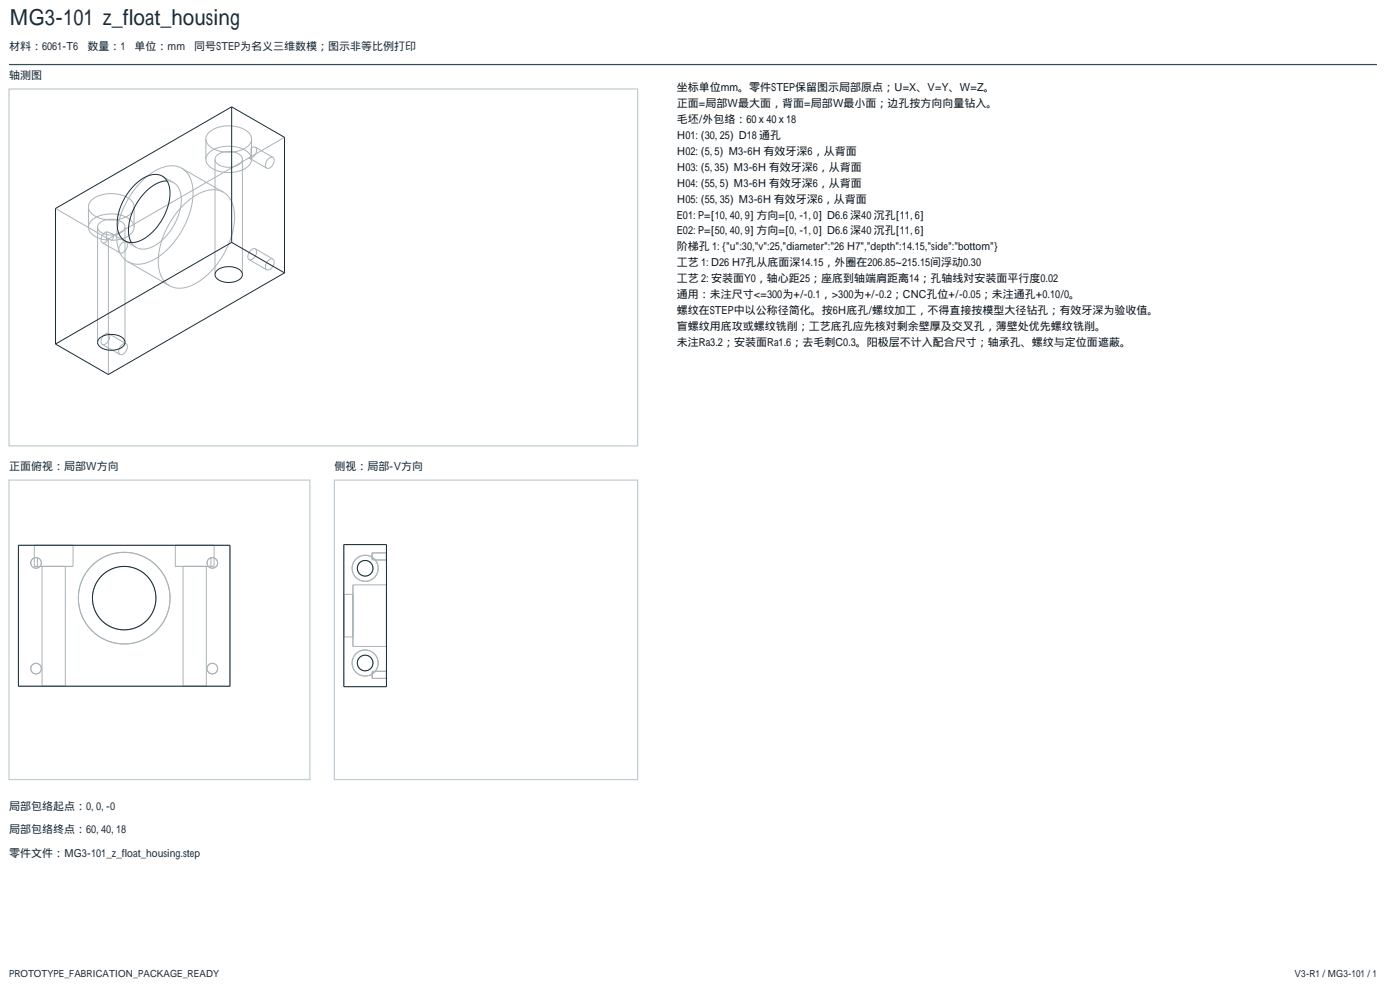
[picture p219: page 102]
轴测图; 正面俯视：局部W方向; 侧视：局部-V方向; 局部包络起点：0, 0, -0; 局部包络终点：60, 40, 18; 零件文件：MG3-101_z_float_housing.step

材料：6061-T6 数量：1 单位：mm 同号STEP为名义三维数模；图示非等比例打印

坐标单位mm。零件STEP保留图示局部原点；U=X、V=Y、W=Z。
正面=局部W最大面，背面=局部W最小面；边孔按方向向量钻入。
毛坯/外包络：60 x 40 x 18
H02: (5, 5) M3-6H 有效牙深6，从背面
H03: (5, 35) M3-6H 有效牙深6，从背面
H04: (55, 5) M3-6H 有效牙深6，从背面
H05: (55, 35) M3-6H 有效牙深6，从背面
阶梯孔 1: {"u":30,"v":25,"diameter":"26 H7","depth":14.15,"side":"bottom"}
工艺 1: D26 H7孔从底面深14.15，外圈在206.85~215.15间浮动0.30
工艺 2: 安装面Y0，轴心距25；座底到轴端肩距离14；孔轴线对安装面平行度0.02
通用：未注尺寸<=300为+/-0.1，>300为+/-0.2；CNC孔位+/-0.05；未注通孔+0.10/0。
螺纹在STEP中以公称径简化。按6H底孔/螺纹加工，不得直接按模型大径钻孔；有效牙深为验收值。
盲螺纹用底攻或螺纹铣削；工艺底孔应先核对剩余壁厚及交叉孔，薄壁处优先螺纹铣削。
未注Ra3.2；安装面Ra1.6；去毛刺C0.3。阳极层不计入配合尺寸；轴承孔、螺纹与定位面遮蔽。

# MG3-102 z_float_outer_spacer

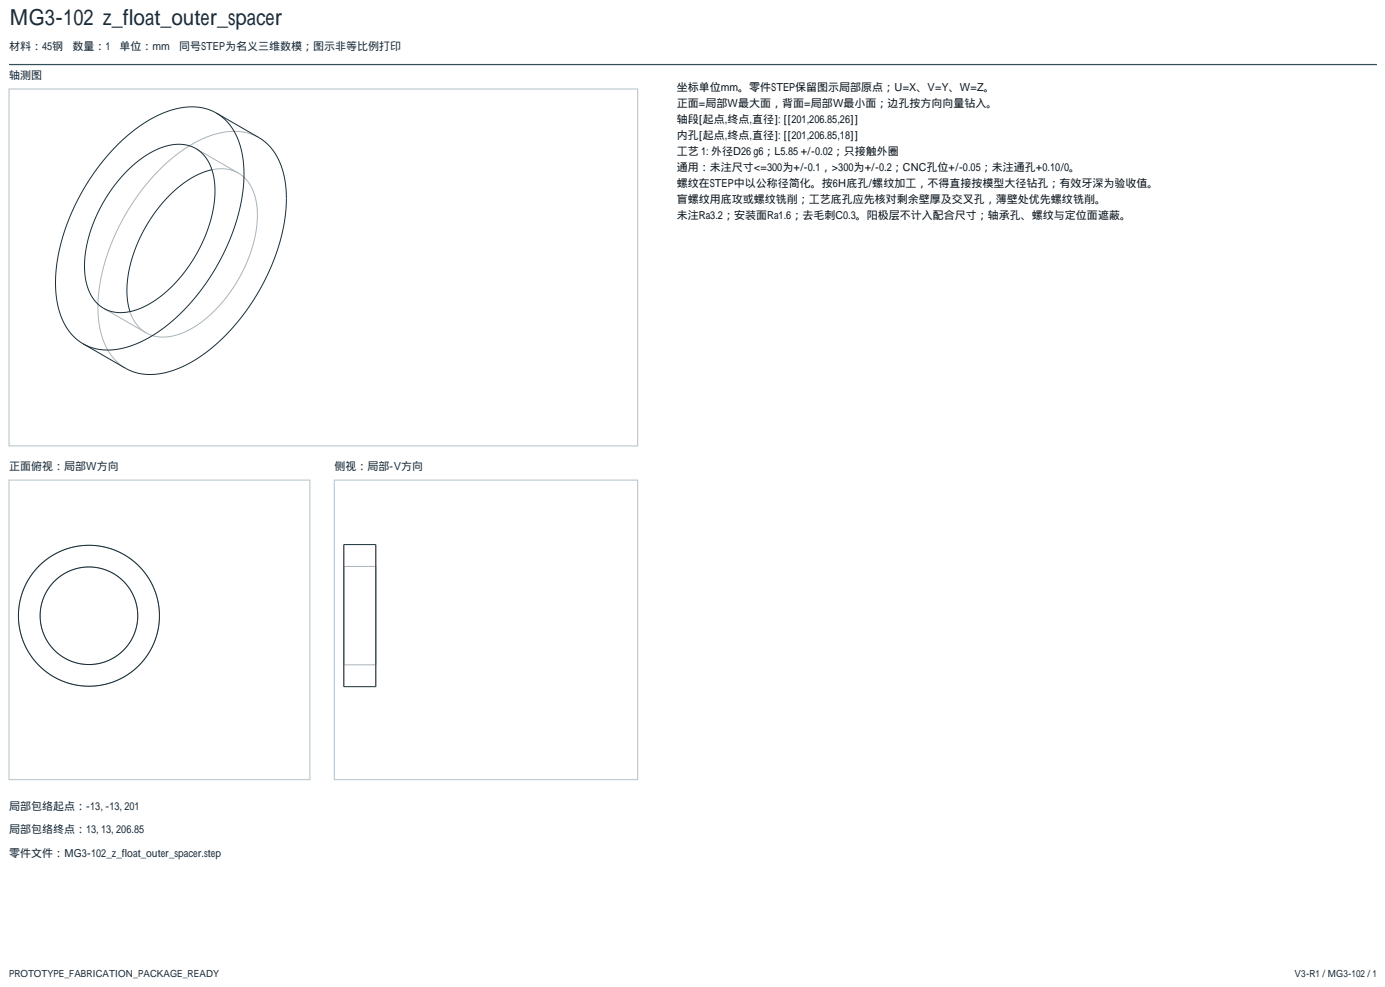
[picture p220: page 103]
轴测图; 正面俯视：局部W方向; 侧视：局部-V方向; 局部包络起点：-13, -13, 201; 局部包络终点：13, 13, 206.85; 零件文件：MG3-102_z_float_outer_spacer.step

材料：45钢 数量：1 单位：mm 同号STEP为名义三维数模；图示非等比例打印

坐标单位mm。零件STEP保留图示局部原点；U=X、V=Y、W=Z。
正面=局部W最大面，背面=局部W最小面；边孔按方向向量钻入。
工艺 1: 外径D26 g6；L5.85 +/-0.02；只接触外圈
通用：未注尺寸<=300为+/-0.1，>300为+/-0.2；CNC孔位+/-0.05；未注通孔+0.10/0。
螺纹在STEP中以公称径简化。按6H底孔/螺纹加工，不得直接按模型大径钻孔；有效牙深为验收值。
盲螺纹用底攻或螺纹铣削；工艺底孔应先核对剩余壁厚及交叉孔，薄壁处优先螺纹铣削。
未注Ra3.2；安装面Ra1.6；去毛刺C0.3。阳极层不计入配合尺寸；轴承孔、螺纹与定位面遮蔽。

# MG3-103 z_motor_lower_saddle

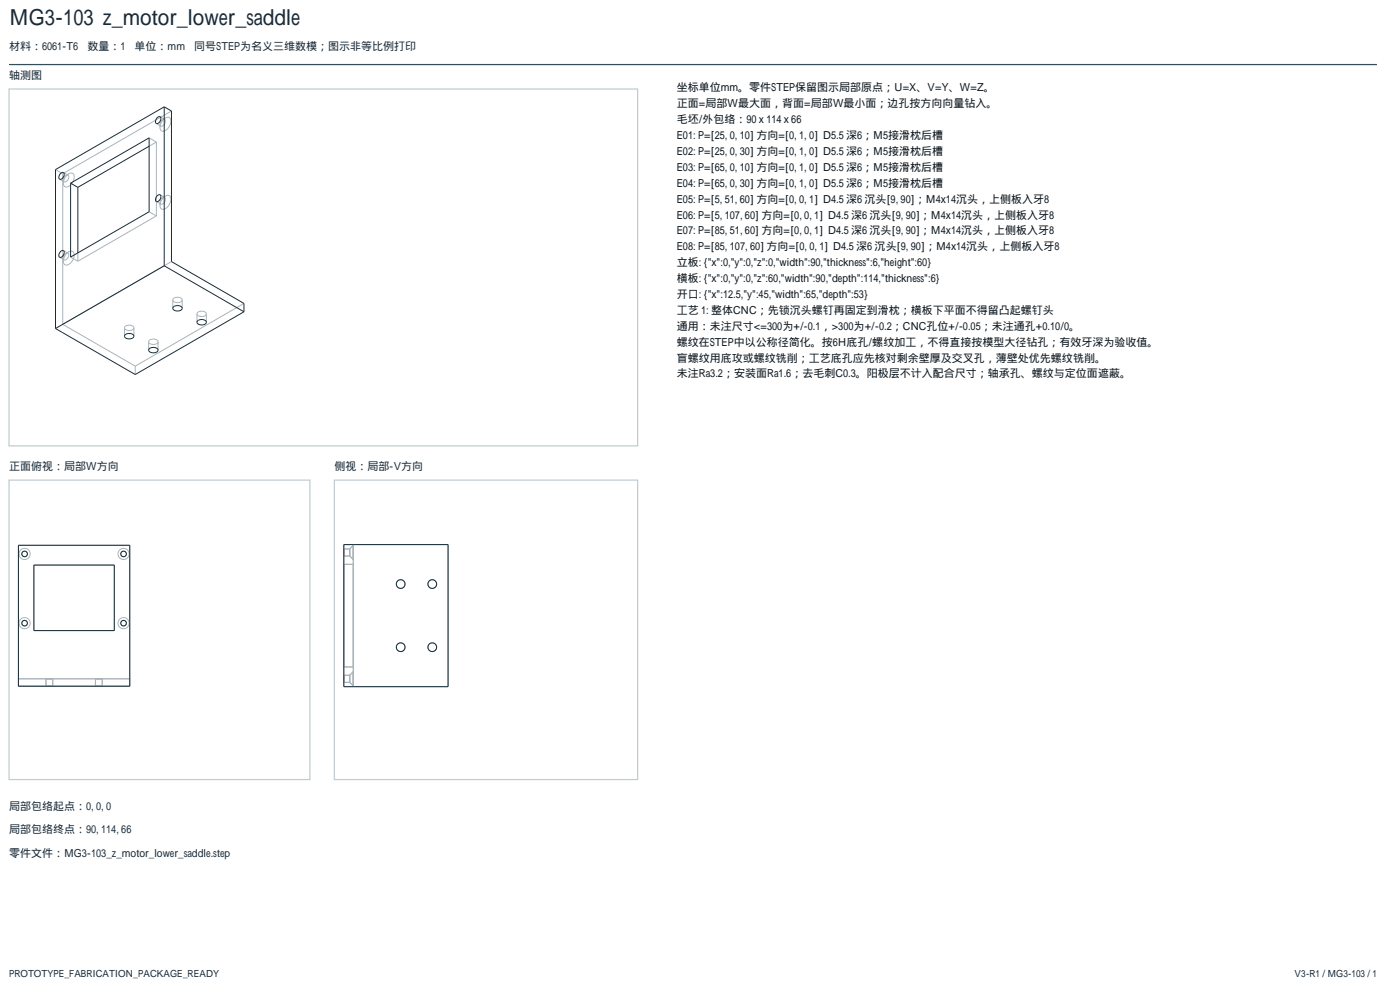
[picture p221: page 104]
轴测图; 正面俯视：局部W方向; 侧视：局部-V方向; 局部包络起点：0, 0, 0; 局部包络终点：90, 114, 66; 零件文件：MG3-103_z_motor_lower_saddle.step

材料：6061-T6 数量：1 单位：mm 同号STEP为名义三维数模；图示非等比例打印

坐标单位mm。零件STEP保留图示局部原点；U=X、V=Y、W=Z。
正面=局部W最大面，背面=局部W最小面；边孔按方向向量钻入。
毛坯/外包络：90 x 114 x 66
E01: P=[25, 0, 10] 方向=[0, 1, 0] D5.5 深6；M5接滑枕后槽
E02: P=[25, 0, 30] 方向=[0, 1, 0] D5.5 深6；M5接滑枕后槽
E03: P=[65, 0, 10] 方向=[0, 1, 0] D5.5 深6；M5接滑枕后槽
E04: P=[65, 0, 30] 方向=[0, 1, 0] D5.5 深6；M5接滑枕后槽
E05: P=[5, 51, 60] 方向=[0, 0, 1] D4.5 深6 沉头[9, 90]；M4x14沉头，上侧板入牙8
E06: P=[5, 107, 60] 方向=[0, 0, 1] D4.5 深6 沉头[9, 90]；M4x14沉头，上侧板入牙8
E07: P=[85, 51, 60] 方向=[0, 0, 1] D4.5 深6 沉头[9, 90]；M4x14沉头，上侧板入牙8
E08: P=[85, 107, 60] 方向=[0, 0, 1] D4.5 深6 沉头[9, 90]；M4x14沉头，上侧板入牙8
立板: {"x":0,"y":0,"z":0,"width":90,"thickness":6,"height":60}
横板: {"x":0,"y":0,"z":60,"width":90,"depth":114,"thickness":6}
开口: {"x":12.5,"y":45,"width":65,"depth":53}
工艺 1: 整体CNC；先锁沉头螺钉再固定到滑枕；横板下平面不得留凸起螺钉头
通用：未注尺寸<=300为+/-0.1，>300为+/-0.2；CNC孔位+/-0.05；未注通孔+0.10/0。
螺纹在STEP中以公称径简化。按6H底孔/螺纹加工，不得直接按模型大径钻孔；有效牙深为验收值。
盲螺纹用底攻或螺纹铣削；工艺底孔应先核对剩余壁厚及交叉孔，薄壁处优先螺纹铣削。
未注Ra3.2；安装面Ra1.6；去毛刺C0.3。阳极层不计入配合尺寸；轴承孔、螺纹与定位面遮蔽。

# MG3-104 z_motor_mount

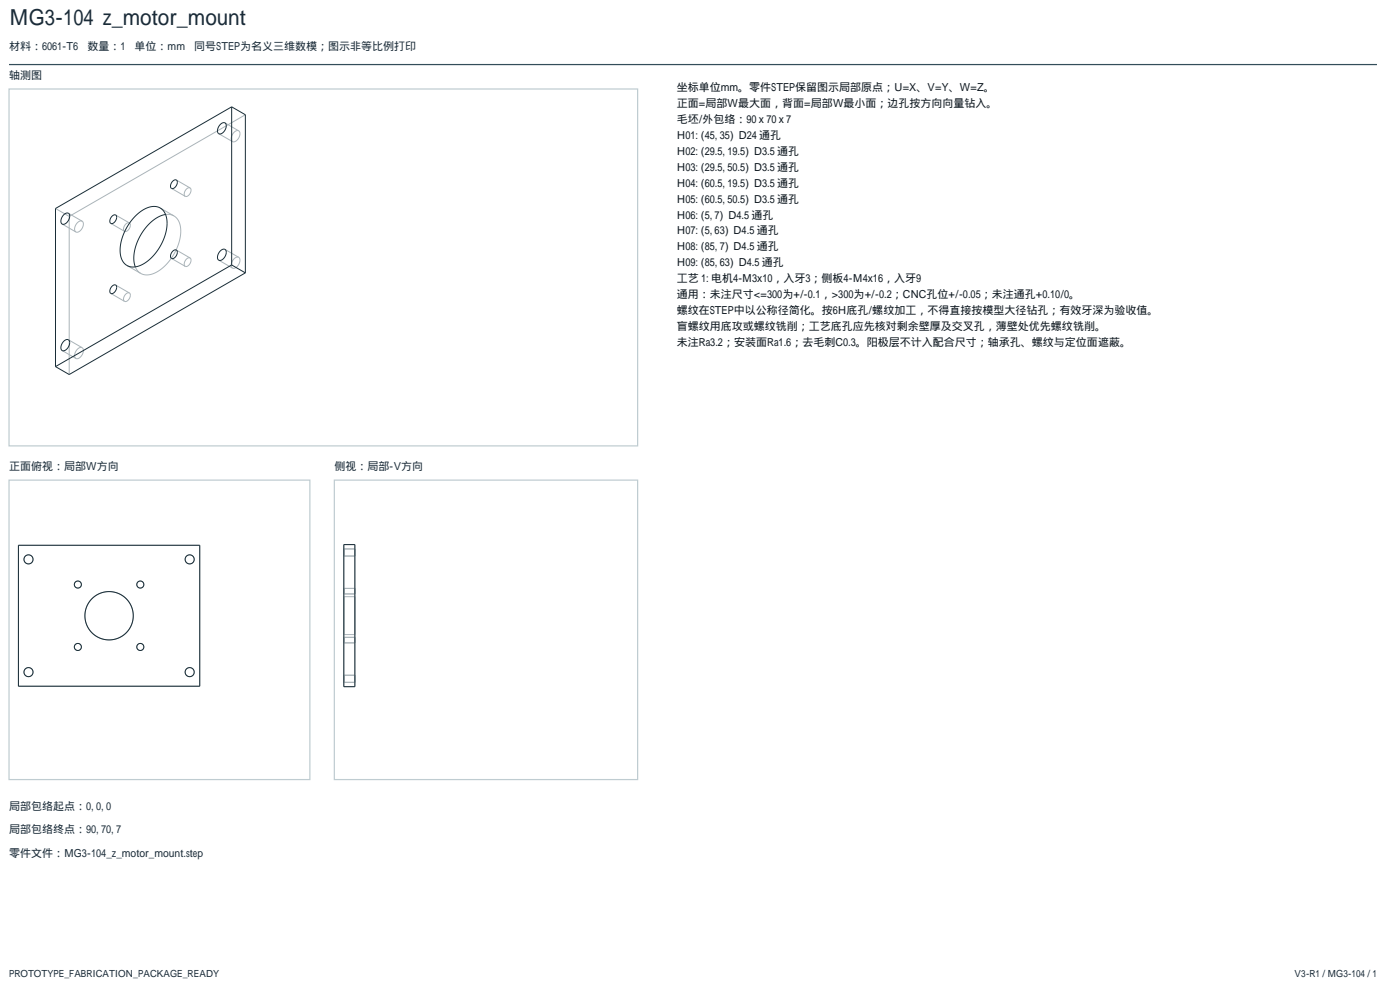
[picture p222: page 105]
轴测图; 正面俯视：局部W方向; 侧视：局部-V方向; 局部包络起点：0, 0, 0; 局部包络终点：90, 70, 7; 零件文件：MG3-104_z_motor_mount.step

材料：6061-T6 数量：1 单位：mm 同号STEP为名义三维数模；图示非等比例打印

坐标单位mm。零件STEP保留图示局部原点；U=X、V=Y、W=Z。
正面=局部W最大面，背面=局部W最小面；边孔按方向向量钻入。
毛坯/外包络：90 x 70 x 7
通用：未注尺寸<=300为+/-0.1，>300为+/-0.2；CNC孔位+/-0.05；未注通孔+0.10/0。
螺纹在STEP中以公称径简化。按6H底孔/螺纹加工，不得直接按模型大径钻孔；有效牙深为验收值。
盲螺纹用底攻或螺纹铣削；工艺底孔应先核对剩余壁厚及交叉孔，薄壁处优先螺纹铣削。
未注Ra3.2；安装面Ra1.6；去毛刺C0.3。阳极层不计入配合尺寸；轴承孔、螺纹与定位面遮蔽。

# MG3-105 z_motor_standoff_0

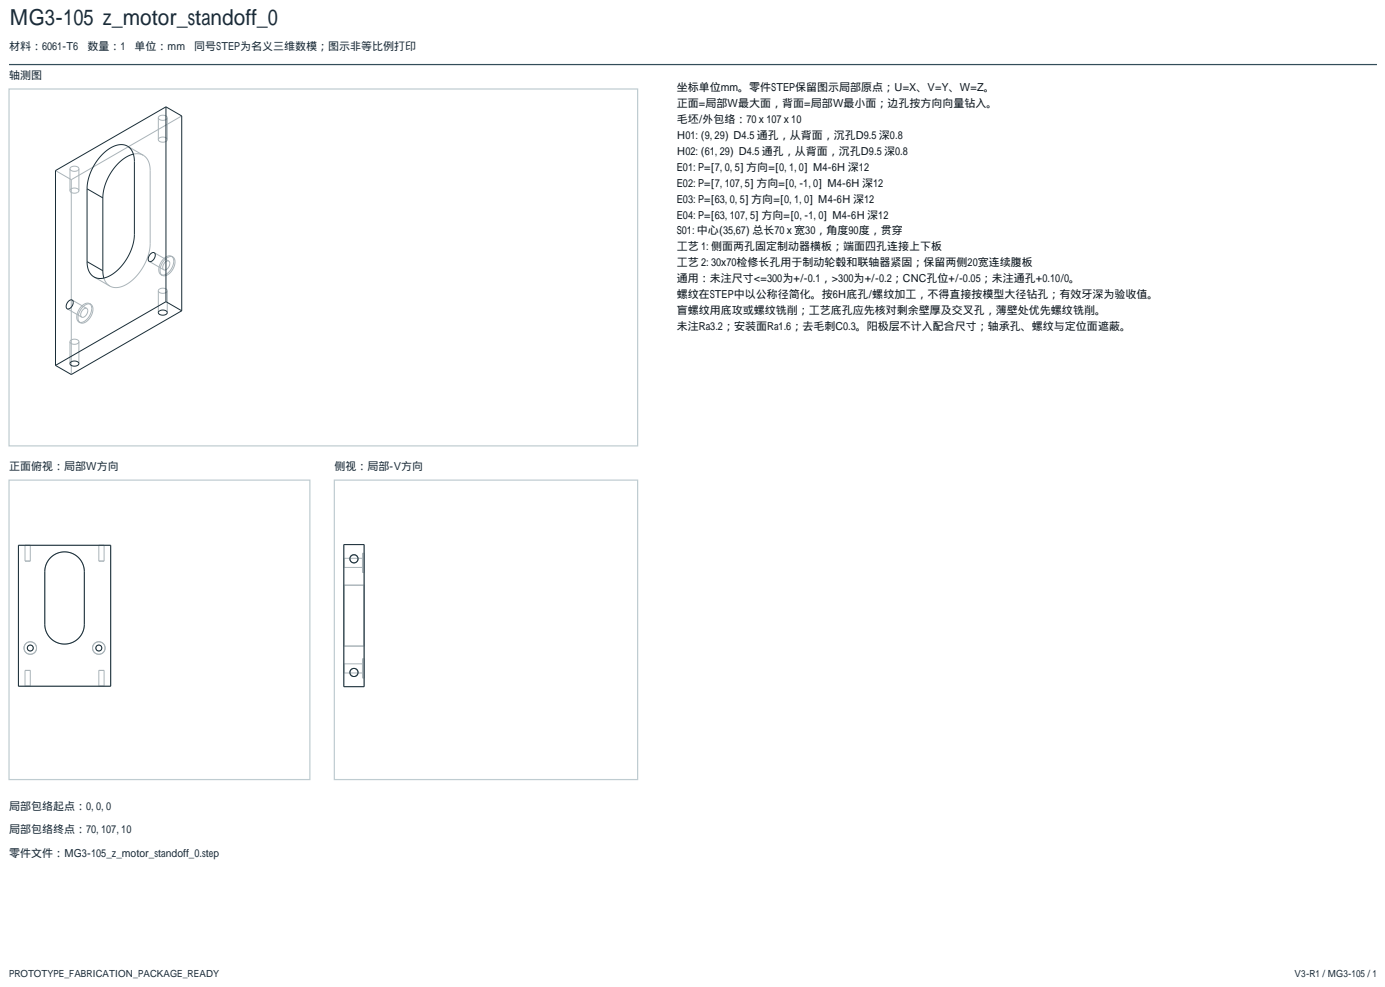
[picture p223: page 106]
轴测图; 正面俯视：局部W方向; 侧视：局部-V方向; 局部包络起点：0, 0, 0; 局部包络终点：70, 107, 10; 零件文件：MG3-105_z_motor_standoff_0.step

材料：6061-T6 数量：1 单位：mm 同号STEP为名义三维数模；图示非等比例打印

坐标单位mm。零件STEP保留图示局部原点；U=X、V=Y、W=Z。
正面=局部W最大面，背面=局部W最小面；边孔按方向向量钻入。
毛坯/外包络：70 x 107 x 10
H01: (9, 29) D4.5 通孔，从背面，沉孔D9.5 深0.8
H02: (61, 29) D4.5 通孔，从背面，沉孔D9.5 深0.8
工艺 1: 侧面两孔固定制动器横板；端面四孔连接上下板
工艺 2: 30x70检修长孔用于制动轮毂和联轴器紧固；保留两侧20宽连续腹板
通用：未注尺寸<=300为+/-0.1，>300为+/-0.2；CNC孔位+/-0.05；未注通孔+0.10/0。
螺纹在STEP中以公称径简化。按6H底孔/螺纹加工，不得直接按模型大径钻孔；有效牙深为验收值。
盲螺纹用底攻或螺纹铣削；工艺底孔应先核对剩余壁厚及交叉孔，薄壁处优先螺纹铣削。
未注Ra3.2；安装面Ra1.6；去毛刺C0.3。阳极层不计入配合尺寸；轴承孔、螺纹与定位面遮蔽。

# MG3-106 z_motor_standoff_1

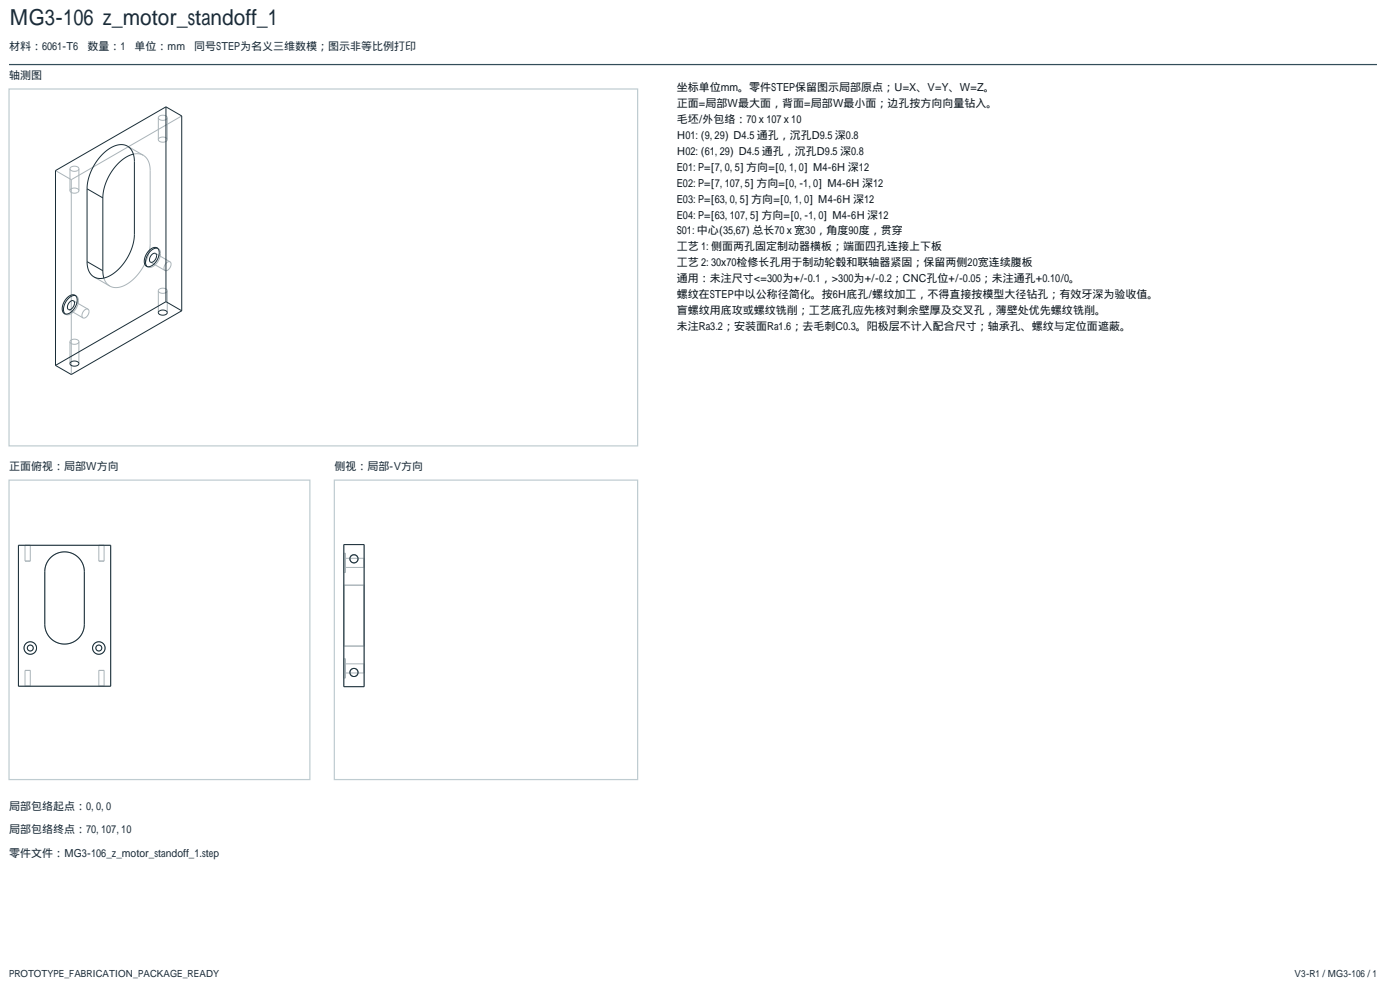
[picture p224: page 107]
轴测图; 正面俯视：局部W方向; 侧视：局部-V方向; 局部包络起点：0, 0, 0; 局部包络终点：70, 107, 10; 零件文件：MG3-106_z_motor_standoff_1.step

材料：6061-T6 数量：1 单位：mm 同号STEP为名义三维数模；图示非等比例打印

坐标单位mm。零件STEP保留图示局部原点；U=X、V=Y、W=Z。
正面=局部W最大面，背面=局部W最小面；边孔按方向向量钻入。
毛坯/外包络：70 x 107 x 10
H01: (9, 29) D4.5 通孔，沉孔D9.5 深0.8
H02: (61, 29) D4.5 通孔，沉孔D9.5 深0.8
工艺 1: 侧面两孔固定制动器横板；端面四孔连接上下板
工艺 2: 30x70检修长孔用于制动轮毂和联轴器紧固；保留两侧20宽连续腹板
通用：未注尺寸<=300为+/-0.1，>300为+/-0.2；CNC孔位+/-0.05；未注通孔+0.10/0。
螺纹在STEP中以公称径简化。按6H底孔/螺纹加工，不得直接按模型大径钻孔；有效牙深为验收值。
盲螺纹用底攻或螺纹铣削；工艺底孔应先核对剩余壁厚及交叉孔，薄壁处优先螺纹铣削。
未注Ra3.2；安装面Ra1.6；去毛刺C0.3。阳极层不计入配合尺寸；轴承孔、螺纹与定位面遮蔽。

# MG3-107 z_nut_cradle

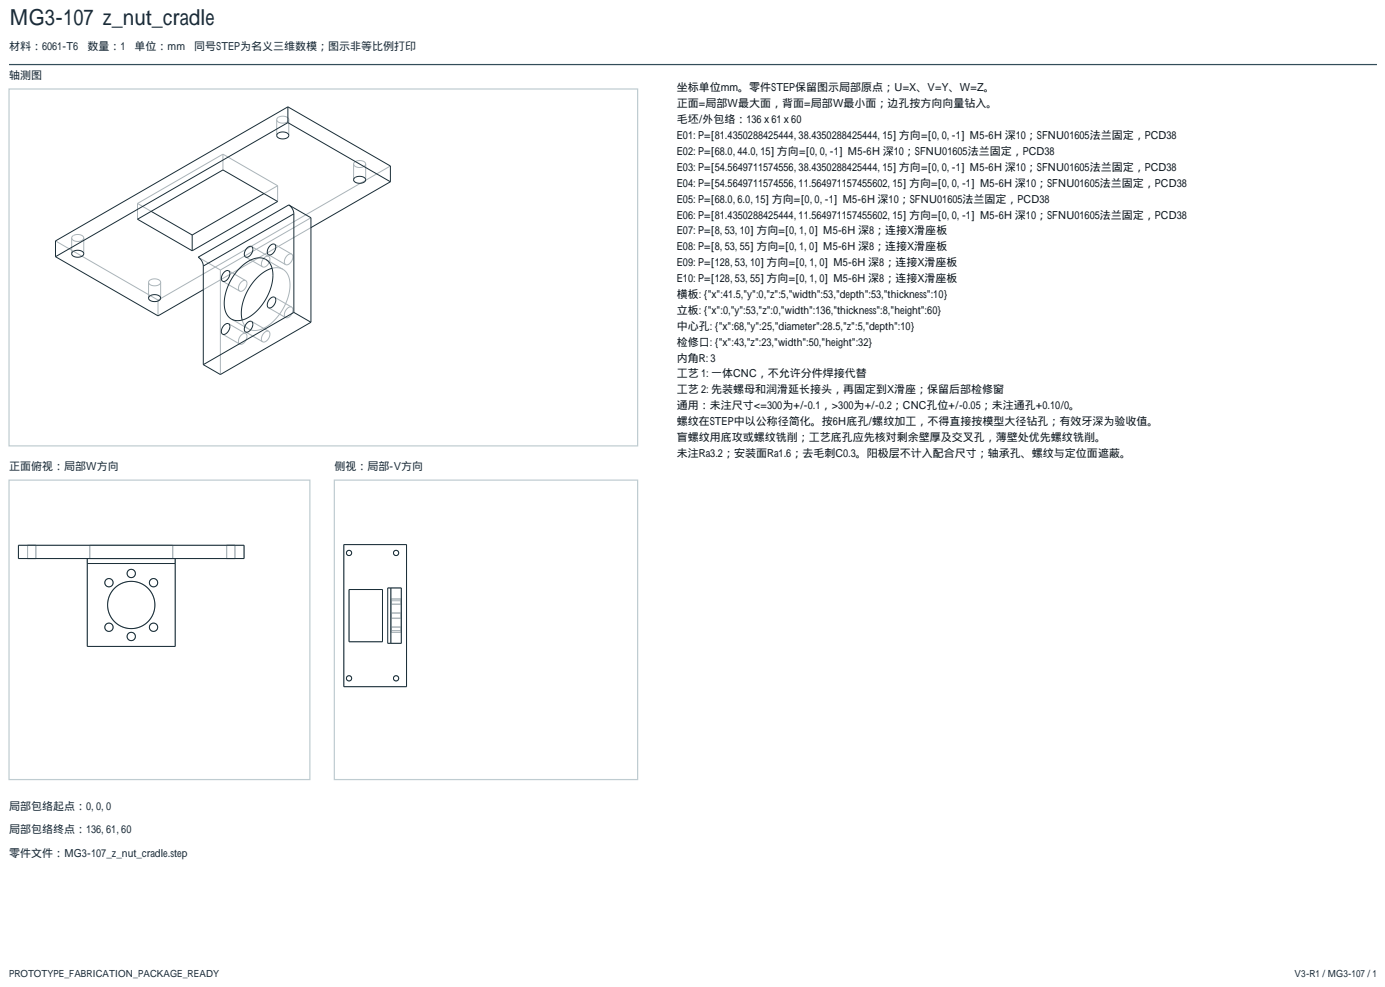
[picture p225: page 108]
轴测图; 正面俯视：局部W方向; 侧视：局部-V方向; 局部包络起点：0, 0, 0; 局部包络终点：136, 61, 60; 零件文件：MG3-107_z_nut_cradle.step

材料：6061-T6 数量：1 单位：mm 同号STEP为名义三维数模；图示非等比例打印

坐标单位mm。零件STEP保留图示局部原点；U=X、V=Y、W=Z。
正面=局部W最大面，背面=局部W最小面；边孔按方向向量钻入。
毛坯/外包络：136 x 61 x 60
E01: P=[81.4350288425444, 38.4350288425444, 15] 方向=[0, 0, -1] M5-6H 深10；SFNU01605法兰固定，PCD38
E02: P=[68.0, 44.0, 15] 方向=[0, 0, -1] M5-6H 深10；SFNU01605法兰固定，PCD38
E03: P=[54.5649711574556, 38.4350288425444, 15] 方向=[0, 0, -1] M5-6H 深10；SFNU01605法兰固定，PCD38
E04: P=[54.5649711574556, 11.564971157455602, 15] 方向=[0, 0, -1] M5-6H 深10；SFNU01605法兰固定，PCD38
E05: P=[68.0, 6.0, 15] 方向=[0, 0, -1] M5-6H 深10；SFNU01605法兰固定，PCD38
E06: P=[81.4350288425444, 11.564971157455602, 15] 方向=[0, 0, -1] M5-6H 深10；SFNU01605法兰固定，PCD38
E07: P=[8, 53, 10] 方向=[0, 1, 0] M5-6H 深8；连接X滑座板
E08: P=[8, 53, 55] 方向=[0, 1, 0] M5-6H 深8；连接X滑座板
E09: P=[128, 53, 10] 方向=[0, 1, 0] M5-6H 深8；连接X滑座板
E10: P=[128, 53, 55] 方向=[0, 1, 0] M5-6H 深8；连接X滑座板
横板: {"x":41.5,"y":0,"z":5,"width":53,"depth":53,"thickness":10}
立板: {"x":0,"y":53,"z":0,"width":136,"thickness":8,"height":60}
中心孔: {"x":68,"y":25,"diameter":28.5,"z":5,"depth":10}
检修口: {"x":43,"z":23,"width":50,"height":32}
内角R: 3
工艺 1: 一体CNC，不允许分件焊接代替
工艺 2: 先装螺母和润滑延长接头，再固定到X滑座；保留后部检修窗
通用：未注尺寸<=300为+/-0.1，>300为+/-0.2；CNC孔位+/-0.05；未注通孔+0.10/0。
螺纹在STEP中以公称径简化。按6H底孔/螺纹加工，不得直接按模型大径钻孔；有效牙深为验收值。
盲螺纹用底攻或螺纹铣削；工艺底孔应先核对剩余壁厚及交叉孔，薄壁处优先螺纹铣削。
未注Ra3.2；安装面Ra1.6；去毛刺C0.3。阳极层不计入配合尺寸；轴承孔、螺纹与定位面遮蔽。

# MG3-108 z_rail_backplate

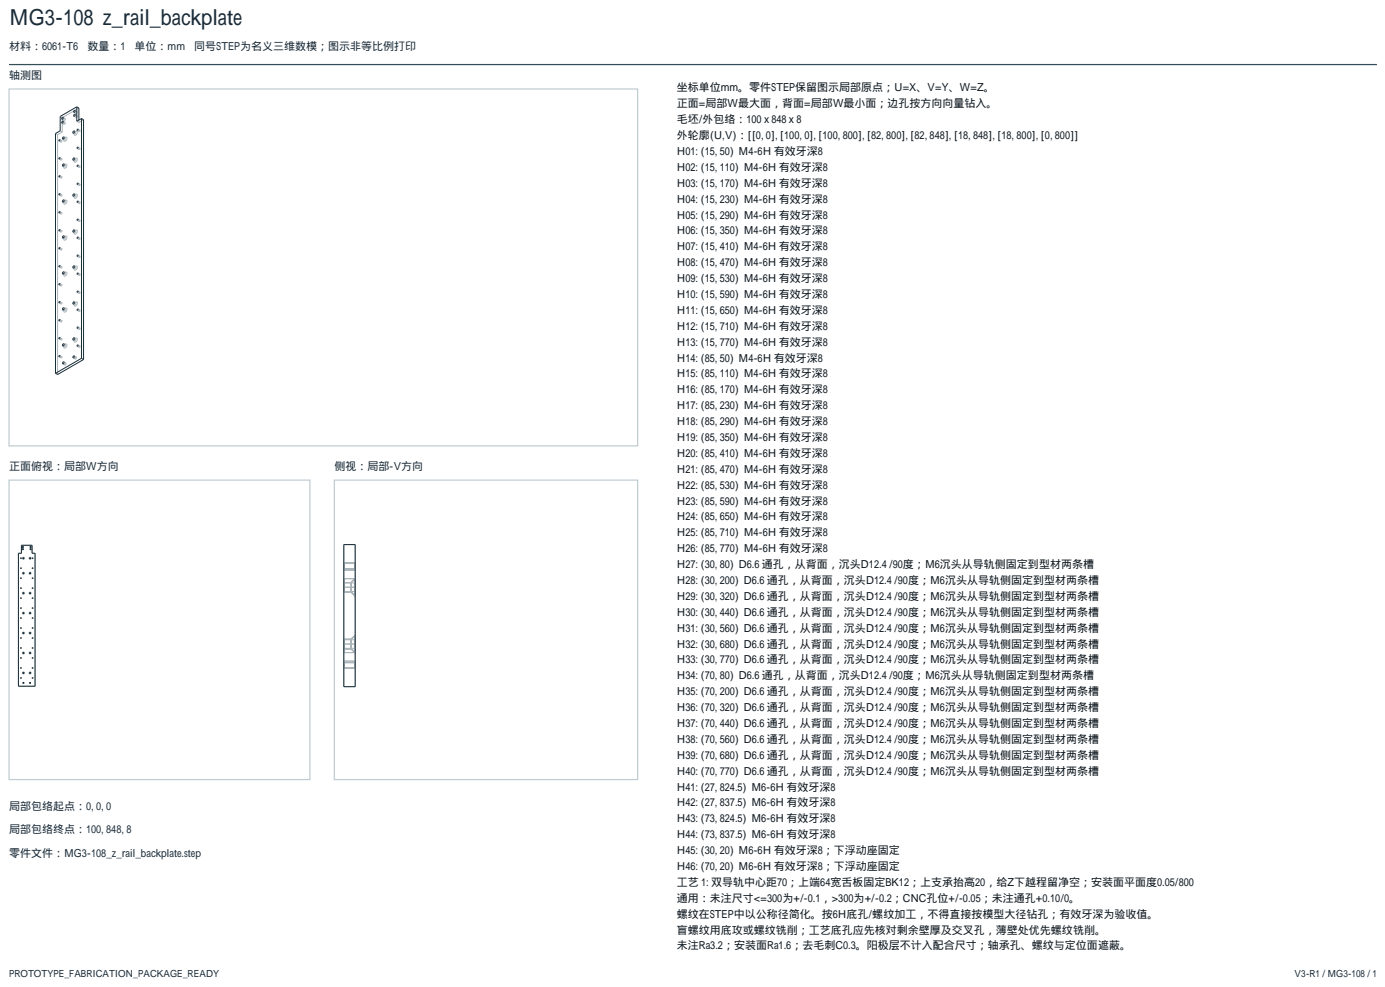
[picture p226: page 109]
轴测图; 正面俯视：局部W方向; 侧视：局部-V方向; 局部包络起点：0, 0, 0; 局部包络终点：100, 848, 8; 零件文件：MG3-108_z_rail_backplate.step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

材料：6061-T6 数量：1 单位：mm 同号STEP为名义三维数模；图示非等比例打印

# MG3-109 z_screw_1605

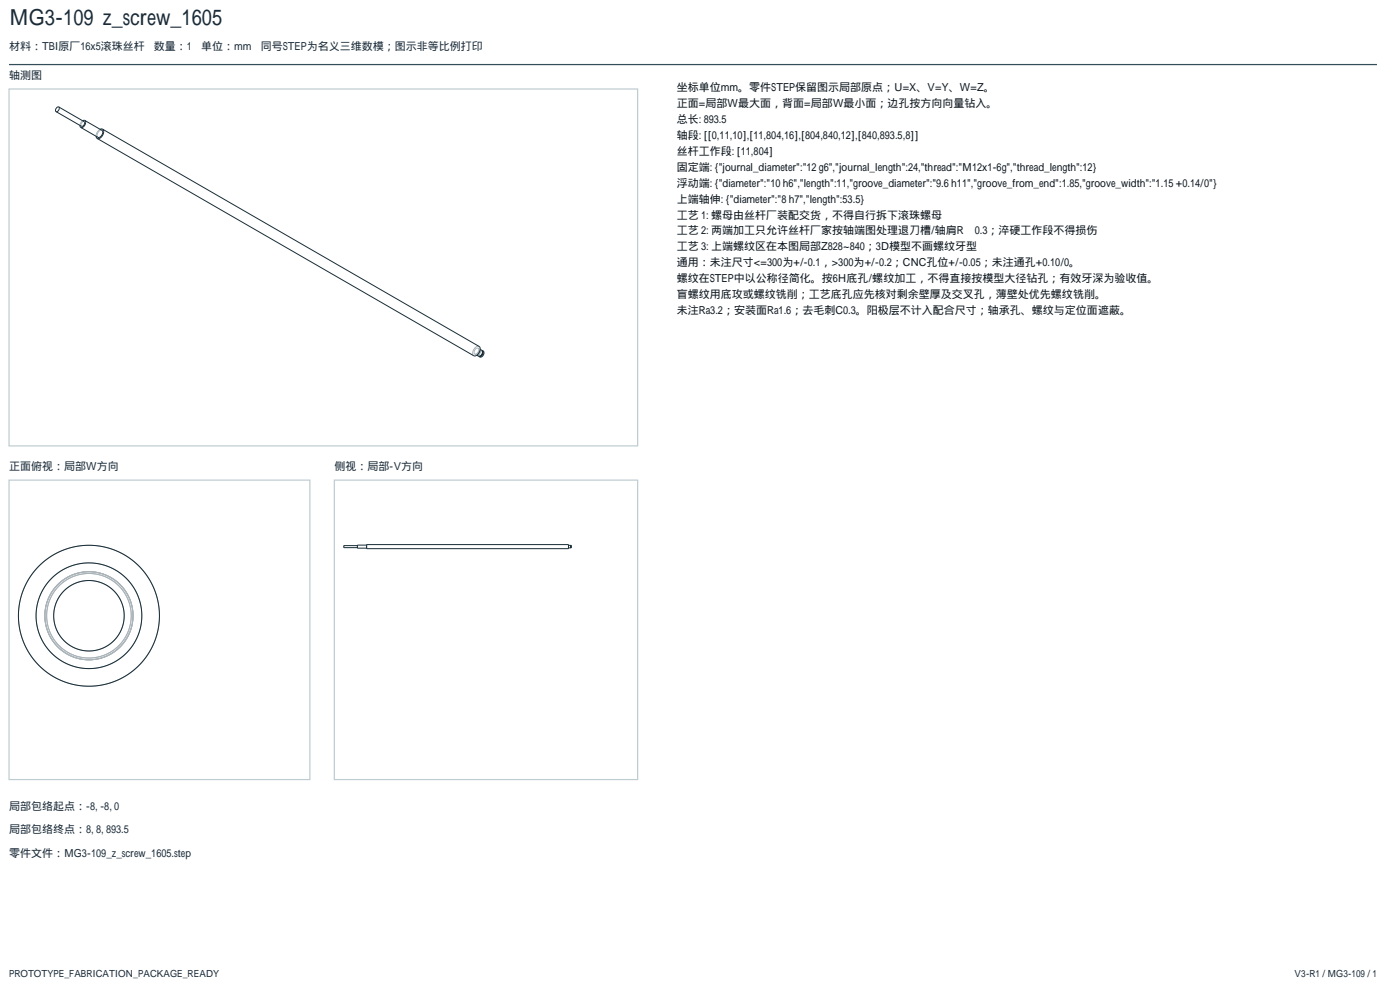
[picture p227: page 110]
轴测图; 正面俯视：局部W方向; 侧视：局部-V方向; 局部包络起点：-8, -8, 0; 局部包络终点：8, 8, 893.5; 零件文件：MG3-109_z_screw_1605.step

材料：TBI原厂16x5滚珠丝杆 数量：1 单位：mm 同号STEP为名义三维数模；图示非等比例打印

坐标单位mm。零件STEP保留图示局部原点；U=X、V=Y、W=Z。
正面=局部W最大面，背面=局部W最小面；边孔按方向向量钻入。
丝杆工作段: [11,804]
固定端: {"journal_diameter":"12 g6","journal_length":24,"thread":"M12x1-6g","thread_length":12}
浮动端: {"diameter":"10 h6","length":11,"groove_diameter":"9.6 h11","groove_from_end":1.85,"groove_width":"1.15 +0.14/0"}
上端轴伸: {"diameter":"8 h7","length":53.5}
工艺 1: 螺母由丝杆厂装配交货，不得自行拆下滚珠螺母
工艺 2: 两端加工只允许丝杆厂家按轴端图处理退刀槽/轴肩R≤0.3；淬硬工作段不得损伤
工艺 3: 上端螺纹区在本图局部Z828~840；3D模型不画螺纹牙型
通用：未注尺寸<=300为+/-0.1，>300为+/-0.2；CNC孔位+/-0.05；未注通孔+0.10/0。
螺纹在STEP中以公称径简化。按6H底孔/螺纹加工，不得直接按模型大径钻孔；有效牙深为验收值。
盲螺纹用底攻或螺纹铣削；工艺底孔应先核对剩余壁厚及交叉孔，薄壁处优先螺纹铣削。
未注Ra3.2；安装面Ra1.6；去毛刺C0.3。阳极层不计入配合尺寸；轴承孔、螺纹与定位面遮蔽。
