Not1Fun/mini-gantry/mechanical/v3/drawings/assembly.png

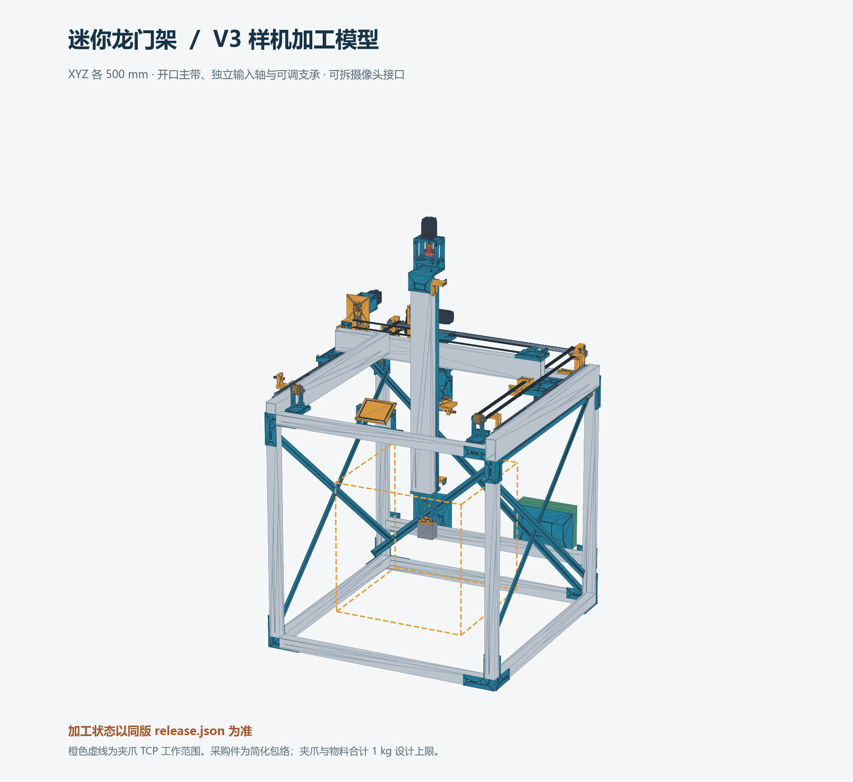
mechanical/v3/drawings/assembly.png
