Not1Fun/mini-gantry/(commit log)

2026-10-14 设计：新增500mm三轴龙门架与DM-G6220旋转腕结构V1
    [bridge_riser_0.step, bridge_riser_1.step, controller_tray.step, gripper_adapter.dxf, gripper_adapter.step, mini_gantry_v1.step, mini_gantry_v1.stl, wrist_bearing_housing.step]
2026-10-14 维护：固定CAD文件字节与源码换行格式
    [gripper_adapter.dxf, z_motor_mount.dxf]
2026-10-15 设计：V2移除旋转腕并加入计算板孔位和可拆相机面板及SolidWorks总装
    [bridge_riser_0.step, bridge_riser_1.step, camera_base.dxf, camera_base.step, camera_pivot_ear_0.step, camera_pivot_ear_1.step, camera_removable_panel.SLDPRT, camera_removable_panel.dxf]
2026-10-15 校核：移除已被转轴座实体替代的旧相机载架平面文件
    [camera_tilt_carrier.dxf, camera_tilt_carrier_flat.step]
2026-10-15 Add explicit motor mounts and printable camera adapter interface
    [camera_adapter_blank.stl, mini_gantry_v2.step, mini_gantry_v2.stl, mini_gantry_v2_1.SLDASM, motor_mounts.json, v21_camera_removable_panel.SLDPRT, v21_compute_combo_plate.SLDPRT, v21_gripper_adapter.SLDPRT]
2026-10-15 Refine Z-axis shaft and coupling interfaces with verified clearances
    [mini_gantry_v2.step, mini_gantry_v2.stl, mini_gantry_v2_2.SLDASM, motor_mounts.json, v22_camera_removable_panel.SLDPRT, v22_compute_combo_plate.SLDPRT, v22_gripper_adapter.SLDPRT, v22_module_XY.SLDPRT]
2026-10-16 Detail XY belt reductions, adjustable motor mounts and output supports
    [mini_gantry_v2.step, mini_gantry_v2.stl, mini_gantry_v2_3.SLDASM, motor_mounts.json, v23_camera_removable_panel.SLDPRT, v23_compute_combo_plate.SLDPRT, v23_gripper_adapter.SLDPRT, v23_module_XY.SLDPRT]
2026-10-16 Add V3-R1 prototype fabrication package and verified CAD
    [MG3-001.dxf, MG3-001_X_bumper_0.step, MG3-002_X_stop_0.step, MG3-003.dxf, MG3-003_X_target_0.step, MG3-004.dxf, MG3-004_Y_bumper_0_0.step, MG3-005.dxf]
